hbenuid/robotic-arm/cad/docs/cycloidal_drive.md

# Cycloidal drive — 21:1 shoulder-pitch actuator, its shell turning

**Purpose:** the specification of the drive (ported from the `cycloidal_drive` repo), the turning shell it builds now
(§5.5), and how it is attached to the arm (§10).

## Provenance
- Designed in CadQuery in [`hbenuid/cycloidal_drive`](https://github.com/hbenuid/cycloidal_drive) and ported to
  build123d at `2f1f67d` (`lib/reference.py CYCLOIDAL_REV`; `git log` keeps the port's commits).
- **Reference geometry** = the CadQuery builders' own STEP exports at that revision, in `reference/cycloidal/<name>.step`
  (manifest kind `designed` for the printed parts, `cots` for the purchased ones - `lib/reference.py DESIGNED` /
  `CYCLOIDAL_COTS` -, `origin: cycloidal_drive@2f1f67d`; regenerating them: `reference/AGENTS.md`).
  `tests/cycloidal/test_port.py` proves the port reproduces them in `LEGACY_CONFIG`: identical face sets; identical
  tessellations and the exact analytic volume for every part but the two spline discs, which match the reference's
  lobe spline instead (`spline_deviation`). A part `DEFAULT_CONFIG` has moved away from its export (the bolt count,
  §5.2; the gear size and the pillar tips, §5.4; the turning shell, §5.5) declares `REFERENCE_BUILD`, its
  `LEGACY_CONFIG` build, and the test compares that.

## Overview

| Parameter | Value |
|---|---|
| Application | The arm's `shoulder_pitch` joint (~355 mm reach to the wrist centre, stretched out: `robot/frames.py` joint origins) — the `j1_coupler` fork holds its hub and motor, `j1_link` rises off its turning shell, printed with the shell's body (§10) |
| Type | Two-disc cycloidal drive, discs 180° apart; the carrier held, the housing shell the output (§5.5) |
| Gear ratio | 21:1 (21 ring pins, 20 lobes; the shell turns the same way as the motor) — `lib/params.py CYCLOIDAL_RATIO` (`DriveConfig.ratio`; the port's 20:1 held the ring) |
| Motor | NEMA 17, 48 mm body, 22 mm × Ø5 D-shaft (`parts/cycloidal/nema17_48mm.py`; the shown geometry is `vendor/nema17_48mm.step`, the real body from the user's kit export, its own boss + shaft cut off for this motor's pilot + shaft, `lib/cycloidal/motor.py`) + its MKS SERVO42D board kit on the rear face (`parts/joints/mks_servo42d.py`, `z_mks_board` = −48) |
| Eccentricity | 1.5 mm |
| Housing OD | 129.2 mm at the pillars, 108 between them (`CYCLOIDAL_HOUSING_OD`; the port's 140 / 116, §5.4) |
| Print material | PETG, 100 % infill on the discs |

The drive's own dimensions live in **`lib/cycloidal/params.py`** (`DriveConfig`, its frozen groups:
`gear, disc, shaft, bearings, housing, motor, output_hub, tolerances, profile, stack_up`, and `shell` - the turning
shell's `ShellParams`, `None` in the port's `LEGACY_CONFIG`); every number below names its field.

## 1. Drive geometry

### 1.1 Ring gear (`cfg.gear`)

| Parameter | Value | Notes |
|---|---|---|
| Ring pins | 21 (`num_ring_pins`) | N + 1, N = 20 lobes |
| Ring pin Ø | 4.00 (`ring_pin_dia`) | h6 ground steel dowel |
| Ring pin circle Ø | 100.00 (`ring_pin_circle_dia`) | centred in the housing bore; the port's 108 less 2 × `RING_INSET` (§5.4) |
| Ring pin length | 40 (`ring_pin_length`) | 5 in the shell ring's pin ring + 30 between the two plates + 5 in the body's pin ring (`ring_pin_engagement`; the port's 35: 3.5 in its motor plate + 28 + 3.5 in the bearing-zone wall) |
| Housing bore Ø | 108.00 (`housing.bore_dia`) | 2 behind the pins, 3 past the discs' swing; between the pillars it is the housing's outline (1.9 outside the pin holes) |

### 1.2 Cycloidal disc (`cfg.disc`, `parts/cycloidal/cycloidal_disc_1.py`, `_2.py`)

| Parameter | Value | Notes |
|---|---|---|
| Lobes | 20 (`gear.num_lobes`) | sets the ratio |
| Disc count | 2 | orbit centres 180° apart cancel vibration. Disc 2's epitrochoid is phase-rotated by `gear.disc2_phase_deg = -180°/N_lobes = -9°`; the output-pin holes are identical (disc-local 0/90/180/270 on the 60 mm circle). **The discs are distinct printed parts** — a 180° assembly rotation is a no-op on a 20-lobe disc. |
| OD | ~99 (98.0 / 99.0 bbox) | epitrochoid profile (§8): tips R − r + e = 49.5, valleys R − r − e = 46.5 |
| Centre bore Ø | 35.10 (`center_bore_dia`) | 35 mm 6003 OD + 0.10 clearance |
| Thickness | 10.00 (`thickness`) | = 6003 width |
| Lobe chamfer | 1.00 × 45° both faces (`lobe_chamfer`) | assembly lead-in, hides elephant foot; symmetric (no wrong side); costs ~20 % lobe contact length |
| Inter-disc spacer | 2.00 (`inter_disc_spacer`) | |
| Output pin holes | 4 × Ø7.4 on Ø60 | §1.3 |

### 1.3 Output stage (`cfg.disc`, `cfg.output_hub`)

| Parameter | Value | Notes |
|---|---|---|
| Output pins | 4 at 90° (`output_pin_count`) | 4 × 45 mm h6 dowels (`output_pin_dia`, `output_pin_length`) on Ø60 (`output_pin_circle_dia`) |
| Disc pin hole Ø | 7.40 (`output_pin_hole_dia`) | 4 + 2 × 1.5 ecc + 0.4 clearance |
| Hub pin holes | Ø4.20 × 18 blind (`output_pin_dia` − `ring_pin_press_sub`, from the flange's inner face to `z_bearing_top` − `output_hub_pin_ceiling`; the port's 19) | greased sliding fit through the discs; captured between the closed hub ceiling and the motor plate - both held: the pins stop the discs turning, so the ring - the shell - turns (§5.5) |

Clearances: pin-hole inner edge 26.30 vs bore radius 17.55 → **8.75 mm wall**; pin-hole outer edge
33.70 vs lobe valley 46.5 (~45.5 past the lobe chamfer) → **~12 mm wall**.

**Backlash:** the ring-pin mesh is a zero-clearance theoretical epitrochoid, so the output-pin holes are
the dominant designed source: slack = hole_r − pin_r − e = 3.70 − 2.00 − 1.50 = **0.20 mm radial**, i.e.
**≈ ±0.38° at the 30 mm pin circle** (was ±0.95° at Ø8.0, ±0.57° at Ø7.6). **7.4 mm is the practical
floor:** below ~7.2 the four rigid pins over-constrain against printed-hole position error across two
prints and the disc binds after shrink. Going lower means attacking the secondary sources (4.20 hub
fit, 6003 radial clearance, the 35.10 bore) or bushings/rollers on the pins — a redesign. Guarded by
`test_output_hole_backlash_budget` (`tests/cycloidal/test_disc.py`).

### 1.4 Eccentric shaft (`cfg.shaft`, `parts/cycloidal/cycloidal_eccentric_shaft.py`)

| Parameter | Value | Notes |
|---|---|---|
| Bearing-seat OD | 17.10 (`bearing_seat_od`) | light press in the 6003 bore |
| Eccentricity | 1.50 | lobe 1 at (+e, 0), lobe 2 at (−e, 0) |
| Spine OD | 5.00 (`spine_od`) | |
| Input collar OD | 10.00 (`input_collar_od`) | wall around the D-bore |
| D-bore Ø | 5.13 (`d_bore_dia` + 2 × `tolerances.d_bore_clearance_add`) | receives the motor shaft directly, flat on +Y (`d_bore_flat` 4.5, cut like the shaft's: flat-to-round 4.75, `lib/cycloidal/motor.py`) |
| D-bore depth | 14.00 (`d_bore_depth`) | 13 mm engagement (22 shaft − 9 plate) + 1 mm clearance |
| Support-pin hole | Ø5.15 × 11 blind (`support_pin_dia` + 2 × `dowel_bore_clearance_add`, `support_pin_hole_depth`) | keeps a 1 mm wall to the D-bore |
| Support pin | 5 × 20 h6 dowel | 11 in the shaft + 4 gap (to the hub's flange) + 5 in the 625 (its pocket in the flange's inner face; the port's 2 gap + 5 + 2 proud) |
| Bridge / retention flange | Ø23.10 (`bridge_flange_od` = seat OD + `bridge_flange_add` 6) | ruled loft (+e → −e) across the spacer zone; keeps the 6003s apart |
| Material | PETG, 100 % infill, `LAYER_H` (`parts/AGENTS.md` Printed vs. bought) | built at its stack position z 9..35 |

## 2. Bearings (`cfg.bearings`)

| Bearing | Qty | d × D × B | Part | Role |
|---|---|---|---|---|
| 6003-2RS | 2 | 17 × 35 × 10 | `parts/cycloidal/bearing_6003.py` | one per disc, on the shaft lobes (~6.4 kN dyn.) |
| 6814-2RS | 2 | 70 × 90 × 10 | `parts/cycloidal/bearing_6814.py` | the turning shell's bearings, 58 apart, one at each end: on the hub past its flange, in the body's seat (z 48), and on the motor plate's sleeve behind the plate, in the shell ring's seat (z −10); outer races turn (~12.4 kN dyn.) |
| 625-2RS | 1 | 5 × 16 × 5 | `parts/cycloidal/bearing_625.py` | in the hub's inner-face pocket, on the shaft support dowel (~1.0 kN dyn.) |

The port stacked both 6814s in the seat (z 37..57, centres 10 apart); the turning shell puts one either side of the
discs (z −10..0 and 48..58), mirror images about the discs' middle (z 24) - §5.5. The hub pin holes (r 27.9..32.1)
sit well inside the 70 mm inner-race bore.

## 3. Non-bearing purchased parts

| Part | Spec | Qty | Module |
|---|---|---|---|
| Motor | NEMA 17, 42.3² × 48 body, Ø5 shaft 22 long (4 round + 18 D-cut, `shaft_dcut_flat` 4.5 = flat-to-round 4.75, not the standard 4.5; assumed - the datasheet's is 24: `docs/open_issues.md`), Ø22 × 2 pilot, 4 × M3 on 31 mm square tapped 4.5, ~0.45 Nm | 1 | `nema17_48mm` |
| Ring pins | 4 × 40 h6 hardened dowel (buy 25) | 21 | `cycloidal_ring_pins` |
| Output pins | 4 × 45 h6 hardened dowel; light press in the hub's 4.20 blind holes (printed ~4.00–4.10), hub ceiling / motor plate as backup capture, free through the discs' 7.4 holes | 4 | `cycloidal_output_pins` |
| Shaft support pin | 5 × 20 h6 dowel | 1 | `cycloidal_shaft_support_pin` |
| Housing bolts | M4 × 65 SHCS (ISO 4762, `bolt_length`), Ø7 × 4 head; counterbored in the shell ring's end, through the shell end to end into nuts sunk in its body (the port's M4 × 55 ended in the ring gear body) | 6 | `cycloidal_housing_bolts` |
| Housing nuts | M4 hex, 7.0 AF × 3.2 (pocket 7.2 AF), in the body's pockets from its hub end (`lib/cycloidal/housing.py build_shell_body`) | 6 | `cycloidal_housing_nuts` |
| Motor bolts | M3 × 10 SHCS, Ø5.3 × 3 head (13 total): 6 through the plate + 4 engagement, head flush in the 3 mm inner-face pocket (`motor_bolt_counterbore_depth`) - the model places them `motor_bolt_recess` deeper (`stack_positions` `z_motor_bolts`, the drive repo's stack-up: heads 1 into the pocket's floor, tips 0.5 past the motor's 4.5 tapped holes; `docs/open_issues.md`) | 4 | `cycloidal_motor_bolts` |
| Hub bolts + nuts | 4 × M4 × 25 (`lib/yaw_coupler/params.py ForkParams.hub_screw_len`) from the `j1_coupler` fork's hub-side leg into captive M4 nuts in the hub's flange (its arm-mount pattern, `ShellParams.hub_nut_depth`: the screws' ends flush with the nuts) — install the nuts before pressing the hub through its 6814 | 4 + 4 | the arm's `fork_hub_screws` + `fork_hub_nuts`, mounted on the fork (`lib/mounts.py FORK_MOUNTS`) |
| Sleeve bolts + nuts | 3 × M4 × 20 (`ForkParams.sleeve_screw_len`) radially through the fork's motor leg (`j1_motor_leg`), heads on its ring's od, into M4 nuts pressed into lugs on the motor plate's sleeve (`ShellParams.sleeve_bolt_deg`: the motor's flats, up and both sides; `sleeve_nut_r`: the screws' ends flush with the nuts) — they hold the carrier's motor end from turning; press the nuts in before the motor goes into the sleeve | 3 + 3 | the arm's `fork_sleeve_screws` + `fork_sleeve_nuts`, mounted on the motor leg (`lib/mounts.py FORK_MOUNTS`) |

The purchased parts are modelled as the drive repo's simplified solids (annuli, cylinders, hex
prisms): each module's `_envelope()`, which is also its reference STEP; where a vendor file exists the model shows it instead, the reference staying the envelope:
`vendor/bearing_625.step`, a step.parts catalog model (`bearing_625_2rs_sealed_simple`), and
`vendor/nema17_48mm.step`, the kit export's body (Overview); see `vendor/README.md` for each, and for why the 6003
and 6814 catalog models were not adopted.

What to order: `./cadtool python tools/bom.py --module cycloidal_drive` (the bolts and nuts that hold the drive in the
`j1_coupler` fork are on the arm's list; the shell's body is printed as `j1_link`).

## 4. Axial stack-up (`cfg.stack_up`; z = 0 at the motor-plate outer face, +Z inward)

| Layer | Thickness | Running total |
|---|---|---|
| Motor plate outer wall (`motor_plate_wall`) | 5 | 5 |
| Motor plate inner wall (`motor_plate_inner_wall`) | 4 | 9 = `z_motor_plate_inner` |
| Input clearance / D-shaft collar (`input_clearance`) | 4 | 13 = `z_disc1` |
| Disc 1 + 6003 (`disc_thickness`) | 10 | 23 |
| Inter-disc spacer (`inter_disc_spacer`) | 2 | 25 = `z_disc2` |
| Disc 2 + 6003 | 10 | 35 |
| Clearance to the hub's flange + the flange (`output_clearance`: the input clearance + `hub_flange`, the motor plate's mirror; the port's 2) | 13 | 48 = `z_output_bearings` |
| The hub-end 6814 (`output_bearing_total`: one; the port's two, 20) | 10 | 58 = `z_bearing_top` |
| The lip (`output_wall` = `ShellParams.end_lip`, the port's 3) | 3 | 61 = `total_housing_depth` |

Behind z = 0, the mirror: the motor-end 6814 (−10..0) and the shell ring's lip (−13..−10) - the shell runs
**z −13..61** (`shell_ends`), symmetric about the middle of the discs (z 24); the two plates' inner faces bound the gear
at 9 and 39 (`arm_zone`, where the shell's body starts on the shell ring). Derived: `disc_zone` 26, `bore_zone` 39
(9..48, to the hub-end seat), `ring_gear_body_height` 52 (the body, 9..61).
**The ends:** the held hub is 23 tall (flange 9 + grip 10 + lip 3 + `proud_above_housing` 1 = `ShellParams.end_plate_gap`)
at z 39, its face at **z = 62** (`CYCLOIDAL_HUB_FACE_Z`) on the `j1_coupler` fork's hub-side leg; the motor plate's
sleeve ends at **z = −22** (`sleeve_end`, `CYCLOIDAL_SLEEVE_END_Z`) on the motor-side leg's outer face. **The housing
bolts run end to end:** M4 × 65 from the shell ring's 4.5 counterbores (heads' tops at −12.5) to their ends at 56.5,
flush with their nuts (stack `z_housing_nuts` 53.3, `test_full_nut_engagement`) in the body's pockets
(`test_bolt_ends_inside_the_body`).
**Total envelope with the motor:** the shell 74 (−13..61), the motor 48 behind the plate's face (the pilot recesses 2
mm into the plate), the MKS board kit behind the motor 14.1 (module z −62.1 … 62).

The module layout (`lib/cycloidal/layout.py stack_positions`, the drive repo's `assembly.py`
numbers for the gear stack) places: discs at (±1.5, 0, 13 / 25) with their 6003s, the 6814s at 48 (the hub's) and −10
(the motor plate's), hub and 625 at 39, ring pins at 4, output pins at 12, support pin at 24, motor bolts at −5,
housing bolts at −12.5, nuts at 53.3; shaft, motor, motor plate and shell ring at 0 (built in place).

## 5. Housing design notes (`cfg.housing`)

### 5.1 Envelope — OD 129.2, the shell z −13..61, bore Ø108, a 6814 seat Ø90.15 × 10 at each end, bolt circle Ø117 (`bolt_count` × M4).

### 5.2 Housing split — two printed parts, mirror images about the middle of the discs

1. **Shell ring** (`parts/cycloidal/cycloidal_shell_ring.py`, z −13..9): the shell's motor end - from its end in, the
   Ø86.15 lip (`end_lip`, `lip_radial` 2 over the 90 mm outer race), the motor-end 6814's Ø90.15 seat, and a pin ring
   (`ring_bore_dia`) round the held motor plate with the 21 ring pins' blind holes Ø4.20 from its face on the body; the
   M4 holes with Ø7.4 × 4.5 counterbores in the end face (z −13). The motor plate itself
   (`parts/cycloidal/cycloidal_motor_plate.py`) is held: §5.5.
2. **The body** (`lib/cycloidal/housing.py build_shell_body`, z 9..61), **printed as one with `j1_link`** (the upper
   arm rises off it, §10): the Ø108 bore round the discs (9..39), a pin ring round the hub's flange (39..48) with the
   ring pins' blind holes from its face on the bore, the hub-end 6814's seat (48..58), the lip (58..61); the M4
   through-holes, each backed by a full-height bolt pillar, and the housing nuts' **captive hex pockets** (7.2 AF)
   from the hub end down to the nuts' seats, turned `bolt_nut_turn_deg` (a flat outward, §5.4).

**Shared outer profile** — both parts carry the same pillar / window silhouette around the bolt
circle (pillars `pillar_inner_w` 18 at the bore, `pillar_outer_w` 10 at the OD, one per bolt -
`lib/cycloidal/layout.py pillar_corners`) from end to end; the shell ring seats on the body's pillar faces, no
continuous rim. One shared cutter (`lib/cycloidal/housing.py reveal_window_cutter`) is subtracted from every housing
base solid. The turning shell's body keeps `ShellParams.arm_windows` (2) of its windows solid - the two either side of
its first pillar, where the upper arm rises off it (`arm_root`, §10); the other four open on the discs and the ring
pins; the shell ring's six are recesses in its wall, its pin ring closed inside them.

**Bolt count** (`bolt_count`) — a departure from the port (the others: the gear size and the pillar tips, §5.4, and
the turning shell, §5.5): `DEFAULT_CONFIG` builds 6 bolts where the port (`LEGACY_CONFIG`) had 8, at 60°, the first
at `bolt_start_deg` = `ARM_DEG` (47.584167°, the port's 0°): on the centreline of the upper arm, which rises off the
turning shell between the two windows either side of it (§10; `tests/upper_arm/test_j1_link.py` checks the angle
against `j1_link`'s frame). The bolt circle sits 8.5 mm outside the
ring pins', so any start clears them. The port's motor plate and the housing bolts / nuts declare
`REFERENCE_BUILD` (their `LEGACY_CONFIG` build), which `tests/cycloidal/test_port.py` (the plate) and
`test_cots_envelope_tracks_reference_bbox` (the bolts / nuts) compare with the CadQuery exports.

**Outer-edge chamfer** (`edge_chamfer` 1.0; the port's 1.5, `chamfer_outer_silhouette`): the pillars' outer vertical
corners always, plus the *entire* outer-wire perimeter of each part's external end face (the shell's two ends: the
shell ring's z = −13, the body's z = 61); the faces where they meet (z = 9) stay sharp so the stack beds flush. Internal holes are never beveled. `edge_chamfer = 0` disables; keep it
under `LUG_WALL` - 1 to leave the external faces 1 mm or more past the nut pockets (§5.4).

### 5.3 Output hub (`parts/cycloidal/cycloidal_output_hub.py`, `cfg.output_hub`)

PETG (aluminium viable): Ø70.3 (`od` = 70 mm 6814 bore + 0.3 interference grip), 23 tall (the port's 28): a Ø90 × 9
flange (`hub_flange`, the motor plate's mirror) in the body's pin ring, its face on the hub-end 6814 cut back over
the outer race (`plate_relief_*`) - the flange stops the inner race -, then the grip, on past the lip to the
`j1_coupler` fork's hub-side leg; 4 blind Ø4.20 × 18 pin holes on Ø60 closed by a 1 mm ceiling; Ø6 shaft-clearance
bore through the flange; Ø16.2 × 5 625 pocket on the inner face; the **arm-mount pattern** 4 × Ø4.4 through-holes on
Ø50 at 45° from the pins, each into a captive M4 nut pocket (7.2 AF × 4.7, `hub_nut_depth`) in the flange's inner
face - the port bolted `j1_link` to it, the turning shell bolts the hub to the fork's leg (M4 × 25 from its
counterbores, their ends flush with the nuts); a Ø36 lightening recess in the face (`arm_mount_pocket_dia`, 0 =
sealed). The grip passes the lip bore with ~7.9 mm radial clearance. It is held: the carrier, with the output pins
(§5.5). Print output-face-down.

### 5.4 Gear size and pillar tips (`RING_INSET`, `LUG_WALL`)

`DEFAULT_CONFIG` moves the ring-pin circle and everything outside it — the bore, the bolt circle — `RING_INSET` in from
the port's (`lib/cycloidal/params.py`; the od follows the pillar tips, below), so the drive is 2 × `RING_INSET` smaller
across between its pillars and every wall outside the pins keeps the port's thickness: between the pillars the
housing's outline is its bore, 1.9 outside the pin holes, so the bore cannot come in further than the pins (a Ø106
bore left 0.9 there, and the 1.5 edge chamfer broke into the holes). The discs follow the pins (their epitrochoid is
the pin circle's, §8: K1 = e·N / R goes 0.58 → 0.63, no undercut); the 6814s, the hub, the shaft, the output pins,
the stack-up and every fastener do not change. **The limit** is the pin rings' wall: the pins stand
`ring_pin_engagement` into it, their holes 1.9 outside `ring_bore_dia` (`test_pin_holes_in_the_pin_rings`), as
between the pillars; the 6814 seats lie past their ends — test-print a pin ring (§6). The discs, the ring pins and the port's motor
plate declare `REFERENCE_BUILD` for it (Provenance).

**Pillar tips** (`LUG_WALL`): each housing nut and its pocket are turned a flat outward (`bolt_nut_turn_deg` 30), and
`LUG_WALL` of plastic stands past the pocket, so the od is the bolt circle + the pocket's AF + 2 × `LUG_WALL` (the port
kept 3.3 past a corner); the edge chamfer is 1.0, so the external faces keep 1.5 past the nut pockets and 1.4 past
the counterbores. The pillars keep the port's widths (`pillar_inner_w` / `pillar_outer_w`: they bridge the windows); beside the turned
nut 3.1 of wall is left. The bolt circle stays at the pins' distance.

### 5.5 The turning shell (`cfg.shell`, `ShellParams`)

`DEFAULT_CONFIG` turns the drive inside out: the **carrier** - the output hub and its pins, which stop the discs
turning - and the **motor** are held, the `j1_coupler` fork gripping the hub at one end and the motor plate's sleeve
at the other (`lib/yaw_coupler/params.py ForkParams`, §10); the **housing shell** - the shell ring, the body round the
discs and the ring pins - is the output, so the ratio is the ring pins' 21 (`DriveConfig.ratio`), the shell turning
the same way as the motor. **Why:** the port carried the whole arm on two 6814s stacked in one seat, centres 10 apart,
so their play and the PETG's give tipped the arm; the turning shell runs on one 6814 at each end of the gear stack,
centres **58** apart (`test_the_6814s_are_58_apart`). **The upper arm rises off the shell** (PAROL6-like):
`j1_link` is printed as one with the shell's body, its arm's underside flush with the shell's hub end (§10) - one flat
face, the one the part prints on; nothing bolts the arm to the shell's end.

- **The two ends mirror each other** about the middle of the discs (`tests/cycloidal/test_shell_body.py`): from the
  outside in, an `end_lip`, the 6814 (its outer race in the shell's seat), a `plate_dia` plate inside the shell's
  `ring_bore_dia` pin ring - the motor plate at the motor end, the hub's flange at the other, each the port's motor
  plate thick, its face cut back `plate_relief_depth` from `plate_relief_dia` over the turning outer race - and the
  stack's 4 mm clearance to its disc. The ring pins stand in both pin rings (`ring_pin_engagement` 5 into each).
- **The motor plate is the carrier's motor end** (`parts/cycloidal/cycloidal_motor_plate.py`, its `LEGACY_CONFIG`
  build the port's plate): the plate - the motor's pilot, M3s and shaft bore as before - and a sleeve back over the
  motor: `sleeve_bore_dia` round the motor's and the MKS board's corners (61 across them), `sleeve_od`, and the hub's
  70.3 grip over the last `out_width`, where the motor-end 6814 presses on after sliding over the rest; it runs
  through the fork's motor-side leg to its outer face (`sleeve_end`), bolted to it - nothing else holds the carrier's
  motor end from turning (the output pins stop short of the plate, the plate turns in its 6814): three radial M4s
  through the leg's ring in its middle (`sleeve_bolt_z`) into nuts pressed into lugs on the sleeve's bore at the
  motor's flats (`sleeve_bolt_deg`: up and both sides, none down where the leg's post stands; the lugs' inner ends 45°
  so the plate prints without support). The leg's holes are slotted along the axis (`ForkParams.sleeve_slot_len`):
  the drive settles lengthwise - the hub's leg holds it - before the screws lock it, so the fork never forces the
  6814s along the axis.
- **The shell ring** (`parts/cycloidal/cycloidal_shell_ring.py`) and **the body** (`build_shell_body`, j1_link's): §5.2.
- **Held both ways along the axis:** at each end the shell's lip stops that 6814's outer race, the held plate's face
  its inner race (`test_the_shell_is_held_both_ways_along_the_axis`).
- **The fork's clearances:** the shell's pillars sweep r 64.6, 2.68 over the yoke's ring (lowered `RING_DROP` for
  them; `tests/yaw_coupler/test_j1_coupler.py`); the shoulder's whole range keeps the upper arm - `j1_link`, the
  elbow motor, the shell - its 1 mm running gap off the fork's two legs (`tests/test_sweeps.py`).
- **Assembly, from the motor end:** the hub's nuts into its flange; the hub-end 6814 into the body's seat from inside
  (`j1_link` face down), the hub pressed into it grip first to its flange; the gear stack (output pins in the hub,
  discs, shaft, the ring pins into the body's pin ring) as before; the motor plate with its 6814 on its seat, the
  shell ring over the sleeve and onto the ring pins' ends, bolted to the body with the M4 × 65s into its nuts; the
  sleeve's three nuts pressed into its lugs, then the motor into the sleeve; the whole lowered into the fork, the hub
  bolted to its leg, the motor leg (`j1_motor_leg`) slid on over the motor and its board and bolted to the yoke's disc,
  then - the motor turned until the sleeve's holes show through the ring's - to the sleeve with the three M4 × 20s,
  snug, sides before top (they pull the sleeve across the ring's 0.2 a side).

## 6. PETG print tolerances (`cfg.tolerances`)

PETG holes print 0.10–0.20 undersized (shrink, elephant foot, arc overshoot); the positive offsets
are print compensation, so **everything ends up a press fit on a real print** — the offset sets how
tight. Never design a hole smaller than its steel part.

| Fit | Adjustment | Field | Application |
|---|---|---|---|
| Bearing outer race → housing | +0.15 / +0.20 on the bore | `output_bearing_seat_dia` 90.15, `bearing_seat_bore_add` 0.2 | 6814 seats - the body's, the shell ring's - (firm press), 625 pocket 16.2 (slip-to-light press) |
| 6814 inner race → hub / sleeve | +0.3 interference | `output_hub.od` 70.3; `ShellParams.sleeve_od` 70 | the hub's grip and the sleeve's last `out_width` (press); the sleeve behind it slides |
| Ring & output pin holes | +0.20 → Ø4.20 | `ring_pin_press_sub` −0.20 | slip-press as printed, blind (the shell ring, the body, the hub) |
| Disc centre bore | +0.10 → 35.10 | `center_bore_dia` | 6003 OD |
| Disc output-pin holes | nominal 7.4, no offset | `output_pin_hole_dia` | shrink *reduces* backlash (§1.3) |
| Motor-shaft D-bore | +0.065 on the radius → Ø5.13 | `d_bore_clearance_add` | slip-to-light press |
| Support-pin bore | +0.075 on the radius → Ø5.15 | `dowel_bore_clearance_add` | firm press |
| Mating surfaces | +0.15 | `mating_surface_add` | pilot recess 22.30 |
| Bolt / head clearance | +0.4 on the Ø | `bolt_clearance_add` | M3 3.4 / 5.7, M4 4.4 |

Print the discs flat at 100 % infill and `LAYER_H_FINE`, the drive's other printed parts at `LAYER_H` (`parts/AGENTS.md`
Printed vs. bought); test-print the fit gauges
first (`tools/export_gauges.py`: every fit in this table at steps round its value); PETG shrinks 0.3–0.5 % over 129 mm
(the housing may need ~129.5 — not compensated).

## 7. Performance estimates

Motor 0.45 Nm × 21 = 9.45 Nm theoretical; 55–65 % efficiency (printed, no pin bearings) →
**5.2–6.1 Nm practical**, ~1.3–1.5 kg at 400 mm including the arm; 200–500 rpm in → 9.5–24 rpm out, the shell
turning with the motor; not backdrivable; backlash ≈ ±0.38° (§1.3). The Ø100 ring-pin circle (§5.4) puts ~8 % more force on each ring pin
than the port's Ø108 for the same torque (54 / 50). **Torque budget warning:** short of this arm even at
its ~355 mm reach to the wrist centre (the arm stretched out horizontally weighs more on the shoulder than this) —
a lightweight demonstrator; a balance spring, NEMA 23 or a higher ratio for heavier payloads (`docs/open_issues.md`).

## 8. Disc profile (`lib/cycloidal/profiles.py`)

```
x(θ) =  R·cos θ − r·cos(θ + ψ) − e·cos(N·θ)
y(θ) = −R·sin θ + r·sin(θ + ψ) + e·sin(N·θ)
ψ    = atan2(sin((1 − N)·θ), R/(e·N) − cos((1 − N)·θ))
R = 50 (ring-pin circle radius, gear.ring_pin_circle_radius; the port's 54), r = 2 (pin radius),
N = 21 (pins), e = 1.5;  lobes = N − 1 = 20
```
2000 points per revolution (`profile.num_points`, `endpoint=False`) through a **periodic
interpolating** B-spline (`Edge.make_spline(..., periodic=True)` — `lib/AGENTS.md` "Kernel gotchas (all verified)",
which also gives the disc's build order and the OCCT volume caveat: the discs' URDF masses carry its ~0.3 % error).

## 9. Designed interference budget

`test_module_interference_budget` (mm³) holds the designed overlaps: the 6814 inner-race press fits on
the hub and on the motor plate's sleeve, 330.6 each; housing bolts through the solid nuts 241.3; motor-bolt heads
in the plate 51.9 (the modelled `motor_bolt_recess`, §3 - not a fit) and shanks in the vendor motor's tapped holes
(modelled at the M3 minor diameter) 46.4; 6003 / lobe press fits 26.8 × 2; the MKS kit's four M3x30 in the same
holes from the rear 159.4. Everything else is < 1 mm³; the whole module vs the arm - the base, `j1_link` (with the
shell's body), the `j1_coupler` fork and its motor leg (`j1_motor_leg`) - contact at most (≤ 1,
`TestPoseInTheArm`).

## 10. Attachment to the arm

- `placements.json` record **`cycloidal_drive#1`** (`kind: module, designed: true`) = the SolidWorks
  node `New_cyloidal_assembly` (sic) at path 1.3, its pose, parent = the arm root (`reference/README.md` "The
  SolidWorks assembly's nodes"). Its `solidworks` block keeps the node's leaves / solids / volume / world bbox as a
  cross-check; `assemblies/arm.py` locates `assemblies/cycloidal_drive.py` there (its `OCCURRENCES` row, `DRIVE_KEY`;
  moved by `lib/placements.py SHIFTS`, below).
- **Frame:** module Z = motor axis, z = 0 the motor-plate outer face, motor body in −Z, the shell z −13..61, the
  hub's face at 62, the sleeve's end at −22. In the arm the axis is horizontal (module +Z → world −N, N = the pitch
  axes' direction, `robot/frames.py N`; module +Y → world up). The `j1_coupler` **fork**
  (`lib/yaw_coupler/params.py ForkParams`, DEFAULT) holds the drive on its own axis - the SolidWorks pose, 0.21 off
  the SolidWorks yoke's cradle axis (`YokeParams.axis_y`) - with two legs (`ShellParams.yoke_leg`) 1 mm past the
  shell's ends, mirror images about the middle of the discs, which sits on the base_yaw axis (`ForkParams.face_x`;
  the capture had it 7.5 off, toward the motor - the drive and all it carries moved along N,
  `lib/placements.py SHIFTS`), the yoke's disc faceted like the base under it (`DiscParams.sides`), the two legs alike -
  a round top on a post as wide (`ForkParams.plate_r`), growing out of the disc in planar facets, the disc's flat facing
  each leg carried up its outer face: the hub-side
  leg takes the hub's face and its 4 bolts; the motor-side one - its own part,
  `j1_motor_leg`, a solid ring slid on over the motor and bolted to the yoke's disc - holds the motor plate's sleeve,
  bolted to it by three radial M4s (§5.5);
  the shell turns between them, over the yoke's lowered ring. The SolidWorks yoke (`LEGACY`,
  `lib/yaw_coupler/params.py`) cradled the port's housing on its pillars instead. **The upper arm rises off the
  shell:** `j1_link` (parametric, `lib/upper_arm/`, `ArmParams`: its slab, the elbow motor's seat in it and the elbow
  belt's path) is printed with the shell's body, its arm rising out of the body's two solid windows, the four others
  open on the discs; slid along N until its underside is flush with the shell's hub end (`arm_slide`: the part prints
  on that face, no support under the arm), and everything past the elbow with it (`lib/placements.py SHIFTS`): the end
  effector is off the base_yaw axis (`docs/open_issues.md`). The drive's frame in `j1_link`'s is the capture's
  (`tests/upper_arm/test_j1_link.py`); `TestPoseInTheArm` checks the shell's body in `j1_link` and the hub and the
  sleeve on the fork's legs.
- **Kinematics:** the drive **is the `shoulder_pitch` joint** of `robot/frames.py` (axis `N` = the
  drive's −Z; origin `SHOULDER_ORIGIN` = `j1_link#1`'s origin, on the drive axis; limits
  `SHOULDER_PITCH_LIMITS_DEG`). `assemblies/cycloidal_drive.py BODIES` splits the rows into two rigid
  bodies and `LINKS` places them with a `:<body>` key suffix (`_occurrences.split_key` / `world_rows`):
  the **stator** (`cycloidal_drive#1:stator` — every row but the rotor's: the motor plate, the output hub, its
  output pins and the 625, the NEMA 17 + bolts + its MKS board, and the gear train: eccentric shaft, support pin,
  discs, 6003s) rides in `shoulder_link` with the yawing `j1_coupler`; the **rotor** (`cycloidal_drive#1:rotor` —
  what turns with the shell: the shell ring, ring pins, housing bolts + nuts, both 6814s) rides in `upper_arm_link`
  with `j1_link`, which holds the shell's body.
  `EXPECTED["bodies"]` locks the per-body totals and `TestPoseInTheArm` checks the joint origin sits on the drive
  axis. The arm STEP's viewer tree keeps the module whole under `shoulder_link` (one tinted copy -
  `assemblies/AGENTS.md`); the per-link meshes split it. Which MKS motor (`software/control/src/config.py` J1..J3)
  drives which joint is unconfirmed (`docs/open_issues.md`); `config.py` still carries `gear_ratio` 1.0 where this
  joint needs `1 / CYCLOIDAL_RATIO`, the output turning with the motor (the direction: `robot/AGENTS.md`).

## Viewing the drive

```bash
cd cad
./cadtool gen assemblies/cycloidal_drive.py          # assemblies/cycloidal_drive.step (git-ignored) if missing
./cadtool viewer assemblies/cycloidal_drive.step     # its page on the machine's cad server
#   also assemblies/arm.step (the drive in the arm), parts/cycloidal/cycloidal_shell_ring.step (any part),
#   robot/arm.urdf (the robot with joint sliders - shoulder_pitch turns the drive's rotor with j1_link)
./cadtool snapshot assemblies/cycloidal_drive.step snapshots/cycloidal_drive.png --size-profile assembly
./cadtool snapshot assemblies/cycloidal_drive.step snapshots/cycloidal_drive_x.png --display xray --camera "30:20"
#   (no turntable: snapshots draw stills, and the drive declares no motion - motion review is the CAD Viewer)
```
