hbenuid/robotic-arm/cad/docs/forearm_roll.md

# The forearm roll drive — the joint added to the SolidWorks arm (`forearm_roll`, 4th in the chain)

**Purpose:** spec and attachment of the belt-driven forearm roll (`forearm_roll`, between `elbow_pitch` and
`wrist_pitch`), the way `cycloidal_drive.md` documents the shoulder. Code: `lib/forearm/` (`params.py
RollEndParams` + `RollDriveParams` + `ForearmConfig.elbow_offset`, `layout.py stack_positions`, `roll.py`),
`assemblies/forearm_roll_drive.py`, `parts/joints/forearm_roll_*.py`; tests `tests/forearm/`.
Numbers below name the constants; the values live in `lib/forearm/params.py`.

## 0. Specifications at a glance
| item | value | where |
|---|---|---|
| joint | `forearm_roll`, revolute, `elbow_link → forearm_link`; axis along the forearm across the `wrist_pitch` axis, `WEB_DROP` from the wrist centre (§1), `ELBOW_ROLL_OFFSET` (the drive's centre distance) across the elbow axis - **an elbow offset: the two axes do not cross** -, `FOREARM_ROLL_AXIS_Z` along N from `j2_link`'s origin | `robot/frames.py`, `lib/placements.py SHIFTS` |
| range | ±`FOREARM_ROLL_LIMIT_DEG`, 2° short of the printed hard stop (a lug on the shaft's flange, a post on the frame's tower, in the bay behind bearing 1 - straight-sided, `stop_deg_width` wide at their outer radius, so they meet before 180° − `stop_deg_width`, where `stop_deg_width`'s note says; `tests/test_sweeps.py` holds the stop between that and the limit); home sensor modelled (`ky003_hall_sensor`), not placed | `lib/params.py`, `RollDriveParams stop_*` |
| drive | NEMA 17 × 40 mm + MKS SERVO42D (a CAN id of its own) **on the elbow axis**, GT2 20T on the motor, the 90T ring **integral to the pulley - the output**, **4.5 : 1**, a stock 2GT × 6 mm belt (`forearm_roll_belt`, `FOREARM_ROLL_BELT_LENGTH`) at the drive's design `centre_distance` (= the offset), its **tensioner** taking up the rest | `RollDriveParams`, `lib/belts.py` |
| torque | ≈ 1.1–1.8 N·m at the roll vs ≈ 0.7 N·m worst-case static load | §2 |
| bearings | 2× 6806-2RS (30 × 42 × 7, the belt joints' bearing), back to back in the frame's tower, **a 12 mm spacer (`lip`) between their outer rings - 19 mm apart centre to centre** (the elbow pattern's 2 mm lip had them 9 apart: each bearing now takes the forearm's bending moment over twice the span), bearing 2 right under the ring (seats Ø42.15, journals Ø30.3) | `RollDriveParams bearing_*`, `lib/bearings.py` |
| pulley (rotor, PETG - the output) | the integral flanged 90T ring on a Ø44 core, its rear flange turning `run_gap` over the frame's bearing boss; its hub through bearing 2 and on as a neck (`neck_dia`, under the bearing's bore: bearing 2 slides over it onto its journal) through the spacer to bearing 1's front face, where the shaft meets it; the Ø33 shoulder on bearing 2's inner ring; the Ø39.7 spigot in the forearm wall's recess - the wall bolts onto the ring's face (4× M3 on Ø31 into nuts in the core); the rotor clamp's 4× M3 heads sunk in its front face | `forearm_roll_pulley` |
| shaft (rotor, PETG) | a collar that holds bearing 1: its Ø30.3 journal through bearing 1 to the bearing's front face (the pulley's neck meets it there), the Ø33 shoulder, the Ø40 flange with the rotor clamp's 4 nuts (pockets open to its rear face) and the stop lug; the Ø18 cable bore through both rotor pieces | `forearm_roll_shaft` |
| tensioner | a GT2 20T toothless idler (`gt2_idler_20t`) on the belt's back, on the run back from the ring `along` from the motor, pushed in till the stock belt fits; on a **riser** on the frame's front face (its land on the idler's bearing inner ring) on an M5 (`roll_idler_screw`) down through the idler and the riser's slot into an M5 nut (`roll_idler_nut`) in a channel under the face, closed at both ends - the nut in from the motor's pocket before the motor (`entry`: a recess in the plate's inner face, which the motor's face then shuts) -: ± `travel` along N tensions the belt, the nut sliding with the screw; nearer than ~73 (`centre_distance`'s note) the idler would meet the ring's flange and the belt's far run | `RollIdlerParams`, `tests/forearm/test_roll_idler.py` |
| rotor clamp | 4× M3 × `clamp_screw_len` on Ø24.5 (`clamp_*`, turned 45° off the wall's screws) from the pulley's front face through both pieces into the shaft's nuts: the pulley, both inner rings and the shaft one block, the drive whole without the forearm; modelled on the rotor (`roll_clamp_screws`, the heads `clamp_head_clear` under the pulley's face, the tips at the shaft's rear face; `roll_clamp_nuts`, a corner radial in their pockets, which hold them from turning) | `RollDriveParams clamp_*`, `tests/forearm/test_roll_clamp.py` |
| frame (stator, PETG) | ONE printed part round the motor, the elbow's output flange bolted to it (next row): seen along the elbow axis an **octagon about it** (`end_sides`, a flat on each axis `end_r` 42 off it - 5 mm outside the motor pocket's top corners -, round `j1_link`'s narrower faceted end, `ArmParams.end_r`) hulled up to the **tower** round the roll axis (`tower_y`) - straight sides, sharp corners, both faces' outline chamfered (`docs/design_language.md`), the rear line where the round end's ran (`rear_line_r`) -; seen along the roll axis the tower is the **forearm flange's octagon** (`roll.py tower_section`: its top corners cut to the diagonal flats, so the flange's facets run straight back through the frame), and the front face's two long edges are **faceted** at 45° end to end (`front_facet`, as far as the plate over the motor's pocket allows), from the underside (`block_x[0]`, under it the **spigot** that keys the elbow flange - an octagon about the elbow axis, `spigot_af` across flats, `spigot_h` tall -, the elbow 90T's 4 nuts in hex channels in it, open up into the motor's pocket) to the side (+N) face (`block_x[1]`), **closed** (`side_t`, as thick as the floor); the motor's **pocket** between them, open down through the octagon's bottom - the motor slides up into it -, a **groove** inside each wall at the board's side plugs (`plug_slots`), its front wall the **plate** (`pad_t`: round holes - no slide, the idler tensions the belt -, the motor's 4× M3 from the front face, `roll_motor_screws`, their heads flush in counterbores; the pilot hole, the shaft's slit down to the bottom), the plate's face the frame's one **front face**, the tensioner's riser on it; the **bearing boss** on the front face round the roll axis (`bearing_boss_dia`, bearing 2's seat in it), carried down through the facets so it rises out of them, centred on the frame - the underside, the side face and the tower's top all `ROLL_FRAME_R` from the roll axis, the forearm wall's radius (`wall_od` / 2): the frame flush with the round parts that turn about the roll axis, its underside lifted off `j1_link`'s flat top, the elbow flange's post reaching down across the gap over `j1_link`'s bore -; the shaft's **bay** behind bearing 1, bored on through the frame's back (the rear line) - the rear face stepped there for the back panel, the bay's opening grown down below its bore, the magnets' pockets in the step | `forearm_roll_block` |
| elbow flange (stator, PETG) | the elbow's output flange, **its own part** so its round faces print as circles (printed on the stub's end; on the frame, printed front face down for its 6806 seats, they lay on their side): under the frame's underside about the elbow axis the **post** (`post_dia`, the SolidWorks `j3_coupler`'s journal carried up, its foot chamfered), the **shoulder** on the upper elbow 6806's inner ring, the **stub** through it and the lip to the elbow 90T, which bolts flat onto its end; the pin bore, blind from the stub's end; the 90T's 4× M4 clearance through it; the octagonal **recess** in its top over the frame's spigot (`spigot_fit` a side: it centres the flange and keys it against turning). The 90T's 4× M4 × `pulley_screw_len` run through the 90T, the flange and the spigot into the frame's nuts: the 90T, the flange and the frame one clamp | `elbow_flange` |
| back panel (stator, PETG) | **removable**, so the shaft, its clamp nuts and the stop are reached from behind: a plate in a step across the frame's rear face, the face's full width (less `side_clear`, its top corners cut to the tower's octagon), `t` deep, from the tower's top down to `bottom` - its outer face ON the rear line, so the elbow motor's stack (its gearbox nearest) passes it as it would the frame's face -, over the bay's bore and the opening grown down below it (`opening_bottom`, its corners `opening_r`, `opening_depth` deep); relieved `run_gap` off the shaft's rear face and its lug's sweep, where it passes over them; located by a U rim (`rim_*`) on its inner face in the opening's lower part; held by 4 magnet pairs (`roll_back_magnets`, small discs - `magnet_dia` - so the upper pair fits beside the bay's bore under the tower's octagon; `magnet_points`: one disc in a pocket in the step's floor, one in a pocket in its inner face, attracting); a **grill** through it (`roll.py back_grill`, `docs/design_language.md`): straight slots up the face (`grill_w` at `grill_pitch`, one on the roll axis' line) over the bay and the opening, clipped to a field `grill_clear` inside the rim - its bottom corners the 45° chords of the rim's rounded ones - and, over the bay, the tower's octagon carried in to the field's half width, so the slots' ends follow the panel's own top corners; the turning shaft shows through it; nothing passes through it (the forearm's cables take another route: `docs/open_issues.md`) | `forearm_roll_back_panel`, `BackPanelParams` |
| forearm interface | `j2_link`'s wall at 48…56 mm along the roll axis (`wall_x` −56…−48): a faceted flange on the roll axis through its whole thickness (flats `wall_od` across, over the ring's Ø59.19 flanges; its corners inside the roll tensioner's screw head's path as the forearm rolls), the web's underside level with its bottom flat (`WEB_DROP`); the web, wider than the flange (`WebParams.half_w`: as wide as its belt cover's end, `docs/design_language.md`), grows out of it through the flange's two lower diagonal facets carried on along it into its edge chamfer (`facet_len`, `lib/forearm/link.py corner_facets`); two gussets beside the wrist motor (`rib_*`), standing on those facets' top edge under the flange's side flats; Ø40 × 2 recess, Ø24 bore, 4× M3 × 16 on Ø31 from its wrist face (`screw`, `screw_len`; the bottom one's head just over the web); the forearm turned `FOREARM_ROLL_TURN_DEG` about the roll axis from the capture, the wall on the ring turned with it (§1) | `RollEndParams`, `ForearmConfig.roll_turn_deg` |
| clearances held by tests | the frame's underside FACE_GAP or more above `j1_link`'s flat top, level with the upper 6806's top (`FACE_GAP`: the least gap a face the elbow turns may keep), the elbow flange's post over its bore only - its chamfered foot the frame's nearest point to `j1_link`, off the bore's rim -; the rotor 1 mm off the frame (`run_gap`: the ring's flange over the bearing boss, the shaft in the bay), the stop lug 2 mm or more inside the rear line at any roll; folded elbow (to `ELBOW_PITCH_LIMITS_DEG`) and rolled forearm (±`FOREARM_ROLL_LIMIT_DEG`) < 1 mm³ against every neighbour; at the elbow's limits the forearm, rolled anywhere, ≥ 2 mm off `j1_link`; over the elbow's range the drive ≥ 1 mm off the elbow motor and its board on the upper arm's same side (how near at the lower limit: `docs/open_issues.md`); the stator behind the forearm wall's plane but the motor shaft's tip and the tensioner's screw head, which pass it and which the rolling forearm clears round the roll axis; journals 0.9–1.0 × the 99 mm³ press; the back panel flush with the rear line (nothing of it past it), `run_gap` off the shaft and its lug's sweep, on the step's floor, the magnets on their pockets' bottoms | `tests/forearm/test_roll_drive.py`, `tests/forearm/test_roll_back_panel.py` |
| link masses (URDF) | `elbow_link` carries the stator (the frame and its back panel + magnets, both bearings, the motor + board, the 20T, the belt, the tensioner), `forearm_link` the rotor (the pulley + the shaft, the clamp's screws + nuts) + the forearm and what it carries (§5); the masses are the `<inertial>` blocks (`tools/robot/derive.py`), their sum checked by `test_link_masses_add_up` | `robot/arm.urdf` |
| purchased per drive | what to order, with quantities: `./cadtool python tools/bom.py --module forearm_roll_drive` (its BUY list, and BUY, NOT MODELLED from `tools/bom.py EXTRAS`); the elbow 90T's M4 screws and nuts are the arm's (`elbow_pulley_screws`, `elbow_pulley_nuts`) | `tools/bom.py` |
| printed per drive | frame, elbow flange, shaft, pulley, back panel (`./cadtool python tools/export_printables.py --parts forearm_roll_block elbow_flange forearm_roll_shaft forearm_roll_pulley forearm_roll_back_panel`) | `print/` |

## 1. Why a roll, and where
The SolidWorks arm had five revolute joints — `base_yaw` and three parallel pitches (`shoulder_pitch`,
`elbow_pitch`, `wrist_pitch`) plus `wrist_roll` — so the tool's approach axis could never leave the vertical
plane through the base axis. `wrist_pitch` and `wrist_roll` already met at one point, the **wrist centre**
(`robot/frames.py WRIST_CENTRE`: `WRIST_CENTRE_ALONG_N` = 17 mm back along the pitch axis from the wrist_pitch
origin, 5 µm off both axes). A roll about the forearm through that point would make the last three axes concurrent -
a spherical wrist; the wrist roll drive (`docs/wrist_roll.md`) puts the wrist roll axis `WRIST_ROLL_OFFSET` across the
pitch axis instead, so an IK must be numeric. The roll crosses the pitch axis `WEB_DROP` from the wrist centre: the
forearm's web and the wrist on it dropped that far along the pitch axis toward the belt side
(`lib/forearm/params.py`), the roll axis stayed. The axis runs
along `ELBOW_TO_WRIST_INPLANE`, `FOREARM_ROLL_AXIS_Z` = 42 − 17 = 25 mm along N from `j2_link`'s origin — in
`j2_link`'s frame: y 0, z 25, along −X.

**The elbow offset.** The roll motor sits ON the elbow axis and the roll axis above it, the drive's design centre
distance away (`ForearmConfig.elbow_offset` = `RollDriveParams.centre_distance`, `ELBOW_ROLL_OFFSET`; the stock belt runs round its tensioner, §0): so the
forearm, the wrist and the gripper sit that far across the elbow axis - along `j2_link`'s +Y, up in the arm's swing
plane -, moved rigidly from the capture (`lib/placements.py SHIFTS`: `j2_link#1` and every record beyond it; the
elbow's own records stay) - and `ELBOW_INSET` along −N, toward the upper arm (`ForearmConfig.elbow_inset`): the frame's
underside 6.0 over `j1_link`'s flat top, where the SolidWorks coupler's flange and boss left 11.0, the elbow flange's post
that much shorter; with the wrist flange's `PITCH_INSET` (`docs/wrist_roll.md`) the gripper's roll axis lies in the plane
of the base_yaw axis at home. The arm gains an elbow offset (the roll axis and the elbow axis do not cross); in
exchange the forearm lifts back to `ELBOW_PITCH_LIMITS_DEG`'s −47° (the frame, an octagon about the elbow axis, sweeps
nothing of `j1_link` as the elbow turns; it comes nearest the elbow motor's gearbox there: `docs/open_issues.md`). In
`j2_link`'s frame the elbow axis runs along Z through y = −`elbow_offset`.

**The forearm is turned.** `j2_link` and everything beyond it - the wrist-pitch motor and its board, the wrist, the
gripper - are turned half a turn about the roll axis from the capture (`ForearmConfig.roll_turn_deg`,
`lib/placements.py TURNS`): the wrist-pitch motor sits on the upper arm's side of the roll axis, its belt on the
other, and at zero the gripper is rolled with it (the URDF's capture pose; `robot/AGENTS.md`). The drive keeps its
pose - the rotor too, so the hard stop and ±`FOREARM_ROLL_LIMIT_DEG` stay where they were - and the wall's 4 bolts,
at 0 / 90 / 180 / 270° about the roll axis, take the pulley as before. The drive's frame and its tests stay in
`j2_link`'s frame BEFORE the turn (the elbow side's view of the forearm: `lib/mounts.py ModuleMount`,
`tests/forearm/helpers.py in_drive_frame()`); "`j2_link`'s frame" below is that one.

**The pulley is the output.** The 90T ring is the front end of the rotor, outside the bearings, and the forearm
bolts straight onto it: the belt drives the ring, the ring the forearm. With both bearings pressed onto printed
journals, each needs its own journal entered from its own end - so the rotor splits at bearing 1: the pulley's hub
runs through bearing 2 and on as a neck - under the bearing's bore, so bearing 2 slides over it - to bearing 1's front
face, where the shaft's journal through bearing 1 meets it; the shoulders space the inner rings as the spacer (`lip`)
spaces the outer ones, and the rotor clamp holds the two pieces and both inner rings together. The spacer sets the
pair 19 mm apart, so each bearing takes the forearm's bending moment over twice the elbow pattern's span; the shaft
behind bearing 1 is only the collar that holds it. No end cap: the frame's tower is one piece, the spacer between the
bearings.

## 2. Layout (module frame)
Module frame (`lib/forearm/layout.py module_frame_in_host`, `lib/mounts.py MODULE_MOUNTS` on `j2_link#1`, in its
frame before the forearm's turn):
origin on the roll axis at the elbow axis' station, **+Z along the roll axis toward the wrist** (host −X),
**+X = host +Z** (N, away from the upper arm), **+Y = host +Y = up in the arm's swing plane** (the tower above the
motor); the **elbow axis runs along X at y = `y_elbow`** (−`elbow_offset`). Every station: `stack_positions()`.

**The frame is one printed part round the motor; the elbow's output flange is its own part under it.** Its outline seen along the
elbow axis (`roll.py profile`): an octagon about the elbow axis (`end_sides`), a flat on each axis on the upper arm's
round end (`end_r`), hulled up to the tower round the roll axis (`tower_y`, from `z_tower_rear` to the front face), cut
off at the front face and behind the rear line (`roll.py rear_line`: tangent to the `end_r` circle and to a
`rear_line_r` circle in the tower's rear-top corner - the line the round end's hull ran, which the elbow motor's stack
passes nearest at the elbow's lower limit; the octagon's corner behind it cut off) - extruded
along N from the underside (`block_x[0]`, 6.0 over `j1_link`'s flat top) to the side face (`block_x[1]`); seen along the
roll axis the tower is the forearm flange's octagon (`roll.py tower_section`, flats `tower_y`), and the front face's two
long edges are faceted (`roll.py front_facets`, `front_facet`), the bearing boss rising out of them; closed: the
motor's pocket opens down through the octagon's bottom instead, the shaft's bay through the frame's back (under the
removable back panel, flush with the rear line: §0). The
measured SolidWorks coupler (`reference/solidworks/j3_coupler.step`: Ø78 flange host z −10…0, Ø62 boss
−14…−10, Ø40 journal −15.3…−14, Ø30 stub −22…−15.3, Ø12.5 bore, 4× M4 at r 11 from the pulley) gives the elbow flange
(`elbow_flange`) under the underside about the elbow axis its journal - carried up to the underside as one post (`post_dia`) -, stub, bore
and bolt circle; its flange and boss, which turned in the Ø80 recess `j1_link`'s top no longer has, are not repeated.
The elbow 90T bolts up through it (through the elbow's 6806 pair, §4) into nuts in the frame's spigot, and
`j3_coupler#1` is **retired** (`lib/placements.py RETIRED`: the record stays, no table claims it; the wrist's
`j3_coupler#2` likewise: the wrist's flange is its own part too, `wrist_flange` on `wrist_link`, `docs/wrist_roll.md`).

| station | what | fixed by |
|---|---|---|
| the octagonal end, its flats `end_r` about (y `y_elbow`, z 0), x `block_x` −30…30 | the frame's outline round the elbow axis; the motor and its board inside it (the pocket's top corners 36.75 from the axis, 5 mm or more inside the flats) | `j1_link`'s round end (the flats round it, the arm's `ArmParams.end_r` inside); `ROLL_FRAME_R` (the underside 6.0 over `j1_link`'s flat top, FACE_GAP or more: `ELBOW_INSET`) |
| the elbow flange (`elbow_flange`), x −45…−30 about (y `y_elbow`, z 0), and the frame's spigot, −32…−30 | `post_dia` Ø40 **post** −35.3…−30 (`post_x`: the coupler's journal carried up from 0.7 above the upper 6806 to the underside, over `j1_link`'s Ø42 bore and never over its flat top; its foot chamfered `post_chamfer` at 45°), `step_dia` Ø33 −36…−35.3 (the shoulder on the upper 6806's inner ring), `stub_dia` Ø30 −45…−36 (9 long, as the wrist flange's; in the upper of the elbow's 6806-2RS pair and on through the lip, `j1_link`'s bore: `lib/mounts.py bearing_6806#3` / `#4`), the Ø12.5 `pin_bore_dia` (from the stub's end, blind at −37); the octagonal recess −32…−30 in its top over the frame's **spigot** (`spigot_af` 32 across flats, `spigot_h` 2 under the underside, `spigot_fit` 0.15 a side); the elbow 90T's **4× M4 × 35 at `pulley_bolt_r` 11, turned `pulley_bolt_deg` 45°** off the axes: Ø4.4 clearance through the flange and the spigot, then each nut's **hex channel** (`nut_af` 6.85, a flat toward the elbow axis) from its seat `nut_seat_x` −31 (1 of spigot between the nut and the flange) up through the floor into the motor's pocket | the measured coupler, its stub `PULLEY_SEAT_SHIFT` (3) longer: its end (host −20, the lip's lower face) sits on the re-seated pulley's face; `ELBOW_INSET` (the frame that much nearer `j1_link` than the capture put it); the recess's corners 2.5 inside the post, the nuts' outer flats 1.6 inside the spigot's; the nuts (−31…−27.8) and the screw tips (−26.4, 2 pitches past) 3.4 or more under the pocket's floor |
| `motor_pocket` y `y_motor` ± 22.25 (cut on down out through the octagon's bottom), z −29.25 … `z_motor_face` 26.85, from `x_cradle` −23 to `x_side` 23 | the roll motor ON the elbow axis, centred on the roll axis in X: its mounting face `z_motor_face`, the body −12.65…26.85, the MKS board −26.75…−12.65, turned `motor_spin_deg` 0° so its connector and the board's motor header point down into the opening (their short wire there); the pocket round the board's 43 square + `pocket_clear` (no slide: the idler tensions the belt), `pocket_rear` behind the board - room for the motor and its board to slide up from the bottom `motor_drop` back (the pilot boss under the plate) and go forward into place; the floor (`web_t`) 2 mm under the motor, the side wall (`side_t`) as far over it | the 20T's teeth level with the ring (`t20`), its hub `pulley_seat` over the motor's pilot boss: the motor `pad_t` behind the front face, the plate thick enough for the screws' counterbores; the shaft's tip past the forearm wall's plane, which the rolling forearm clears round the roll axis |
| `plug_slots`, at the board's side headers, inside the walls | a **groove** inside each wall: turned with the motor, the MKS board's two side headers face ±X - the side wall and the floor -, nearer than their plugs' `MKS_PLUG_ROOM`; each groove `plug_clear` round its header's outline, from the pocket out to `plug_skin` inside the frame's face, from the header down out through the bottom and `motor_drop` behind it; each cable bent straight down at its plug, the straight room left (`side_plug_room`) short of `MKS_PLUG_ROOM` | the board's plugs stay in as the arm moves (`tests/test_sweeps.py test_the_mks_boards_keep_their_plug_room`, these two at `side_plug_room`: `docs/open_issues.md`); the motor slides up with its cables plugged |
| `z_motor_face` 26.85 … `z_front` 33.85 | the **plate** (`pad_t`), the pocket's front wall: round holes on the motor's 31 mm square (`motor_holes`), each screw's head (`roll_motor_screws`, 4× M3 × `ROLL_MOTOR_SCREW_LEN`) flush in a Ø5.7 counterbore from the front face down to `z_motor_screws` 30.85, the Ø22.3 pilot hole, the shaft's **slit** (`shaft_slit`) from the pilot hole down out through the bottom; its face is the frame's front face, its two long edges faceted `front_facet` at 45°; the 20T's hub 1.5 down in its pilot hole | the motor's face; 4 of plate under the heads, the counterbores `head_h` deep, the screws' thread in the motor `motor_holes.thread`; the facets as deep as the pocket's corners and the counterbores leave wall (`front_facet`'s note) |
| `z_front` … `z_idler` 38.8 | the tensioner's **riser** on the front face (`riser_w`, its land `land_w` on top under the idler's inner ring), a stadium along N over the idler's `travel`; the M5's slot through it and the plate, on past the screw's tip; `roof` under the face, the nut's **channel**, closed at both ends, the nut in from the pocket (`entry`) | the idler level with the belt (`z_ring_mid`); the channel `nut_fit` round the nut, off the motor's pocket |
| `z_tower_rear` 0.75 … `z_front` | the **tower** round the roll axis, up to `tower_y`; seen along the roll axis the forearm flange's octagon (`tower_section`: its top corners cut to the diagonal flats) | `ROLL_FRAME_R`, as far as the underside and the side face (the bay + 4.4, to the diagonal flats too), its corners sharp, the rear line (`rear_line_r`) from the end up to its top; `tower_rear` the outline's (it anchors the rear line), the bay bored through it |
| … `z_bearing_1` 11.6 | the shaft's **bay** (`bay_r` 25.6 round the roll axis), bored on through the frame's back, under the back panel: the shaft, its nuts, the stop; the **stop post** on the tower's face behind bearing 1 at −X (`stop_post_r`, `stop_post_t` back from it) | round the lug's corners + 1; the shaft, bearing 1 on it, goes in along the axis from behind; its lug sweeps the top, 2 mm or more inside the rear line |
| `z_bearing_1` 11.6 … `z_lip` 18.6 | **bearing 1**'s seat Ø42.15, open into the bay (the bearing goes in from it) | |
| `z_lip` 18.6 … 30.6 | the lip - a 12 mm spacer (ID `lip_id` 37.6) - between the outer rings | the pair 19 apart |
| `z_bearing_2` 30.6 … `z_boss` 37.6 | **bearing 2**'s seat Ø42.15 in the **bearing boss** (Ø`bearing_boss_dia` 52 on the front face round the roll axis: 4.9 of wall, 4 inside the frame's three sides and the tower's octagon, carried down through the front facets so it rises out of them), right under the ring, the front face (33.85) running through its seat; the ring's rear flange turns over the boss's top, 3.6 past its edge - no cup round it | the ring, `run_gap` above it; the belt's edge clear above it |

The rotor, the forearm wall back (`stack_positions`):

| station | what | fixed by |
|---|---|---|
| `z_wall` 48 … `z_wall_back` 56 | the forearm wall (`wall_x` −56…−48), round (Ø60, over the ring); 4× M3 × 16 on Ø31 from its wrist face through the wall and the spigot into the nuts in the pulley's core (tips `z_end_tip` 40, nuts 41…43.4, pockets from the bore, `end_nut_pocket`) | the rolling forearm clears `j1_link`'s r 45 end |
| 48 … `z_spigot_end` 50 | the pulley's **Ø39.7 spigot** (`RollEndParams.flange_dia`) in the wall's Ø40 recess; the rotor clamp's counterbores from its face, their floor `z_clamp_head` 46.75 | the wall's recess |
| `z_ring_flange_1` 38.6 … 48 | the **90T ring** (teeth `z_ring` 39.8…46.8, `z_ring_mid` 43.3) on the pulley's Ø44 core, its front flange on the wall | the forearm wall's station |
| `z_boss` 37.6 … 38.6 | the pulley's Ø33 shoulder on bearing 2's inner ring | `run_gap` |
| `z_bearing_2` 30.6 … 37.6 | the pulley's hub (Ø30.3 journal) through bearing 2 | |
| `z_meet` 18.6 … 30.6 | the pulley's **neck** (`neck_dia` 29.9: bearing 2 slides over it) through the spacer | bearing 1's front face |
| `z_bearing_1` 11.6 … `z_meet` 18.6 | the shaft's journal (Ø30.3) through bearing 1, its end on the pulley's neck | bearing 1 |
| `z_shoulder_1` 10.6 … 11.6 | the shaft's Ø33 shoulder on bearing 1's inner ring | `run_gap` |
| `z_shaft_end` 1.75 … 10.6 | the shaft's Ø40 flange: the rotor clamp's 4 nuts 2.75…5.15 (pockets open to its rear face and the bore, `clamp_nut_pocket`), the **stop lug** at +X (`stop_lug_r`, `stop_lug_t` from the rear face; where it meets the post: §0 range) | the clamp's tips (`clamp_screw_len` from `z_clamp_head`) |

Ratio 90 / 20 = 4.5 (`FOREARM_ROLL_RATIO`) → ≈ 1.1–1.8 N·m at the roll from the 40 mm kit motor, against a worst-case
static load of ≈ 0.5 N·m (forearm horizontal and rolled to hold the wrist's longest lever level: ≈ 0.67 kg wrist +
gripper - `wrist_pitch_link`, `wrist_roll_link` and the jaws in `robot/arm.urdf` - + 0.2 kg payload at `tool0`). The
shoulder (`cycloidal_drive.md` §7) carries the drive too (its masses: `elbow_link`'s and `forearm_link`'s `<inertial>`
blocks in `robot/arm.urdf`). The elbow's torque path is the elbow 90T → 4× M4 through the elbow flange into captive nuts in the frame's spigot (the flange keyed on the spigot's octagon) → the frame → the
tower → the 6806 pair → the rotor → the forearm wall: the frame carries the forearm's load `ELBOW_ROLL_OFFSET` across
from the elbow flange, and the pair, 19 mm apart centre to centre, the forearm's bending moment (`docs/open_issues.md`:
check both on the print).

## 3. Fits and printing
PETG, the drive's rules (`cycloidal_drive.md` §6): the seats are the bearing OD + `seat_add` 0.15 (a printed hole
comes out undersize — print the fit gauges first, `tools/export_gauges.py`), the journals `journal_add` 0.3
interference. Tests
(`tests/forearm/test_roll_drive.py`) hold the journal press fit at 0.9–1.0 × 99 mm³ per bearing, 0 in the seats,
every other pair in the module below 1 mm³, the rotor `run_gap` off the frame, the two hubs face to face in the lip,
the elbow flange's stub end ON the elbow pulley's face (`tests/test_mounts.py test_bearing_stacks` holds the elbow's 6806
stack) and the flange on the frame's underside, its recess round the spigot (`tests/forearm/test_elbow_flange.py`). Print the frame front face down (the tower's seats print as vertical bores, the pocket's rim as walls; the
tensioner's riser land stands on the bed, `z_idler` − `z_boss` proud of the bearing boss: supports under the boss and
the rest of the front face, under the spigot standing `spigot_h` off the underside, inside the pocket under its back wall and under the plug grooves' tops (the bay prints as an open bore, the
rear face's step, the opening and the magnets' pockets open upward); the octagonal end and the front face's facets rise
off the bed at 45°, FDM's self-supporting angle - a printability check (`parts/AGENTS.md`) before the first print,
`docs/open_issues.md`),
the elbow flange on the stub's end (the stub, the shoulder and the post print as vertical circles, the holes vertical; the shoulder and the post's foot step out 1.5 and 2 over the stub as short overhangs, the recess open upward), the pulley spigot down (the ring's grooves print vertically; a support ring under its front flange, 2 mm over the bed),
the shaft rear face down (its nut pockets open to the bed), the back panel outer face down (its rim and magnet pockets
up; `pocket_depth` leaves `t` − `pocket_depth` of it over each magnet; the grill's slots plain walls up from the bed).

## 4. Assembly sequence
1. Four M4 nuts (`elbow_pulley_nuts`) into the frame's hex channels from the motor's pocket, reached through its open
   bottom (before the motor), down onto their seats - the channel's 6.85 across flats holds each; the tensioner's M5 nut
   (`roll_idler_nut`) up into the recess in the plate's inner face and on along it into its channel.
2. The elbow's 6806-2RS pair into `j1_link`'s bore, one each side of the lip; the elbow flange's stub into the upper
   one (its Ø33 shoulder on the inner ring, its end through the lip), the frame onto the flange (its spigot in the
   flange's recess, the holes lined up), the elbow 90T's hub into the lower one from below (its Ø34.76 ring on that
   inner ring, its end on the stub's end): 4× M4 × 35 (`elbow_pulley_screws`, the heads in the pulley's counterbores,
   `GT2_PULLEY_90T_HEAD_SEAT` under its face) up through the pulley's hub (its holes opened to `M4_CLEAR`), the flange
   and the spigot into the nuts (the tips 1.4 mm past them) bolt the pulley flat onto the stub, the flange onto the
   frame, and clamp both inner rings - the stub's 2 mm in the lip spaces them as the lip spaces the outer rings.
   The hex holds each nut, so the screws re-tighten from the pulley side at any time (with the motor out, a screw
   taken right out can drop its nut into the pocket).
3. Slide bearing 2 over the pulley's neck and press it onto its journal against the shoulder; press bearing 1 onto
   the shaft's journal against its shoulder.
4. The pulley + bearing 2 into the tower from the front (the outer ring in its seat, on the spacer; the ring's flange
   over the bearing boss); four M3 nuts (`roll_clamp_nuts`) into the shaft's flange pockets from its rear face, then the shaft + bearing 1
   into the tower from behind (the back panel off), through the bay's bore in the frame's back and along the axis, its journal's end onto
   the pulley's neck.
5. 4× M3 × `clamp_screw_len` (the rotor clamp, `roll_clamp_screws`) from the pulley's front face, the heads into its counterbores, through
   both pieces into the nuts: the rotor turns, whole.
6. The motor, its board on, the short wire from the motor's socket to the board's motor header plugged and the board's
   two side cables plugged - each bent straight down at its plug -, up into the pocket from the bottom `motor_drop`
   back - the pilot boss passes under the plate, the shaft up the slit, the side plugs and their cables up their
   grooves - then forward onto the plate, the boss into the pilot hole (4× M3 - `roll_motor_screws` - from the front
   face, the heads into its counterbores; the connector down, toward the opening); the 20T on its shaft, its hub on a
   `pulley_seat` shim on the pilot boss (its teeth then level with the ring), its set screws tightened above the face.
   The roll belt (`forearm_roll_belt`) round the ring and the 20T; the idler on the riser against the belt's back,
   the M5 down through it into the nut; push the idler along its slot until the belt is tight, then tighten the screw.
7. The forearm's cables do not pass through the bay (their route: `docs/open_issues.md`); the roll motor board's cables
   out through the open bottom, tied flat along the frame (the elbow motor's gearbox and motor pass under it at the elbow's upper
   range: `docs/open_issues.md`). The back panel: its 4 magnets glued into the pockets in its inner face and the 4 into
   the step's floor (`roll_back_magnets`; mark the poles first, so each pair attracts: the frame's all one pole out),
   each pressed to its pocket's bottom; then the panel into the step, its rim into the opening - the magnets pull it
   flush. To reach the shaft again, lift it off by a side edge (the step is open on both side faces).
8. Four M3 nuts into the pulley's core pockets from its cable bore (7–9 mm in from its front face, tweezers), each
   pushed out against the pocket's end. Then the forearm wall onto the spigot (2 mm into the recess) BEFORE the
   wrist-pitch motor goes on: 4× M3 × 16 from the wall's wrist face through the spigot into the nuts, the bottom one's
   head just over the web's top face. A screw taken right out can drop its nut into the bore. The wrist-pitch motor's
   body stands in front of all four heads (it sits `motor_wall_clear` or more off them): take it off to reach them
   later. The stop lug on the
   shaft's flange meets the frame's post just past ±`FOREARM_ROLL_LIMIT_DEG`.

## 5. Attachment to the arm (`robot/`)
`elbow_link` = `gt2_pulley_90t#3` (the re-seated elbow 90T) + its screws and nuts + `forearm_roll_drive#1:stator` (the
elbow's driven side: the frame and the elbow flange under it, its back panel and magnets, both bearings, the motor + board on the elbow axis and
its 4× M3, the 20T, the belt and its tensioner); `forearm_link` = `forearm_roll_drive#1:rotor` (the pulley and the shaft) + `j2_link`
and what it carries (the wrist-pitch motor + board, its 20T, the wrist belt and its tensioner, the wrist's 6806 pair:
`robot/frames.py LINKS`). `Joint("forearm_roll")` has Z along the forearm and X = N (its child's long direction IS
the axis); its origin sits `ELBOW_ROLL_OFFSET` across `elbow_link`'s frame (`robot/frames.py FOREARM_ROLL_ORIGIN` from
`j2_link#1`'s shifted origin, on the turn's axis; `ELBOW_ORIGIN` from the retired `j3_coupler#1`'s). Beyond it the axes
are turned with the forearm (`WRIST_PITCH_AXIS` the capture's −N): the forearm's turn changes `forearm_link`'s mesh and
inertial and the `wrist_pitch` origin, nothing further out. The forearm side of the interface is
`lib/forearm/params.py RollEndParams`: the wall at `wall_x` (−56…−48), round about the roll axis (`wall_od`), its Ø40
recess, the Ø31 bolt circle (the screws' nuts in the pulley) and the Ø24 cable bore, on the end of the straight web
(`WebParams.half_w`, as wide as the wall) with two gussets — `j2_link`'s DEFAULT build
(`lib/forearm/link.py roll_wall`, `wall_outline`, `straight_web`, `wall_gussets`). In `arm.py` the module is kept whole under the `elbow_link` group. The wrist-pitch motor
sits on round holes `WRIST_MOTOR_CENTRES` from the wrist (`J2_MOTOR_X`, `MotorHoleParams`), held by 4x M3 up through
the web (`wrist_motor_screws`, `J2_MOTOR_SCREW_LEN` - the elbow motor's screws and seat), their heads flush in
counterbores in its underside - fit them before the belt's idler, whose flange passes under one head -, nearer than the stock wrist
belt's (`WRIST_BELT_LENGTH`, a multipack length) own centre distance, its body `motor_wall_clear` or more off the wall
screws' heads; its connector faces sideways - away from the elbow axis, the forearm turned - with `plug_clearance` of
room beside it (`tests/forearm/test_roll_end.py`). The belt's tensioner (`IdlerParams`): an idler under the web on the
run leaving the motor's 20T, on its M5 axle up through a rib and the web's slot into a nut in a channel from the web's
top face, slid across the forearm between `slot_y`'s ends (`tests/forearm/test_wrist_idler.py`).

## 6. Not modelled / to confirm
`docs/open_issues.md`: the home sensor's mount (the modelled `ky003_hall_sensor`'s chip beside the stop
post on the tower, a magnet in the stop lug, to the MKS board's limit input), the forearm's cable route (not through the
bay); the back panel's magnets (their hold, their stray field at the MKS encoders and the home sensor); the
6806 seats' PETG fit; the frame's print orientation and its flex under the forearm's load, the
6806 pair's tilt play at the roll, the rotor clamp's thin walls and its nut pockets' fit; `t20_hub`,
the limit and the printed stop's strength; the elbow offset in a future IK; the room to lift the forearm further back
than `ELBOW_PITCH_LIMITS_DEG`'s lower limit; the roll motor's **CAN id** (`software/control/src/config.py` has no row
for it: it names fewer boards than the arm carries).
