hbenuid/robotic-arm/cad/reference/native/forearm_roll_shaft.step

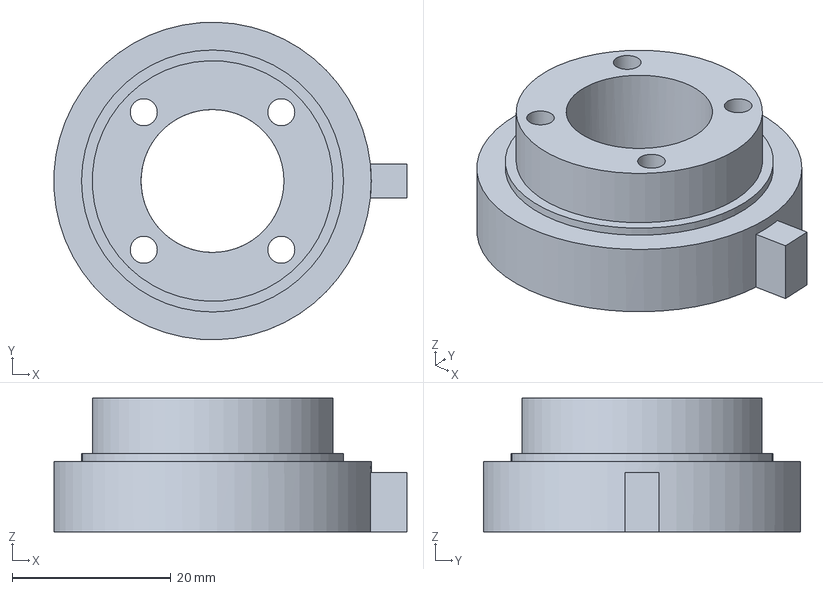
[picture p1: CAD file, 2026-11-13]
cad/reference/native/forearm_roll_shaft.step
44.5 x 40.0 x 16.9 mm
