hbenuid/robotic-arm/cad/robot/meshes/wrist_roll_link.stl

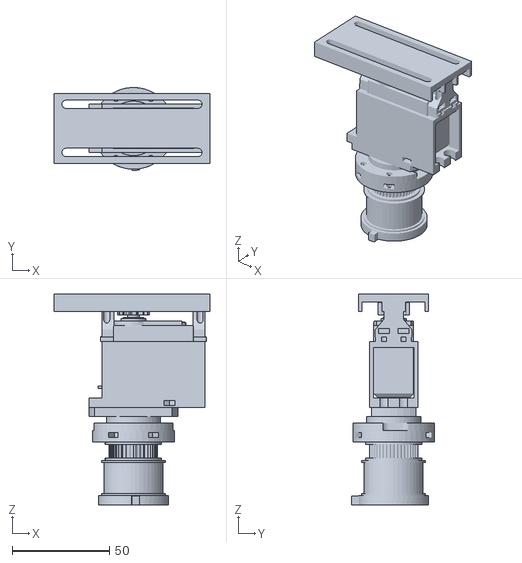
[picture p2: CAD file, 2026-11-13]
cad/robot/meshes/wrist_roll_link.stl
80.0 x 42.7 x 108.4
