hbenuid/robotic-arm/cad/reference/native/base_motor_mount.step

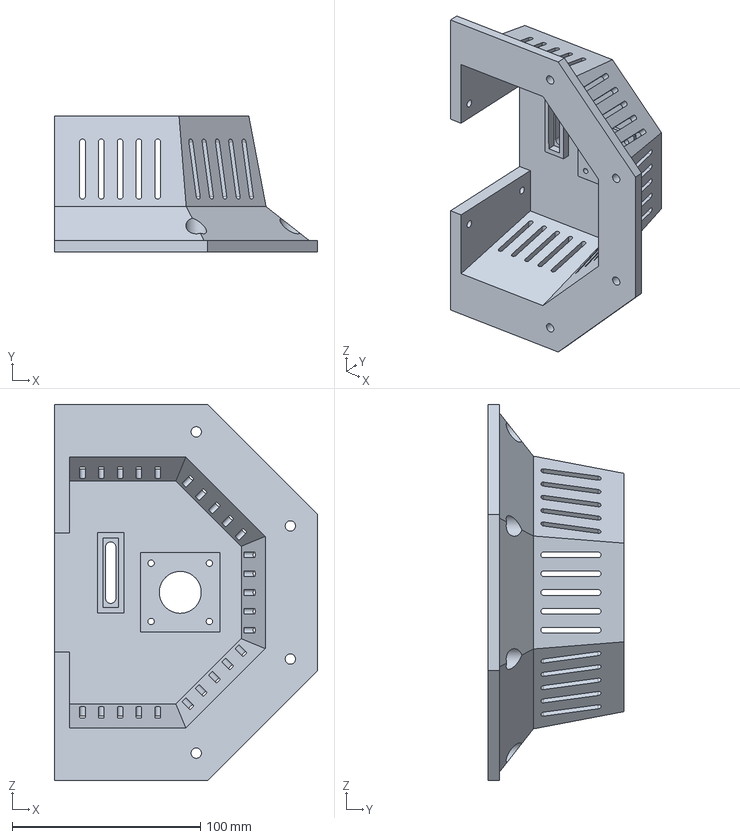
[picture p3: CAD file, 2026-11-08]
cad/reference/native/base_motor_mount.step
140.1 x 72.1 x 200.0 mm
