hbenuid/robotic-arm/cad/robot/meshes/wrist_pitch_link.stl

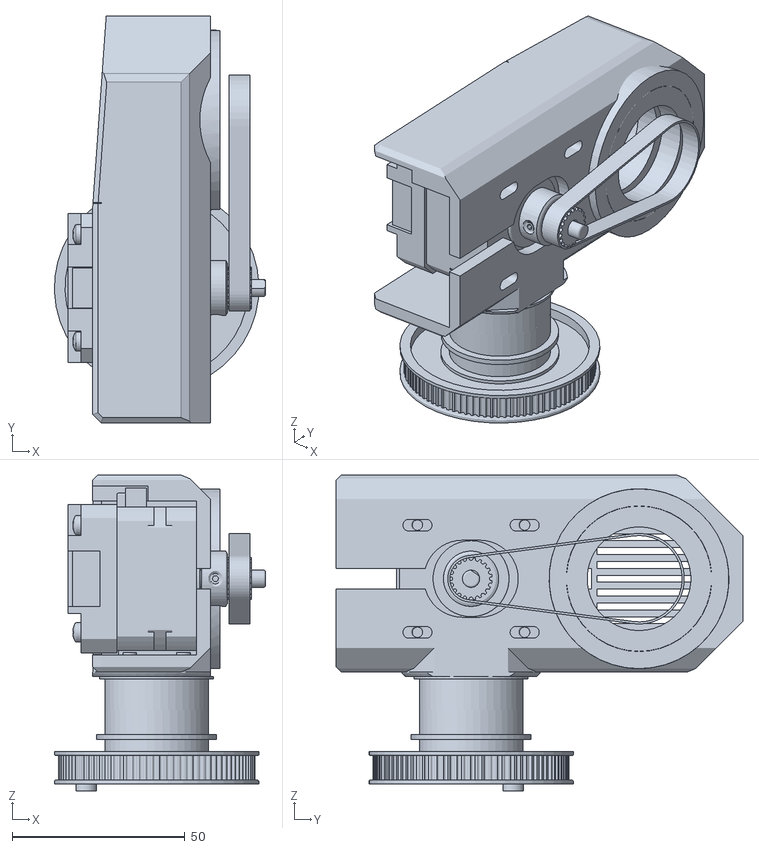
[picture p4: CAD file, 2026-11-11]
cad/robot/meshes/wrist_pitch_link.stl
61.1 x 117.6 x 91.4
