hbenuid/robotic-arm/cad/robot/meshes/upper_arm_link.stl

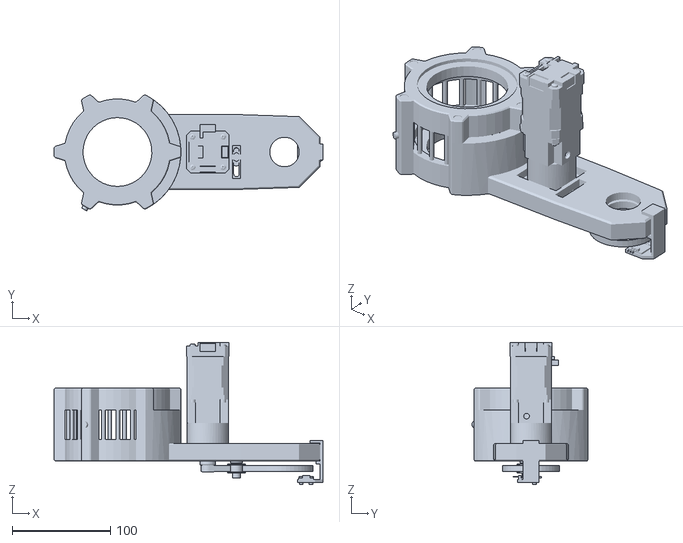
[picture p5: CAD file, 2026-11-11]
cad/robot/meshes/upper_arm_link.stl
273.8 x 118.1 x 144.6
