hbenuid/robotic-arm/cad/reference/native/forearm_roll_block.step

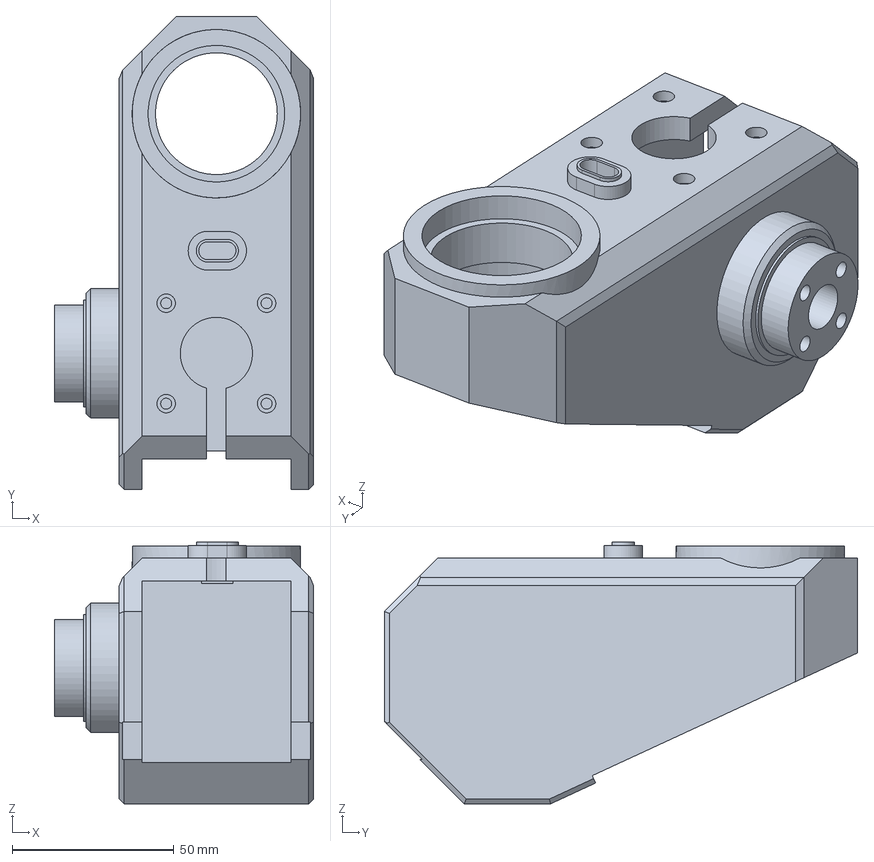
[picture p6: CAD file, 2026-11-07]
cad/reference/native/forearm_roll_block.step
80.0 x 146.0 x 80.8 mm
