hbenuid/robotic-arm/cad/robot/meshes/base_link.stl

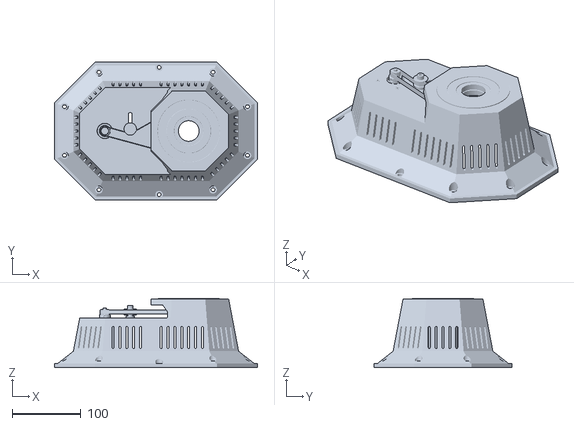
[picture p7: CAD file, 2026-11-08]
cad/robot/meshes/base_link.stl
295.1 x 200.0 x 101.0
