hbenuid/robotic-arm/cad/reference/native/bearing_6806.step

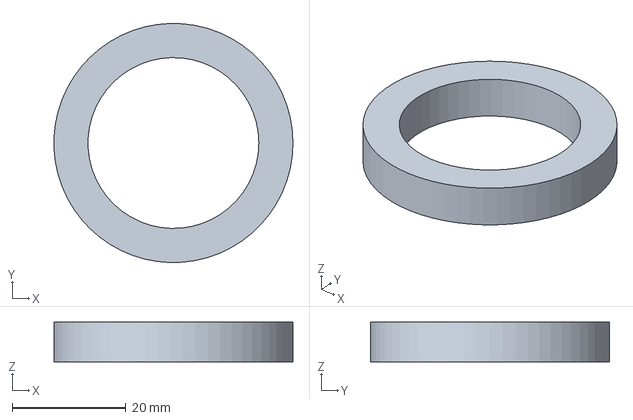
[picture p8: CAD file, 2026-10-14]
cad/reference/native/bearing_6806.step
42.0 x 42.0 x 7.00 mm
