hbenuid/robotic-arm/cad/robot/meshes/forearm_link.stl

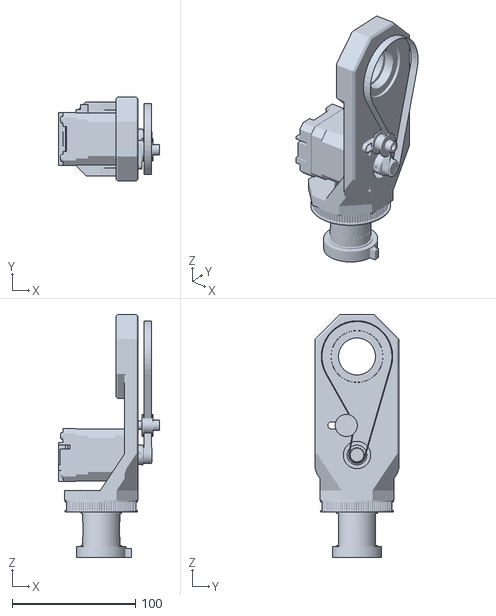
[picture p9: CAD file, 2026-11-08]
cad/robot/meshes/forearm_link.stl
81.8 x 68.2 x 197.3
