hbenuid/robotic-arm/cad/reference/native/ky003_hall_sensor.step

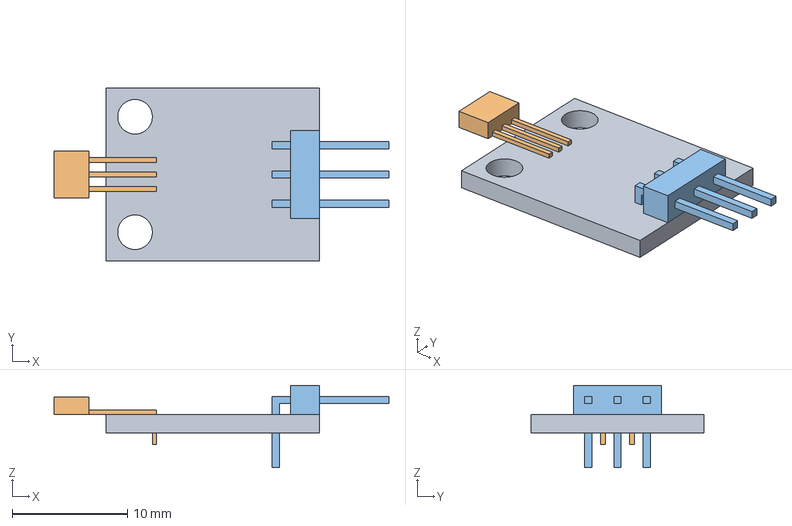
[picture p10: CAD file, 2026-10-14]
cad/reference/native/ky003_hall_sensor.step
29.0 x 15.0 x 7.14 mm
