hbenuid/robotic-arm/cad/robot/meshes/jaw_b_link.stl

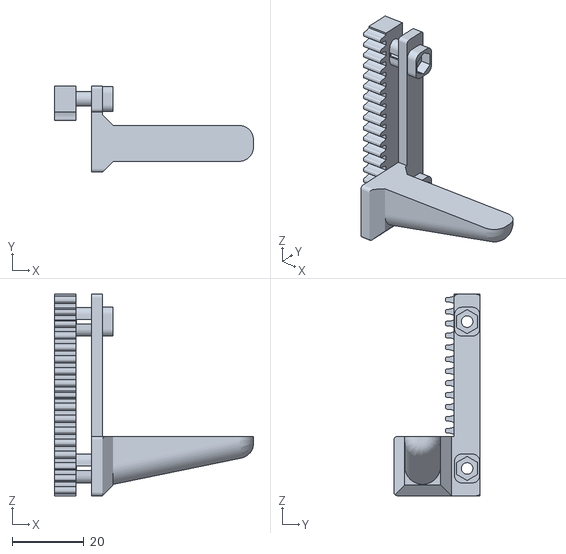
[picture p11: CAD file, 2026-11-08]
cad/robot/meshes/jaw_b_link.stl
55.3 x 24.0 x 56.0
