hbenuid/robotic-arm/cad/robot/meshes/elbow_link.stl

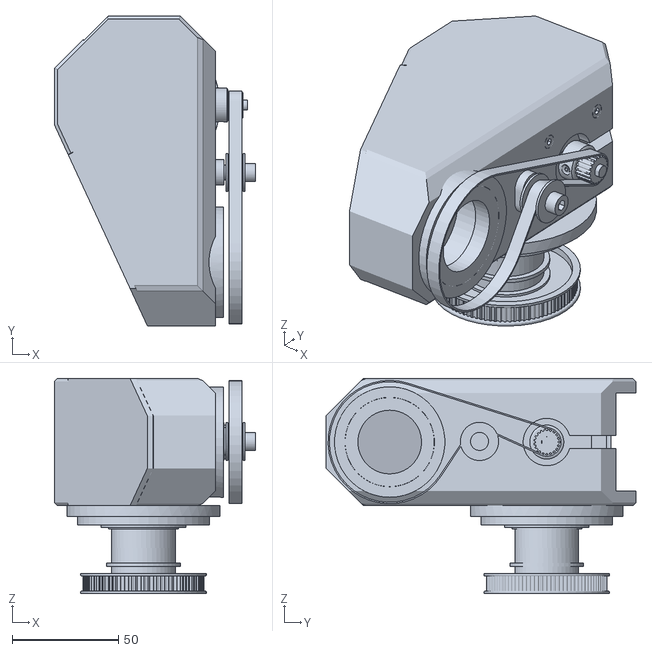
[picture p12: CAD file, 2026-11-05]
cad/robot/meshes/elbow_link.stl
94.8 x 146.0 x 101.4
