hbenuid/robotic-arm/cad/reference/native/base_motor_mount_nuts.step

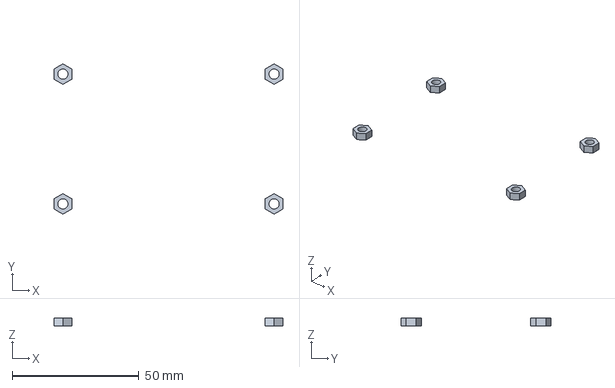
[picture p13: CAD file, 2026-10-14]
cad/reference/native/base_motor_mount_nuts.step
90.2 x 59.2 x 3.20 mm
