hbenuid/robotic-arm/cad/robot/meshes/shoulder_link.stl

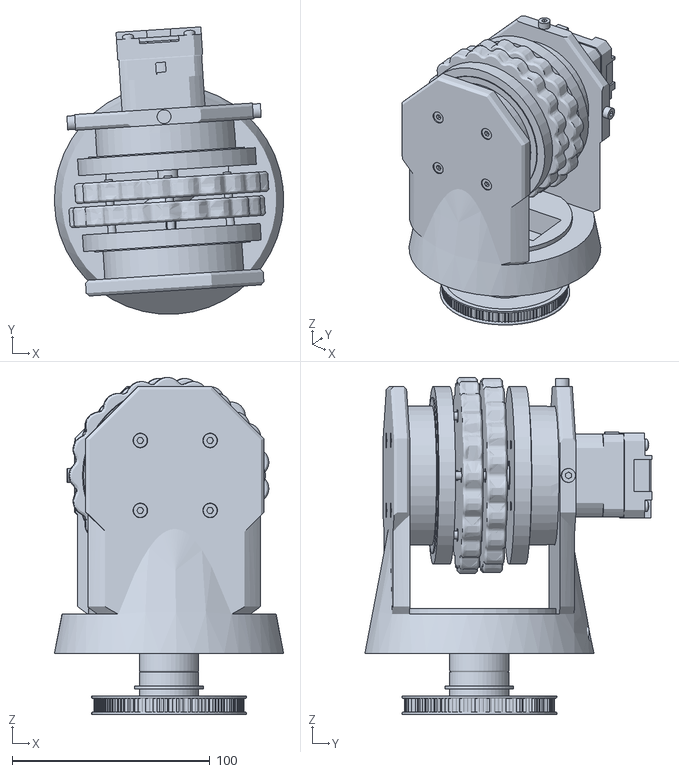
[picture p14: CAD file, 2026-11-03]
cad/robot/meshes/shoulder_link.stl
115.9 x 145.2 x 170.3
