hbenuid/robotic-arm/cad/reference/cycloidal/bearing_6003.step

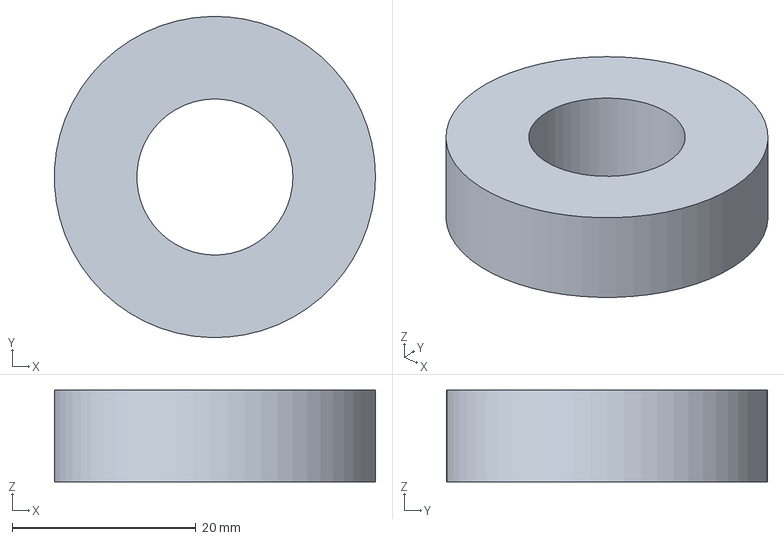
[picture p15: CAD file, 2026-08-28]
cad/reference/cycloidal/bearing_6003.step
35.0 x 35.0 x 10.0 mm
