hbenuid/robotic-arm/cad/reference/cycloidal/cycloidal_ring_gear_body.step

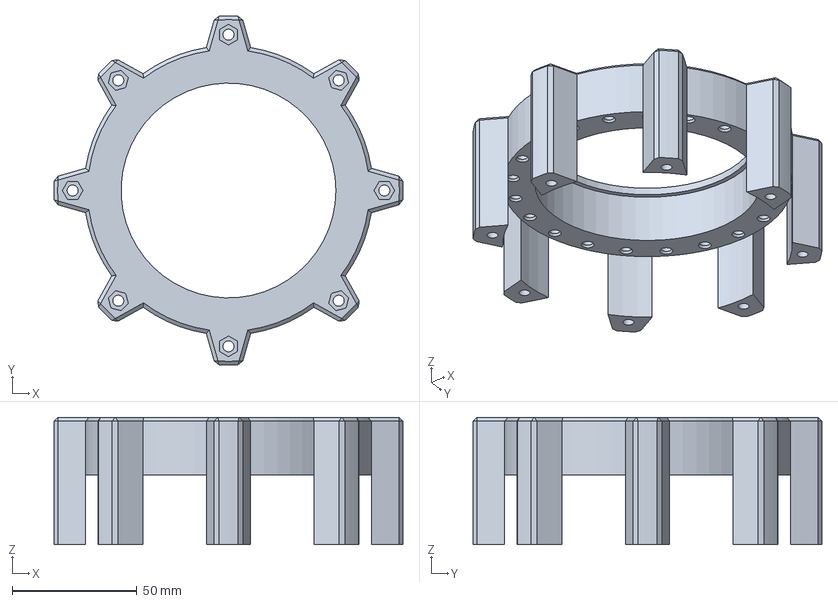
[picture p16: CAD file, 2026-08-28]
cad/reference/cycloidal/cycloidal_ring_gear_body.step
140.0 x 140.0 x 51.0 mm
