hbenuid/robotic-arm/cad/reference/solidworks/base.step

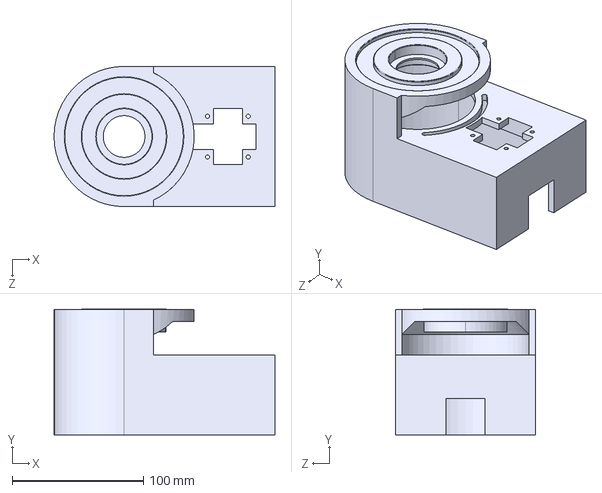
[picture p17: CAD file, 2026-08-28]
cad/reference/solidworks/base.step
168.2 x 95.8 x 106.7 mm
