hbenuid/robotic-arm/(list of files, cad)

Other CAD files:
cad/reference/cycloidal/cycloidal_ring_pins.step
cad/reference/solidworks/mks_servo42d.step
cad/reference/cycloidal/cycloidal_disc_1.step
cad/reference/solidworks/nema17_40mm.step
cad/reference/cycloidal/cycloidal_eccentric_shaft.step
cad/reference/solidworks/mg996r_servo.step
cad/reference/cycloidal/cycloidal_motor_plate.step
cad/reference/solidworks/gt2_pulley_20t.step
cad/reference/solidworks/gripper_cover.step
cad/reference/cycloidal/bearing_625.step
cad/reference/solidworks/gripper_slider.step
cad/reference/cycloidal/cycloidal_disc_2.step
cad/reference/solidworks/gripper_end.step
cad/reference/cycloidal/cycloidal_output_pins.step
cad/reference/solidworks/gripper_j3_connector.step
cad/reference/cycloidal/nema17_48mm.step
cad/reference/solidworks/j3_coupler.step
cad/robot/meshes/jaw_a_link.stl
cad/reference/cycloidal/cycloidal_output_hub.step
cad/reference/native/gt2_idler_20t.step
cad/reference/solidworks/gripper_rail_6mm.step
cad/reference/cycloidal/cycloidal_housing_nuts.step
cad/reference/native/bearing_axk6590.step
cad/reference/solidworks/wrist_link.step
cad/reference/cycloidal/cycloidal_shaft_support_pin.step
cad/reference/solidworks/j1_link.step
cad/reference/cycloidal/bearing_6814.step
cad/reference/native/elbow_pulley_nuts.step
cad/reference/solidworks/gripper_clamp_bracket.step
cad/reference/native/wrist_pulley_nuts.step
cad/reference/solidworks/j2_link.step
cad/reference/solidworks/servo_holder.step
cad/reference/solidworks/mg996r_horn.step
cad/reference/solidworks/nema17_pancake.step
cad/reference/solidworks/gripper_link_1.step
cad/reference/solidworks/gripper_finger_right.step
cad/reference/solidworks/gripper_link_2.step
cad/reference/solidworks/gt2_pulley_90t.step
cad/reference/solidworks/j1_coupler.step
cad/reference/solidworks/gripper_finger_left.step
cad/reference/cycloidal/cycloidal_housing_bolts.step
cad/reference/cycloidal/cycloidal_motor_bolts.step
cad/reference/native/base_motor_mount_screws.step
cad/reference/native/elbow_pulley_screws.step
cad/reference/native/washer_as6590.step
cad/reference/native/wrist_pulley_screws.step
