hbenuid/robotic-arm/cad/docs/open_issues.md

# Open issues — what the CAD knows is not settled

**Purpose:** the ONE list of unsettled things a session should know before trusting a number or a fit: fit problems
the model carries knowingly, `[ESTIMATE]` values waiting for a measurement, hardware not modelled yet, mappings
not confirmed, known-broken / pending items. **Rule:** when you flag something in a commit,
add a row to its section (the issue and where it lives, and what closes it and the commit that raised it where its
table has those columns); when you close it, delete the row and say so in the commit message. A number here is
a fit value or an estimate, quoted beside the constant or test that holds it — the code wins if they drift; counts
and totals are never quoted (`cad/AGENTS.md` Docs).

## Fit problems the model carries knowingly
| issue | where it lives | what closes it | raised |
|---|---|---|---|
| The base_yaw joint is set axially twice: `j1_coupler` stands on the thrust bearing (its seat `THRUST_STACK` above the groove's floor, the upper 6806 free under it - no shoulder by design, the stack sets the height) AND its 120T, bolted to the stub's end in the plane of the lip's lower face, has its ring under the lower 6806's inner ring (the lip on the outer) - what holds the coupler down. The model closes both line-to-line; on the prints the stack's height against that loop leaves play (the stub long) or loads the lower 6806 up against the lip (the stub short) | `lib/mounts.py` `gt2_pulley_120t#1`, `bearing_6806#1` / `#2`, `THRUST_MOUNTS`; `lib/yaw_coupler/params.py` DEFAULT (`stub_y0`, `recess_y1`); `tests/test_mounts.py test_bearing_stacks`, `test_thrust_bearing_carries_j1_coupler` | shim between the 120T's hub end and the stub's end on assembly - or print the stub short and take the rest up there | 2026-09-30 (`git log --grep yaw_pulley`) |
| The drive motor's tie rods are not modelled (the MKS kit's M3x30 replace them); bolt shanks overlap the export's tapped holes in the model (46 / 159 mm³, thread engagement) | `tests/cycloidal/test_assembly.py` interference budget | nothing — a modelling representation; re-measure if the vendor file changes | 2026-09-21 (`3e667e0`) |
| The wrist roll's MKS board on the pancake: the kit's 4× M3 × 30 replace the motor's own rear screws and reach `MKS_SERVO42D_SCREW_REACH` into it - past the pancake's own screws (`PancakeParams.body_length` long), to within the depth from its face that the motor plate's M3 × 8 take; in the model they run through the pancake's own (`KIT_OVERLAP`) | `tests/wrist/test_roll_drive.py KIT_OVERLAP`, `parts/wrist/nema17_pancake.py` | measure the pancake's screw holes once it is in hand (its exact model is a row below) and buy the board's screws to that length (~M3 × 25), an EXTRAS row in `tools/bom.py`; the model's overlap stays (the vendor board carries its M3 × 30) | 2026-10-20 (`git log --grep "wrist roll's MKS"`) |
| The drive's motor bolts are modelled `motor_bolt_recess` deeper than their pocket (`stack_positions` `z_motor_bolts`, the drive repo's stack-up): the heads 1 mm into the motor plate below the pocket's floor, the tips 0.5 past the motor's tapped holes; on the hardware the heads sit on the pocket's floor | `lib/cycloidal/layout.py stack_positions`, `lib/cycloidal/params.py MotorParams.motor_bolt_recess`, `tests/cycloidal/test_assembly.py` interference budget | drop `motor_bolt_recess` from `z_motor_bolts` and the motor-bolt / plate pair from the budget (Recipe C) | 2026-08-28 (`f670d20`, the port) |
| The wrist roll drive's frame is `wrist_link` itself: the gripper's load and the belt's pull reach the plate through the tower beside the pancake, `WRIST_ROLL_OFFSET` across the pitch axis; the far face's wall closes the pocket's side, but no wall closes it behind the pancake (its MKS board's window, `board_window`) nor below it (the pancake slides in from the bottom); the plate's and the tower's flex, and the 6806 pair's tilt play at the gripper, are unmeasured | `lib/wrist/params.py WristRollParams`, `lib/wrist/roll.py build_frame` | check for flex on the print (a dial gauge at the gripper, loaded); thicken the plate under the tower or rib the frame if it gives | 2026-10-14 (`git log --grep "wrist roll drive"`) |
| The roll frame carries the forearm's whole load - its bending moment and the elbow's torque - `ELBOW_ROLL_OFFSET` across from the elbow flange to the tower round the roll axis: one PETG body round the motor, its side face closed, its pocket open down through the octagon's bottom (the solid under the motor gone), the tower (the 6806 pair a 12 mm spacer apart, 26 mm) on the pocket's floor, side wall, top and plate; the forearm's sag at the gripper and the plate's flex under the belt's pull are unmeasured (the shaft's slit, `shaft_slit`, splits the plate's lower half; the plug grooves leave `plug_skin` of the floor and the side wall in a strip from each plug down to the bottom) | `lib/forearm/params.py RollDriveParams web_t` / `side_t` / `pad_t` / `tower_y`, `lib/forearm/roll.py build_block` | check the frame for flex on the print (a dial gauge at the gripper, the forearm loaded); thicken the floor or the side wall if it gives | 2026-10-07 (`git log --grep "roll motor on the elbow axis"`, `git log --grep "roll pulley"`) |
| The shoulder's upper limit (`SHOULDER_PITCH_LIMITS_DEG`) stops the arm pitching down in front where the upper arm, rising off the drive's middle, reaches `j1_coupler`'s disc (and, with the elbow folded back, the forearm roll drive comes near it and the base) | `lib/params.py SHOULDER_PITCH_LIMITS_DEG`, `tests/test_sweeps.py` | cut the yoke's disc back under the arm's swing (as it is on -X for the elbow motor), then open the limit up (the sweep test says how far) | 2026-09-29 (`git log --grep SHOULDER_PITCH_LIMITS`) |
| The wrist pitch range (`WRIST_PITCH_LIMITS_DEG`), the gripper on the wrist's outer side (`WristRollParams.side`): bending up, the wrist roll drive's frame (its slanted rear and back panel, `rear_low`) meets the wrist-pitch motor's board on the forearm - 2.41 mm off it at the upper limit (the motor `WRIST_MOTOR_CENTRES` from the wrist, nearer than the stock belt's centre distance, for its tensioner); bending down, the lower limit is not the gripper's (24.2 mm off the forearm at -150, 15.0 at -170, the forearm roll at 0) but nothing is swept past it | `lib/params.py WRIST_PITCH_LIMITS_DEG`, `lib/wrist/params.py WristRollParams` (`side`, `frame_r`), `tests/test_sweeps.py` | to bend up further, cut the tower back where the wrist-pitch motor passes it, or move that motor away; to bend down further, sweep past the lower limit (the wrist body and the gripper against the forearm at every forearm roll, the elbow tests) and open it to what they allow; the elbow folded is the planner's (the `ELBOW_GRIPPER_FREE_DEG` row) | 2026-09-29 (`git log --grep WRIST_PITCH_LIMITS`), 2026-11-07 (`git log --grep "rack & pinion"`) |
| The MG996R between the gripper base's posts: PapaBravo's posts stand 40.5 apart (`BaseParams.posts_x`), the MG996R's case is 40.7 long (`MG996R_BODY_L`, datasheet; the repo's vendor model 41.0) - a press of 0.1 a side, 0.25 in the model (`tests/gripper/test_module.py BUDGET`) | `lib/gripper/params.py BaseParams` / `ServoParams`, `tests/gripper/test_module.py` | try the servo in a printed base; if it does not go, take the posts' inner faces back (a `BaseParams` change: the measured part leaving its export) | 2026-11-07 (`git log --grep "rack & pinion"`) |
| The gripper's cage (`gripper_cage`) is designed here and not printed yet: the connector's screws' nuts in slots in its back plate, the tab screws through its ears put in through access holes - the two over the -x post's screws cut a corner of the connector screws' nut slots there -, the servo's cable in a 4.5 wide slot to the plug's hole on the axis; its print orientation is open; the -x pair's holes are joined to the access holes beside them (`join_wall`), so no sliver is left to print | `lib/gripper/params.py CageParams`, `lib/gripper/body.py build_cage` | print it (`cad stl dfm` first: `parts/AGENTS.md` Printability), fit the servo, the base and the connector's plate, the nuts and the cable | 2026-11-07 (`git log --grep "rack & pinion"`) |
| The elbow's limits (`ELBOW_PITCH_LIMITS_DEG`): at the lower (the forearm lifted back) the roll frame's back panel is 4.75 mm off the elbow motor's gearbox (1 mm at -52.5; the motor 5.1 off, its board 8.9 - the stack `ELBOW_MOTOR_CENTRES` from the elbow, for its tensioner) and the forearm, wrist and gripper 1 mm off the upper arm at any roll and wrist pitch - nothing is swept past it; the upper (folded) stops 2° short of the wrist-pitch motor's side plug's room reaching the base (the shoulder at its upper limit), the wrist body 1 mm or more off the base and `j1_coupler`; the gripper is the `ELBOW_GRIPPER_FREE_DEG` row's | `lib/params.py ELBOW_PITCH_LIMITS_DEG`, `tests/forearm/test_roll_drive.py` (`test_module_clears_its_neighbours_in_the_arm`, `test_forearm_clears_the_upper_arm_at_the_elbow_limits`), `tests/test_sweeps.py` (`test_the_elbow_limits_keep_the_forearm_and_the_wrist_off_the_upper_arm`) | to lift further, sweep the elbow tests and the shoulder limit's past the lower limit (the frame alone allows about -57) and open it; nearer the frame's 1 mm line, move its rear line in (`RollDriveParams.rear_line_r`) or the elbow motor back (past the motor, the frame meets the shoulder drive's shell ring near -90); to fold further, turn the wrist-pitch motor's board so that plug faces off the base (`lib/mounts.py BOARD_TURNS`), then slim the wrist body's far side where it passes the base | 2026-10-07 (`git log --grep ELBOW_PITCH_LIMITS`), 2026-10-22 (`git log --grep "outer side"`) |
| The base stands free over part of the arm's range only: stretched out, the arm's centre of mass is 131 mm off the base_yaw axis (165 with 0.5 kg in the gripper), the foot reaches `FootParams.r` - standing free the base tips in the stretched poses (and on fast moves); it is meant to be screwed down through the foot's 6 holes | `lib/base/params.py FootParams` | screw it to the desk or a baseboard; a bigger foot or a baseboard if it must stand free | 2026-10-07 (`git log --grep FootParams`) |
| The eccentric shaft's D-bore takes the motor shaft's flat at `MotorParams.shaft_dcut_flat` / 2 off its axis (flat to round 4.75, the drive repo's convention: `lib/cycloidal/motor.py`) plus `d_bore_clearance_add`; a standard Ø5 D-shaft is 4.5 flat to round - on the motor in hand the bore would be about 0.3 loose on its flat | `lib/cycloidal/params.py ShaftParams.d_bore_flat` / `MotorParams.shaft_dcut_flat`, `lib/cycloidal/motor.py` | calipers on the shaft's flat; the D-bore gauge (`tools/export_gauges.py --only dbore`) on the motor; if loose, both constants together, then Recipe C | 2026-11-08 (`git log --grep "fit gauges"`) |
| The motor screws' counterbores (`MotorHoleParams.pocket_dia`: forearm_roll_block, j2_link; the drive's motor plate, `motor_bolt_head_dia` + `bolt_clearance_add`) are sized from the drive's modelled head (`MOTOR_40.motor_bolt_head_dia`), not the ISO 4762 M3's (`M3_SHCS.head_dia`): 0.1 a side round a full-size head, before PETG's undersize - base_motor_mount's, the same `pocket_dia`, take the screws in hand on its print (the 48 mm motor, its pilot in the round hole, its MKS board, the M3 × 8 heads flush: the user's fit) | `lib/forearm/params.py MotorHoleParams`, `lib/cycloidal/params.py MotorParams` | the heads in each part's print, as on base_motor_mount's; if one will not drop in, widen `pocket_dia` (and the drive's), then Recipe C | 2026-11-08 (`git log --grep "fit gauges"`) |
| The MG996R's tab screws: the gripper base's holes stand `BaseParams.holes_x` apart (PapaBravo's export, 48.0), the datasheet's tab holes `MG996R_MOUNT_HOLE_SP` (49.5) | `lib/gripper/params.py BaseParams`, `lib/params.py MG996R_MOUNT_HOLE_SP` | calipers on the servo's tab holes (they are slots on most units); if the screws will not go in square, a `BaseParams` change (the measured part leaving its export) | 2026-11-08 (`git log --grep "fit gauges"`) |

## Estimates to confirm on the hardware (`[ESTIMATE]` in `lib/params.py` unless noted)
| value | where | how to confirm |
|---|---|---|
| The roll frame's back panel (`forearm_roll_back_panel`): its hold - 4 pairs of small N52 discs (`magnet_dia`: a pair pulls about a quarter of what a 6 mm pair would) glued in pockets (`magnet_*`, `pocket_dia` / `pocket_depth`), the upper pair's pockets ≈ 1.5 mm off the bay's bore, the side faces and the tower's facets -, its rim's `rim_clear` in the opening, its thinnest over the shaft's top edge (≈ 1.2 mm, the relief's `run_gap`); the magnets' stray field by an on-axis estimate: ≈ 0.1 mT at the roll motor's MKS encoder (constant - calibrate it with the panel on), ≈ 0.1 mT or less at the elbow motor's while the elbow is near its lower limit (≈ 0.03° at the elbow), ≈ 2 mT at 12 mm from a pair, ≈ 0.4 mT at the home sensor's chip (20.4 from the nearest pair) | `lib/forearm/params.py BackPanelParams`, `tests/forearm/test_roll_back_panel.py` | print the panel and the magnet pockets' gauge (`tools/export_gauges.py --only magnet`); the hold with the arm moving; the elbow's MKS position near its lower limit with the panel on and off |
| The wrist frame's back panel (`wrist_back_panel`): its hold - 4 pairs of small N52 discs (`magnet_dia`) glued in pockets (`magnet_*`, `pocket_dia` / `pocket_depth`) - with the gripper's moves, its rim's `rim_clear` in the bay's bore, the step's floor 1.43 mm wide between the bay and the board's window under its edge; the magnets' stray field by an on-axis estimate: ≈ 0.1 mT at the wrist roll's MKS encoder (the nearest pair ≈ 36 mm off it; constant - calibrate it with the panel on) | `lib/wrist/params.py WristBackPanelParams`, `tests/wrist/test_back_panel.py` | print the panel and the magnet pockets' gauge (`tools/export_gauges.py --only magnet`); the hold with the arm moving |
| The thrust bearing's fits in PETG: the seat ring `RING_CLEAR` a side inside the cage's and washers' bore, the coupler's recess `THRUST_CLEAR` round them; its masses (`THRUST_CAGE_MASS_G`, `THRUST_WASHER_MASS_G`: distributor listings) | `lib/base/params.py`, `lib/yaw_coupler/params.py`, `lib/bearings.py` | print the fit gauges first (`tools/export_gauges.py`); weigh them, then Recipe C step 7 |
| The turning shell's PETG fits: the motor plate's sleeve - about 4 mm over the motor's corners - with the motor-end 6814 pressed onto its last `out_width` (the hub's 70.3 grip), both 6814s in the shell's 90.15 seats, the held plates (the motor plate, the hub's flange) 1 a side inside the turning pin rings (`ShellParams.ring_bore_dia`), the ring pins' blind holes in both pin rings, the `j1_coupler` fork's motor leg round the sleeve (`ForkParams.ring_bore_dia`, 0.2 a side: its 3 radial M4s pull the sleeve across it) and its 2 M4 nuts in the disc's slots (`NUT_SLOT` over the nut), the sleeve's 3 M4 nuts pressed into its lugs (`ShellParams.sleeve_nut_af`, the hex-pocket press of the 6806 seats row; each pocket closed toward the sleeve's end by a 0.575 skin - the top layers over a 4 mm bridge with the plate printed on its inner face) | `lib/cycloidal/params.py ShellParams`, `lib/yaw_coupler/params.py ForkParams`, `lib/yaw_coupler/body.py` | print the fit gauges first (`tools/export_gauges.py`) |
| The `j1_coupler` fork's shapes: two legs 12 mm at the mounting area (`ShellParams.yoke_leg`), 20 at the root (the disc's flat facing each leg, on the draft `BASE_R` / `BASE_DRAFT`), each a round top on a post as wide (`ForkParams.plate_r`) growing out of the faceted disc in planar facets, carry the arm and the shoulder's reaction torque in PETG - the hub-side one through the hub's 4 M4s, the motor-side one, a separate ring round the sleeve, through its foot's 2 M4s into the disc and its 3 radial M4s into the sleeve (their heads flush in counterbores, 2 mm of the ring either side of them, `ForkParams.sleeve_counterbore_dia`) -, sized to fit and clear, not for stiffness or mass | `lib/yaw_coupler/params.py ForkParams`, `lib/yaw_coupler/body.py _fork` / `_root` | check them for flex on the print; thicken or rib them (both alike: `yoke_leg`; the sweep in `tests/test_sweeps.py` keeps the arm's range) |
| The upper arm rising off the turning shell is a placeholder: one flat solid slab (`ArmParams`: `width`, `end_r`, `layout.py slab_taper_x`) from its elbow half's underside up to the upper 6806's top (`ElbowParams.y0` / `relief_y`), out of the shell body's solid windows (`ShellParams.arm_windows`), the elbow motor's hole and the web across it, its gearbox's seat (`web_t`, `seat_*`, `motor_hole_half`), slid along N until its underside is flush with the shell's hub end (`arm_slide`) | `lib/upper_arm/params.py ArmParams`, `lib/upper_arm/link.py _slab` | shape it: hollow / rib it for mass, its root into the shell; its top under the roll frame's underside, its underside over the elbow belt and the 90T, flat and flush with the shell's hub end - the face it prints on (`tests/forearm/test_roll_drive.py`, `tests/test_mounts.py`, `tests/upper_arm/test_j1_link.py`) |
| `NEMA17_40_MASS_G` 280, `MKS_SERVO42D_MASS_G` 35, `CYCLOIDAL_MOTOR_MASS_G` 400 (`[DATASHEET]` class value), `PANCAKE_MASS_G` 180 | `lib/params.py` | weigh; then Recipe C step 7 (inertials) |
| The elbow gearbox (`eg17_g5_gearbox`, StepperOnline EG17-G5) as modelled from its datasheet drawing: the lengths it does not dimension, read off it at scale (`[ESTIMATE]`: the output flange / band split, the corner channels - square notches where the drawing ends them in a ramp -, the clamp's collar and access holes); the length of the 4 M3 it ships with for the motor (modelled M3 x 8, `J1_MOTOR_SCREW_LEN`: 3.3 into the motor); its mass, the listing's 14.9 oz (`EG17_G5_MASS_G`) | `lib/motors.py GearboxParams`, `lib/params.py J1_MOTOR_SCREW_LEN` | measure the unit (its key stays out: the 20T's set screw in the keyway); then Recipe C |
| The 40 mm kit motors' real shaft length (the export said 23; the model carries the drive's 22) and the 48 mm one's (datasheet 17HS19-2004S1: 24 ± 1 with a 15 mm D-cut; the drive assumes 22 / 18 by ruling — `reference/cycloidal/nema17_48mm.step`) | `lib/cycloidal/params.py MotorParams`, `tools/reference/split_mks_motor.py` | measure from the mounting face; a 24 mm shaft bottoms the eccentric shaft's D-bore (`d_bore_depth` 14 → 16) |
| Connector / cable direction of each mounted motor (the spin about its axis) - the wrist-pitch motor's is held sideways by its slide: toward the wall it would stop the motor short of the belt's centre distance, toward the wrist its plug's room comes within 5.3 mm of `wrist_link` before the wrist pitches (`tests/forearm/test_roll_end.py test_wrist_motor_plug_room_is_clear`) | `lib/mounts.py` frames, `note` fields | decide on the bench; change the `rz`, run `mount_placements.py`, Recipe C |
| The belts' `GT2_BELT_THICKNESS` / `GT2_BELT_MASS_G_PER_M`; an idler on a belt (the roll's riser land, `RollIdlerParams.land_w`; the elbow's and the base_yaw's printed spacers' lands, `ElbowIdlerParams.land_dia`, `YawIdlerParams.land_dia`; the wrist belt's rib under `j2_link`'s web, `IdlerParams.rib_w`): the land and the screw's head must bear on its bearing's inner ring only, or the idler is clamped still - the seller's drawing shows no bearing (a small washer under the head if it reaches the outer ring); each land, 7 wide round its M5's clearance, leaves 0.75 of wall - under the printability check's 0.8 (two beads of a 0.4 nozzle) on `yaw_idler_spacer`, `elbow_idler_spacer`, the roll frame's riser and `j2_link`'s rib | `lib/belts.py`, `lib/forearm/params.py RollIdlerParams` / `IdlerParams`, `lib/upper_arm/params.py ElbowIdlerParams`, `lib/base/params.py YawIdlerParams` | calipers and a scale on a belt; look at the idler in hand before the first print of its land / spacer |
| `BASE_YAW_LIMIT_DEG` and the shoulder's lower limit (the other limits are `[DESIGN]`, set by the sweeps or the printed hard stops: their own rows), the efforts and velocities (`ARM_JOINT_*`, `WRIST_EFFORT_NM`, `WRIST_VELOCITY_RAD_S`, `JAW_EFFORT_N`, `JAW_VELOCITY_M_S`), the axis signs | `lib/params.py`; the axis signs `robot/frames.py` | viewer sweeps + hardware; `robot/arm.urdf` follows via `derive.py --check` |
| `FOREARM_ROLL_LIMIT_DEG`, 2° short of the hard stop: the lug on the roll shaft's flange against the post on the frame's tower, in the bay behind bearing 1 - printed, straight-sided, `stop_deg_width` wide at their outer radius, 2.5 mm side by side -, which meet at ±168.3; `WRIST_ROLL_LIMIT_DEG` likewise, 2° short of the wrist roll's smaller lug and post in `wrist_link`'s bay (±168.66); `tests/test_sweeps.py` checks that each stop lies between its limit and 180° − `stop_deg_width` | `lib/params.py`, `lib/forearm/params.py stop_*`, `lib/wrist/params.py WristRollParams stop_*` | the overlap, the widths and the angle they meet at on the print; the lugs are small - a steel pin if PETG shears |
| 6806-2RS: mass 26 g (the 6808's 33 g, scaled by the ring area); the inner ring's outer edge against the Ø33 shoulders on the stubs and on the roll rotors' pieces, and the driven pulleys' Ø34.76 ring (all must bear on the inner ring only) | `lib/bearings.py` | datasheet / calipers on the bearing in hand |
| The 6806 seats in PETG: Ø42.2 (the base, `j1_link`'s lower seat, `j2_link`'s two), Ø42.15 (the forearm roll's and the wrist roll's towers), `j1_link`'s upper seat Ø42.0 (line-to-line); the Ø30 stubs and hubs in the inner rings (line-to-line); the M4 nuts' hex channels / pockets, 6.85 across flats for a 7.0 nut (the roll frame's, `j1_coupler`'s - the modelled nuts carry the press, `tests/test_mounts.py _press`) | `lib/base/params.py BoreParams`, `lib/upper_arm/params.py ElbowParams`, `lib/forearm/params.py WristBossParams` / `RollDriveParams nut_af`, `lib/coupler/params.py nut_af`, `lib/yaw_coupler/params.py HubParams nut_af` | print the fit gauges first (`tools/export_gauges.py`) |
| The vendor 20T's tooth-band centre 10.95 from its hub face (`t20_hub`) and the hub's seat over the motor's pilot boss (`pulley_seat`; the wrist roll's alike) | `lib/forearm/params.py RollDriveParams`, `lib/wrist/params.py WristRollParams` | the pulley slides on the motor shaft (set screw): align it with the ring on assembly |
| The roll rotor carries the forearm's bending moment across its 6806 pair, 19 mm apart centre to centre (`lip`, a 12 mm spacer; the 6808s it replaced were 57 mm apart): the bearings' play tilts the forearm more (≈ 0.05-0.25 mm at the gripper, estimated - half the 9 mm pair's); the rotor clamp's 4x M3 sit in 1.2 / 1.55 mm walls between the Ø18 bore and the Ø30.3 journals, 1.0 mm along the pulley's neck (`neck_dia`) - their shanks; the heads' counterbores `clamp_bore_wall` off the bore, which narrows over their depth -, the forearm wall's 4x M3 go into the pulley's core | `lib/forearm/params.py RollDriveParams clamp_*` / `RollEndParams screw_*` | check the play and the preload for creep on the print (re-tighten after a first run-in); a bigger bearing pair or a longer span if the forearm rocks |
| The roll rotors' nut pockets (the wrist roll's like the forearm's: its clamp's four in the shaft's flange, the gripper connector's four in the pulley's face, from its rim - `lib/wrist/layout.py clamp_nut_pocket` / `face_nut_pocket`): slots from the cable bore as wide as the nut's 5.5 across flats (line-to-line, no press), `end_nut_fit` / `nut_fit` 0.2 over and past the nut - the forearm wall's four in the pulley's core (a nut can drop into the bore when its screw is taken right out), the rotor clamp's four in the shaft's flange, open to its rear face; those four are modelled (`roll_clamp_nuts`, line-to-line in their slots), the others not (`tools/bom.py EXTRAS`) | `lib/forearm/params.py RollDriveParams end_nut*` / `clamp_nut`, `parts/joints/roll_clamp_nuts`, `lib/forearm/layout.py end_nut_pocket` / `clamp_nut_pocket`, `lib/wrist/params.py WristRollParams nut_fit` | print the fit gauges first (`tools/export_gauges.py`); narrow the slot to a press (like `JointParams.nut_pocket_af` / `RollDriveParams nut_af`: 0.15 under the nut's across flats) if the nuts will not stay put |
| The 90T flanges' M4 nuts, each in its frame past its own flange with 1 mm of PETG between the nut and the flange: the elbow's (`elbow_pulley_nuts`) in the roll frame's spigot, the hex 1.6 inside the spigot's flats; the wrist's (`wrist_pulley_nuts`) in `wrist_link`'s plate, 3 mm and more of it round each hex | `lib/forearm/params.py RollDriveParams.nut_seat_x` / `spigot_*`, `lib/wrist/params.py FlangeParams.nut_seat_z`; `tests/forearm/test_roll_drive.py test_stack`, `tests/wrist/test_wrist_link.py` | the first print: the nuts stay put as the screws tighten |
| The two 90T flanges are their own parts, each clamped to its frame by its 90T's 4 M4 and keyed by an octagon in a recess (printed to printed, 0.15 a side): the elbow's (`elbow_flange`) on the roll frame's 2 mm spigot, 32 across flats; the wrist's (`wrist_flange`) on `wrist_link`'s 1 mm key, 15 across flats inside the bolt circle - the joint's torque on the clamp's friction and the octagon's flats, the wrist's key small | `lib/forearm/params.py RollDriveParams spigot_*`, `lib/wrist/params.py FlangeParams key_*`; `tests/forearm/test_elbow_flange.py`, `tests/wrist/test_wrist_flange.py` | the first print: each flange slips onto its key without play or forcing (open or close `spigot_fit` / `key_fit`), and each joint holds its torque without creeping |
| The wrist 90T's screws are M4 × 33 - not an ISO 4762 length: bought as M4 × 35 and cut 2 mm (`pulley_screw_bought`) - and their tips end 0.65 mm over the pancake (the elbow's M4 × 35 end 3.4 under its pocket's floor) | `lib/wrist/params.py FlangeParams.pulley_screw_len` / `pulley_screw_bought`, `parts/joints/wrist_pulley_screws` | cut all four to 33 under the head, deburred, before assembly - a screw left long reaches the pancake |
| The roll frame's print orientation: only its spigot (`spigot_h`) stands off the underside - the elbow flange is its own part, printed on its stub's end -, its pocket and bay open on the opposite face, the bearing boss on the front face; front face down keeps the tower's bores vertical, on support under the front face and the spigot (the octagonal end rises off the bed at 45°: docs/forearm_roll.md §3) | `docs/forearm_roll.md` §3 | a printability check (`parts/AGENTS.md`) of `print/forearm_roll_block.stl` and `print/elbow_flange.stl`, then the first print |
| `wrist_link`'s print orientation: front face down, as the forearm roll's frame - the seats vertical bores, the facets at 45°, nothing round about the pitch axis left on it (the wrist flange its own part, printed on its stub's end; only the key, 1 mm, and the four M4 holes on the flange's side) | `docs/wrist_roll.md` §3 | a printability check (`parts/AGENTS.md`) of `print/wrist_link.stl` and `print/wrist_flange.stl`, then the 6806 seats' gauge (`tools/export_gauges.py --only seat42`) printed the same way |
| The base_yaw home switch's zone: where the KY-003 at the base turns on and off about `BASE_YAW_HOME_DEG` (-169.5) depends on its A3144's operate point (`A3144_OPERATE_MT`, 7 .. 35 mT across parts) and the magnet's field at the chip (the N52's real remanence; the gap, 3.48 to the hall element, with `A3144_HALL_DEPTH` an estimate and the 120T's axial play - the base_yaw stack row under Fit problems), and where the magnet is glued: nothing locates it on the 120T's face, and 1 mm off along its circle moves home 2.1° (`YAW_MAGNET_R` 27). By the model the zone's half width is 8.5 .. 12.8°: it runs 2.7° or more past the -175° end and stops 2.7° or more short of the +175° end, 10° on round the circle - `BASE_YAW_LIMIT_DEG` itself an estimate | `lib/sensors.py switch_half_width`, `lib/pulley/params.py YAW_MAGNET_DEG`, `tests/base/test_yaw_home.py` | glue the magnet with a mark or a jig on its spot; turn base_yaw slowly through the switch both ways and note where it turns on and off; if the zone stops short of -175 or reaches +175, move the magnet (`YAW_MAGNET_DEG`) or trim the limit |
| The shoulder_pitch home switch's zone: where the KY-003 in j1_coupler's pocket turns on and off about `SHOULDER_PITCH_HOME_DEG` (-118) depends on its A3144's operate point (`A3144_OPERATE_MT`) and the magnet's field at the chip (the N52's real remanence; the gap, 2.0 to the hall element, with `A3144_HALL_DEPTH` an estimate and the drive's play), and where the magnet is glued: only the pillar's face (about 8.8 wide) locates it, and 1 mm off along it moves home 0.87°. By the model the zone's half width is 3.5 .. 4.4°: it runs 1.5° or more past the -120° end - more than the ±1.2° the magnet can sit off its mark -, the lower limit itself an estimate (`SHOULDER_PITCH_LIMITS_DEG`). The tray's fit in the pocket (`HomeTrayParams.wall_clear` 0.4 a side, PETG) sets the chip's place: it drops in over the 120T's M4 tips and sits on the pocket's floor | `lib/sensors.py switch_half_width`, `lib/yaw_coupler/params.py HomeTrayParams`, `tests/base/test_shoulder_home.py` | glue the magnet centred on the pillar's face (a mark or a jig); drop the tray in and check it sits flat and firm (a dab of glue against rattling); turn shoulder_pitch slowly through the switch both ways and note where it turns on and off; if the zone stops short of -120, move the magnet or `home_deg` |
| The elbow_pitch home switch's zone: where the KY-003 on its clip turns on and off about `ELBOW_PITCH_HOME_DEG` (-41) depends on its A3144's operate point (`A3144_OPERATE_MT`) and the magnet's field at the chip (the N52's real remanence; the gap, 2.0 to the hall element, with `A3144_HALL_DEPTH` an estimate, the clip's fit on the slab's end and the elbow's bearing play), and where the magnet is glued: nothing on the 90T's outer face locates it, and 1 mm off its mark round the axis moves home 2.4°. By the model the zone's half width is 9.1 .. 11.3°: it runs 3.1° or more past the -47° end - more than the ±2.4° of a magnet 1 mm off -; homing stops at -31.9 .. -29.7°. The clip's place along the end flat sets the chip's: it slides along the flat until glued (`ElbowHomeParams.chip_x` / `chip_z`, `width`) | `lib/sensors.py switch_half_width`, `lib/upper_arm/params.py ElbowHomeParams`, `tests/upper_arm/test_elbow_home.py` | mark the magnet's place on the 90T's face (a paper template off its bolt holes) and glue it there; push the clip on centred on the end flat and glue it; turn elbow_pitch slowly through the switch both ways and note where it turns on and off; if the zone stops short of -47, move the magnet or `home_deg` |
| The wrist_pitch home switch's zone: where the KY-003 on its clip turns on and off about `WRIST_PITCH_HOME_DEG` (-144) depends on its A3144's operate point (`A3144_OPERATE_MT`) and the magnet's field at the chip (the N52's real remanence; the gap, 2.0 to the hall element, with `A3144_HALL_DEPTH` an estimate, the clip's fit round the wrist boss's end and the wrist's bearing play), and where the magnet is glued: nothing on the 90T's outer face locates it, and 1 mm off its mark round the axis moves home 2.4°. By the model the zone's half width is 9.1 .. 11.3°: it runs 3.1° or more past the -150° end - more than the ±2.4° of a magnet 1 mm off -; homing stops at -134.9 .. -132.7°. The clip sits on the boss's end flats and its jaw under the boss, `gap` (0.2) round them until glued | `lib/sensors.py switch_half_width`, `lib/forearm/params.py WristHomeParams`, `tests/forearm/test_wrist_home.py` | mark the magnet's place on the 90T's face (a paper template off its bolt holes) and glue it there; push the clip on round the boss's end, its jaw up under the boss, and glue it; turn wrist_pitch slowly through the switch both ways and note where it turns on and off; if the zone stops short of -150, move the magnet or `home_deg` |
| The forearm_roll home switch's zone: where the KY-003 behind the roll shaft turns on and off about `FOREARM_ROLL_HOME_DEG` (-160) depends on its A3144's operate point (`A3144_OPERATE_MT`) and the magnet's field at the chip (the N52's real remanence; the gap, 2.5 to the hall element - `air` 2.0, held by the board's header -, with `A3144_HALL_DEPTH` an estimate and the shaft's axial play), and where the chip sits: the carrier on its tube in the wire hole (`wire_fit` round it) and under the panel's rim (`key_gap`), 0.3 off its place moving home 1.1°; the magnet's pocket locates it. By the model the zone's half width is 15.2 .. 20.1°: it runs 9.2° or more past the -166° end; homing stops at -144.8 .. -139.9°; the field at the chip, 170 mT, is 4.9x the highest operate point (the clipped sensors' 5x at 2.0) | `lib/sensors.py switch_half_width`, `lib/forearm/params.py RollHomeParams`, `tests/forearm/test_roll_home.py` | press the magnet in south pole out (the module's LED lights); drop the carrier in, its tube in the hole, and close the panel; turn forearm_roll slowly through the switch both ways and note where it turns on and off; if the zone stops short of -166, move `home_deg` |
| The KY-003 hall module's size (board, mounting holes, where the chip sits on its leads, the header's pins and tails) and mass - the listings' board size and overall envelope, the photo, `[ESTIMATE]`; the A3144's leads and hall-element depth | `lib/sensors.py` | calipers and a scale on a module in hand; then `./cadtool python tools/reference/import_native.py --only ky003_hall_sensor --force` and `./cadtool gen parts/joints/ky003_hall_sensor.py` |
| The roll rotors' journals (the pulleys' and the shafts' hubs, both drives): +0.3 mm interference in the 6806 inner rings (PETG, like the drive's; the towers' seats: the 6806 seats row) | `lib/forearm/params.py RollDriveParams` / `lib/wrist/params.py WristRollParams` `journal_add` | print the fit gauges first (`tools/export_gauges.py`) |
| The base motor mount's joint in PETG: the M4 nuts' hex pockets in the base's posts (`nut_pocket_af`, a press so the nuts stay when the mount is off - the modelled nuts carry it, `tests/test_mounts.py`), the M4 clearance holes along X through both parts' posts (printed on their side), the posts' faces flat enough to close under 4 bolts; the heads inside the mount, turned along -X from underneath with the base off the table - a ball-end key's room past the posts to confirm on the print | `lib/base/params.py JointParams`, `MountParams` | print the fit gauges first (`tools/export_gauges.py`); the joint on the first print |
| The base prints bottom down (on its foot: ~155 x 200 on the bed, the chamfer and the leaning walls widen downward - no overhang) with supports under its cap and the plate's neck (its motor mount is printed: the motor, its board and screws fit) | `lib/base/body.py`, `lib/base/params.py FootParams` | a printability check (`parts/AGENTS.md`) of `print/base.stl`, then the first print |
| `j1_link` prints on its hub-end face - the shell's end, the slab's underside and the web under the elbow motor's gearbox flush, one plane - turned 45° on a 256 bed (it is longer than the bed's side; ~220 square at 45°), without support: over open air only short bridges - the housing nuts' and the gearbox screws' pocket roofs, the elbow seat's lip ring (the elbow idler's nut slot opens upward, its spacer is a part of its own) (~1230 mm² facing down below 45° in a printability check of the build, the orientation `rot_plus_90_x`) | `lib/upper_arm/params.py ArmParams`, `lib/upper_arm/layout.py arm_slide`, `parts/base/j1_link.py` | the first print |
| The gripper's pinion holds on the MG996R's spline by a press fit (its Ø5.7 bore, no teeth: the spline cuts its own) and the servo's horn screw, as PapaBravo builds it - some builders report it slipping (his answer: the tight side of the bore onto the spline) | `lib/gripper/params.py PinionParams` (`spline_r`) | grip a load at the servo's full torque; if it slips, a pinion with the spline modelled in its bore (a test print first) - a horn under it needs the base's posts 4.3 taller |
| The jaws' drive: the racks' pitch (3.31) is coarser than the pinion's (π × 1.02 = 3.20) - they mesh with backlash at every travel `tests/gripper/test_module.py` checks -, so the rack sets the ratio: 0.257 mm of the jaws' gap per servo degree, their 2 .. 44 mm over 163° of the MG996R's travel (its range: the unit's) | `lib/gripper/params.py RackParams` / `PinionParams`, `JAW_TRAVEL_MM` | drive the servo end to end on the printed gripper: its range, and where the jaws close |
| The walls the printability check (`parts/AGENTS.md`) finds under its 0.8 (two beads of a 0.4 mm nozzle) that a 0.4 nozzle usually still prints: the GT2 teeth of the printed pulleys (`gt2_pulley_120t`, `gt2_pulley_90t`, both roll pulleys' rings: 0.74 .. 0.79, the tooth profile's own); the gripper's measured parts as PapaBravo exported them - `gripper_rack` 0.35 (each post's M3 hole, `RackParams.hole_r`, by the rack's side face) and 0.53 (its counterbore), `gripper_base` 0.65, `gripper_jaw` 0.6, `gripper_pinion`'s teeth 0.74; `wrist_flange`'s 0.3 skin lying in the layer plane as modelled (1.5 layers at 0.2); the knife edges (tips that print rounded) on `base`, `cycloidal_eccentric_shaft`, `gripper_base`, `gripper_cage`, `gripper_j3_connector` and `wrist_back_panel`; and the cycloidal discs, whose self-intersections the check tested only in part (their spline faces) | the check's own figures: `./cadtool cad step dfm parts/<group>/<name>.step --process printing --json`; the gripper's numbers `lib/gripper/params.py` | a test print of each - the slicer's preview shows a wall it drops (and the discs' self-intersections); thicken where it does |

## Not modelled yet
| item | note |
|---|---|
| The arm's own fasteners that are neither parts (the modelled ones: `parts.names()`) nor `tools/bom.py EXTRAS` rows yet, e.g. the electronics (CAN adapter, wiring) | not in `tools/bom.py EXTRAS` yet |
| The base's foot screws: 6 x M5 (or 5 mm wood screws) with washers down through `FootParams`' holes into the desk or a baseboard (the spot-faces take a Ø10 washer) | not in `tools/bom.py EXTRAS`: their kind and length depend on the surface |
| The design language's covers (`docs/design_language.md` "Belts are covered"): the four belt covers / lids on their magnets - the upper arm's, the forearm's, the base's and the roll frame's open face | `docs/design_language.md` "Where it stands" |
| Simplified collision primitives in the URDF (visual meshes are reused for collision) | `robot/arm.urdf` TODO |
| The joints' **home sensors**: base_yaw's is placed (`lib/base/params.py YawHomeParams`; its switch's zone under Estimates, its wiring the next row), shoulder_pitch's too (`lib/yaw_coupler/params.py HomeTrayParams`: the KY-003 on a printed tray dropped into j1_coupler's pocket under the drive's turning shell, the magnet glued on a pillar of the shell - the gap beside it 4.5 or more, so no pocket; the tray held by its fit in the pocket, not screwed, the user's choice; its zone under Estimates, its wiring two rows down), elbow_pitch's too (`lib/upper_arm/params.py ElbowHomeParams`: the KY-003 on a printed clip over the upper arm's slab end, outside the elbow belt, under the elbow 90T's outer face, a Ø6 x 2 magnet glued on that face, not in a pocket though the gap beside it (1.5 to the chip) is under its thickness - the user's choice, as base_yaw's; the clip held by its fit and glue, not screwed, the user's choice - nothing on the arm changes -, printed on its side with teardrop M2 holes, the user's choice; its zone under Estimates, its wiring three rows down), wrist_pitch's too (`lib/forearm/params.py WristHomeParams`: the elbow's clip on the forearm's wrist end - the KY-003 on a printed clip round the wrist boss's faceted end, its jaw under the boss and no top arm (the wrist frame turns 2 over the boss), under the wrist 90T's outer face, a Ø6 x 2 magnet glued on that face (1.5 to the chip), the clip held by its fit and glue - glue only, the user's choice -, nothing on the forearm changes; homing at the lower end, the user's choice; its zone under Estimates, its wiring four rows down), forearm_roll's too (`lib/forearm/params.py RollHomeParams`: the KY-003 behind the roll shaft in the frame's bay, under the back panel - nothing shows -, on a printed carrier down the panel's opening's floor: its tube in the frame's wire hole locates it and takes its lead, the panel's rim in its notch keeps it there, no screw into the frame - the user's choice (B3 of six previews) -; a Ø6 x 3 magnet pressed flush into the shaft's rear face in line with the stop lug (the lug, `stop_deg_width` wide, takes no Ø6), the chip `air` behind the shaft - the board's header stands 1.02 over the chip -; its zone under Estimates, its wiring five rows down), the wrist roll's not - each joint's endstop is designed on its own, one joint at a time, from the user's direction for it - no layout for all of them at once. What holds at every joint: the whole KY-003 module fits (its board and chip, never a bare A3144 on its leads), on a separate bolt-on bracket - a plain plate holding the board by its own two holes (`lib/sensors.py KY003_HOLE_DIA`) with M2 -, the bracket fixed with M3 into a captive nut where a nut can be reached, a heat-set insert elsewhere; the magnet in a pocket where the running gap beside it is under its thickness (south pole toward the chip's branded face: the A3144 is unipolar) - base_yaw's is glued onto the 120T's face instead, the user's choice, the sensor lowered so the gaps stay the pocket's; the user sees a posable model of it first (`cad/AGENTS.md` Design choices) | `parts/joints/ky003_hall_sensor` (base_yaw's: `ky003_hall_sensor#1`, `tests/base/test_yaw_home.py`; the forearm roll's: `tests/forearm/test_roll_home.py`); the wrist roll's row below |
| The base_yaw home sensor's **wiring**: the KY-003's 3-pin Dupont plug on its header, toward -X under the belt (`tests/base/test_yaw_home.py PLUG_LEN`, 14 `[ESTIMATE]`: its room is checked), and its cable to the base_yaw MKS board's limit input under the motor mount (through the window between the joint's posts) | nothing of the cable is modelled; the board's limit input: IN1, pin 3 of its 5-pin CAN plug (the KY-003 bench-tested on it at 5 V) |
| The shoulder_pitch home sensor's **wiring**: the KY-003's plug on its header at the tray's back end, the cable up over the pocket's back wall and across j1_coupler's raised face behind the pocket (the drive's pillars pass 10 mm or more over it there - nearer the middle only 2.68: it must lie flat and stay at the back), then round to the shoulder MKS board's limit input at the motor end, about 20 cm; tied down, clear of the turning shell; the plug's room on the header in the pocket | nothing of the cable or the plug is modelled; the board's limit input: IN1, pin 3 of its 5-pin CAN plug (the KY-003 bench-tested on it at 5 V) |
| The elbow_pitch home sensor's **wiring**: the KY-003's plug on its header at the board's far end (toward the link's +z, under the belt's run, about 4 mm off it), the cable along the slab's underside or up its side, past the elbow gearbox to the elbow MKS board's limit input on top of the elbow motor, about 15 cm; tied down clear of the belt, the 90T and the roll frame (which turns over the slab's top) | nothing of the cable or the plug is modelled; the board's limit input: IN1, pin 3 of its 5-pin CAN plug (the KY-003 bench-tested on it at 5 V) |
| The wrist_pitch home sensor's **wiring**: the KY-003's plug on its header at the board's far end (toward j2_link's +y, under the 90T's rim: a 3-pin Dupont housing there sits 2.5 under the 90T's outer face and 4.2 under the belt's run; the magnet never comes round to that side over the travel), the cable along the forearm under the belt's run and up beside the web to the wrist MKS board's limit input on top of the wrist motor, about 20 cm; tied down clear of the belt, its idler and the 90T | nothing of the cable or the plug is modelled; the board's limit input: IN1, pin 3 of its 5-pin CAN plug (the KY-003 bench-tested on it at 5 V) |
| The forearm_roll home sensor's **wiring**: the KY-003's plug on its header at the board's +X end, in the bay behind the shaft; its lead down to the carrier and through its tube and the frame's wire hole (`RollHomeParams.wire_end`) into the motor's pocket behind the MKS board's cover - the pocket's slide room, 2.5 deep: a flat lead, threaded down after the motor is in -, on down to the board's plugs at the pocket's open bottom, about 15 cm; the plug's room in the bay (the panel is 3.6 or more off the board) | nothing of the cable or the plug is modelled; the board's limit input: IN1, pin 3 of its 5-pin CAN plug (the KY-003 bench-tested on it at 5 V) |
| The base_yaw motor's cables out of the base: they leave the motor mount into the base through the window between its posts (`lib/base/body.py _posts`), but the base has no way out for them (LEGACY's cable notch is in the +X lobe that DEFAULT cuts off at `JointParams.split_x`) | decide where (a notch through the foot's flange and chamfer - between its screw holes - or a side wall), then add it to `build_base` |
| The wrist roll's cable route and home sensor: the gripper servo's cable through the connector's and the rotor's Ø10 bore, out of `wrist_link`'s bay through the back panel's notch and into the MKS board's window (`WristBackPanelParams.notch_*`), with the pancake's cables - so it crosses the wrist pitch joint near its axis -, on along the forearm; its bend round the panel's edge and its strain relief; whether its plug passes the bore; no home sensor (the home sensors' row) - the forearm roll's way (a KY-003 behind the shaft, `RollHomeParams`) does not fit: the bay is Ø45.4, its middle carries the gripper servo's cable and either side is too small for the board | the bore is `WristRollParams.bore`; nothing of the route or a sensor is modelled |
| The roll drive's cable route: the forearm's cables do not pass through the shaft's bay - the back panel (`forearm_roll_back_panel`) closes it and nothing passes through the panel -, so their way from the forearm past the roll joint and the elbow to the upper arm is open (the rotor's Ø18 bore and the forearm wall's Ø24 round it stay as they are); the roll motor board's cables leave through the frame's open bottom, which the elbow motor's gearbox and motor pass 11.8 mm off between elbow +60 and +90 deg (its board, further out along N, 17.5 or more: tie them flat along the frame, toward its side face); a way for every cable beyond the roll (the wrist motors' CAN and power, the gripper servo, the home sensor) that lets the forearm turn ±`FOREARM_ROLL_LIMIT_DEG` | nothing of the route is modelled; the bore is `RollDriveParams.bore`, the opening `motor_pocket`, the panel `BackPanelParams` |
| The roll motor board's two side plugs face the roll frame's walls: each cable bends straight down at its plug into a groove, leaving `side_plug_room` (8.5 mm) of straight room - short of the measured `MKS_PLUG_ROOM` (10 mm straight out); not checked with the real plugs bent that way | `lib/forearm/layout.py side_plug_room`, `RollDriveParams plug_skin`, `tests/test_sweeps.py _plug_rooms`; closes: fit the plugs with their cables bent down, deepen the grooves (thinner `plug_skin`) if they need more |
| The wrist roll belt has no tensioner (`cad/AGENTS.md` "Belts"; the other belts' are designed): the pancake's slots tension it (`WristRollParams.pad_slot_len`, `WRIST_ROLL_BELT_LENGTH`); the forearm roll's idler kit (its M5 nut in a channel under the frame's face) finds no room on `wrist_link` - every place on the belt's back puts the channel into the tower's seats, the pancake's screws or its pilot slot; the GT2 idler's `MASS_G` (`gt2_idler_20t`) is an estimate (weigh one) | another mount for the idler (an arm off the frame's open face, or the nut in the plate's rear face behind the pancake), then the loop round it (`lib/belts.py idler_on_run`), its centre distance a design value |

## Not confirmed
| item | where |
|---|---|
| Whether the elbow belt and its 20T carry what the gearbox puts on them: the 20T is on the gearbox's output now, so the motor's holding torque reaches it 5:1 up - about 1.9 N·m (0.4 × `EG17_G5.ratio` × 96 %), some 300 N in the belt's tight strand on the 20T's pitch circle, where the motor alone put 0.4 N·m on it - unchecked against the 6 mm GT2 belt's and a 20T's rated load; if short, a wider belt and pulleys, or the MKS board's current limited | `lib/params.py ELBOW_RATIO`, `parts/joints/elbow_belt.py`, `parts/joints/gt2_pulley_20t_8mm.py` |
| Whether the shoulder's torque suffices: `CYCLOIDAL_RATIO` × the 48 mm NEMA 17 gives 5.2–6.1 N·m practical (`docs/cycloidal_drive.md` §7), short of what the arm stretched out horizontally weighs on the shoulder; a balance spring, a NEMA 23 or a higher ratio if it is short | `lib/params.py CYCLOIDAL_RATIO`, `ARM_JOINT_EFFORT_NM`, `docs/cycloidal_drive.md` §7 |
| Which CAN id drives which joint: `software/control/src/config.py` J1..J3 name fewer MKS boards than the arm carries (base_yaw, shoulder_pitch, elbow_pitch, forearm_roll, wrist_pitch, wrist_roll), and its gear ratios are still 1.0, not the reciprocals of the CAD's reductions (`robot/AGENTS.md`) - the control side is out of the CAD's scope | `software/control/README.md` Hardware / Configure your motors, `robot/arm.urdf` ledger, `robot/frames.py` joint notes |
| The wrist-roll pancake motor's exact model | `parts/wrist/nema17_pancake.py PURCHASE_NOTE` |
| Link-membership assumptions (the 90T pulleys with the driven links - the elbow's with the roll drive's stator in `elbow_link`, the wrist's with `wrist_link` in `wrist_pitch_link` -, the gripper's pinion merged into `wrist_roll_link`: it turns, driving the jaws) | `robot/frames.py LINKS` [ASSUMPTION] comments, the URDF ledger |
| The arm's kinematics carry an elbow and a wrist offset: the forearm_roll axis runs `ELBOW_ROLL_OFFSET` across the elbow axis, not through it, and the wrist_roll axis `WRIST_ROLL_OFFSET` across the wrist_pitch axis (`WRIST_ROLL_AXIS_H` over the wrist plate) - the last three axes are not concurrent, the wrist is not spherical: an IK in `software/control` must be numeric, from `robot/arm.urdf`'s joint origins (`docs/wrist_roll.md`) | `robot/frames.py FOREARM_ROLL_ORIGIN` / `WRIST_ROLL_ORIGIN`, `robot/arm.urdf` |
| The joint limits keep the gripper off the arm only with the elbow folded up to `ELBOW_GRIPPER_FREE_DEG` (shoulder level): past it, within the elbow's range, the wrist bent down (to `WRIST_PITCH_LIMITS_DEG`'s lower) or the forearm rolled can put the gripper into the upper arm (`j1_link`, first with the wrist at its lower limit and the forearm at 0) or the shoulder - the elbow's range is set by the arm's own parts instead (the user's choice: the elbow's range over the other joints'); a planner in `software/control` keeps those poses out (the arm's own collision model), the shoulder pitched down in front included | `lib/params.py ELBOW_GRIPPER_FREE_DEG`, `tests/test_sweeps.py` (`test_the_elbow_limits_keep_the_forearm_and_the_wrist_off_the_upper_arm`) |
| The joint limits keep the arm off itself, not off the table the base stands on: inside them the arm reaches below the base's bottom face - pitched down in front with the elbow out, and pitched back to the shoulder's lower limit with the forearm lifted back (behind the base) - and the sweep tests skip those poses; a planner in `software/control` needs the table as a floor | `tests/test_sweeps.py` (`_in_table`), `lib/datum.py BASE_BOTTOM_Y` |

## Known-broken / pending
| item | where |
|---|---|
| The motor-control `software/control/tests/` imports `arctos.*` and does not run | `software/control/AGENTS.md` "Known issues" |
| The printability check judges a part standing as modelled - its STEP and its `print/<name>.stl` are in the part's frame -, not as it prints: for every printed part its walls, holes, soundness and fit on the bed are checked (the rows above), but the overhangs, bridges and support of the parts that print another way up (the print-orientation rows under Estimates) are not; `--candidates` ranks only the axis-aligned and face-down orientations | `parts/AGENTS.md` Printability; closes: each such part checked turned to its print orientation (a scratch STEP), or its orientation declared with the part |
