hbenuid/robotic-arm/cad/robot/arm.sdf

<?xml version="1.0"?>
<!-- DRAFT generated by tools/robot/derive.py; derived mechanically from robot/arm.urdf's
     numbers (same links, joints, limits, inertials, meshes). robot/arm.sdf is canonical. -->
<sdf version="1.12">
  <model name="arm">
    <link name="base_link">
      <pose>0 0 0 0 0 0</pose>
      <inertial>
        <pose>-0.062879 0.000225 0.04426 0 0 0</pose>
        <mass>1.498325</mass>
        <inertia>
          <ixx>4.384187e-03</ixx><ixy>-1.087423e-05</ixy><ixz>-7.495208e-04</ixz>
          <iyy>9.153830e-03</iyy><iyz>-6.114772e-06</iyz><izz>1.055468e-02</izz>
        </inertia>
      </inertial>
      <visual name="base_link_visual">
        <geometry>
          <mesh>
            <uri>meshes/base_link.stl</uri>
            <scale>0.001 0.001 0.001</scale>
          </mesh>
        </geometry>
      </visual>
      <collision name="base_link_collision">
        <geometry>
          <mesh>
            <uri>meshes/base_link.stl</uri>
            <scale>0.001 0.001 0.001</scale>
          </mesh>
        </geometry>
      </collision>
    </link>
    <link name="shoulder_link">
      <pose relative_to="base_yaw">0 0 0 0 0 0</pose>
      <inertial>
        <pose>0.00021 0.012608 -0.022772 0 0 0</pose>
        <mass>1.508342</mass>
        <inertia>
          <ixx>4.212828e-03</ixx><ixy>-2.442926e-06</ixy><ixz>-2.531679e-06</ixz>
          <iyy>3.105327e-03</iyy><iyz>-4.226438e-04</iyz><izz>2.474634e-03</izz>
        </inertia>
      </inertial>
      <visual name="shoulder_link_visual">
        <geometry>
          <mesh>
            <uri>meshes/shoulder_link.stl</uri>
            <scale>0.001 0.001 0.001</scale>
          </mesh>
        </geometry>
      </visual>
      <collision name="shoulder_link_collision">
        <geometry>
          <mesh>
            <uri>meshes/shoulder_link.stl</uri>
            <scale>0.001 0.001 0.001</scale>
          </mesh>
        </geometry>
      </collision>
    </link>
    <link name="upper_arm_link">
      <pose relative_to="shoulder_pitch">0 0 0 0 0 0</pose>
      <inertial>
        <pose>0.065245 -0.000016 0.047494 0 0 0</pose>
        <mass>1.654286</mass>
        <inertia>
          <ixx>2.611034e-03</ixx><ixy>-3.055985e-06</ixy><ixz>9.666923e-05</ixz>
          <iyy>7.221790e-03</iyy><iyz>-3.161286e-06</iyz><izz>6.530447e-03</izz>
        </inertia>
      </inertial>
      <visual name="upper_arm_link_visual">
        <geometry>
          <mesh>
            <uri>meshes/upper_arm_link.stl</uri>
            <scale>0.001 0.001 0.001</scale>
          </mesh>
        </geometry>
      </visual>
      <collision name="upper_arm_link_collision">
        <geometry>
          <mesh>
            <uri>meshes/upper_arm_link.stl</uri>
            <scale>0.001 0.001 0.001</scale>
          </mesh>
        </geometry>
      </collision>
    </link>
    <link name="elbow_link">
      <pose relative_to="elbow_pitch">0 0 0 0 0 0</pose>
      <inertial>
        <pose>0.005712 -0.017821 0.015719 0 0 0</pose>
        <mass>0.772915</mass>
        <inertia>
          <ixx>1.109545e-03</ixx><ixy>1.382076e-04</ixy><ixz>-1.910292e-05</ixz>
          <iyy>6.197567e-04</iyy><iyz>5.798751e-05</iyz><izz>1.048475e-03</izz>
        </inertia>
      </inertial>
      <visual name="elbow_link_visual">
        <geometry>
          <mesh>
            <uri>meshes/elbow_link.stl</uri>
            <scale>0.001 0.001 0.001</scale>
          </mesh>
        </geometry>
      </visual>
      <collision name="elbow_link_collision">
        <geometry>
          <mesh>
            <uri>meshes/elbow_link.stl</uri>
            <scale>0.001 0.001 0.001</scale>
          </mesh>
        </geometry>
      </collision>
    </link>
  <link name="forearm_link">
      <pose relative_to="forearm_roll">0 0 0 0 0 0</pose>
      <inertial>
        <pose>0.006516 -0.00006 0.095647 0 0 0</pose>
        <mass>0.619471</mass>
        <inertia>
          <ixx>1.280157e-03</ixx><ixy>3.619355e-06</ixy><ixz>-2.164067e-04</ixz>
          <iyy>1.343771e-03</iyy><iyz>2.096843e-06</iyz><izz>3.165451e-04</izz>
        </inertia>
      </inertial>
      <visual name="forearm_link_visual">
        <geometry>
          <mesh>
            <uri>meshes/forearm_link.stl</uri>
            <scale>0.001 0.001 0.001</scale>
          </mesh>
        </geometry>
      </visual>
      <collision name="forearm_link_collision">
        <geometry>
          <mesh>
            <uri>meshes/forearm_link.stl</uri>
            <scale>0.001 0.001 0.001</scale>
          </mesh>
        </geometry>
      </collision>
    </link>
    <link name="wrist_pitch_link">
      <pose relative_to="wrist_pitch">0 0 0 0 0 0</pose>
      <inertial>
        <pose>0.000345 0.012229 0.007438 0 0 0</pose>
        <mass>0.431247</mass>
        <inertia>
          <ixx>4.863874e-04</ixx><ixy>-2.265337e-05</ixy><ixz>-9.578146e-08</ixz>
          <iyy>2.478138e-04</iyy><iyz>-3.443378e-05</iyz><izz>3.380813e-04</izz>
        </inertia>
      </inertial>
      <visual name="wrist_pitch_link_visual">
        <geometry>
          <mesh>
            <uri>meshes/wrist_pitch_link.stl</uri>
            <scale>0.001 0.001 0.001</scale>
          </mesh>
        </geometry>
      </visual>
      <collision name="wrist_pitch_link_collision">
        <geometry>
          <mesh>
            <uri>meshes/wrist_pitch_link.stl</uri>
            <scale>0.001 0.001 0.001</scale>
          </mesh>
        </geometry>
      </collision>
    </link>
    <link name="wrist_roll_link">
      <pose relative_to="wrist_roll">0 0 0 0 0 0</pose>
      <inertial>
        <pose>0.005287 -0.00002 0.03095 0 0 0</pose>
        <mass>0.134864</mass>
        <inertia>
          <ixx>1.268950e-04</ixx><ixy>-1.721731e-08</ixy><ixz>-8.412591e-06</ixz>
          <iyy>1.476959e-04</iyy><iyz>-1.091387e-07</iyz><izz>3.843252e-05</izz>
        </inertia>
      </inertial>
      <visual name="wrist_roll_link_visual">
        <geometry>
          <mesh>
            <uri>meshes/wrist_roll_link.stl</uri>
            <scale>0.001 0.001 0.001</scale>
          </mesh>
        </geometry>
      </visual>
      <collision name="wrist_roll_link_collision">
        <geometry>
          <mesh>
            <uri>meshes/wrist_roll_link.stl</uri>
            <scale>0.001 0.001 0.001</scale>
          </mesh>
        </geometry>
      </collision>
    </link>
    <link name="jaw_a_link">
      <pose relative_to="jaw_a">0 0 0 0 0 0</pose>
      <inertial>
        <pose>0.016949 -0.005644 0.009049 0 0 0</pose>
        <mass>0.010942</mass>
        <inertia>
          <ixx>2.710300e-06</ixx><ixy>-6.545706e-07</ixy><ixz>-8.155029e-07</ixz>
          <iyy>4.370291e-06</iyy><iyz>-5.523855e-07</iyz><izz>2.622026e-06</izz>
        </inertia>
      </inertial>
      <visual name="jaw_a_link_visual">
        <geometry>
          <mesh>
            <uri>meshes/jaw_a_link.stl</uri>
            <scale>0.001 0.001 0.001</scale>
          </mesh>
        </geometry>
      </visual>
      <collision name="jaw_a_link_collision">
        <geometry>
          <mesh>
            <uri>meshes/jaw_a_link.stl</uri>
            <scale>0.001 0.001 0.001</scale>
          </mesh>
        </geometry>
      </collision>
    </link>
    <link name="jaw_b_link">
      <pose relative_to="jaw_b">0 0 0 0 0 0</pose>
      <inertial>
        <pose>0.016949 0.005644 -0.009049 0 0 0</pose>
        <mass>0.010942</mass>
        <inertia>
          <ixx>2.710300e-06</ixx><ixy>6.545706e-07</ixy><ixz>8.155028e-07</ixz>
          <iyy>4.370291e-06</iyy><iyz>-5.523856e-07</iyz><izz>2.622026e-06</izz>
        </inertia>
      </inertial>
      <visual name="jaw_b_link_visual">
        <geometry>
          <mesh>
            <uri>meshes/jaw_b_link.stl</uri>
            <scale>0.001 0.001 0.001</scale>
          </mesh>
        </geometry>
      </visual>
      <collision name="jaw_b_link_collision">
        <geometry>
          <mesh>
            <uri>meshes/jaw_b_link.stl</uri>
            <scale>0.001 0.001 0.001</scale>
          </mesh>
        </geometry>
      </collision>
    </link>
    <link name="tool0">
      <pose relative_to="tool0_joint">0 0 0 0 0 0</pose>
    </link>
    <joint name="base_yaw" type="revolute">
      <pose relative_to="base_link">0 0 0.19051 0 0 0</pose>
      <parent>base_link</parent>
      <child>shoulder_link</child>
      <axis>
        <xyz expressed_in="base_yaw">0 0 1</xyz>
        <limit>
          <lower>-3.054326</lower><upper>3.054326</upper>
          <effort>5</effort><velocity>1</velocity>
        </limit>
      </axis>
    </joint>
    <joint name="shoulder_pitch" type="revolute">
      <pose relative_to="shoulder_link">0.000186 -0.0425 0 -1.570796 -0.830504 0.000003</pose>
      <parent>shoulder_link</parent>
      <child>upper_arm_link</child>
      <axis>
        <xyz expressed_in="shoulder_pitch">0 0 1</xyz>
        <limit>
          <lower>-2.094395</lower><upper>1.169371</upper>
          <effort>5</effort><velocity>1</velocity>
        </limit>
      </axis>
    </joint>
    <joint name="elbow_pitch" type="revolute">
      <pose relative_to="upper_arm_link">0.170004 0 0.039499 0 0 0.010227</pose>
      <parent>upper_arm_link</parent>
      <child>elbow_link</child>
      <axis>
        <xyz expressed_in="elbow_pitch">0 0 1</xyz>
        <limit>
          <lower>-0.820305</lower><upper>2.513274</upper>
          <effort>5</effort><velocity>1</velocity>
        </limit>
      </axis>
    </joint>
    <joint name="forearm_roll" type="revolute">
      <pose relative_to="elbow_link">0.000001 -0.074 0.02 3.141593 -1.570795 0</pose>
      <parent>elbow_link</parent>
      <child>forearm_link</child>
      <axis>
        <xyz expressed_in="forearm_roll">0 0 1</xyz>
        <limit>
          <lower>-2.897247</lower><upper>2.897247</upper>
          <effort>5</effort><velocity>1</velocity>
        </limit>
      </axis>
    </joint>
  <joint name="wrist_pitch" type="revolute">
      <pose relative_to="forearm_link">-0.003997 -0.000007 0.165 -1.570808 -1.271748 1.570808</pose>
      <parent>forearm_link</parent>
      <child>wrist_pitch_link</child>
      <axis>
        <xyz expressed_in="wrist_pitch">0 0 1</xyz>
        <limit>
          <lower>-2.617994</lower><upper>0.663225</upper>
          <effort>5</effort><velocity>1</velocity>
        </limit>
      </axis>
    </joint>
    <joint name="wrist_roll" type="revolute">
      <pose relative_to="wrist_pitch_link">0.026448 0.048588 0.013002 -1.570799 -0.055538 -1.570796</pose>
      <parent>wrist_pitch_link</parent>
      <child>wrist_roll_link</child>
      <axis>
        <xyz expressed_in="wrist_roll">0 0 1</xyz>
        <limit>
          <lower>-2.897247</lower><upper>2.897247</upper>
          <effort>1</effort><velocity>2</velocity>
        </limit>
      </axis>
    </joint>
    <joint name="jaw_a" type="prismatic">
      <pose relative_to="wrist_roll_link">0 0 0.06835 0 -1.570796 0</pose>
      <parent>wrist_roll_link</parent>
      <child>jaw_a_link</child>
      <axis>
        <xyz expressed_in="jaw_a">0 0 1</xyz>
        <limit>
          <lower>-0.0105</lower><upper>0.0105</upper>
          <effort>20</effort><velocity>0.05</velocity>
        </limit>
      </axis>
    </joint>
    <joint name="jaw_b" type="prismatic">
      <pose relative_to="wrist_roll_link">0 0 0.06835 0 -1.570796 0</pose>
      <parent>wrist_roll_link</parent>
      <child>jaw_b_link</child>
      <axis>
        <xyz expressed_in="jaw_b">0 0 1</xyz>
        <limit>
          <lower>-0.0105</lower><upper>0.0105</upper>
          <effort>20</effort><velocity>0.05</velocity>
        </limit>
        <mimic joint="jaw_a">
          <multiplier>-1</multiplier>
          <offset>0</offset>
        </mimic>
      </axis>
    </joint>
    <joint name="tool0_joint" type="fixed">
      <pose relative_to="wrist_roll_link">0 0 0.12365 0 0 0</pose>
      <parent>wrist_roll_link</parent>
      <child>tool0</child>
    </joint>
  </model>
</sdf>
