hbenuid/robotic-arm/cad/robot/arm.urdf

<?xml version="1.0"?>
<!--
  arm: 6-axis desktop arm - base yaw, shoulder pitch (21:1 cycloidal drive), elbow pitch (GT2 belt),
  FOREARM ROLL (GT2 belt in the roll frame at the elbow, cad/assemblies/forearm_roll_drive.py), wrist pitch (GT2
  belt) and WRIST ROLL (GT2 belt from the NEMA17 pancake on the wrist_pitch axis, cad/assemblies/wrist_roll_drive.py)
  - + a rack & pinion parallel gripper on an MG996R (cad/assemblies/gripper.py). Six joints are driven by
  NEMA 17 + MKS SERVO42D kits: the base_yaw / elbow_pitch / wrist_pitch motors are NEMA 17s on the
  mounts the links carry (cad/lib/mounts.py: the 48 mm nema17_48mm#1 under the base, nema17_40mm#2..3 on
  the links, + mks_servo42d#1..3, in base_link / upper_arm_link / forearm_link), the shoulder_pitch one
  the cycloidal drive's own 48 mm motor + board, the forearm_roll one the roll drive's own 40 mm motor
  + board (in elbow_link), the wrist_roll one the wrist roll drive's pancake + board (in wrist_pitch_link);
  which CAN id (software/control/src/config.py J1..J3 - three of the six) drives which joint is unconfirmed.

  SOURCE OF TRUTH: this file. Every number is derived from the CAD by cad/tools/robot/derive.py
  (cad/robot/frames.py = link partition + joint frames; cad/reference/placements.json = the
  SolidWorks capture) and verified with `./cadtool python tools/robot/derive.py`, check mode
  (tests/test_robot.py runs it). Regenerate meshes with cad/tools/robot/export_link_meshes.py.

  FRAMES (REP-103): base_link on the base's bottom face at the base_yaw axis, Z up, X forward
  (the direction the arm extends). Every joint frame has Z on the joint axis and X along the
  child link's long direction at the capture pose. A child link's frame IS its joint frame at
  the SolidWorks capture pose: ALL JOINTS ARE 0 AT THE CAPTURE POSE and every mesh origin is
  identity. In that pose the arm stands square to the base: the base is turned to meet j1_coupler
  flat to flat (cad/lib/datum.py BASE_TURN_DEG, base_link's frame with it), so the pitch axes lie
  along base Y at zero; the shoulder_pitch, elbow_pitch and wrist_pitch axes are
  parallel (SlabParams.elbow_x and -WebParams.wrist_x apart in the pitch plane, offset along the axis as the
  joint origins below put them: cad/robot/frames.py). The capture pose is the design's: the forearm and
  everything beyond it are turned half a turn about the forearm_roll axis from the SolidWorks capture
  (cad/lib/placements.py TURNS: the wrist_pitch motor on the upper arm's side), so at zero the wrist and the
  gripper are rolled 180 deg from the capture and wrist_pitch's axis is the capture's -N.
  forearm_roll's Z runs along the forearm (the pitch plane's in-plane direction) through the WRIST
  CENTRE - on the wrist_pitch axis 17 mm back from the wrist_pitch origin, where the SolidWorks
  wrist_roll axis met it; its X is the pitch-axis direction (its child's long direction IS the axis).
  wrist_roll no longer meets it: the wrist roll drive's pancake sits on the wrist_pitch axis and belts
  to the roll axis WRIST_ROLL_OFFSET across it, WRIST_ROLL_AXIS_H over the wrist plate - a wrist
  offset, the last three axes are NOT concurrent (an inverse kinematics must be numeric). It does NOT cross the elbow axis: the
  roll motor sits on the elbow axis and the roll housing ELBOW_ROLL_OFFSET (the drive's centre
  distance: the stock belt round its tensioner) above it, so forearm_roll's origin sits that far across elbow_link's frame (its -Y) - an elbow
  offset. elbow_link is the elbow's driven side (the 90T pulley carrying the roll drive's stator, the
  frame and the elbow flange under it, the elbow coupler's place), forearm_link the roll drive's rotor (the pulley + the shaft, the clamp's screws + nuts) + the forearm.

  UNITS: metres, kilograms, radians. MESHES: meshes/<link>.stl in millimetres (scale 0.001),
  one per link in the link frame (visual and collision reuse them; simplified collision
  primitives are a TODO). INERTIALS: OCP BRepGProp on the CAD solids, printed parts at PETG
  1.27 g/cm3, purchased parts at their datasheet/estimated mass (cad/lib/params.py).

  PLACEHOLDERS [ESTIMATE] (cad/lib/params.py): the base_yaw limit and the shoulder's lower limit, every
  effort and velocity value; the positive-motion sign of every axis
  (cad/robot/frames.py; confirm with viewer sweeps). The other limits are [DESIGN]
  (cad/tests/test_sweeps.py, the printed hard stops).
  ASSUMPTIONS: j1_coupler (the holder) turns on the base and carries the cycloidal drive's
  stator (the held carrier - motor plate, output hub + pins -, the motor, the gear train) in its
  yoke - together shoulder_link; the drive's rotor (the turning shell: shell ring, ring pins,
  housing bolts + nuts, both 6814s) is bolted to j1_link - together upper_arm_link - so the drive IS the
  shoulder_pitch joint (cad/docs/cycloidal_drive.md, cad/assemblies/cycloidal_drive.py BODIES);
  the GT2 90T pulleys + their flanges (elbow_flange, wrist_flange) are bolted to the driven links (elbow_link at elbow_pitch,
  wrist_pitch_link at wrist_pitch; the base_yaw 120T to j1_coupler's stub end inside the base - shoulder_link); the wrist
  roll drive's stator (the pancake + its board, its 20T, the belt, its 6806 pair) rides with wrist_link (its frame) in
  wrist_pitch_link, its rotor (pulley + shaft) with the gripper in wrist_roll_link; each belt joint's 6806-2RS bearing pair rides with its housing
  (base_link, upper_arm_link, forearm_link; cad/lib/mounts.py), the base_yaw thrust bearing's lower washer and needle
  cage with base_link, its upper washer with j1_coupler (shoulder_link); the gripper's pinion (it turns, driving the racks)
  is merged into wrist_roll_link; each jaw link is a rack and its jaw; jaw_b mirrors jaw_a (mimic, multiplier -1);
  positive jaw_a = opening; zero = the racks centred, the jaws 23 mm apart, JAW_TRAVEL_MM [DESIGN] each way.
  UNCONFIRMED: which CAN id (software/control/src/config.py J1..J3) drives which joint - the motors are placed
  (cad/lib/mounts.py) but not mapped; the shoulder_pitch motor is the drive's own NEMA 17 at 21:1
  (cad/lib/params.py CYCLOIDAL_RATIO; software/control/src/config.py still carries gear_ratio 1.0 everywhere). The
  belt motors' masses (280 g) and boards (35 g) are estimates; the wrist_pitch motor sits where the stock
  wrist belt puts it (J2_MOTOR_SLIDE_X, WRIST_BELT_LENGTH); FOREARM_ROLL_LIMIT_DEG stops 2 deg short of the
  printed hard stop, WRIST_ROLL_LIMIT_DEG 2 deg short of the wrist roll's. elbow_pitch's upper limit is the arm's
  own (the forearm's board and the wrist body against the base), not the gripper's: folded past ELBOW_GRIPPER_FREE_DEG, the wrist bent down or
  the forearm rolled can put the gripper into the upper arm - a planner must check those poses.
  The jaws are not driven by software/control/src/config.py, and forearm_roll and wrist_roll need CAN ids of
  their own (config.py names fewer than the arm's boards).
-->
<robot name="arm">
  <link name="base_link">
    <inertial>
      <origin xyz="-0.062906 0.000225 0.044225" rpy="0 0 0" />
      <mass value="1.496235" />
      <inertia ixx="4.381811e-03" ixy="-1.088318e-05" ixz="-7.485110e-04" iyy="9.151671e-03" iyz="-6.126688e-06" izz="1.055284e-02" />
    </inertial>
    <visual>
      <origin xyz="0 0 0" rpy="0 0 0" />
      <geometry>
        <mesh filename="meshes/base_link.stl" scale="0.001 0.001 0.001" />
      </geometry>
    </visual>
    <collision>
      <origin xyz="0 0 0" rpy="0 0 0" />
      <geometry>
        <mesh filename="meshes/base_link.stl" scale="0.001 0.001 0.001" />
      </geometry>
    </collision>
  </link>
  <link name="shoulder_link">
    <inertial>
      <origin xyz="0.00021 0.012608 -0.022772" rpy="0 0 0" />
      <mass value="1.508342" />
      <inertia ixx="4.212828e-03" ixy="-2.442926e-06" ixz="-2.531679e-06" iyy="3.105327e-03" iyz="-4.226438e-04" izz="2.474634e-03" />
    </inertial>
    <visual>
      <origin xyz="0 0 0" rpy="0 0 0" />
      <geometry>
        <mesh filename="meshes/shoulder_link.stl" scale="0.001 0.001 0.001" />
      </geometry>
    </visual>
    <collision>
      <origin xyz="0 0 0" rpy="0 0 0" />
      <geometry>
        <mesh filename="meshes/shoulder_link.stl" scale="0.001 0.001 0.001" />
      </geometry>
    </collision>
  </link>
  <link name="upper_arm_link">
    <inertial>
      <origin xyz="0.065245 -0.000016 0.047494" rpy="0 0 0" />
      <mass value="1.654286" />
      <inertia ixx="2.611034e-03" ixy="-3.055985e-06" ixz="9.666923e-05" iyy="7.221790e-03" iyz="-3.161286e-06" izz="6.530447e-03" />
    </inertial>
    <visual>
      <origin xyz="0 0 0" rpy="0 0 0" />
      <geometry>
        <mesh filename="meshes/upper_arm_link.stl" scale="0.001 0.001 0.001" />
      </geometry>
    </visual>
    <collision>
      <origin xyz="0 0 0" rpy="0 0 0" />
      <geometry>
        <mesh filename="meshes/upper_arm_link.stl" scale="0.001 0.001 0.001" />
      </geometry>
    </collision>
  </link>
  <link name="elbow_link">
    <inertial>
      <origin xyz="0.005712 -0.017821 0.015719" rpy="0 0 0" />
      <mass value="0.772915" />
      <inertia ixx="1.109545e-03" ixy="1.382076e-04" ixz="-1.910292e-05" iyy="6.197567e-04" iyz="5.798751e-05" izz="1.048475e-03" />
    </inertial>
    <visual>
      <origin xyz="0 0 0" rpy="0 0 0" />
      <geometry>
        <mesh filename="meshes/elbow_link.stl" scale="0.001 0.001 0.001" />
      </geometry>
    </visual>
    <collision>
      <origin xyz="0 0 0" rpy="0 0 0" />
      <geometry>
        <mesh filename="meshes/elbow_link.stl" scale="0.001 0.001 0.001" />
      </geometry>
    </collision>
  </link>
  <link name="forearm_link">
    <inertial>
      <origin xyz="0.006516 -0.00006 0.095647" rpy="0 0 0" />
      <mass value="0.619471" />
      <inertia ixx="1.280157e-03" ixy="3.619355e-06" ixz="-2.164067e-04" iyy="1.343771e-03" iyz="2.096843e-06" izz="3.165451e-04" />
    </inertial>
    <visual>
      <origin xyz="0 0 0" rpy="0 0 0" />
      <geometry>
        <mesh filename="meshes/forearm_link.stl" scale="0.001 0.001 0.001" />
      </geometry>
    </visual>
    <collision>
      <origin xyz="0 0 0" rpy="0 0 0" />
      <geometry>
        <mesh filename="meshes/forearm_link.stl" scale="0.001 0.001 0.001" />
      </geometry>
    </collision>
  </link>
  <link name="wrist_pitch_link">
    <inertial>
      <origin xyz="0.000345 0.012229 0.007438" rpy="0 0 0" />
      <mass value="0.431247" />
      <inertia ixx="4.863874e-04" ixy="-2.265337e-05" ixz="-9.578146e-08" iyy="2.478138e-04" iyz="-3.443378e-05" izz="3.380813e-04" />
    </inertial>
    <visual>
      <origin xyz="0 0 0" rpy="0 0 0" />
      <geometry>
        <mesh filename="meshes/wrist_pitch_link.stl" scale="0.001 0.001 0.001" />
      </geometry>
    </visual>
    <collision>
      <origin xyz="0 0 0" rpy="0 0 0" />
      <geometry>
        <mesh filename="meshes/wrist_pitch_link.stl" scale="0.001 0.001 0.001" />
      </geometry>
    </collision>
  </link>
  <link name="wrist_roll_link">
    <inertial>
      <origin xyz="0.005287 -0.00002 0.03095" rpy="0 0 0" />
      <mass value="0.134864" />
      <inertia ixx="1.268950e-04" ixy="-1.721731e-08" ixz="-8.412591e-06" iyy="1.476959e-04" iyz="-1.091387e-07" izz="3.843252e-05" />
    </inertial>
    <visual>
      <origin xyz="0 0 0" rpy="0 0 0" />
      <geometry>
        <mesh filename="meshes/wrist_roll_link.stl" scale="0.001 0.001 0.001" />
      </geometry>
    </visual>
    <collision>
      <origin xyz="0 0 0" rpy="0 0 0" />
      <geometry>
        <mesh filename="meshes/wrist_roll_link.stl" scale="0.001 0.001 0.001" />
      </geometry>
    </collision>
  </link>
  <link name="jaw_a_link">
    <inertial>
      <origin xyz="0.016949 -0.005644 0.009049" rpy="0 0 0" />
      <mass value="0.010942" />
      <inertia ixx="2.710300e-06" ixy="-6.545706e-07" ixz="-8.155029e-07" iyy="4.370291e-06" iyz="-5.523855e-07" izz="2.622026e-06" />
    </inertial>
    <visual>
      <origin xyz="0 0 0" rpy="0 0 0" />
      <geometry>
        <mesh filename="meshes/jaw_a_link.stl" scale="0.001 0.001 0.001" />
      </geometry>
    </visual>
    <collision>
      <origin xyz="0 0 0" rpy="0 0 0" />
      <geometry>
        <mesh filename="meshes/jaw_a_link.stl" scale="0.001 0.001 0.001" />
      </geometry>
    </collision>
  </link>
  <link name="jaw_b_link">
    <inertial>
      <origin xyz="0.016949 0.005644 -0.009049" rpy="0 0 0" />
      <mass value="0.010942" />
      <inertia ixx="2.710300e-06" ixy="6.545706e-07" ixz="8.155028e-07" iyy="4.370291e-06" iyz="-5.523856e-07" izz="2.622026e-06" />
    </inertial>
    <visual>
      <origin xyz="0 0 0" rpy="0 0 0" />
      <geometry>
        <mesh filename="meshes/jaw_b_link.stl" scale="0.001 0.001 0.001" />
      </geometry>
    </visual>
    <collision>
      <origin xyz="0 0 0" rpy="0 0 0" />
      <geometry>
        <mesh filename="meshes/jaw_b_link.stl" scale="0.001 0.001 0.001" />
      </geometry>
    </collision>
  </link>
  <link name="tool0" />
  <joint name="base_yaw" type="revolute">
    <parent link="base_link" />
    <child link="shoulder_link" />
    <origin xyz="0 0 0.19051" rpy="0 0 0" />
    <axis xyz="0 0 1" />
    <limit lower="-3.054326" upper="3.054326" effort="5" velocity="1" />
  </joint>
  <joint name="shoulder_pitch" type="revolute">
    <parent link="shoulder_link" />
    <child link="upper_arm_link" />
    <origin xyz="0.000186 -0.0425 0" rpy="-1.570796 -0.830504 0.000003" />
    <axis xyz="0 0 1" />
    <limit lower="-2.094395" upper="1.169371" effort="5" velocity="1" />
  </joint>
  <joint name="elbow_pitch" type="revolute">
    <parent link="upper_arm_link" />
    <child link="elbow_link" />
    <origin xyz="0.170004 0 0.039499" rpy="0 0 0.010227" />
    <axis xyz="0 0 1" />
    <limit lower="-0.820305" upper="2.513274" effort="5" velocity="1" />
  </joint>
  <joint name="forearm_roll" type="revolute">
    <parent link="elbow_link" />
    <child link="forearm_link" />
    <origin xyz="0.000001 -0.074 0.02" rpy="3.141593 -1.570795 0" />
    <axis xyz="0 0 1" />
    <limit lower="-2.897247" upper="2.897247" effort="5" velocity="1" />
  </joint>
  <joint name="wrist_pitch" type="revolute">
    <parent link="forearm_link" />
    <child link="wrist_pitch_link" />
    <origin xyz="-0.003997 -0.000007 0.165" rpy="-1.570808 -1.271748 1.570808" />
    <axis xyz="0 0 1" />
    <limit lower="-2.617994" upper="0.663225" effort="5" velocity="1" />
  </joint>
  <joint name="wrist_roll" type="revolute">
    <parent link="wrist_pitch_link" />
    <child link="wrist_roll_link" />
    <origin xyz="0.026448 0.048588 0.013002" rpy="-1.570799 -0.055538 -1.570796" />
    <axis xyz="0 0 1" />
    <limit lower="-2.897247" upper="2.897247" effort="1" velocity="2" />
  </joint>
  <joint name="jaw_a" type="prismatic">
    <parent link="wrist_roll_link" />
    <child link="jaw_a_link" />
    <origin xyz="0 0 0.06835" rpy="0 -1.570796 0" />
    <axis xyz="0 0 1" />
    <limit lower="-0.0105" upper="0.0105" effort="20" velocity="0.05" />
  </joint>
  <joint name="jaw_b" type="prismatic">
    <parent link="wrist_roll_link" />
    <child link="jaw_b_link" />
    <origin xyz="0 0 0.06835" rpy="0 -1.570796 0" />
    <axis xyz="0 0 1" />
    <limit lower="-0.0105" upper="0.0105" effort="20" velocity="0.05" />
    <mimic joint="jaw_a" multiplier="-1" offset="0" />
  </joint>
  <joint name="tool0_joint" type="fixed">
    <parent link="wrist_roll_link" />
    <child link="tool0" />
    <origin xyz="0 0 0.12365" rpy="0 0 0" />
  </joint>
</robot>
