hbenuid/robotic-arm/cad/assemblies/forearm_roll_drive.py

"""forearm_roll_drive - the belt-driven forearm roll (the joint added to the SolidWorks arm's five), a code-driven
module like the cycloidal drive.

Stator: the frame - ONE printed part (forearm_roll_block) round the roll motor: an octagon about the elbow axis (its flats on the
upper arm's round end) hulled up to the tower round the roll axis; under its underside the elbow's output flange, its own
part (elbow_flange: a post - the SolidWorks j3_coupler's journal carried up -, the shoulder and the stub down into
j1_link's bore) on the frame's spigot; the elbow 90T pulley bolts up through it into the frame, so j3_coupler#1 is
retired (lib/placements.py RETIRED); the 40 mm kit motor + MKS board ON the elbow axis in its pocket
(open down through the octagon's bottom - the motor slides up into it, turned so its connector and the board's motor plug
point down into the opening -, the side face closed, the pocket's front wall the plate, its 4x M3 from the front face,
heads flush in counterbores: roll_motor_screws) and the 20T on the motor shaft, its hub down in the plate's pilot hole;
the roll belt's tensioner on the frame's front face (the idler on a riser, its M5 and nut: RollIdlerParams); the 6806
pair back to back in the tower, a 12 mm spacer between them. Rotor: the pulley (forearm_roll_pulley, the output: the
integral 90T ring over the bearing boss on the frame's front face, its hub down through bearing 2 and its neck on to
bearing 1, the spigot the forearm's wall bolts onto - 4x M3 into nuts in its core; forearm_link) and the shaft
(forearm_roll_shaft, a collar that holds bearing 1: its journal through it, the rotor clamp's nuts and the stop lug in
its flange - in through the frame's back), clamped by 4x M3 from the pulley's front face into nuts in the shaft's flange
(roll_clamp_screws, roll_clamp_nuts: on the rotor). The shaft's bay is closed by a removable back panel flush with the
frame's rear face (forearm_roll_back_panel, in a step across the face, over the bay and the opening grown down below
it), held by 4 magnet pairs (roll_back_magnets) - both on the stator. MODULE FRAME (lib/forearm/params.py RollDriveParams): origin on the roll axis at the elbow
axis' station, +Z along the roll axis toward the wrist, +X = host +Z (N), +Y = up in the arm's swing plane, the elbow
axis along X at y_elbow (the arm's elbow offset below the roll axis); the arm places it through lib/mounts.py
MODULE_MOUNTS ("forearm_roll_drive#1" on j2_link#1). Every station comes from lib/forearm stack_positions() - never type
one here. Gear ratio 90 / 20 = 4.5 (FOREARM_ROLL_RATIO) on the belt (forearm_roll_belt, FOREARM_ROLL_BELT_LENGTH, round the idler); the forearm
wall's M3 screws + nuts are tools/bom.py EXTRAS; the elbow 90T's M4 screws + nuts into the frame are the arm's
(lib/mounts.py FASTENER_MOUNTS).
"""
from cad import step

from assemblies._occurrences import located_children
from lib import reference as R
from lib.assembly import assembly
from lib.forearm import DEFAULT, roll_idler_xy, stack_positions
from lib.forearm.roll import home_magnet_frame, home_sensor_frame
from lib.models import raw

S = stack_positions(DEFAULT)
_IDLER = roll_idler_xy(DEFAULT)   # the roll belt's tensioner's axis (module x, y)
_HOME_SENSOR = home_sensor_frame(DEFAULT)   # the KY-003's frame behind the shaft (lib/forearm/roll.py)


def _at(x: float = 0.0, y: float = 0.0, z: float = 0.0):
    return (x, y, z)


# (part, role | None, placement in the module frame) - a position, or ((x, y, z), (rx, ry, rz)) when the part's own
# frame is not the module's (the 20T's vendor axis is +X). The frame, the elbow flange, the shaft and the pulley are built at their
# stations (their rows are at 0); the bearings stand on their seats; the motor's mounting face is the plate's rear face,
# the motor on the elbow axis (centred on the roll axis in X), turned so its connector points down (-Y) into the opening.
OCCURRENCES = [
    ("forearm_roll_block",    None, _at()),
    ("elbow_flange",          None, _at()),
    ("bearing_6806",          "1",  _at(z=S["z_bearing_1"])),
    ("forearm_roll_shaft",    None, _at()),
    ("bearing_6806",          "2",  _at(z=S["z_bearing_2"])),
    ("forearm_roll_pulley",   None, _at()),
    # the rotor clamp: its 4x M3 from the pulley's front face (turned over: the heads up), on the counterbores' floor, into
    # the nuts in the shaft's flange (their far faces 2 pitches short of the tips)
    ("roll_clamp_screws",     None, ((0.0, 0.0, S["z_clamp_head"]), (180.0, 0.0, 0.0))),
    ("roll_clamp_nuts",       None, _at(z=S["z_clamp_nut"])),
    # the roll motor, its board and its 20T - on the elbow axis (-Y) - carry the joint as their role (labels unique in the arm)
    ("nema17_40mm",           "forearm_roll", ((S["x_motor"], S["y_motor"], S["z_motor_face"]), (0.0, 0.0, DEFAULT.drive.motor_spin_deg))),    # its connector down (-Y)
    ("mks_servo42d",          "forearm_roll", ((S["x_motor"], S["y_motor"], S["z_motor_board"]), (0.0, 0.0, DEFAULT.drive.motor_spin_deg))),
    ("gt2_pulley_20t",        "forearm_roll", ((S["x_motor"], S["y_motor"], S["z_20t"]), (0.0, -90.0, 0.0))),   # hub face pulley_seat over the pilot boss, bore axis along +Z
    # the motor's 4x M3 from the plate's front face (turned over: the heads up), flush in its counterbores
    ("roll_motor_screws",     None, ((S["x_motor"], S["y_motor"], S["z_motor_screws"]), (180.0, 0.0, 0.0))),
    ("forearm_roll_belt",     "forearm_roll", ((S["x_motor"], S["y_motor"], S["z_ring_mid"]), (0.0, 0.0, 90.0))),   # the 20T to the ring: its frame's +X up module +Y
    # the belt's tensioner (RollIdlerParams): the idler on the riser's land, level with the belt; its M5 down from the
    # idler's top (turned over: the head up) into the nut under the frame's face, bearing up on the channel's roof
    ("gt2_idler_20t",         "forearm_roll", _at(*_IDLER, S["z_idler"])),
    ("roll_idler_screw",      None, ((*_IDLER, S["z_idler_top"]), (180.0, 0.0, 0.0))),
    ("roll_idler_nut",        None, _at(*_IDLER, S["z_idler_roof"] - DEFAULT.drive.idler.nut.h)),
    # the back panel in the frame's step on the rear face, over the shaft's bay, and its magnet pairs (built at their stations)
    ("forearm_roll_back_panel", None, _at()),
    ("roll_back_magnets",     None, _at()),
    # the home sensor (RollHomeParams): its carrier on the opening's floor under the panel (built at its station), the
    # KY-003 on it behind the shaft and the board's M2s + nuts (in the KY-003's frame); the magnet in the shaft's rear face
    ("roll_home_carrier",     None, _at()),
    ("ky003_hall_sensor",     "forearm_roll", _HOME_SENSOR),
    ("roll_home_board_screws", None, _HOME_SENSOR),
    ("roll_home_board_nuts",  None, _HOME_SENSOR),
    ("roll_home_magnet",      None, home_magnet_frame(DEFAULT)),
]

# The module's rigid bodies (robot/frames.py LINKS: "forearm_roll_drive#1:stator" in elbow_link, ":rotor" in forearm_link).
ROTOR = frozenset({"forearm_roll_shaft", "forearm_roll_pulley", "roll_clamp_screws", "roll_clamp_nuts", "roll_home_magnet"})
BODIES = {"rotor": ROTOR, "stator": frozenset(part for part, _, _ in OCCURRENCES) - ROTOR}

# Totals lock (tests/test_assembly.py, test_robot.py; robot/ inertials sum the same rows): whole module + per body.
# Re-derive with totals() / totals("stator") after any geometry change.
EXPECTED = {
    "leaves": 23, "solids": 58, "solid_volume": 395290.489,
    "bodies": {"stator": {"leaves": 18, "solids": 47, "solid_volume": 351145.911},
               "rotor": {"leaves": 5, "solids": 11, "solid_volume": 44144.579}},
}


@step(out="forearm_roll_drive.step")
def forearm_roll_drive():
    """The drive in its module frame, every part in its colour as in the arm (_occurrences.colour())."""
    return assembly("forearm_roll_drive", located_children(OCCURRENCES, tint=True))


def totals(body: str | None = None, *, shape=None) -> dict:
    """(leaves, solids, solid_volume) of a fresh in-process build - or of `shape`, a build of it already made - the
    whole module or one of BODIES."""
    module = raw(forearm_roll_drive) if shape is None else shape
    leaves = [c for c in module.children if body is None or c.label.split(":")[0] in BODIES[body]]
    return {"leaves": len(leaves), "solids": sum(len(c.solids()) for c in leaves),
            "solid_volume": round(sum(R.solid_volume(c) for c in leaves), 3)}


if __name__ == "__main__":
    forearm_roll_drive()   # build: writes the sibling forearm_roll_drive.step
