hbenuid/robotic-arm/cad/robot/frames.py

"""Kinematic decomposition of the arm: rigid links and joint frames, derived from the
SolidWorks capture (reference/placements.json) with the design's shifts (lib/placements.py SHIFTS)
applied. Single source for robot/links/*.py, tools/robot/derive.py, tools/robot/export_link_meshes.py and
tests/test_robot.py.

LINKS holds placement keys: part occurrences and designed-module keys - "cycloidal_drive#1", or
one rigid body of it, "cycloidal_drive#1:stator" / ":rotor" (assemblies/cycloidal_drive.py
BODIES) - which assemblies/_occurrences.world_rows expands into world-placed parts.

Chain: base_link -base_yaw-> shoulder_link -shoulder_pitch-> upper_arm_link -elbow_pitch-> elbow_link
-forearm_roll-> forearm_link -wrist_pitch-> wrist_pitch_link -wrist_roll-> wrist_roll_link -jaw_a/jaw_b->
jaw_*_link, + tool0 (frame-only). The cycloidal drive IS the shoulder_pitch joint: its stator
(the held carrier + motor, in the j1_coupler fork) rides in shoulder_link, its rotor (the turning
shell, whose body is printed with j1_link) in upper_arm_link (docs/cycloidal_drive.md "Attachment").

Frames (all in the SolidWorks WORLD frame W, millimetres; W is +Y up, the arm extends toward
-X, see reference/README.md):
  * base_link frame B: REP-103 (Z up, X forward) at the base_yaw axis foot on the base's bottom
    face: origin (0, BASE_BOTTOM_Y, 0), Z_B = +Y_W, X_B = BASE_FORWARD (-X_W turned BASE_TURN_DEG
    about it with the base). base_frame(), frame() and the U / BASE_FORWARD vectors are defined in
    lib/datum.py (assemblies/arm.py needs them too and assemblies/ never imports robot/) and
    re-exported here.
  * Every joint frame has Z along the joint axis and X along the child link's long direction
    at the capture pose (projected perpendicular to Z); Y = Z x X.
  * A child link's frame IS its joint frame at the capture pose, so ALL JOINT VALUES ARE 0 AT
    THE CAPTURE POSE and every link mesh (exported in the link frame) has an identity origin.
    The capture pose is the design's: the SHIFTS applied, the base turned about base_yaw to meet
    j1_coupler flat to flat (the capture had the coupler, and the arm on it, yawed BASE_TURN_DEG off
    the base: now the pitch axes are parallel to Y_B at zero) and the forearm turned half a turn
    about its roll axis (lib/placements.py TURNS), so at zero the wrist and the gripper are rolled
    180 deg from the SolidWorks capture (the wrist-pitch motor on the upper arm's side).
Axis signs (positive-motion direction) and the [ESTIMATE] limits (lib/params.py) are placeholders until
confirmed by viewer sweeps / on hardware.
"""
from __future__ import annotations

import math
from dataclasses import dataclass

import build123d as bd

from lib import params as PARAMS
from lib import placements as P
from lib.datum import (  # noqa: F401  (the datum frames live below assemblies/)
    BASE_BOTTOM_Y,
    BASE_FORWARD,
    U,
    base_frame,
    frame,
    rotation,
)
from lib.gripper.layout import jaw_origin, tool0
from lib.wrist.layout import gripper_frame_in_host

ROBOT_NAME = "arm"

# --- unit vectors of the capture pose (W frame); U (world up) and BASE_FORWARD are lib/datum.py's ---
N = (0.064439, 0.0, 0.997922)                # the three pitch axes (parallel): 90T pulley / J3-coupler bore direction; the cycloidal drive's +Z is -N
F = (-0.865419, 0.497923, 0.055880)          # wrist-roll axis: NEMA17 pancake shaft / 20T pulley bore (toward the tool)

BASE_YAW_ORIGIN = (0.0, 85.010435, 0.0)      # [REFERENCE] on the base_yaw axis at the cycloidal drive's axis height (its node's Y)
# The origins beyond a link move with it: the capture point [REFERENCE] + the SHIFTS of the record it sits on, then its
# TURNS (lib/placements.py: the forearm turned half a turn about its roll axis - the wrist and the gripper with it).
SHOULDER_ORIGIN = P.shifted("j1_link#1", (-2.440595, 85.010435, -34.915297))   # j1_link#1 origin: on the cycloidal drive's axis, 66.5
#                                                        mm along it from the motor-plate face (lib/upper_arm/params.py ArmParams.drive_z_at_y0)
_J2_CAPTURE_ORIGIN = (-143.15, 240.05, -15.81)   # [REFERENCE] j2_link#1's (and the retired j3_coupler#1's) capture origin, on the elbow_pitch axis
ELBOW_ORIGIN = P.shifted("j3_coupler#1", _J2_CAPTURE_ORIGIN)   # the retired j3_coupler#1's origin, on the elbow_pitch axis (the forearm sits
#                                                        ELBOW_ROLL_OFFSET across from it)
_WRIST_PITCH_CAPTURE_ORIGIN = (-283.37, 393.63, 35.33)   # [REFERENCE] the retired j3_coupler#2's capture origin (on the wrist_pitch axis)
WRIST_PITCH_ORIGIN = P.shifted("j3_coupler#2", _WRIST_PITCH_CAPTURE_ORIGIN)
# the wrist roll: the SolidWorks 20T's origin on the pancake's shaft axis (the capture's roll axis), moved with the
# retired record onto the wrist roll drive's axis R' - the drive's shift (lib/placements.py SHIFTS) carries the capture's
# roll axis onto R', WRIST_ROLL_OFFSET across the pitch axis and WRIST_ROLL_AXIS_H over the plate (a wrist offset)
WRIST_ROLL_ORIGIN = P.shifted("gt2_pulley_20t#1", (-379.355, 448.22, 24.495))   # [REFERENCE] gt2_pulley_20t#1's capture origin
# ... and so do the directions beyond the forearm roll: the wrist_pitch axis (the capture's N turned: -N), the wrist roll axis
WRIST_PITCH_AXIS = P.turned("j3_coupler#2", N)
WRIST_ROLL_AXIS = P.turned("gt2_pulley_20t#1", F)


# The gripper (assemblies/gripper.py, mounted on wrist_link#1 - lib/mounts.py "gripper#1"): its module frame in
# wrist_link's part frame, carried into W by wrist_link#1's capture pose and its SHIFTS / TURNS - the pose
# tools/reference/mount_placements.py gives the module's record, here without reading it (that tool checks the module's
# axis against these joints before the record exists).
_WRIST_LINK = P.OCCURRENCES["wrist_link#1"]["world"]["matrix_3x4"]
_GRIPPER_POS, _GRIPPER_ROT = gripper_frame_in_host()


def _gripper_point(p_m):
    """A point of the gripper's module frame in W (the capture pose, the design's shifts and turns)."""
    r = rotation(_GRIPPER_ROT)
    q = [_GRIPPER_POS[i] + sum(r[i][k] * p_m[k] for k in range(3)) for i in range(3)]
    return P.shifted("wrist_link#1", tuple(sum(_WRIST_LINK[i][k] * q[k] for k in range(3)) + _WRIST_LINK[i][3] for i in range(3)))


def _gripper_dir(v_m):
    """A direction of the gripper's module frame in W."""
    r = rotation(_GRIPPER_ROT)
    q = [sum(r[i][k] * v_m[k] for k in range(3)) for i in range(3)]
    return P.turned("wrist_link#1", tuple(sum(_WRIST_LINK[i][k] * q[k] for k in range(3)) for i in range(3)))


JAW_TRAVEL = _gripper_dir((0.0, 1.0, 0.0))                 # jaw a -> jaw b: the module's +Y (jaw a opens along -JAW_TRAVEL)
JAW_A_ORIGIN = JAW_B_ORIGIN = _gripper_point(jaw_origin())   # both on R', level with the racks' bars (lib/gripper/layout.py)
TOOL0_ORIGIN = _gripper_point(tool0())                      # the fingertips' midpoint, on R'
# The link directions (only their direction is used - lib/datum.py frame() projects them; the SHIFTS are parallel):
SHOULDER_TO_ELBOW_INPLANE = (-141.353693, 155.039565, 9.127651)   # [REFERENCE] upper_arm_link long direction: the capture's
#                                                                   ELBOW_ORIGIN - SHOULDER_ORIGIN minus its 10.0 mm component along N
ELBOW_TO_WRIST_INPLANE = (-142.926, 153.58, 9.229)   # [REFERENCE] forearm_link long direction (the capture's elbow -> wrist_pitch,
#                                                       perpendicular to N): the roll axis' direction (the forearm moved across it, parallel)

# --- the forearm roll (the joint added to the SolidWorks arm's five, assemblies/forearm_roll_drive.py): its axis runs
# along the forearm, across the wrist_pitch axis by the WRIST CENTRE - the point on that axis WRIST_CENTRE_ALONG_N back
# along N from WRIST_PITCH_ORIGIN, where the SolidWorks wrist_roll axis met it. Since the wrist roll drive
# (assemblies/wrist_roll_drive.py) the wrist_roll axis runs WRIST_ROLL_OFFSET across the pitch axis and
# WRIST_ROLL_AXIS_H over the wrist plate - a wrist offset: the last three axes are no longer concurrent (an IK must be
# numeric). The forearm roll's axis passes FOREARM_ROLL_AXIS_Z along N from j2_link's capture origin (42 - 17 = 25,
# lib/params.py) - ELBOW_ROLL_OFFSET across the elbow axis (the roll motor sits on the elbow axis): an elbow offset, the
# axes no longer cross. The wrist dropped along its pitch axis with the forearm's web (lib/forearm/params.py WEB_DROP),
# WRIST_CENTRE with it: the roll axis crosses the pitch axis that far from it (tests/forearm/test_roll_drive.py). The
# forearm's turn is about this axis: its points stay put.
WRIST_CENTRE_ALONG_N = -17.0                 # [REFERENCE] see above: along the capture's N (the wrist_pitch axis before the turn)
_len = math.sqrt(sum(v * v for v in ELBOW_TO_WRIST_INPLANE))
FOREARM_ROLL_AXIS = tuple(v / _len for v in ELBOW_TO_WRIST_INPLANE)                    # unit, elbow -> wrist
FOREARM_ROLL_ORIGIN = P.shifted("j2_link#1", tuple(o + PARAMS.FOREARM_ROLL_AXIS_Z * n for o, n in zip(_J2_CAPTURE_ORIGIN, N, strict=True)),
                                turned=False)   # at the elbow axis' station; on the turn's axis (turned=False: N is the record's +Z to 6 decimals)
WRIST_CENTRE = P.shifted("j3_coupler#2", tuple(o + WRIST_CENTRE_ALONG_N * n for o, n in zip(_WRIST_PITCH_CAPTURE_ORIGIN, N, strict=True)))

# --- rigid links: placement keys that move together -----------------------------------------
LINK_ORDER = ["base_link", "shoulder_link", "upper_arm_link", "elbow_link", "forearm_link", "wrist_pitch_link",
              "wrist_roll_link", "jaw_a_link", "jaw_b_link", "tool0"]
LINKS: dict[str, list[str]] = {
    # the base's motor mount (its +X lobe) is bolted to it with its M4 screws + nuts; the base_yaw motor + its MKS
    # board hang under the mount's plate, its 20T and the belt to the 120T with them - the belt's tensioner (the idler,
    # its spacer, axle and nut) on the mount's plate (lib/mounts.py) - they turn nothing themselves (the belt's path is
    # fixed here, both its pulleys' axes are); the base_yaw bearing pair sits
    # in the base's bore (a bearing rides with its housing), the thrust bearing's lower washer and its cage in the
    # base's groove; the base_yaw home sensor (the KY-003 on its bracket under the motor plate)
    "base_link": ["base#1", "bearing_6806#1", "bearing_6806#2", "washer_as6590#1", "bearing_axk6590#1",
                  "base_motor_mount#1", "base_motor_mount_screws#1", "base_motor_mount_nuts#1", "nema17_48mm#1",
                  "mks_servo42d#1", "yaw_motor_screws#1", "gt2_pulley_20t#3", "yaw_belt#1", "gt2_idler_20t#2",
                  "yaw_idler_spacer#1", "yaw_idler_screw#1", "yaw_idler_nut#1", "ky003_hall_sensor#1", "yaw_home_bracket#1",
                  "yaw_home_screws#1", "yaw_home_nuts#1", "yaw_home_board_screws#1", "yaw_home_board_nuts#1"],
    # j1_coupler (the holder) turns on the base, its motor leg bolted on; the cycloidal drive's stator - the held carrier
    # (motor plate, output hub, output pins), the motor (+ its MKS board) and the gear train - sits in its fork
    # (assemblies/cycloidal_drive.py BODIES); the thrust bearing's upper washer turns with it, under its seat, and so does
    # the base_yaw 120T bolted to its stub's end inside the base (the base_yaw output, the driven side of its belt), with
    # the M4 screws + nuts that clamp it, and the home magnet in its outer face; the fork's screws + nuts hold the drive's
    # hub and sleeve in it; the shoulder_pitch home sensor (the KY-003 on its tray in the coupler's pocket).
    "shoulder_link": ["j1_coupler#1", "j1_motor_leg#1", "washer_as6590#2", "gt2_pulley_120t#1", "yaw_pulley_screws#1",
                      "yaw_pulley_nuts#1", "yaw_home_magnet#1", "fork_hub_screws#1", "fork_hub_nuts#1", "fork_foot_screws#1", "fork_foot_nuts#1",
                      "fork_sleeve_screws#1", "fork_sleeve_nuts#1", "ky003_hall_sensor#2", "shoulder_home_tray#1",
                      "shoulder_home_board_screws#1", "shoulder_home_board_nuts#1", "cycloidal_drive#1:stator"],
    # the drive's rotor (its turning shell, the ring pins and both 6814s) is bolted to j1_link: the shoulder_pitch output;
    # the elbow_pitch motor's gearbox bolts to the web across j1_link's motor hole (its 4x M4), the motor + board on it (its
    # 4x M3), its 20T and the elbow belt with them - the belt's tensioner (the idler, its spacer, axle and nut) on
    # j1_link's slab -, the elbow bearing pair sits in its elbow bore (lib/mounts.py); the shoulder_pitch home magnet is
    # glued on a pillar of the drive's shell (j1_link's); the elbow_pitch home sensor (the KY-003 on its clip over the
    # slab's end)
    "upper_arm_link": ["cycloidal_drive#1:rotor", "j1_link#1", "bearing_6806#3", "bearing_6806#4", "eg17_g5_gearbox#1",
                       "elbow_gearbox_screws#1", "nema17_40mm#2", "mks_servo42d#2", "elbow_motor_screws#1", "gt2_pulley_20t_8mm#1",
                       "elbow_belt#1", "gt2_idler_20t#1", "elbow_idler_spacer#1", "elbow_idler_screw#1", "elbow_idler_nut#1",
                       "shoulder_home_magnet#1", "ky003_hall_sensor#3", "elbow_home_clip#1", "elbow_home_board_screws#1",
                       "elbow_home_board_nuts#1"],
    # the elbow 90T pulley (the elbow_pitch output, assumed the driven side  [ASSUMPTION]) and the M4 screws + nuts
    # that clamp it carry the forearm roll drive's STATOR - the roll frame, whose web IS the elbow coupler now (j3_coupler#1
    # is retired, lib/placements.py), both bearings, the roll motor + board (on the elbow axis, its 4x M3) and its 20T
    # (assemblies/forearm_roll_drive.py BODIES); the elbow_pitch home magnet is glued on the 90T's outer face
    "elbow_link": ["gt2_pulley_90t#3", "elbow_pulley_screws#1", "elbow_pulley_nuts#1", "elbow_home_magnet#1",
                   "forearm_roll_drive#1:stator"],
    # the drive's ROTOR - the pulley (its 90T ring, the roll's output, bolts to j2_link's wall) and the shaft clamped to
    # it - IS the forearm's elbow end;
    # the wrist_pitch motor + board bolt to j2_link's web (its 4x M3), its 20T and the wrist belt with them - the belt's
    # tensioner (the idler, its axle and nut) under the web -, the wrist bearing pair sits in its wrist boss (lib/mounts.py);
    # the wrist_pitch home sensor (the KY-003 on its clip round the wrist boss's end)
    "forearm_link": ["forearm_roll_drive#1:rotor", "j2_link#1", "bearing_6806#5", "bearing_6806#6", "nema17_40mm#3", "mks_servo42d#3",
                     "gt2_pulley_20t#4", "wrist_motor_screws#1", "wrist_belt#1", "gt2_idler_20t#3", "wrist_idler_screw#1",
                     "wrist_idler_nut#1", "ky003_hall_sensor#4", "wrist_home_clip#1", "wrist_home_board_screws#1",
                     "wrist_home_board_nuts#1"],
    # likewise the wrist 90T pulley, its M4 screws + nuts and the J3-coupler ride with the wrist-pitch body  [ASSUMPTION];
    # wrist_link IS the wrist roll drive's frame, which carries the drive's STATOR - the pancake (on the pitch axis) and
    # its 20T, both bearings, the belt (assemblies/wrist_roll_drive.py BODIES); the wrist_pitch home magnet is glued on the
    # 90T's outer face
    "wrist_pitch_link": ["wrist_link#1", "wrist_flange#1", "gt2_pulley_90t#4", "wrist_pulley_screws#1",
                         "wrist_pulley_nuts#1", "wrist_home_magnet#1", "wrist_roll_drive#1:stator"],
    # the drive's ROTOR - the pulley (its 40T band, the roll's output, the gripper's connector bolted to its face) and the
    # shaft clamped to it - carries the gripper's base body: the connector, the cage, the MG996R, the base, the pinion
    # (it turns, driving the jaws: merged in  [ASSUMPTION]) - assemblies/gripper.py BODIES
    "wrist_roll_link": ["wrist_roll_drive#1:rotor", "gripper#1:base"],
    "jaw_a_link": ["gripper#1:jaw_a"],   # rack a and jaw a
    "jaw_b_link": ["gripper#1:jaw_b"],   # rack b and jaw b
    "tool0": [],   # frame-only link at the fingertip midpoint
}


@dataclass(frozen=True)
class Joint:
    name: str
    type: str                     # revolute | prismatic | fixed
    parent: str
    child: str
    origin_w: tuple               # point on the axis, W frame, mm
    axis_w: tuple                 # joint axis direction, W frame (unit)
    x_hint_w: tuple               # child link's long direction at capture (defines the frame's X)
    lower: float = 0.0            # rad or m  [ESTIMATE]
    upper: float = 0.0
    effort: float = 0.0           # N.m or N  [ESTIMATE]
    velocity: float = 0.0         # rad/s or m/s  [ESTIMATE]
    mimic: tuple | None = None    # (joint, multiplier, offset)
    notes: str = ""


DEG = math.pi / 180.0
JOINTS: list[Joint] = [
    Joint("base_yaw", "revolute", "base_link", "shoulder_link", BASE_YAW_ORIGIN, U, BASE_FORWARD,
          -PARAMS.BASE_YAW_LIMIT_DEG * DEG, PARAMS.BASE_YAW_LIMIT_DEG * DEG, PARAMS.ARM_JOINT_EFFORT_NM, PARAMS.ARM_JOINT_VELOCITY_RAD_S,
          notes="j1_coupler (carrying the cycloidal drive's stator) turns on the base in the bearing_6806#1 / #2 pair and stands "
                "on the thrust bearing in its groove (washer_as6590#1, bearing_axk6590#1, washer_as6590#2), held down by "
                "the GT2 120T bolted to its stub's end under the lower bearing (gt2_pulley_120t#1); belt-driven (BASE_YAW_RATIO) by "
                "nema17_48mm#1 (the 48 mm motor) + mks_servo42d#1 under the base plate (lib/mounts.py) "
                "[which CAN id (software/control/src/config.py J1..J3) it is: unconfirmed]"),
    Joint("shoulder_pitch", "revolute", "shoulder_link", "upper_arm_link", SHOULDER_ORIGIN, N, SHOULDER_TO_ELBOW_INPLANE,
          PARAMS.SHOULDER_PITCH_LIMITS_DEG[0] * DEG, PARAMS.SHOULDER_PITCH_LIMITS_DEG[1] * DEG, PARAMS.ARM_JOINT_EFFORT_NM, PARAMS.ARM_JOINT_VELOCITY_RAD_S,
          notes="the 21:1 cycloidal drive (CYCLOIDAL_RATIO, its own NEMA 17 x 48 + MKS board): the j1_coupler fork holds its "
                "hub and motor, its shell - the output, turning with the motor - is bolted to j1_link [which CAN id: unconfirmed]"),
    Joint("elbow_pitch", "revolute", "upper_arm_link", "elbow_link", ELBOW_ORIGIN, N, ELBOW_TO_WRIST_INPLANE,
          PARAMS.ELBOW_PITCH_LIMITS_DEG[0] * DEG, PARAMS.ELBOW_PITCH_LIMITS_DEG[1] * DEG, PARAMS.ARM_JOINT_EFFORT_NM, PARAMS.ARM_JOINT_VELOCITY_RAD_S,
          notes="GT2 90T pulley + the roll drive's frame (its stator) at the elbow, turning in the bearing_6806#3 / #4 pair; "
                "belt-driven (ELBOW_RATIO, two stages: the 5:1 gearbox, then the belt) by nema17_40mm#2 + mks_servo42d#2 on "
                "eg17_g5_gearbox#1, the gearbox on the web across j1_link's motor hole, on the arm's +N side (lib/mounts.py) "
                "[which CAN id: unconfirmed]"),
    # the roll: Z along the forearm (its child link's long direction IS the axis), so X = N, the pitch-axis direction
    Joint("forearm_roll", "revolute", "elbow_link", "forearm_link", FOREARM_ROLL_ORIGIN, FOREARM_ROLL_AXIS, N,
          -PARAMS.FOREARM_ROLL_LIMIT_DEG * DEG, PARAMS.FOREARM_ROLL_LIMIT_DEG * DEG, PARAMS.ARM_JOINT_EFFORT_NM, PARAMS.ARM_JOINT_VELOCITY_RAD_S,
          notes="the forearm roll drive (assemblies/forearm_roll_drive.py, FOREARM_ROLL_RATIO 4.5): j2_link's wall bolts onto "
                "the roll pulley's 90T ring; its axis ELBOW_ROLL_OFFSET across the elbow axis (an elbow offset); belt-driven "
                "by the drive's own nema17_40mm + mks_servo42d on the elbow axis, in the roll frame's pocket "
                "[a CAN id of its own - software/control/src/config.py names fewer than the arm's boards: unconfirmed]; "
                "the printed hard stop 2 deg past "
                "+/- FOREARM_ROLL_LIMIT_DEG"),
    Joint("wrist_pitch", "revolute", "forearm_link", "wrist_pitch_link", WRIST_PITCH_ORIGIN, WRIST_PITCH_AXIS, WRIST_ROLL_AXIS,
          PARAMS.WRIST_PITCH_LIMITS_DEG[0] * DEG, PARAMS.WRIST_PITCH_LIMITS_DEG[1] * DEG, PARAMS.ARM_JOINT_EFFORT_NM, PARAMS.ARM_JOINT_VELOCITY_RAD_S,
          notes="GT2 90T pulley + J3-coupler at the wrist, turning in the bearing_6806#5 / #6 pair; belt-driven by nema17_40mm#3 + mks_servo42d#3 on "
                "j2_link's web (lib/mounts.py) [which CAN id: unconfirmed]"),
    Joint("wrist_roll", "revolute", "wrist_pitch_link", "wrist_roll_link", WRIST_ROLL_ORIGIN, WRIST_ROLL_AXIS, JAW_TRAVEL,
          -PARAMS.WRIST_ROLL_LIMIT_DEG * DEG, PARAMS.WRIST_ROLL_LIMIT_DEG * DEG, PARAMS.WRIST_EFFORT_NM, PARAMS.WRIST_VELOCITY_RAD_S,
          notes="the wrist roll drive (assemblies/wrist_roll_drive.py, WRIST_ROLL_RATIO 2): the gripper's connector bolts to its "
                "pulley's face; belt-driven by the NEMA17 pancake + its mks_servo42d on the wrist_pitch axis, WRIST_ROLL_OFFSET "
                "across (a wrist offset) [a CAN id of its own - software/control/src/config.py names fewer than the arm's "
                "boards: unconfirmed]; the printed hard stop 2 deg past +/- WRIST_ROLL_LIMIT_DEG"),
    Joint("jaw_a", "prismatic", "wrist_roll_link", "jaw_a_link", JAW_A_ORIGIN, tuple(-v for v in JAW_TRAVEL), WRIST_ROLL_AXIS,
          -PARAMS.JAW_TRAVEL_MM * 1e-3, PARAMS.JAW_TRAVEL_MM * 1e-3, PARAMS.JAW_EFFORT_N, PARAMS.JAW_VELOCITY_M_S,
          notes="positive = opening (jaw A moves away from jaw B); the MG996R's pinion drives both racks"),
    Joint("jaw_b", "prismatic", "wrist_roll_link", "jaw_b_link", JAW_B_ORIGIN, tuple(-v for v in JAW_TRAVEL), WRIST_ROLL_AXIS,
          -PARAMS.JAW_TRAVEL_MM * 1e-3, PARAMS.JAW_TRAVEL_MM * 1e-3, PARAMS.JAW_EFFORT_N, PARAMS.JAW_VELOCITY_M_S,
          mimic=("jaw_a", -1.0, 0.0), notes="mirrors jaw_a"),
    Joint("tool0_joint", "fixed", "wrist_roll_link", "tool0", TOOL0_ORIGIN, WRIST_ROLL_AXIS, JAW_TRAVEL,
          notes="tool frame: Z = approach (along the forearm), X = jaw travel"),
]
JOINT_BY_NAME = {j.name: j for j in JOINTS}
JOINT_OF_CHILD = {j.child: j for j in JOINTS}


def joint_frame_world(name: str) -> bd.Location:
    j = JOINT_BY_NAME[name]
    return frame(j.origin_w, j.axis_w, j.x_hint_w)


def link_frame_world(link: str) -> bd.Location:
    """The link's frame in W: base_link -> base_frame(); any other link -> its parent joint's frame."""
    if link == "base_link":
        return base_frame()
    return joint_frame_world(JOINT_OF_CHILD[link].name)


def all_keys() -> list[str]:
    return [k for link in LINK_ORDER for k in LINKS[link]]
