hbenuid/robotic-arm/cad/parts/cycloidal/cycloidal_ring_gear_body.py

"""cycloidal_ring_gear_body - the port's housing cylinder: ring-pin holes, 6814 seat, retention lip, captive nut
pockets (local z 0..51; sits at stack z 9). Modelled, not placed: the turning shell's body is printed with j1_link.

Ported from cycloidal_drive@2f1f67d src/ring_gear_body.py (build_ring_gear_body()); reference/
cycloidal_ring_gear_body.step is that builder's export (kind "designed"). PETG.

Stepped bore: bore_dia (z 0..28, disc orbit + clearance), 90.15 mm 6814 press-fit seat (28..48),
86.15 mm hub clearance behind the integral 2 mm retention lip (48..51). 21 blind ring-pin holes
(31.5 deep) with 1 mm entry funnels at the bore/bearing transition; the M4 through-holes (bolt_count)
with hex nut pockets on the output face; the shared pillar / reveal-window silhouette; the output face
(z=51, external) and barrel edges chamfered, the motor-plate face (z=0) sharp.
The turning shell (DEFAULT_CONFIG, ShellParams) has no ring gear body: its body round the discs is the shell ring's
mirror (lib/cycloidal/housing.py build_shell_body), printed as one with j1_link (the upper arm rises off it). So the
model builds the port (LEGACY_CONFIG, what reference/cycloidal/cycloidal_ring_gear_body.step holds - tests/cycloidal/
test_port.py) and no assembly places it (UNPLACED); build(cfg) takes any port-layout config.
"""
import math
import pathlib

import build123d as bd
from cadgen import step

from lib.cycloidal import (
    LEGACY_CONFIG,
    DriveConfig,
    compute_housing_bolt_angles,
    housing_bolt_points,
    ring_pin_hole_depth,
    ring_pin_hole_dia,
    ring_pin_points,
)
from lib.cycloidal.housing import chamfer_outer_silhouette, hex_pocket, reveal_window_cutter
from lib.datum import IDENTITY
from lib.geom import align_min, cylinder, through
from lib.params import NUDGE

NAME = pathlib.Path(__file__).stem
ACCENT = True                 # the accent colour, lib/style.py: a drive part
REFERENCE = NAME
CONVERTED = True
LOCAL_FROM_REF = IDENTITY
REF_VOL_TOL = 1e-4
REF_BBOX_TOL = 0.02
UNPLACED = ("the port's ring gear body, kept for tests/cycloidal/test_port.py: the turning shell (DEFAULT_CONFIG) prints "
            "its body with j1_link (lib/cycloidal/housing.py build_shell_body) - nothing will place this one")


def build(cfg: DriveConfig = LEGACY_CONFIG):
    h, tol, stack = cfg.housing, cfg.tolerances, cfg.stack_up
    height = stack.ring_gear_body_height                # 51
    bore_zone = stack.bore_zone                         # 28
    seat_top = bore_zone + stack.output_bearing_total   # 48

    result = cylinder(h.od / 2.0, height)
    result = result - cylinder(h.bore_dia / 2.0, bore_zone + NUDGE, z0=-NUDGE)                      # main bore
    result = result - cylinder(h.output_bearing_seat_dia / 2.0, stack.output_bearing_total, z0=bore_zone)   # 6814 seat
    result = result - cylinder(h.lip_bore_dia / 2.0, height - seat_top + NUDGE, z0=seat_top)         # hub clearance / lip
    # 21 blind ring-pin holes from the input face + entry funnels where the pins leave the bore
    pin_dia = ring_pin_hole_dia(cfg)
    depth = ring_pin_hole_depth(cfg)
    funnel_d, funnel_r = h.ring_pin_entry_chamfer_depth, (pin_dia + h.ring_pin_entry_chamfer_add) / 2.0
    slope = (funnel_r - pin_dia / 2.0) / funnel_d
    for xy in ring_pin_points(cfg):
        result = result - cylinder(pin_dia / 2.0, depth + NUDGE, xy, z0=-NUDGE)
        result = result - bd.Pos(xy[0], xy[1], bore_zone - NUDGE) * bd.Cone(funnel_r + slope * NUDGE, pin_dia / 2.0, funnel_d + NUDGE, align=align_min())
    # the M4 housing bolts' through-holes
    m4_r = (h.bolt_dia + tol.bolt_clearance_add) / 2.0
    for xy in housing_bolt_points(cfg):
        result = result - through(m4_r, height, xy)
    # shared outer profile, captive nut pockets on the output face, bevel
    result = result - reveal_window_cutter(cfg, height)
    turn = math.radians(h.bolt_nut_turn_deg)
    for angle, xy in zip(compute_housing_bolt_angles(cfg), housing_bolt_points(cfg), strict=True):
        result = result - hex_pocket(cfg, xy, angle + turn, h.bolt_nut_depth + NUDGE, z0=height - h.bolt_nut_depth)
    return chamfer_outer_silhouette(result, cfg, external_z=height)


def REFERENCE_BUILD():
    """The CadQuery port (LEGACY_CONFIG) - what reference/cycloidal/cycloidal_ring_gear_body.step holds (tests/cycloidal/test_port.py)."""
    return build(LEGACY_CONFIG)


@step(out="cycloidal_ring_gear_body.step")
def cycloidal_ring_gear_body():
    """Return the port's body at its LOCAL origin (input face at z=0; the port's assembly lifted it to z=9)."""
    part = build()
    part.label = NAME
    return part


if __name__ == "__main__":
    cycloidal_ring_gear_body()   # build: writes the sibling cycloidal_ring_gear_body.step
