hbenuid/robotic-arm/cad/parts/cycloidal/cycloidal_ring_pins.py

"""cycloidal_ring_pins - the 21 ring pins (h6 dowels, GearParams.ring_pin_length) on the ring-pin circle, standing on
z=0.

In the drive: at stack z_ring_pins - the port's 4 x 35 (5.5): 3.5 mm in the motor plate, 28 mm across the bore, 3.5 mm
into the ring gear body's bearing-zone wall; the turning shell's 4 x 40 (4): 5 mm in the shell ring's pin ring, 30
across the plates' gap, 5 in the body's pin ring. The disc lobes roll on them.
Ported from cycloidal_drive@2f1f67d src/purchased_parts.py; reference/cycloidal_ring_pins.step is that builder's
export (kind "cots"). No catalog model (the envelope is the geometry); a vendor/cycloidal_ring_pins.step would be
re-oriented by VENDOR_TO_REF into the same frame. The export is the port's 108 mm circle (REFERENCE_BUILD); the model
builds DEFAULT_CONFIG's (lib/cycloidal/params.py RING_INSET).
"""
import pathlib

from cadgen import step

from lib.cots import hybrid, pattern
from lib.cycloidal import DEFAULT_CONFIG, LEGACY_CONFIG, DriveConfig, ring_pin_points
from lib.datum import IDENTITY
from lib.geom import cylinder
from lib.params import CYCLOIDAL_RING_PINS_MASS_G

NAME = pathlib.Path(__file__).stem
COTS = True
MASS_G = CYCLOIDAL_RING_PINS_MASS_G
PURCHASE_SPEC = "{0.ring_pin_dia:g} x {0.ring_pin_length:g} mm h6 hardened ground dowel pin".format(DEFAULT_CONFIG.gear)
PURCHASE_QTY = DEFAULT_CONFIG.gear.num_ring_pins    # pieces per occurrence (the whole pattern)
PURCHASE_NOTE = "sold in packs - buy spares (25)"
VENDOR_STEP = pathlib.Path(__file__).resolve().parents[2] / "vendor" / f"{NAME}.step"
VENDOR_TO_REF = IDENTITY


def _envelope(cfg: DriveConfig = DEFAULT_CONFIG):
    g = cfg.gear
    return pattern(cylinder(g.ring_pin_radius, g.ring_pin_length, xy) for xy in ring_pin_points(cfg))


def REFERENCE_BUILD():
    """The CadQuery port's pattern (LEGACY_CONFIG) - what reference/cycloidal/cycloidal_ring_pins.step holds."""
    return _envelope(LEGACY_CONFIG)


@step
def cycloidal_ring_pins():
    return hybrid(NAME, VENDOR_STEP, VENDOR_TO_REF, _envelope)


if __name__ == "__main__":
    cycloidal_ring_pins()   # build: writes the sibling cycloidal_ring_pins.step
