hbenuid/robotic-arm/cad/parts/cycloidal/_cots.py

"""Shared body of the cycloidal drive's purchased-part modules (parts/cycloidal/bearing_*.py,
nema17_48mm.py, cycloidal_*_pins/bolts/nuts.py) - NOT a part (underscore: not discovered).

Each module keeps the house COTS contract (COTS, MASS_G, VENDOR_STEP, VENDOR_TO_REF, _envelope,
the `@step` model); the geometry of the envelopes is the drive repo's simplified purchased-part model
(src/purchased_parts.py at cycloidal_drive@2f1f67d), which is also the reference STEP.
"""
from __future__ import annotations

from cadgen import build123d as bd
from cadgen import read_step

from lib.datum import to_location


def hybrid(name: str, vendor_step, vendor_to_ref, envelope):
    """Vendor geometry if vendor/<name>.step exists (moved by the VENDOR_TO_REF frame data), else the
    envelope - labelled."""
    part = read_step(vendor_step).moved(to_location(vendor_to_ref)) if vendor_step.exists() else envelope()
    part.label = name
    return part


def pattern(solids) -> bd.Compound:
    """A multi-body pattern part (pins, bolts, nuts) as one compound of separate solids."""
    return bd.Compound([s for shape in solids for s in shape.solids()])
