hbenuid/robotic-arm/(commit log)

2025-10-29 Add initial STM32Cube blink project for Nucleo-F446RE
    Set up PlatformIO project structure for STM32Cube on Nucleo-F446RE, including configuration files, directory READMEs, and a main.c that blinks the onboard LED. This provides a template for further development and testing.
2025-10-29 Add UART output to blink test and improve LED sequence
    Introduces UART initialization and serial output to the blink test, sending status messages during startup and each blink sequence. The main loop now blinks the LED rapidly three times per cycle, with detailed UART messages for each blink and pause, improving debugging and user feedback.
2025-10-29 Add single motor test project for Nucleo-F446RE
    Initial commit of single_motor_test project including PlatformIO configuration, source code for stepper motor control, and documentation for include, lib, and test directories. Provides example stepper motor tests and UART output for debugging.
2025-12-20 3D printed components of the base
    [Base of robot.SLDASM, Editing for Helical gear piece 2.SLDPRT, Editing for Helical gear.SLDPRT, Lazy Susan Bearing part 2.SLDPRT, Lazy susan bearing base 1.SLDPRT, connector for motor.SLDPRT, connector.SLDPRT, stepppper.SLDPRT]
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2026-01-16 Joint 1 of Arm
    [Assem1.SLDASM, Ball Bearing 30x42x7mm.SLDPRT, GT2 Pulley - 20 - 60 teeth.SLDPRT, GT2 Pulley - 90 teeth - J3.SLDPRT, Hermonic drive connection bracket.SLDPRT, Joint 1.SLDASM, Joint 2 coupler.SLDPRT, bar piece 1.SLDPRT]
2026-05-13 removed 3d print files and imported motor test files
    [Assem1.SLDASM, Ball Bearing 30x42x7mm.SLDPRT, Base of robot.SLDASM, Editing for Helical gear piece 2.SLDPRT, Editing for Helical gear.SLDPRT, GT2 Pulley - 20 - 60 teeth.SLDPRT, GT2 Pulley - 90 teeth - J3.SLDPRT, Hermonic drive connection bracket.SLDPRT]
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2026-08-28 Add cad/: build123d CAD workspace scaffolded from the SolidWorks exports
    cad/ is a separate uv project (Python 3.12, build123d 0.10) that the
    motor-control code never depends on. First pass = scaffold + an import
    wrapper for every part + the full arm assembly, so the arm renders and is
    tested before any part is converted to parametric build123d.
    - cadtool: one entry point for the cad@text-to-cad plugin CLIs
    (step/inspect/snapshot/viewer) and uv (pytest/python); exposes the
    plugin's cadpy via PYTHONPATH so `uv sync` can never prune it.
    - lib/: params.py (dimension SSOT), reference.py (SolidWorks naming map,
    loaders, matches_reference), placements.py, assembly.py (AssemblyHelper
    with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
    [base.step, gripper_clamp_bracket.step, gripper_cover.step, gripper_end.step, gripper_finger_left.step, gripper_finger_right.step, gripper_j3_connector.step, gripper_link_1.step]
2026-08-28 cad: adopt text-to-cad plugin v0.4.28 (cadgen, gen/export CLIs, Python viewer)
    The cad@text-to-cad plugin was updated 0.3.2 -> 0.4.28 (user scope; git-lfs
    installed to ~/.local/bin because the marketplace now uses LFS). Breaking
    changes re-integrated:
    - cadgen==0.4.28 (PyPI, same version as the plugin) is a locked dependency;
    requires-python >=3.11. lib/assembly.py imports cadgen.assembly first.
    - cadtool: `step` is gone upstream -> `gen … --write` (alias `step` kept),
    `export` (STL/3MF/GLB), `artifact`, `validate` (urdf/srdf/sdf skills),
    `parts` (step.parts downloader into vendor/), generic `skill <s> <tool>`,
    and `viewer` runs the new Python backend in our venv (VIEWER_CAD_PYTHO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
    [base.step, gripper_clamp_bracket.step, gripper_cover.step, gripper_end.step, gripper_finger_left.step, gripper_finger_right.step, gripper_j3_connector.step, gripper_link_1.step]
2026-08-28 cad: step.parts vendor workflow for purchased parts
    - Every COTS part keeps its SolidWorks re-export in reference/<name>.step as
    the immutable frame/size reference; vendor/<name>.step is the current best
    model and may be replaced. manifest.json gains a `vendor` sub-entry.
    - COTS parts declare VENDOR_TO_REF (vendor-file frame -> SolidWorks frame)
    applied in gen_step(); new test_cots_vendor_matches_reference_frame guards
    swapped models (bbox within 1.5 mm of the reference).
    - Procedure documented in vendor/README.md (`./cadtool parts …`).
    gt2_pulley_20t_bore5_w6 was tried and rejected (analytic simplified,
    Ø18.2 flanges / 10 mm vs the detailed Ø16 / 14.45 mm model); MG996R is n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
    [gripper_rail_6mm.step, gt2_pulley_20t.step, mg996r_horn.step, mg996r_servo.step, nema17_pancake.step]
2026-08-28 cad: robot description (URDF/SRDF/SDF) derived from the CAD
    - robot/frames.py: kinematic SSOT - 7 rigid links partitioning all 34 part
    occurrences, and joint frames (j1..j3 revolute, wrist_roll revolute,
    jaw_a/jaw_b prismatic with mimic, tool0 fixed) computed from the
    SolidWorks capture in reference/placements.json. REP-103 base frame;
    every joint frame has Z on the axis; all joints are 0 at the capture pose.
    - robot/links/<link>.py + robot/_links.py build each link in its own frame;
    tools/export_link_meshes.py writes robot/meshes/<link>.stl (mm, 6.7 MB,
    committed via a .gitignore re-admit).
    - tools/robot_frames.py: joint origins (m/rad, URDF rpy), link inertials
    (OCP BRepGProp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
    [arm.sdf, arm.urdf, base_link.stl, jaw_a_link.stl, jaw_b_link.stl, link1.stl, link2.stl, link3.stl]
2026-08-28 docs: dated CHANGELOG and Last-updated stamps (2026-08-28)
    Add CHANGELOG.md recording the 2026-08-27 scaffold and the 2026-08-28
    plugin update / step.parts workflow / robot description changes with
    their commits; stamp the CAD docs with a Last-updated date and add the
    rule to keep both current.
2026-08-28 cad: cycloidal drive printed parts ported to build123d (lib/cycloidal, CadQuery references, 137 tests)
    - lib/cycloidal/: DriveConfig (frozen, dead fields dropped, magic numbers promoted to tagged
    fields), layout maths (hole patterns, stack_positions from the drive repo's assembly.py),
    numpy epitrochoid, housing helpers (reveal-window cutter, outer-silhouette chamfer, hex
    pockets) and the shared disc builder (periodic spline, chamfer-before-holes).
    - parts/: cycloidal_disc_1/_2, cycloidal_eccentric_shaft, cycloidal_motor_plate,
    cycloidal_ring_gear_body, cycloidal_output_hub - the first CONVERTED parts of the repo.
    - reference/: their CadQuery exports at cycloidal_drive@2f1f67d (kind '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
    [cycloidal_disc_1.step, cycloidal_disc_2.step, cycloidal_eccentric_shaft.step, cycloidal_motor_plate.step, cycloidal_output_hub.step, cycloidal_ring_gear_body.step]
2026-08-28 cad: cycloidal drive purchased parts (envelopes, CadQuery references, step.parts 625 model)
    - parts/: bearing_6003, bearing_6814, bearing_625, nema17_48mm, cycloidal_ring_pins (21),
    cycloidal_output_pins (4), cycloidal_shaft_support_pin, cycloidal_motor_bolts (4),
    cycloidal_housing_bolts (8), cycloidal_housing_nuts (8) - COTS modules whose _envelope() is
    the drive repo's simplified model (shared body in parts/_cycloidal_cots.py).
    - reference/: their CadQuery exports (kind 'cots'); vendor/bearing_625.step from step.parts
    (bearing_625_2rs_sealed_simple, identity frame). The catalog's 'bearing_6003_2rs_sealed_simple'
    is a 24x8 mm bearing and 'stepper_motor_nema17_l0048_single_shaft' h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
    [bearing_6003.step, bearing_625.step, bearing_6814.step, cycloidal_housing_bolts.step, cycloidal_housing_nuts.step, cycloidal_motor_bolts.step, cycloidal_output_pins.step, cycloidal_ring_pins.step]
2026-08-28 cad: cycloidal_drive assembly module attached at the SolidWorks pose (52 leaves / 108 solids)
    - assemblies/cycloidal_drive.py: 18 parts placed from lib/cycloidal stack_positions (the drive
    repo's assembly.py layout, fasteners included), EXPECTED totals lock, --totals helper.
    - assemblies/_occurrences.py: place_at / add_located for code-driven rows, world_rows /
    place_world_at to expand a designed module into world-placed parts.
    - reference/placements.json regenerated: the 'New cyloidal assembly' node is a designed module
    record cycloidal_drive#1 (pose verbatim, SolidWorks totals kept as a cross-check block, no
    descent) instead of a skipped node; lib/reference.py DESIGNED_MODULES, lib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
    [_occurrences.py, arm.py, cycloidal_drive.py, extract_placements.py, test_assembly.py, test_cycloidal_assembly.py]
2026-08-28 cad: robot description - the cycloidal drive rides in link1 (inertials re-derived)
    - robot/frames.py: LINKS['link1'] gains the designed-module key cycloidal_drive#1 (housing in the
    j1_coupler yoke, hub on j1_link: physically a shoulder-pitch joint, NOT modelled as a joint
    yet - [ASSUMPTION]); the j1 note no longer calls the drive its actuator.
    - robot/_links.py, tools/robot_frames.py: links and inertials iterate world_rows(), so a designed
    module expands into its 18 parts (COTS masses / PETG volumes).
    - robot/meshes/link1.stl re-exported (61 solids, 2.79 MB); arm.urdf + arm.sdf link1 inertial
    re-derived (0.895 -> 2.416 kg); URDF ledger rewritten (drive assumption, motor mapping
    unc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
    [arm.sdf, arm.urdf, link1.stl]
2026-08-28 docs: cycloidal drive spec + port notes, README/CLAUDE updates; cad/cycloidal_import removed
    - cad/docs/cycloidal_drive.md: the drive's spec carried over from the cycloidal_drive repo and
    corrected, where things live in cad/, CadQuery -> build123d port notes (idioms, promoted
    numbers, dropped fields, interference budget, OCCT volume caveat), the attachment to the arm,
    the change policy.
    - cad/README.md, cad/CLAUDE.md, cad/reference/README.md, cad/vendor/README.md, root README.md
    and CLAUDE.md: designed part state, the code-driven module, the 16 reference rows, the step.parts
    decisions, the link1 / shoulder-pitch note; CHANGELOG entries for the whole import.
    - cad/cycloidal_import/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
    [test_eccentric_shaft.py, test_motor_plate.py, test_output_hub.py]
2026-08-28 docs: how to view the cycloidal drive and the URDF (viewer, snapshots, OCP)
2026-08-28 cad: tests/cycloidal + tools/{reference,cycloidal,robot} packages, robot/links stubs, cadtool clean
    - tests/cycloidal/: the drive's 10 test modules + helpers.py as a package (tests/__init__.py);
    helper imported as tests.cycloidal.helpers, the exporter as tools.cycloidal.export_cadquery.
    - tools/ grouped by family and made a package: reference/{import_reference,extract_placements},
    cycloidal/{export_cadquery,import_reference}, robot/{frames,export_link_meshes}; shims parents[2];
    test_robot imports tools.robot.frames instead of hacking sys.path.
    - robot/links/*.py: 4-line stubs (a literal def gen_step(), as the plugin's AST lookup needs).
    - cadtool clean [--all]: drops __cadgen__/, __pyc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
    [arm.sdf, arm.urdf]
2026-08-28 cad: parts/ grouped by subsystem (recursive discovery via parts.load), gitignore re-admits parts/**/*.step
    - parts/{base,joints,wrist,gripper,cycloidal}/: every part module moved WITH its committed STEP
    (the plugin pairs siblings; the viewer catalog scans recursively); part names unchanged
    (manifest / reference / placements / URDF keys); templates in parts/_templates/, the drive's
    shared COTS body in parts/cycloidal/_cots.py; path shims parents[2].
    - parts/__init__.py: stdlib-only directory scan -> MODULES / GROUPS, names(), load(name),
    source_of(); duplicate stems raise. Every part import goes through parts.load()
    (assemblies/_occurrences, tools/robot/frames, tests); test_referenc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
    [base.step, bearing_6003.step, bearing_625.step, bearing_6814.step, cycloidal_disc_1.step, cycloidal_disc_2.step, cycloidal_eccentric_shaft.step, cycloidal_housing_bolts.step]
2026-08-28 cad: reference/ split into solidworks/ and cycloidal/ (path_of resolves by origin; manifest file field)
    - reference/solidworks/ (25 SolidWorks exports: CUSTOM + the SolidWorks COTS) and
    reference/cycloidal/ (16 CadQuery exports of the drive: DESIGNED | CYCLOIDAL_COTS);
    manifest.json, placements.json and README stay in reference/.
    - lib/reference.py: REF_SOLIDWORKS_DIR / REF_CYCLOIDAL_DIR, reference_dir(name), path_of()
    resolves the origin from the registries; both import tools write there and record a human
    'file' field; test_reference_match checks it. The manifest gained only the 41 'file' lines
    (every checksum unchanged - the importers were not re-run).
    [base.step, bearing_6003.step, bearing_625.step, bearing_6814.step, cycloidal_disc_1.step, cycloidal_disc_2.step, cycloidal_eccentric_shaft.step, cycloidal_housing_bolts.step]
2026-08-28 cad: track STEP/STL binaries with Git LFS (95 files, 40 MB, no history rewrite)
    - .gitattributes: cad/**/*.step and cad/**/*.stl use the lfs filter (parts, reference, vendor,
    robot/meshes); git add --renormalize converted the 95 tracked binaries to pointers in this one
    commit - history untouched, no git lfs migrate.
    - Clones need git-lfs (already required for the plugin marketplace): without it the work tree
    holds ~130-byte pointer files and the reference-match checksums, import_step and the plugin
    fail until git lfs pull. Every regenerated STEP is a new LFS object.
    [base.step, base_link.stl, bearing_6003.step, bearing_625.step, bearing_6814.step, cycloidal_disc_1.step, cycloidal_disc_2.step, cycloidal_eccentric_shaft.step]
2026-08-28 docs: cad/ layout reorganisation (README/CLAUDE/reference/vendor/cycloidal docs, CHANGELOG)
    - cad/README.md: setup (git-lfs for the repo's own STEP/STL), cadtool table incl. clean, the
    layout tree (parts groups, reference origins, tests/cycloidal, tools packages), part
    conventions (parts/<group>/<name>.py, parents[2] shim, parts.load / parts.names), converting,
    purchased parts, references, robot, tests.
    - cad/CLAUDE.md (commands, authoring, the parts.base group-vs-part gotcha, LFS pointer symptom,
    pytest only via ./cadtool), cad/docs/cycloidal_drive.md, cad/reference/README.md,
    cad/vendor/README.md, root README.md / CLAUDE.md; stale path comments in code; CHANGELOG
    section for th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
2026-08-31 cad: arm assembly grouped into link components (GROUPS, per-group viewer tints)
    assemblies/arm.py gen_step() builds arm -> base_link/link1/link2/link3/wrist —
    the robot/frames.py LINKS partition with the gripper and cycloidal_drive modules
    kept whole — via the new _occurrences.add_grouped_occurrences(), tinting each
    subtree per group (MODULE_TINTS for the two modules) so components toggle and
    read at a glance in the OCP CAD Viewer tree. test_assembly.py locks the group
    labels and the LINKS mirror. Totals unchanged (52 leaves / 108 solids / volume /
    bbox); full suite 413 passed + 9 skipped.
    [_occurrences.py, arm.py, test_assembly.py]
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2026-09-11 cad: adopt text-to-cad v0.5.1 (cadgen 0.5.1: @step models, cadtool over the cadgen CLI, build123d 0.11.1)
    The cad@text-to-cad plugin moved 0.4.28 -> 0.5.1 (user + project scope); 0.5 has no
    compatibility layer with 0.4 (no gen_step(), no generation CLI, no skill scripts, no
    in-tree __cadgen__/). cadgen 0.5.1 is developed against build123d 0.11 / OCP 7.9, so the
    kernel moved with it: on build123d 0.10.0 / OCP 7.8.1 cadgen could not materialize 11 of
    the 41 parts (OCCT 7.8.1 mis-frames BinTools VERSION_4 vertex records), could not export a
    linked child (LazyCompound needs 0.11's `wrapped` property) and its STEP writer needs OCP
    7.9's HArray1.Value.
    - pyproject: cadgen[snapshot]==0.5.1, build1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
2026-09-11 cad: regenerate every part STEP with cadgen 0.5.1
    The 41 committed parts/<group>/<name>.step files rewritten by running the arm model
    (each part a child job): no embedded provenance, pinned timestamp, byte-deterministic
    from here on. Geometry facts identical to the 0.4 files.
    [base.step, bearing_6003.step, bearing_625.step, bearing_6814.step, cycloidal_disc_1.step, cycloidal_disc_2.step, cycloidal_eccentric_shaft.step, cycloidal_housing_bolts.step]
2026-09-12 cad: regenerate every part STEP on OCP 7.9.3 (writer formatting only, geometry unchanged)
    d0cffaa's 41 part STEPs were written by warm daemon workers still on OCP 7.8.1; force-rebuilt per model on the locked kernel after stopping the daemon. 35 files differ only in the STEP header line and COLOUR_RGB float formatting; six carry float noise in DIRECTION/CARTESIAN_POINT values (two housing parts also a different stored tolerance). cadgen inspect diff: same topology/counts, bbox deltas <= 6e-14 mm; targeted geometry tests 61 passed, quick suite 222 passed, arm builds and reads current. CLAUDE.md: deterministic bytes are per kernel.
    [base.step, bearing_6003.step, bearing_625.step, bearing_6814.step, cycloidal_disc_1.step, cycloidal_disc_2.step, cycloidal_eccentric_shaft.step, cycloidal_housing_bolts.step]
2026-09-12 cad: model the cycloidal drive as the shoulder_pitch joint; descriptive link/joint names
    The holder (j1_coupler) yaws on the base and carries the drive's housing + motor; the
    drive's output hub is bolted to j1_link - so the drive is a joint, not a rigid part of
    link1. robot/frames.py splits the old link1 into shoulder_link (holder + drive stator)
    and upper_arm_link (drive rotor + j1_link + j1_cap) with the new shoulder_pitch joint
    about the drive axis, and renames the chain base_yaw / shoulder_pitch / elbow_pitch /
    wrist_pitch (links shoulder_link / upper_arm_link / forearm_link / wrist_pitch_link).
    - assemblies/cycloidal_drive.py BODIES (stator / rotor) + per-body totals lock;
    _occurrenc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
    [arm.sdf, arm.urdf, forearm_link.stl, link1.stl, shoulder_link.stl, upper_arm_link.stl, wrist_pitch_link.stl]
2026-09-13 cad: patch cadgen 0.5.x's URDF renderer so robots render in the viewer and in snapshots
    cadgen 0.5.0/0.5.1 draw every URDF/SRDF/SDF as a pile of huge shards and ignore joint
    values: the robot loader composes each link's linkWorld * visualOrigin * meshScale
    correctly, but common/stepModuleEffects.js displayTransformForPart only applies a part's
    transform when the mesh data declares partTransformsBaked: false, which the URDF builder
    (lib/urdf/kinematics.js buildUrdfMeshGeometry) never sets - 0.4.28 still had the fallback.
    Nothing in robot/arm.urdf or the meshes was wrong.
    - tools/cadgen_patches.py: apply|check|revert the minified flag in the two installed
    bundles (viewer index-*.js, browser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
    [test_tooling.py]
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2026-09-18 cad: emit assemblies/arm.step Z up (it rendered lying on its side in the viewer)
    The arm was composed and written in the SolidWorks capture frame of
    reference/placements.json (+Y up). cadgen 0.5.1's viewer and snapshot renderer hardcode
    +Z as world up, load STEP coordinates verbatim (only GLB gets a Y->Z correction) and have
    no up-axis option - no @step argument, sidecar section, viewer URL parameter, CLI flag or
    env var - so arm.step lay on its side while robot/arm.urdf (REP-103) stood upright.
    - assemblies/arm.py: ARM_FROM_W = robot.frames.BASE_FRAME.inverse() (capture frame ->
    base_link frame: Z up, X forward, the base's mounting face on z = 0), passed as
    add_grouped_occurrences(...,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
    [_occurrences.py, arm.py, test_assembly.py]
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2026-09-18 cad: make every link model buildable, drop dead code, fix stale docs
    - robot/links/{forearm,shoulder,upper_arm,wrist_pitch}_link.py lacked the
    `if __name__ == "__main__"` build call, so `./cadtool gen` on them was a
    silent no-op; tests/source_checks.py now AST-checks the guard for every part
    and every robot/links model.
    - delete lib/export.py (no importers) and the exports/ dir that only it used,
    with their .gitignore / cadtool clean / README mentions.
    - drop five unused hex_prism imports in parts/cycloidal (STEPs byte-identical).
    - stale comments: pyproject path-shim note, .gitignore mesh-tool path, README
    gripper count + tools/robot trees, root CLAUDE.md verb list + Last updated.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
    [cycloidal_housing_bolts.py, cycloidal_housing_nuts.py, cycloidal_motor_bolts.py, cycloidal_output_pins.py, cycloidal_ring_pins.py, cycloidal_shaft_support_pin.py]
2026-09-18 cad: break the assemblies<->robot and lib.params<->lib.cycloidal import cycles
    - lib/datum.py now owns frame(), U, BASE_FORWARD, BASE_BOTTOM_Y and BASE_FRAME;
    robot/frames.py re-exports them and assemblies/arm.py imports the base frame
    from lib/ - assemblies/ no longer imports robot/ (robot/ building on
    assemblies/_occurrences.py is inherent: world_rows reads a designed module's
    OCCURRENCES / BODIES).
    - lib/units.py (IN, NUDGE) is a leaf: lib/cycloidal/geom.py takes NUDGE from it
    instead of importing back up into lib/params.py, which re-exports both.
    - tests/test_layering.py locks lib <- parts <- assemblies <- robot <- tools <-
    tests with an AST scan (plus: no sys.path outside ex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
    [arm.py, frames.py, test_layering.py]
2026-09-18 cad: cycloidal tests reach parts through parts.load(), share CFG and the stack fixture
    - the nine tests/cycloidal modules imported part modules directly
    (`from parts.cycloidal import ...`), which the conventions forbid; they now
    bind `<name> = parts.load("<name>")` and tests/test_layering.py enforces the
    rule for tests/ too.
    - CFG lives once in tests/cycloidal/helpers.py (was pasted into nine files) and
    the identical `stack` fixture moved to tests/cycloidal/conftest.py (was in three).
    [helpers.py, test_assembly.py, test_disc.py, test_eccentric_shaft.py, test_fitment.py, test_housing.py, test_layering.py, test_motor_plate.py]
2026-09-18 cad: give the tools distinct names, share the manifest code
    - tools/robot/frames.py -> tools/robot/derive.py (robot/frames.py is the data,
    this is the tool that derives / checks the URDF + SDF numbers from it).
    - tools/reference/import_reference.py -> import_solidworks.py and
    tools/cycloidal/import_reference.py -> import_cadquery.py: two scripts with one
    name wrote the same manifest; every doc, docstring, test message and the
    URDF / SDF header comments follow.
    - lib/manifest.py (read / write / entry) replaces the ~35 lines both import tools
    duplicated; the two manifest-reading tests use it too. Re-running both tools
    leaves reference/manifest.json byte-identical.
    - CHANGELOG histo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
    [arm.sdf, arm.urdf]
2026-09-18 cad: regenerate j1_link + gripper_clamp_bracket STEPs (numerical-zero terms only)
    Editing lib/reference.py (docstrings naming the renamed tools) made every
    wrapper / COTS part stale; all rebuilt byte-identical except these two, whose
    writer output differs from the 4284a3a build in 12 values <= 1e-17 (direction /
    point components that are geometrically zero). Same solids, faces, volume and
    bbox (|dV| = 0, |d bbox| = 0); --force reproduces the new bytes. Restoring the
    old files would leave them `stale` in ./cadtool why.
    [gripper_clamp_bracket.step, j1_link.step]
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2026-09-18 cad: upgrade to text-to-cad v0.6.5 / cadgen 0.6.5, retire the URDF runtime patch, local ./cadtool inspect
    - pyproject: cadgen[snapshot]==0.6.5; cadquery-ocp (VTK) replaced by an explicit
    cadquery-ocp-novtk==7.9.3.1.1 pin (cadgen 0.6 depends on novtk; vtk, matplotlib and
    their orphans leave the lock). Kernel unchanged: build123d 0.11.1 / OCP 7.9.3.
    - tools/cadgen_patches.py, `./cadtool patch`, the viewer/snapshot warnings and the
    setup/doctor hooks are gone: upstream fixed buildUrdfMeshGeometry in 0.6.0.
    - cadgen 0.6.5 removed `cadgen step inspect`: `./cadtool inspect <file.step> [--planes]`
    and `./cadtool inspect diff <a> <b>` now run the local tools/step_facts.py
    (cadgen.read_scen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
    [arm.py, test_parts_convention.py, test_tooling.py]
2026-09-18 cad: regenerate the 41 part STEPs with cadgen 0.6.5 (canonical sign-of-zero only)
    cadgen 0.6 writes a canonical zero: every `-0.` in the STEP text is now `0.`. Normalising
    that, the old and new files of gripper_link_1 (72 lines) and j1_link (464 lines) are
    line-identical; all 41 keep solids / faces / volume / bbox (kernel facts vs the 0.5.1
    files) and `./cadtool inspect diff` reports the same geometry. A second 0.6.5 build
    reproduces these bytes. Kernel unchanged (OCP 7.9.3).
    [base.step, bearing_6003.step, bearing_625.step, bearing_6814.step, cycloidal_disc_1.step, cycloidal_disc_2.step, cycloidal_eccentric_shaft.step, cycloidal_housing_bolts.step]
2026-09-18 cad: assemblies are native build123d Compounds (AssemblyHelper is deprecated in cadgen 0.6.5)
    - lib/assembly.py: assembly(name, children, *details, color=None) =
    Compound(label=label_text(...), children=[...]); still re-exports cadgen's
    label_shape / label_text (not deprecated).
    - assemblies/_occurrences.py: add_occurrences / add_grouped_occurrences / add_located
    become occurrence_children / grouped_children / located_children and RETURN the
    placed, labelled children; arm, gripper, cycloidal_drive and robot/_links.build_link
    return assembly(name, children).
    - All 11 assembly / link STEPs rebuild byte-identically, 0 FutureWarnings; the suite
    passes with -W error::FutureWarning (58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
    [_links.py, _occurrences.py, arm.py, cycloidal_drive.py, gripper.py]
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2026-09-18 cad: model files no longer load the CAD kernel at import (unchanged models re-run in ~0.1 s)
    cadgen gates a model before paying for OCP only while build123d / OCP are not in
    sys.modules when the model is called; every model file imported build123d at module top.
    - 55 files: `from build123d import ...` -> `from cadgen import build123d as bd` (lazy PEP 562
    proxy), `bd.<name>` inside function bodies only; postponed annotations where needed.
    - Kernel objects built at import become data or functions: the 44 identity frame constants
    (LOCAL_FROM_REF / VENDOR_TO_REF) are lib.datum.IDENTITY frame data turned into a Location
    by to_location() in the body; BASE_FRAME -> base_frame(), ARM_FROM_W -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
    [_cots.py, _occurrences.py, arm.py, base.py, bearing_6003.py, bearing_625.py, bearing_6814.py]
2026-09-21 cad: runs on the arm64 Mac too; the generated part STEPs leave git
    The repo is now worked on from the Fedora PC and an arm64 Mac. Fedora never exercised
    three platform assumptions in cadtool, one test asserted an exact tessellation, and the
    committed part STEPs turned out to be per-machine files.
    - .gitignore: the `!/cad/parts/**/*.step` re-admit is gone and the 41 part STEPs are
    untracked (git rm --cached, kept on disk). cadgen's STEP bytes are deterministic per
    kernel AND per machine: a Mac build rewrote 17 of the 41 with float noise (<= 2e-10 mm,
    same geometry), so each machine's build dirtied the other's files. They are build
    outputs - nothing reads them, every test builds in-pr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
    [base.step, bearing_6003.step, bearing_625.step, bearing_6814.step, cycloidal_disc_1.step, cycloidal_disc_2.step, cycloidal_eccentric_shaft.step, cycloidal_housing_bolts.step]
2026-09-21 cad: arm_no_caps - a working view of the arm without the three link caps
    j1_cap, j2_cap_1 and j2_cap_2 cover j1_link / j2_link, the parts being worked on.
    - assemblies/arm_no_caps.py: arm.py's OCCURRENCES / GROUPS minus HIDDEN (derived, never
    retyped), same base_link frame, component tree and tints, its own git-ignored
    arm_no_caps.step (49 leaves / 105 solids, 51 pinned children). A second model rather
    than a switch in arm(): a model takes no parameters, the freshness gate does not hash
    environment variables and the daemon strips unlisted ones from its workers.
    - arm.py, robot/, the URDF, the meshes and every existing total are untouched - the caps
    stay part of the robot.
    - tests: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
2026-09-21 docs: CHANGELOG entry for the caps-off working view of the arm (arm_no_caps)
2026-09-21 cad: printed vs. bought - lists, colours and STLs from the one COTS label
    An audit of the cycloidal drive's purchased parts: all 10 modelled ones are consistent
    (module, occurrence, mass, reference, manifest; quantities match the spec). The gap: the
    4 arm-mount M4 bolts + 4 captive nuts (and grease) are bought but lived only in a
    hand-written shopping list. Every part already carries the make/buy label once
    (COTS = True = bought, anything else = printed); nothing used it.
    - parts: parts.bought(name) reads the label. The 15 COTS modules (+ _templates/cots.py)
    say what to order next to MASS_G: PURCHASE_SPEC, PURCHASE_QTY (pieces per occurrence -
    the whole pattern for the drive's pin / fas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
2026-09-21 docs: CHANGELOG entry for printed vs. bought (lists, colours, STLs from the COTS label)
2026-09-21 cad: drop arm_make_buy - the arm itself already shows what was bought
    f8b1c8d added two make/buy working views and, in the same commit, made arm.step tint
    every purchased part BOUGHT_TINT grey. With that, the arm view only duplicated the arm
    (a second 17 MB STEP, another arm build in the slow tests) for a one-click hide.
    - assemblies/arm_make_buy.py removed, with its test and its test_lazy_kernel.py entry.
    - assemblies/cycloidal_drive_make_buy.py stays: the standalone cycloidal_drive.step
    links its parts and so stays uncoloured. make_buy_children() loses its now-unused
    `into=` parameter.
    - Docs (CLAUDE.md, cad/CLAUDE.md, cad/README.md) describe the one remaining view and say
    why the a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
2026-09-21 docs: CHANGELOG - the arm make/buy view is gone, the drive's stays
2026-09-21 cad: one STEP per assembly - the gripper and the drive show what was bought themselves
    cycloidal_drive_make_buy.step was a second copy of the drive kept only because the
    standalone cycloidal_drive.step was uncoloured. It no longer needs to be.
    - assemblies/_occurrences.py: occurrence_children(tint=) / located_children(tint=) colour
    a module like the arm - printed parts `tint`, purchased parts (parts.bought()) the one
    BOUGHT_TINT grey, through _tint_parts(). Verified by snapshot: a tint set on a module's
    direct linked children does reach its STEP, so both modules stay linked.
    - assemblies/gripper.py, cycloidal_drive.py: a TINT constant each (the colours they had in
    the arm), passed t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
    [_occurrences.py, arm.py, cycloidal_drive.py, gripper.py, test_assembly.py]
2026-09-21 docs: CHANGELOG - one STEP per assembly, purchased parts grey in each
2026-09-21 cad: ./cadtool daemon stop finds the daemon on macOS too
    `daemon stop` greps the process list for `<cad>/.venv/bin/python3 -m cadgen.daemon`. On
    the arm64 Mac the venv's python3 is a symlink to python and the daemon runs as
    `.venv/bin/python -m cadgen.daemon`: the command printed "no cadgen daemon running for
    this venv" and left the daemon and its workers alive, with whatever code they had loaded.
    - cadtool: the pattern is `python[0-9.]*` (python, python3, python3.12), defined once and
    reused by the pgrep and both pkills.
    - tests/test_tooling.py: locks the pattern against both interpreter names, the workers,
    and against matching another checkout's daemon.
    - cad/CLAUDE.md: the cadgen-bum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
2026-09-22 cad: the belt joints' NEMA 17 x 40 + MKS SERVO42D kits on their pads, the drive's board on its motor
    The SolidWorks arm cut NEMA 17 pads into base / j1_link / j2_link but never placed the
    base_yaw / elbow_pitch / wrist_pitch motors. From the user's nema17x40_with_mks export
    (kept outside the repo next to the monolith, lib.reference.MKS_EXPORT_NAME):
    - tools/reference/split_mks_motor.py splits the kit by geometry into vendor/nema17_40mm.step
    (body + D-shaft, re-framed like the drive motor, shaft trimmed 23 -> 22) and
    vendor/mks_servo42d.step (board + cover + standoffs + M3x30, z=0 at the motor's rear face);
    import_solidworks.py mirrors them into reference/solidworks/ (rel=None, the pan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
    [arm.sdf, arm.urdf, base_link.stl, forearm_link.stl, mks_servo42d.step, nema17_40mm.step, shoulder_link.stl, upper_arm_link.stl]
2026-09-22 docs: CHANGELOG - the belt joints' motors and the drive's MKS board
2026-09-22 cad: the drive motor's vendor file - the real 48 mm body with the 22 mm drive-spec shaft
    The step.parts catalog has one 48 mm NEMA 17 (a 14.8 mm pin, no D-flat) and the datasheet 48 mm
    motor (17HS19-2004S1 - what the user's x48 export models exactly: 24 mm shaft, 15 mm D-cut) is not the
    drive's 22 mm one, so the drive motor's geometry is composed from the user's own two kit exports:
    tools/reference/split_mks_motor.py --write drive takes the x48 export's real 48 mm body (front plate,
    housing, back plate, its two bearings, connector, rotor - 7 solids; tie rods left out, the MKS kit's
    M3x30 replace them), cuts the rotor's shaft off at the mounting face and fuses the x40 export's
    drive-spec shaf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
    [arm.sdf, arm.urdf, shoulder_link.stl]
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2026-09-22 cad: every motor carries the drive motor's pilot and shaft
    The drive's original motor (lib/cycloidal MotorParams: Ø22 x 2 pilot, Ø5 x 22 shaft with the
    18 mm D-cut, flat on +Y) is the correct interface and the other motors must have the same:
    lib/cycloidal/motor.py now exposes pilot() and shaft() (nema17_motor() is built from them,
    byte-identical envelope), and tools/reference/split_mks_motor.py cuts every kit export's own boss
    and shaft off at the mounting face and fuses those on - the x40 body (vendor/nema17_40mm.step,
    2 solids) and the x48 body (vendor/nema17_48mm.step, 7 solids) - checking the tip, the D-cut
    extent, the flat's direction and the pilot face before writing. Measured on al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
    [arm.sdf, arm.urdf, base_link.stl, forearm_link.stl, mks_servo42d.step, nema17_40mm.step, shoulder_link.stl, upper_arm_link.stl]
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2026-09-22 docs: CHANGELOG - the reference shaft is the ruling, the eccentric shaft fits it
2026-09-22 cad: the base_yaw motor is the 48 mm one
    lib/mounts.py places nema17_48mm#1 (the drive's motor, parts/cycloidal) on the base's pad instead of a
    40 mm motor; the elbow and wrist keep nema17_40mm#2..3. MOTORS / board_frame(body_length) replace the
    single MOTOR / BOARD_FRAME. Consequence, locked rather than hidden: the 48 mm motor + board (62.1) reach
    BASE_MOTOR_STACK_PROUD = 6.1 mm below the base's bottom face (56 mm of depth under the plate) -
    lib/params.py, test_params_invariants, tests/test_mounts.py. Mounted records regenerated (100 solids),
    arm 177 / no-caps 174 solids, base_link inertials + mesh re-derived (total 5.288 kg), purchase notes
    2 x 40 mm + 2 x 48 mm kits. ./cadtool pytest: 632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
    [arm.sdf, arm.urdf, base_link.stl]
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2026-09-22 docs: navigation pass - start-here index, recipes + regeneration checklist, open-issues list, git rule, uppercase STEP rules
    What today's session had to reconstruct or discover, written down for the next one: root CLAUDE.md
    states the git workflow (branch, push the branch, main fast-forwarded on request), where the SolidWorks
    sources live and the case-sensitivity note; cad/CLAUDE.md opens with a task index and gains recipes A-E
    (the regeneration checklist is C) plus four verified gotchas; totals are no longer quoted in the prose
    (they live in the test locks); cad/docs/open_issues.md is the one list of unsettled fits, estimates,
    unmodelled hardware and unconfirmed mappings; the README tree na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
    [arm.py]
2026-09-22 cad: text-to-cad v0.6.6 / cadgen 0.6.6
    cadgen[snapshot]==0.6.6 in cad/pyproject.toml + uv.lock (matplotlib, contourpy, cycler,
    kiwisolver return as cadgen's own deps); plugin cad@text-to-cad 0.6.6 in the user and the
    project scope. 0.6.6 is additive (cadgen.eng_drawing); nothing this repo calls changed, no
    model read stale, all 47 STEPs rebuilt byte-identical, suite 632 passed + 8 skipped.
    Docs: cad/README.md, cad/CLAUDE.md (Gotchas: doctor never reads installed_plugins.json).
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2026-09-23 cad: native parts, module mounts, motor/belt leaves - the tooling the forearm roll needs (no geometry change)
    Registry: lib/reference.py NATIVE / NATIVE_COTS + reference/native/ (a part designed here keeps its ACCEPTED
    build as its reference; tools/reference/import_native.py writes it once + the manifest entry;
    import_solidworks.py keeps those entries). tests/test_reference_match.py honours REFERENCE_BUILD (a diverged
    conversion matches its LEGACY build); tests/totals.py makes the arm / link totals locks take a converted
    CUSTOM part's own build instead of its SolidWorks record. lib/mounts.py ModuleMount + MODULE_MOUNTS and
    tools/reference/mount_placements.py write a designed module's placeme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
2026-09-23 docs: CHANGELOG - forearm roll M0 (native parts, module mounts, motor/belt leaves)
2026-09-23 cad: the forearm is parametric - j2_link, j2_cap_1, j2_cap_2 rebuilt in build123d from one ForearmConfig
    lib/forearm/ (params.py ForearmConfig - web, elbow disc, wrist boss, motor slide, sockets, the two caps -,
    layout.py, link.py build_link(cfg), caps.py build_cap_1/2(cfg)), all in j2_link's part frame; the caps carry
    LOCAL_FROM_REF from placements.json (cap 1: +33.5 along N; cap 2: modelled ~1 m from its origin, upside down).
    LEGACY reproduces the three SolidWorks references (REFERENCE_BUILD; volume within 0.5 %, bbox within 0.02 mm)
    and DEFAULT == LEGACY for now - the roll flange wall comes next. Every number measured on the references
    (planar / cylindrical face census: no fillets anywher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
    [forearm_link.stl]
2026-09-23 cad: the forearm's roll end - the flange wall replaces the elbow disc, the wrist motor moves to where a 264-2GT belt puts it
    lib/forearm/params.py RollEndParams (roll axis at y 0, z 25 = the wrist centre's N-station; the wall at x -96..-88,
    z -10..60; the rotor flange's Ø60.3 x 2 locating recess, 4x M3 on Ø46, the Ø28 cable bore; plug clearance 10;
    wrist belt 264-2GT) and DEFAULT = replace(LEGACY, roll=True, motor_x = wrist_x + centre_distance(264) = -136.37,
    slide (-141.5, -130), central slot 22.3 wide (the Ø22 pilot passes - the open-issues row closes), both slots
    shortened to end >= 4 mm before the wall; the lid's window follows the motor and its pocket arc widens r55 -> r50
    so the bo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
    [arm.sdf, arm.urdf, forearm_link.stl]
2026-09-23 cad: the forearm roll drive - the 6th joint: elbow block, hollow roll shaft with its 90T ring, 6808 bearings, the roll motor; elbow_link + forearm_roll in the robot description
    assemblies/forearm_roll_drive.py: a code-driven module (rows from lib/forearm stack_positions, BODIES stator /
    rotor, EXPECTED) placed by lib/mounts.py MODULE_MOUNTS on j2_link's roll axis (module +Z toward the wrist, +X the
    motor side). Stator: the elbow block (the SolidWorks disc's j3_coupler interface + a Ø60 tube: closed end with the
    cable window, the lip, one Ø52.15 seat for both bearings, retainer lugs, the motor pad tower with radial tension
    slots), 2x 6808-2RS (envelope-only NATIVE_COTS bearing_6808), the bo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
    [arm.sdf, arm.urdf, bearing_6808.step, elbow_link.stl, forearm_link.stl, forearm_roll_block.step, forearm_roll_retainer.step, forearm_roll_shaft.step]
2026-09-23 cad: the roll drive's motor, board and 20T rows carry the forearm_roll role - unique leaf labels in the arm (test_arm_assembly_matches_reference_totals)
2026-09-23 docs: CHANGELOG - forearm roll M3 (the roll drive and the 6th joint)
2026-09-23 docs: the forearm roll - docs/forearm_roll.md, the 6-axis chain in every guide, native parts in the reference / vendor READMEs
    cad/docs/forearm_roll.md (new): why the roll and where (the wrist centre), the module frame and every stack station with
    what fixes it, fits and printing, the assembly sequence, the attachment (elbow_link / forearm_link, RollEndParams on
    the forearm side), what is not modelled. cad/README.md (lib/motors + belts + forearm in the tree, the roll drive parts,
    the module, the tests dir, the assembly paragraph with three modules, the chain, the joints and links tables gain
    elbow_link / forearm_roll, the viewer sliders); root README.md (the chain, five kits for three CAN id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
    [mks_servo42d.py, nema17_40mm.py]
2026-09-23 cad: the roll drive laid out like the diagram - motor up in the swing plane, the 90T inside the housing between the bearings, an end cap
    lib/forearm/params.py RollDriveParams re-cut: a Ø70 housing (housing_od) round a Ø62 cavity the shaft's flanged ring
    runs in (bearing 1's Ø52.15 seat + lip at the elbow end, the belt window in the +Y wall, the cable window in the +X
    wall, a FLAT underneath at flat_x -33 - host z -8, 0.5 mm above the upper arm's slab -, two lugs at +X and -Y), the
    bolt-on END CAP (forearm_roll_retainer, name kept: bearing 2's seat + lip, the same flat, two ears, the hard-stop post
    at -X on its outer face), the motor UP in the swing plane (+Y) at (motor_x 18, motor_y 58.2)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
    [arm.sdf, arm.urdf, elbow_link.stl, forearm_link.stl, forearm_roll_block.step, forearm_roll_retainer.step, forearm_roll_shaft.step]
2026-09-23 cad: the elbow block is the elbow coupler - the roll shaft crosses the elbow axis, the forearm starts at 48, j3_coupler#1 retired
    [arm.sdf, arm.urdf, elbow_link.stl, forearm_link.stl, forearm_roll_block.step, forearm_roll_retainer.step, forearm_roll_shaft.step]
2026-09-23 docs: CHANGELOG - forearm roll M6 (the elbow block is the elbow coupler)
2026-09-23 docs: pre-merge summary of cad/forearm-roll (CHANGELOG) + the roll drive's specs at a glance (docs/forearm_roll.md), READMEs on the M6 layout
2026-09-25 cad: drop the OCP CAD Viewer - ocp-vscode, tools/preview.py and ./cadtool show removed; cadgen's viewer + snapshots are the only viewers
2026-09-25 docs: CHANGELOG - cad/ drops the OCP CAD Viewer (ocp-vscode, ./cadtool show)
2026-09-25 tooling: ruff runs by itself - Claude Code PostToolUse hook (.claude/hooks/ruff-check.sh, registered in .claude/ and cad/.claude/settings.json), git pre-commit hook (.githooks/pre-commit, installed b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
2026-09-25 tooling: CI on GitHub Actions - every pushed branch except main gets a clean clone on ubuntu-24.04: LFS pull (cached on the object list), both projects synced frozen + linted, the CLI imports, cad/ f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
2026-09-25 layout: firmware in firmware/stm32/ (was old_stm32_tests/) - a top-level firmware/ with one folder per board; the four Nucleo-F446RE PlatformIO projects move unchanged
2026-09-25 layout: CAD vs everything else - software/control/ (the motor-control uv project, was the repo root) and software/firmware/ (was firmware/); hooks, CI and the VS Code workspace point at software/cont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
    [arm.urdf]
2026-09-25 docs: the software will be worked on later - cad/ and software/ stay one repo, since the software has to match the CAD's robot description (URDF, joint table, drive ratios)
2026-09-25 cad: remove the link caps; j1_link parametric (lib/upper_arm/)
    The covers over j1_link / j2_link are gone: j1_cap, j2_cap_1, j2_cap_2 (part modules, lib/forearm/caps.py + the
    cap params, reference STEPs, CUSTOM rows, manifest entries) and assemblies/arm_no_caps.py (it would equal arm.py).
    Their SolidWorks products are lib/reference.py SKIPPED_PRODUCTS; mount_placements.py's merge mode moves their
    records to placements.json `skipped` (poses kept; 37 part records, 97 solids). j2_link DEFAULT drops the cap
    sockets (LEGACY keeps them).
    j1_link is parametric build123d (lib/upper_arm/: UpperArmConfig, build_link): LEGACY reproduces the SolidWorks
    part (354048.80 vs 354048.81 mm3, same bbox; REFER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
    [arm.sdf, arm.urdf, forearm_link.stl, j1_cap.step, j2_cap_1.step, j2_cap_2.step, upper_arm_link.stl]
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2026-09-25 docs: split cad/CLAUDE.md into a map + per-folder CLAUDE.md files; drop Last-updated lines
    cad/CLAUDE.md (548 lines, 52 KB, loaded whole the moment an agent touches cad/) becomes the map plus the rules
    that hold in every folder: Start here, Recipe C, running things, layering, the lazy kernel, never calling a model
    outside a build, two machines, the cross-folder gotchas, the docs rules (199 lines, 18 KB). Each folder's rules
    move - wording kept - into a CLAUDE.md that Claude Code loads when it reads a file there: parts/ (contract, part
    states, converting, COTS, printed vs. bought, Recipe A), assemblies/ (placements, mounts, modules, tints, Recipe
    B), robot/ (the description + the joint / link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
2026-09-25 docs: remove CHANGELOG.md - the commit message is the record; the old entries are git notes
    CHANGELOG.md duplicated the commit messages: every change took two commits (the change, then an entry naming its
    hash), and the file had grown to 1410 lines nobody read front to back. History is now git log only.
    Nothing is lost: all 71 entries (39 dated sections, 66 sub-entries) were attached as git notes
    (refs/notes/commits) to the 61 commits they describe - 55 by the hash in their heading, 8 by their section's hash,
    2 by a sibling's, 6 (the navigation pass, printed vs. bought) by the change commit their text arrived with.
    Every one of the 1410 lines is in a note; `git log` prints it under the comm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
2026-09-25 docs: say each fact once - READMEs summarise and link, the CLAUDE.md files hold the rules
    Why: the same fact was written in two or three docs, so one change meant several edits (a joint or drive change
    also touched the root README; the lint, CI and history rules lived in both CLAUDE.md files).
    - Root README: the CAD section (joint chain, drives, motor placements, cadtool commands) is a summary + links to
    cad/README.md and cad/robot/CLAUDE.md; Development points at CLAUDE.md, whose rules it repeated; the five-boards
    asides point at cad/docs/open_issues.md (its two rows now name the README sections that still carry them).
    - cad/README.md: Setup keeps the first-time install; pins, plugin u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
2026-09-25 docs: spec docs name the constant or lock instead of quoting counts and totals
    cad/CLAUDE.md "Docs" says docs never quote totals or inventories, but the spec docs did - and those were
    exactly the numbers that had drifted from the code:
    - docs/forearm_roll.md: link masses "forearm_link 0.920 kg; arm total 5.93 kg" (the URDF has 0.759089 kg,
    the links sum to 5.574 kg) -> the URDF inertials + test_link_masses_add_up; the purchased list keeps
    the items and sends quantities to `tools/bom.py --module forearm_roll_drive`; "config.py names three
    boards, the arm carries five" -> no counts.
    - docs/cycloidal_drive.md: "19 rows ... 19 leaves / 77 solids / 679 467.5 mm3 (stator 16 / 71)" and the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
2026-09-25 docs: correct the facts that drifted (CAD docs, root CLAUDE.md, code comments)
    An audit of the docs against the code found statements that are wrong today; future sessions trust them.
    - The reductions contract: software/control/src/config.py's gear_ratio is output turns per motor turn,
    while CYCLOIDAL_RATIO / GT2_RATIO / FOREARM_ROLL_RATIO are motor turns per output turn, and
    lib/belts.py called GT2_RATIO (4.5) a "candidate gear_ratio" - a 20x / 4.5x-squared error waiting for
    the software. robot/CLAUDE.md now states the direction and names all three ratios (it named only
    CYCLOIDAL_RATIO although root CLAUDE.md sends readers there for them); root CLAUDE.md, README.md,
    docs/cycloidal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
    [_cots.py, _occurrences.py, arm.py, nema17_48mm.py]
2026-09-25 cad: robot meshes are checked against a fresh export of their link (slow lane)
    robot/meshes/*.stl are the only generated files that are committed, and the suite only checked that each
    exists and is referenced by the URDF: a geometry change that skipped Recipe C step 8 left a stale mesh
    behind silently (CI runs by hand only, so nothing else would catch it).
    test_committed_mesh_matches_a_fresh_export[<link>] (tests/test_robot.py, slow, one per physical link)
    exports the link with the exporter's own code path - export_link(), factored out of
    tools/robot/export_link_meshes.py together with its TOLERANCE / ANGULAR defaults - into tmp_path and
    compares what the two meshes enclose: volume within 5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
    [test_robot.py]
2026-09-25 tooling: the two .claude/settings.json files are identical, checked by a fast test
    A Claude Code session reads the shared settings file of the directory it starts in only. The root file
    carried the ruff hook AND the cad@text-to-cad plugin (enabledPlugins + extraKnownMarketplaces), but
    cad/.claude/settings.json only the hook - a session started in cad/ ran without the project-scoped
    plugin. The cad/ file is now a copy of the root one, and the rule "keep the two hook blocks identical",
    which nothing checked, is test_claude_settings_are_the_same_in_the_root_and_in_cad
    (cad/tests/test_tooling.py, fast lane): it compares the two files as JSON and says to edit the root
    one and copy it. Checked it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
2026-09-25 tooling: tracked names are lowercase (fast test); line endings pinned for the scripts
    - "Keep every file in the tree lowercase" was written down (root CLAUDE.md) but nothing checked it, and
    the Mac runs git with core.ignorecase=true: a case-only rename there goes unnoticed and reaches the
    Linux PC as a second file. test_every_tracked_name_is_lowercase (cad/tests/test_tooling.py, fast lane)
    runs `git ls-files -z` over the whole repo and allows uppercase only in README / README.md / CLAUDE.md
    basenames (the docs and the 12 PlatformIO stubs). Today it passes; an uppercase scratch path fails it.
    The rule in root CLAUDE.md now names the exception, the test and `git mv -f`.
    - .gitattribu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
    [test_tooling.py]
2026-09-25 cad: print/ has its own ignore rule and cadtool clean --all empties it
    cad/print/ (tools/export_printables.py's STLs) was git-ignored only because every file in it happens to
    be *.stl, and `./cadtool clean --all` emptied snapshots/ but not print/. The root .gitignore now names
    /cad/print/ beside /cad/snapshots/, `clean --all` empties it the same way (bash 3.2; tried on a scratch
    copy, with and without the folder), and the help text and the exporter's docstring say so.
2026-09-25 cad: arm-wide geometry helpers move to lib/geom.py
    lib/cycloidal/geom.py (align_min, cylinder, through, single_solid) called itself "shared by the cycloidal
    drive builders", but 8 modules outside the drive imported it (lib/forearm, lib/upper_arm, three
    parts/joints COTS parts, tools/reference/split_mks_motor.py), and lib/forearm/link.py took hex_prism from
    the drive's housing.py. They now live in lib/geom.py (git mv), with hex_prism and the hex_circumdiameter
    it needs; lib/cycloidal/layout.py imports hex_circumdiameter back and keeps exporting it (lib.cycloidal
    and two tests use it from there), housing.py imports hex_prism for its nut pockets. Every importer is
    re-pointed (7 lib modules, 13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
2026-09-25 cad: every purchased part builds through lib/cots.py
    The vendor-STEP-else-envelope body of a COTS part existed twice: as parts/cycloidal/_cots.py hybrid(),
    used by the drive's 9 purchased parts, and verbatim inline in the 8 others (parts/gripper/
    {gripper_rail_6mm,mg996r_horn,mg996r_servo}, parts/joints/{bearing_6808,mks_servo42d,nema17_40mm},
    parts/wrist/{gt2_pulley_20t,nema17_pancake}) and the COTS template. hybrid() and pattern() depend only on
    cadgen and lib.datum, so the module moves to lib/cots.py (git mv) and every COTS model returns
    hybrid(NAME, VENDOR_STEP, VENDOR_TO_REF, _envelope) - the same condition, transform, label and return
    as the inline copies; their now-unused read_step /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
2026-09-25 tests: the general geometry helpers move to tests/helpers.py
    tests/cycloidal/helpers.py was the drive tests' module, but the geometry helpers in it were every
    geometry test's: tests/test_mounts.py, tests/upper_arm/test_j1_link.py and tests/forearm/ imported
    interference / is_inside from it (tests/forearm/helpers.py re-exported them with a noqa). The general
    ones - is_inside, interference, end_face, radial_extent, section_area, probe_volume, mesh_volume,
    spline_deviation, fingerprint, annulus - now live in tests/helpers.py with the CadQuery-idiom table;
    tests/cycloidal/helpers.py keeps the drive's CFG, no_chamfer and ring_pins; tests/forearm/helpers.py
    keeps in_host and drops its re-export. E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
    [helpers.py, test_assembly.py, test_disc.py, test_fitment.py, test_housing.py, test_j1_link.py, test_mounts.py, test_output_hub.py]
2026-09-25 docs: tools/, reference/ and vendor/ get their own CLAUDE.md (their rules now auto-load)
    A folder's CLAUDE.md loads when Claude works there; a README does not. reference/ and vendor/ had only
    READMEs, yet held rules (Recipe D, Recipe E, never edit, the regeneration order, written once on one
    machine), and tools/ had no doc at all - its rules were implied or scattered.
    - cad/tools/CLAUDE.md: the tools' rules (run via ./cadtool python; not models: may import build123d at
    module level, build in-process; export_cadquery.py's venv and its sys.path line; the tools that write
    committed files run only by their recipe, STEP/STL writers on one machine) + a table of every tool.
    - cad/reference/CLAU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
2026-09-25 docs: cad/CLAUDE.md says each rule once
    cad/CLAUDE.md loads in every CAD session and restated what other files already hold:
    - "Running things" described commands `./cadtool help` and the README table already list (gen, why,
    store, snapshot, viewer, daemon stop, inspect with its cadgen 0.6.5 history, the totals() one-liner);
    it now keeps only the rules (bare python, cadquery-ocp, models are scripts + the freshness gate,
    assemblies call their children + pull semantics, look at what you built, read_scene for anything
    inspect doesn't answer, pytest only via cadtool, lint fixes make models stale). The command details that
    existed nowhere else moved into `./cadtool help` (--planes' outp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
2026-09-25 docs: the motor-control docs move to software/control/; the root README becomes a repo overview
    The root README was ~70% motor-control material (hardware, setup, configure, run, the file tree, known
    issues) and the root CLAUDE.md carried the software's Code layout and Known issues - loaded into every
    CAD session - while cad/ has its own README + CLAUDE.md and software/ had neither. The software file
    tree was written twice (README "Project structure", CLAUDE.md "Code layout"), and both intros still
    called the repo a "3-motor MKS SERVO42D/57D arm": the CAD arm carries five SERVO42D (tools/bom.py).
    - software/control/README.md (new): hardware (config.py names three boards, the arm carries more,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
2026-09-26 cad: base becomes parametric (lib/base/)
    The base was still the imported SolidWorks shape; its bearing bore has to be code before its seats can be
    fixed for the 6806 pair the user fitted at base_yaw (a later commit). This commit changes no geometry.
    - lib/base/ (a leaf like lib/upper_arm/, in tests/test_layering.py LEAF_PACKAGES): params.py BaseConfig
    (shell, cap, bore, plate, motor seat; LEGACY = the SolidWorks part, DEFAULT = LEGACY for now), layout.py
    (motor_holes, side_stub_x, chamfer_inset), body.py build_base(cfg) - the D wall, the cap with its 45 degree
    chamfer, bearing boss, bore, groove and seat ring (r 0.5 rounds), the motor plate with its openings, the U rim
    round the moto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
    [arm.sdf, arm.urdf, base_link.stl]
2026-09-26 cad: j3_coupler becomes parametric (lib/coupler/)
    The wrist's coupler was still the imported SolidWorks shape; its stub needs an inner-ring shoulder so the
    wrist's 6806 pair clamps (a later commit), so it becomes code first. This commit changes no geometry.
    - lib/coupler/ (a leaf, in tests/test_layering.py LEAF_PACKAGES): params.py CouplerParams (the Ø78 flange with
    4x M4 counterbored at r 35, the Ø58/62 dust-lip ring, the Ø40 journal, the Ø30 stub, the Ø12.5 bore, the
    90T's 4x M4 at r 11 from 6.85 AF x 2.8 hex nut pockets; LEGACY = the SolidWorks part, DEFAULT = LEGACY for
    now), layout.py (pulley_bolt_points, flange_bolt_points), body.py build_coupler(cfg).
    - parts/joints/j3_coup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
2026-09-26 cad: the belt joints' 6806-2RS bearing stacks (base_yaw, elbow_pitch, wrist_pitch)
    The user fitted two 30 x 42 x 7 bearings (6806-2RS / 61806) at each belt joint; the housings are cut for them
    (a bore split by a lip, one bearing each side) but neither the SolidWorks capture nor the model had them, and the
    docs called the elbow's "6702-class" (a 6702 is 15 x 21 x 4). Measuring the stacks found three fits that did not
    close; all three are fixed here, three others are recorded.
    - lib/bearings.py (a leaf, re-exported by lib/params.py): BEARING_6806_BORE / OD / WIDTH 30 / 42 / 7, the
    inner-ring shoulder Ø33, BEARING_6806_MASS_G 26 [ESTIMATE: the 6808's by ring area].
    - parts/joints/bearing_680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
    [arm.sdf, arm.urdf, base_link.stl, bearing_6806.step, elbow_link.stl, forearm_link.stl, forearm_roll_block.step, upper_arm_link.stl]
2026-09-26 tests: the bearing-stack overlap check takes the suite's 1 mm^3 budget
    CI (x86_64 Linux, run 36211915866) measured 0.0548 mm^3 between an elbow bearing and a neighbour where arm64
    macOS measures 0: the elbow's upper seat (Ø42.0) and the Ø30 stubs / hubs are line-to-line, and the boolean of
    coincident faces leaves per-machine float noise (cad/CLAUDE.md "Two machines": no exact float thresholds).
    test_bearing_stacks now asserts < 1.0 like test_motors_and_boards_clear_their_neighbours; a real misfit is far
    above it (0.1 mm across a bearing's face ~68 mm^3, the old pulley-ring clash 363 mm^3). Its contact-face checks
    (1e-3 mm on the stations) passed on CI unchanged.
    [test_mounts.py]
2026-09-26 cad: the elbow's and the wrist's stubs reach the re-seated pulleys (bolted flat again)
    The 90T pulley and the part above it are one bolted joint (4x M4: into the elbow block's heat-set inserts, through
    j3_coupler into nuts in its flange pockets) - which is why SolidWorks had them touching. Re-seating the pulleys
    PULLEY_SEAT_SHIFT (3.0) out on their lower bearings left a 3 mm gap: the screws spanned air and the pulley's torque
    would have run through the bearings. Each stub now reaches that much further, on through the lip, and ends on the
    pulley's hub: a solid face-to-face joint again, the pulley where it is. The stub's 2 mm inside the lip spaces the
    two inner rings exactly as the lip spaces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
    [arm.sdf, arm.urdf, elbow_link.stl, forearm_roll_block.step, wrist_pitch_link.stl]
2026-09-26 cad: the elbow 90T bolts into captive nuts in the elbow block (heat-set inserts retired)
    Every other 90T in the arm is held by a bolt and a nut: at the wrist 4x M4 run from the pulley's outer face through
    j3_coupler into hex nut pockets in its flange's underside, the face wrist_link then covers. The elbow was the
    exception: the roll drive's block took j3_coupler#1's place, and its M4s ended in 8 mm heat-set inserts. The block has
    no free face for a pocket: the bolts run up the elbow axis straight at the roll shaft's core bore, only 6.7 mm of
    floor above the underside. So the pocket opens onto the face the next part covers, as at the wrist - here the core
    bore, which the roll shaft fills: eac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
    [arm.sdf, arm.urdf, elbow_link.stl, forearm_roll_block.step]
2026-09-26 cad: the elbow and wrist 90T bolts and nuts are modelled (the 90T's holes opened to M4 clearance)
    Each belt joint's 90T is clamped flat onto the part above it by 4x M4 screws and nuts, but none of that hardware was
    in the model: the elbow's were two tools/bom.py EXTRAS rows, the wrist's only an open_issues.md "Not modelled" row
    (46.8 mm of screw needed, so M4 x 50). They are now four purchased pattern parts, mounted like the bearings (Recipe B),
    riding with elbow_link / wrist_pitch_link. The SolidWorks 90T's Ø3.9 holes took no M4 shank (53.1 mm^3 of overlap per
    joint), so the pulley's model opens them to M4 clearance and the printed pulley takes the screws as is.
    - lib/fasteners.py (new lea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
    [arm.sdf, arm.urdf, elbow_link.stl, elbow_pulley_nuts.step, elbow_pulley_screws.step, wrist_pitch_link.stl, wrist_pulley_nuts.step, wrist_pulley_screws.step]
2026-09-26 cad: j1_link's elbow relief - the elbow block clears the upper arm by 2.0 mm (was 0.5)
    The roll drive's block turns with the elbow over j1_link. Its flat underside and its end cap's, swept out to r 57.6
    about the elbow axis, rode 0.5 mm above j1_link's top face (the slab's 1.5 mm lip), and its Ø62 boss 0.5 mm above
    the Ø80 recess floor, at every elbow angle. Those are printed PETG faces, and the forearm's moment tilts the block on
    a 16 mm bearing base: 0.5 mm is only 0.5 deg of tilt at r 58, so they would rub. The tests missed it because every
    check was overlap volume < 1 mm^3, which a 0.5 mm gap, or contact, passes.
    - lib/upper_arm/params.py ElbowParams: new relief_r (0 = none: LEGACY, th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
    [arm.sdf, arm.urdf, upper_arm_link.stl]
2026-09-26 cad: elbow_pitch limited to +/-90 deg (the forearm wall hit the upper arm past +/-93)
    The forearm roll put j2_link's wall 48 mm from the elbow axis, 3 mm outside j1_link's r 45 end, and its lower edge
    (host z -10) sits 1.5 mm below j1_link's top face (-8.5). Folded past 90 deg, the wall swings over the upper arm's
    side. closest_points goes 3.04 mm (90 deg) -> 1.14 / 0.27 mm (+93 / -93) -> contact at +/-94. The 120 deg estimate
    drove the wall into j1_link: 520 / 534 mm^3 of overlap at +/-120 with the roll at 0, and 1.0-4.0 cm^3 rolled. No test
    folded j2_link against j1_link, and the roll sweep ran only with the elbow straight. At +/-90 the wall keeps
    >= 2.59 mm at every roll (0, +/-45, +/-90,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
    [arm.sdf, arm.urdf]
2026-09-26 cad: j1_link's elbow relief 1 mm deeper, the recess down to the bearing (gaps 3.0 / 2.0)
    More room between the elbow block and the upper arm it turns over. The underside gaps were 2.0 mm and the boss's
    1.5 mm; that is still little for printed PETG faces with the forearm's moment tilting the block on its 6806 pair.
    The boss can't get more than this without changing the block: the recess floor now sits level with the upper 6806's
    top face (j1 y -6.0), leaving the seat exactly BEARING_6806_WIDTH (7.0) deep.
    - lib/upper_arm/params.py ElbowParams: new relief_y, the relief's floor (0 = the lip's root). DEFAULT relief_y -1.0
    (host -11), recess_y -5.5 -> -6.0. lib/upper_arm/link.py cuts the relief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
    [arm.sdf, arm.urdf, upper_arm_link.stl]
2026-09-26 docs: open_issues - the base_yaw thrust bearing in the base's groove (not modelled)
    The base's cap has an annular groove round the seat ring, meant for a thrust
    bearing, but no bearing was chosen or modelled and no row said so. New row under
    "Not modelled yet".
    Measured on the arm (assemblies/arm.step): the groove is Ø65.1 / Ø90.2
    (CapParams.groove_r), 3.0 deep from the top face (groove_y0); j1_coupler's
    underside stands 3.9 above the groove floor over it (0.9 above the top face),
    but sits flush on the base's top face outside it (closest distance 0.0, no
    overlap) - as modelled the coupler turns on the base's face, not on a bearing.
    The groove fits a 65 x 90 axial bearing.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
2026-09-27 cad: the roll motor's plate is a separate bolt-on mount, its cheeks removed (forearm_roll_motor_mount, 4x M3x12 countersunk into captive nuts)
    The forearm roll motor's vertical plate and its two cheeks were fused onto the top of the elbow block
    (forearm_roll_block). That meant supports under a 48 mm overhang when the block prints front face down, and a reprint of
    the whole block for any change to the mount. The mount is now its own printed part fastened with bolts and nuts, and
    the cheeks are gone (they were judged unnecessary).
    The motor's height is fixed by the 240-2GT roll belt, and its board sits only 3.4 mm above the block's top at the
    nominal slot position (0.9 at the slot's low end).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
    [arm.sdf, arm.urdf, elbow_link.stl, forearm_roll_block.step, forearm_roll_motor_mount.step, forearm_roll_mount_nuts.step, forearm_roll_mount_screws.step]
2026-09-27 cad: the roll motor mount - plain base in a pocket, one 4 mm thickness, nuts pressed in from the bore
    This revises forearm_roll_motor_mount (the previous commit) after a review in the viewer:
    - The base should not carry the block's rounded edges.
    - The plate was too thin, and should match the base.
    - The nuts should sit on the other side of the block's top wall, not in slide-in channels from the rear face.
    A bolt cannot go straight through the block under the mount: its middle is the core bore the roll shaft turns in. The
    nuts therefore press into hex pockets on the inside of the top wall, the way the elbow pulley's nuts sit, and go in
    from the bore before the shaft.
    - The base is a plain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
    [arm.sdf, arm.urdf, elbow_link.stl, forearm_roll_block.step, forearm_roll_motor_mount.step, forearm_roll_mount_nuts.step, forearm_roll_mount_screws.step]
2026-09-27 cad: the roll motor mount's screws M3x12 -> M3x16, the nuts seated as near their pockets' mouths as bearing 1 allows
    With M3 x 12 each nut sat 3.6 mm (on the pocket's high side) to 8.8 mm (its low side) up its hex pocket from the core
    bore, a deep press from inside the bore. A longer screw lets it sit lower.
    - The nut's seat is now set by its clearance to the core bore, not by the screw's tip. mount_nut_clear 1.0 is the
    nut's inner flat outside the bore, since bearing 1 slides past the pockets' mouths before the mount goes on.
    - y_mount_nut 27.4 -> 25.043 (each nut 2.36 lower); the nut's lower face 22.643, 1.2 mm above the pocket mouth's
    high side.
    - The top wall over the nut goes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
    [arm.sdf, arm.urdf, elbow_link.stl, forearm_roll_block.step, forearm_roll_mount_screws.step]
2026-09-27 cad: j1_coupler is parametric (lib/yaw_coupler/, LEGACY reproduces the SolidWorks part)
    j1_coupler was the last SolidWorks wrapper on the arm's joint chain, and two
    docs/open_issues.md rows (the unclamped base_yaw 6806 stack, the empty thrust
    groove) wait on its conversion. This commit is the port only: DEFAULT = LEGACY,
    no design change. The thrust bearing and the pulley-ready stub follow as their
    own commits.
    New package lib/yaw_coupler/, built like lib/coupler/ and lib/base/:
    - params.py YawCouplerConfig of HubParams (the recess, stub, bore, 4 holes),
    DiscParams (the drafted disc, flats, ears, ring) and YokeParams (the flare,
    the -X cheek, the middle body with its V-grooves, the crad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
    [arm.sdf, arm.urdf, shoulder_link.stl]
2026-09-27 cad: the base_yaw thrust bearing (AXK 6590 + 2x AS 6590) seats j1_coupler
    j1_coupler turned on the base's top face: its SolidWorks rim sat flush on it,
    and the base's annular groove round the seat ring (Ø65.1 / Ø90.2, 3.0 deep)
    was empty (docs/open_issues.md). The user chose a thrust bearing in the
    groove to set the coupler's height. The alternative, the clamped 6806 pair
    (j3_coupler's shoulder), would over-constrain the joint with a thrust
    bearing under it. So the coupler gets no inner-ring shoulder: the upper 6806
    locates it radially only.
    The bearing (lib/bearings.py THRUST_*, re-exported by lib/params.py):
    - INA AXK 6590 needle cage 65 x 90 x 3 between two AS 6590 washers
    65 x 90 x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
    [arm.sdf, arm.urdf, base_link.stl, bearing_axk6590.step, shoulder_link.stl, washer_as6590.step]
2026-09-27 cad: j1_coupler's stub runs to the lip, drilled for a base_yaw 90T
    The last step of the j1_coupler conversion. Its hub now takes the base_yaw
    90T the way j3_coupler's takes the wrist's, so the pulley, when it is
    modelled, bolts on with no change to the coupler. The SolidWorks hub could
    not take it:
    - the stub (Ø29.8) stopped 0.2 into the lip, 1.1 short of the lip's lower
    face, where the pulley's hub end meets it;
    - its 4x Ø3.3 holes (r 10.6) are not the 90T's pattern;
    - its Ø15 bore left 1.45 of wall to them.
    lib/yaw_coupler DEFAULT [DESIGN] (HubParams gains nut_af / nut_depth;
    LEGACY has none):
    - stub Ø29.8 -> BEARING_6806_BORE Ø30 (line-to-line in the bearings, like
    every stub -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
    [arm.sdf, arm.urdf, shoulder_link.stl]
2026-09-27 tooling: cadgen and the cad@text-to-cad plugin 0.6.6 -> 0.7.2
    0.7.0 rebuilds the CAD Viewer: picking and hovering on large assemblies go
    from seconds to well under one (upstream's 1,450-part benchmark: entering
    Faces mode 30-35 s -> 0.3 s, hover sweep 33-43 s -> under 0.6 s), with
    per-format renderers, display presets (Solid, Render, X-ray, Hidden line,
    Wireframe, Grid) and viewer state kept per browser tab. It also rewrites the
    snapshot CLI on the viewer's scene code: `--render` is gone, `--display`
    takes a preset or grouped JSON, and the old mode names are refused.
    0.7.1 is a Windows-only publish-race fix, and 0.7.2 bumps only the
    JavaScript dependencies (the Python package is unchanged).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
2026-09-27 cad: forearm_roll_drive.py ends with its build call, and a test checks every assembly does
    assemblies/forearm_roll_drive.py never had the `if __name__ == "__main__":
    forearm_roll_drive()` line that cad/CLAUDE.md asks of every model file, so
    `./cadtool gen assemblies/forearm_roll_drive.py` silently built nothing. The
    drive was only ever built as the arm's child, and a forced rebuild of the
    arm did not rewrite its STEP (the child read current). Nothing checked for it:
    tests/source_checks.py runs_its_model() covered parts and robot links but
    not assemblies.
    - assemblies/forearm_roll_drive.py: the `__main__` build call, as in
    cycloidal_drive.py.
    - tests/test_assembly.py: test_every_assembly_r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
2026-09-28 docs: open_issues names every part not converted yet, one row each
    The unconverted parts were one vague "Most custom parts are still SolidWorks
    wrappers" row under Known-broken / pending. It listed the parts already
    parametric (parts/CLAUDE.md "Part states" holds that list) and not the ones
    left, and it ended with a stale clause, "the fit problems above are fixed at
    conversion": every fit problem above now belongs to a converted part.
    A new section, "Not converted yet", replaces that row and gives each part
    still built from its SolidWorks export its own row, with its robot link and a
    note. The rows are the 11 wrappers (CONVERTED = False), from wrist_link and
    gripper_clamp_bracket through th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
2026-09-28 cad: the base's motor lobe is a bolt-on part (base_motor_mount, 4x M4 into captive nuts), the motor slotted at the 280-2GT's centre distance
    The base printed as one piece: the round bearing tower and the box-shaped +X lobe whose 5 mm plate carries the
    base_yaw 48 mm motor. A change to the motor seat or the belt meant reprinting the whole base, and the lobe's plate and
    U rim printed as a large overhang. The lobe is now its own part, bolted back on across a vertical joint face at
    x = split_x (55, 1.66 past the tower's round), so it can be reprinted or swapped alone and prints plate down without
    supports.
    The joint: a rib inside each side wall on both parts (rib_w 12 deep, rib_t 8 thick, from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
    [arm.sdf, arm.urdf, base_link.stl, base_motor_mount.step, base_motor_mount_nuts.step, base_motor_mount_screws.step]
2026-09-28 cad: base_motor_mount narrows to the motor + 10 mm of wiring room, bolted by outward ears; the base's end opens into it
    The motor mount was the whole SolidWorks lobe, the base's full width (106.7). The motor only needs room round it for
    its wiring, so the mount is now a box of its own round the motor and its MKS board.
    The mount:
    - Inside, MountParams.room 10 clear of the board's 43 mm square: the walls ±31.58 inside (±36.58 outside, 73.2 wide).
    The end wall's inside is 10 past the board at the slots' middle, 7.5 at full tension; its outside moves
    114.84 -> 118.47.
    - Walls wall 5, from the bottom face (it still stands on the table) up to the plate's top. The plate keeps the
    motor's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
    [arm.sdf, arm.urdf, base_link.stl, base_motor_mount.step, base_motor_mount_nuts.step, base_motor_mount_screws.step]
2026-09-28 cad: base_motor_mount loses the U rim under its plate
    The mount still carried the SolidWorks base's U rim: a 2 mm wall, 7 deep, hanging under the plate round three sides
    of the motor's face, 0.3 mm clear of it. It is not wanted. The motor is located by its 4 M3s in the slots (Ø3.4 for
    an M3: ±0.2 across them), so nothing hangs under the plate now.
    - lib/base/body.py: build_motor_mount no longer adds _rim. _rim is the SolidWorks base's only again: its ends on the
    shell's round, the joint branch gone. build_base(LEGACY) is unchanged (286169.1 mm^3, the reference match), and so
    is build_base(DEFAULT) (the base's STEP is byte-identical).
    - lib/base/params.py: DEFAULT drops its slot_x1 ove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
    [arm.sdf, arm.urdf, base_link.stl, base_motor_mount.step]
2026-09-28 cad: gt2_pulley_90t is parametric build123d (lib/pulley/)
    The 90T pulley was the last part outside the wrist and the gripper whose model still loaded
    its SolidWorks export (it only cut the bolt holes out to M4_CLEAR), so it could be moved but
    not re-sized. It is now built from PulleyParams on the lib/coupler/ pattern: LEGACY reproduces
    the export (REFERENCE_BUILD), DEFAULT - what the part builds - opens the bolt holes to
    M4_CLEAR, as the model did before.
    The GT2 groove is the export's own, measured on it: an R0.555 bottom, R1.0 flanks centred on
    the land circle 0.8 deg across the centreline, R0.6385333225 blends, R0.15 fillets onto the
    land. The blend and fillet centres are solved from tan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
    [gt2_pulley_90t.py, test_layering.py, test_params_invariants.py]
2026-09-28 cad: wrist_link is parametric (lib/wrist/, LEGACY reproduces the SolidWorks part)
    The wrist body was still the imported SolidWorks shape, so none of its features could be re-sized; it becomes code
    first. This commit is the port only: DEFAULT = LEGACY, no design change. Every number was measured on the reference
    (face / vertex census) [REFERENCE].
    - lib/wrist/ (a leaf, in tests/test_layering.py LEAF_PACKAGES): params.py WristConfig (PlateParams, SeatParams,
    TowerParams, EndFaceParams; LEGACY = the SolidWorks part, DEFAULT = LEGACY), layout.py (seat_bolt_points,
    end_face_holes, slope_x), link.py build_wrist_link(cfg).
    - parts/wrist/wrist_link.py: CONVERTED = True, REFERENCE_BUILD = build_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
    [arm.sdf, arm.urdf, wrist_pitch_link.stl]
2026-09-28 cad: the roll shaft's 90T ring takes the GT2 groove of lib/pulley/
    The roll shaft's integral 90T (forearm_roll_shaft) cut its own groove: an R0.555 bottom with
    straight sides to the land, a stand-in whose radius lib/belts.py tagged [ESTIMATE] until it
    was measured on the SolidWorks 90T. The previous commit measured and ported that groove;
    build_shaft now takes gt2_ring() from lib/pulley/teeth.py, so both printed 90Ts cut one tooth
    form and a groove clearance tuned after the first print is one change. lib/forearm/pulley.py
    (the old ring and groove_centre_radius) is removed. The ring keeps its width, flanges and
    place; its flanges stay unchamfered.
    Measured:
    - forearm_roll_shaft: 95242.441 ->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
    [forearm_roll_shaft.step]
2026-09-28 cad: base_motor_mount's walls become V trusses, 4 mm thick
    The mount's solid 5 mm side walls and end wall were ~63 % of its plastic, but they carry little. The belt's pull
    runs along the plate straight into the ears, and the top M4 sits 8 mm under the plate. The motor and its board weigh
    ~0.44 kg. The walls only stand the plate on the table and keep the ears square. They are now open V trusses: less
    plastic and weight, and the wiring can be reached from the sides and the end.
    Each wall below the plate keeps a frame, MountParams.strut 6 wide:
    - a rail under the plate and a rail on the table;
    - a post at each end, from the outer corner, so the corner posts take in the other wall. The side wal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
    [arm.sdf, arm.urdf, base_link.stl, base_motor_mount.step, base_motor_mount_nuts.step, base_motor_mount_screws.step]
2026-09-28 cad: the drive housing has 6 pillars, j1_coupler's yoke holds the two at +/-30 degrees
    The cycloidal drive's housing (motor plate + ring gear body) goes from 8 outer
    pillars to 6: HousingParams.bolt_count 8 -> 6, the same 0-degree start, so the
    pillars and their M4 housing bolts sit at 0, 60 .. 300 degrees from the drive's
    +X. Three bolts now line up with ring pins 0 / 7 / 14, 8.5 mm out, as the
    port's bolt 0 already did; the pillar trapezoid (18 / 10) is unchanged, so the
    windows at the bore widen from ~28 to ~43 mm.
    The port stays checkable. lib/cycloidal/params.py keeps the CadQuery port as
    LEGACY_CONFIG and builds DEFAULT_CONFIG (bolt_count 6). The motor plate, the
    ring gear body and th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
    [arm.sdf, arm.urdf, shoulder_link.stl]
2026-09-28 cad: the base and its motor mount reach 11.1 mm lower, the base_yaw motor's board 5 mm clear of the table
    The base_yaw 48 mm motor and its MKS board (48 + 14.1 under the motor mount's plate) hung 6.1 mm below the base's
    bottom face, the SolidWorks y -100.9, so the arm could not stand on a table. The bottom face now sits BOARD_CLEAR
    (5.0) under the board: y -100.9 -> -112.0 (DEFAULT.shell.y0, from the plate, the motor's body length, the board stack
    and the clearance). The base's D walls and posts and the whole motor mount reach down to it. The truss walls are
    taller, so their struts are steeper: 61.2 -> 66.3 deg in the side walls, 56.1 -> 61.8 in the end wall. Their bridges
    are about the same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
    [arm.sdf, arm.urdf, base_link.stl, base_motor_mount.step, base_motor_mount_nuts.step, base_motor_mount_screws.step]
2026-09-28 docs: tests/CLAUDE.md lists tests/pulley/
    The gt2_pulley_90t port added tests/pulley/ without naming it in the suite's map of test folders.
2026-09-28 docs: the repo's GitHub settings allow only merge commits
    Squash and rebase merges are now off in the robotic-arm repository's GitHub settings (allow_squash_merge
    and allow_rebase_merge false, allow_merge_commit true), so a pull request's merge button can only make the merge
    commit the Git workflow asks for. The workflow bullet said GitHub offered all three; it now says the settings allow
    only merge commits.
2026-09-28 tests: interference() runs each boolean once and skips pairs whose boxes are apart
    tests/helpers.py interference() built BRepAlgoAPI_Common(a, b) and then called Build(): the two-shape
    constructor already runs the boolean, so every overlap check ran it twice. It also ran the boolean on
    pairs hundreds of mm apart (test_mounts' clearance loop checks every mount against every neighbour
    across the whole arm).
    Now it compares the two shapes' Bnd_Boxes first (BRepBndLib, from the geometry, so meshes stay as they
    are) and returns 0 when they are apart; otherwise it sets the operands on an empty operator,
    non-destructive (the default mode may modify the operands), and builds once.
    Same results: ol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
    [helpers.py]
2026-09-28 tests: drop the slow tests that repeat another test or cannot fail
    An audit of the slow lane for checks another test already makes (same or stronger) or that cannot fail. Each
    one removed, and what still covers it:
    - test_assembly.py test_cycloidal_drive_module_builds / test_forearm_roll_drive_module_builds: the drives'
    leaves / solids / volume are their own EXPECTED locks, held by tests/cycloidal/test_assembly.py
    test_module_totals_match_lock and tests/forearm/test_roll_drive.py test_totals_and_bodies. Their one unique
    check, the standalone colours, moves into those files (test_module_colors); _check_module_tints and its
    helpers move to tests/helpers.py (module_tints, leaves, same_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
    [helpers.py, test_assembly.py, test_disc.py, test_fitment.py, test_housing.py, test_mounts.py, test_parts_convention.py, test_reference_match.py]
2026-09-28 tests: the roll drive's clearance sweeps keep only the cases that can differ
    tests/forearm/test_roll_drive.py swept angles whose results cannot change, each case rebuilding the roll-drive
    module and the links. Every value was measured at every sampled angle first:
    - test_forearm_clears_the_elbow_while_rolling (4 roll angles, ~12 s each): rolling about the roll axis (host
    -X) keeps every point's x. j2_link spans x -255 .. -48.000 (its wall's elbow face); j1_link's round end,
    the elbow 90T and the stator's parts start at x >= -47.500 (the end cap), so every roll angle gave 0.0000
    mm^3 against all seven. It is now that plane check: j2_link ends at wall_x[1], the others lie beyond it.
    M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
    [test_roll_drive.py]
2026-09-28 tests: each shape is built once per test process
    Every slow test built its geometry fresh (parts.build / lib.models.raw run the model body, no memo), so the
    same shapes were rebuilt over and over: the roll-drive module ~40x in tests/forearm/test_roll_drive.py,
    j1_link / j2_link in nearly every file, every mount twice in test_mounts.py, the arm's parts ~4x in
    test_robot.py, every part twice in test_parts_convention.py.
    tests/built.py builds each part (part), LEGACY build (legacy = REFERENCE_BUILD()), module (model, leaf) and
    placed occurrence (placed, optionally in another occurrence's frame) once per process (functools.cache - a
    pytest-xdist worker has its own). The call sites move to it: t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
2026-09-28 tooling: the slow lane runs on both CI cores (pytest-xdist)
    The slow lane ran in one process on CI's 2-vCPU runner. pytest-xdist 3.8.0 (a dev dependency of cad/, with
    execnet 2.1.2) spreads it over worker processes: `-n <workers>`. pyproject.toml sets --dist=loadfile, so a
    whole test file goes to one worker and its module fixtures and tests/built.py shapes are built once; with no
    -n the suite runs in one process as before (a targeted `./cadtool pytest tests/x.py -k y` included).
    CI's slow lane runs -n 2 and prints its 15 slowest tests (--durations=15). The fast lane stays one process.
    ci.yml's header no longer quotes a duration (root CLAUDE.md "CI" does).
    Measured on the Mac (warm store):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
2026-09-28 tests: interference() treats faces within 1e-5 mm as coincident
    CI on this branch (run 36374933139, x86_64 Linux) failed one check: test_motors_and_boards_clear_their_neighbours
    reported bearing_6806#3 x j1_link#1 at 4750.1 mm^3 - the whole bearing (pi/4 (42^2 - 30^2) 7), not a clash. The
    bearing's Ø42 OD sits line-to-line in j1_link's Ø42.0 seat: coincident cylinders, the kernel's fragile case.
    The old interference() built the Common twice in the default (destructive) mode, whose first pass may widen
    the operands' tolerances in place, so the second pass saw the faces as one; 169905c's single non-destructive
    pass does not, and on x86_64 it misclassified the ring (arm64 macOS: 0 either way)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
    [helpers.py]
2026-09-29 tooling: a part may be modelled before an assembly places it (UNPLACED)
    tests/test_bom.py held every part under parts/ to an occurrence in some
    assembly, so a purchased part whose mount is not designed yet (the KY-003
    hall sensor, next commit) could not land without being placed.
    A part now declares UNPLACED = "<why>" for that; parts.unplaced() lists
    them. test_bom.py leaves them out of "every part is placed" and of the
    print / buy list partition, and fails when a placed part still declares
    UNPLACED - placing it is one commit that also drops its tools/bom.py EXTRAS
    row, which carries its order line until then. test_parts_convention.py
    checks UNPLACED is a non-empty string. The rule: parts/C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
    [test_bom.py, test_parts_convention.py]
2026-09-29 cad: the cycloidal drive shrinks to a Ø100 pin ring (housing Ø140 -> Ø132)
    The shoulder drive took more room than its parts need: the discs carried ~15 mm of
    material outside their output-pin holes, and the housing is stacked outside the ring
    pins. DEFAULT_CONFIG now moves the ring-pin circle and everything outside it RING_INSET
    (4 mm, radial) in from the port, so every wall outside the pins keeps the port's
    thickness and the drive is 8 mm smaller across:
    ring-pin circle Ø108 -> Ø100
    bore (the outline between the pillars) Ø116 -> Ø108
    bolt circle Ø125 -> Ø117
    od (pillar tips) Ø140 -> Ø132
    The bore moves with the pins, not further: between the pillars the housin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
    [arm.sdf, arm.urdf, shoulder_link.stl]
2026-09-29 cad: ky003_hall_sensor - the KY-003 hall module as a native purchased part
    The joints' endstop / home sensors will be KY-003 modules: an A3144 /
    3144E unipolar hall switch on a small PCB with its pull-up, a status LED
    and a right-angle 3-pin header. The sensor is modelled now; placing it
    (the forearm roll's end cap, a magnet in the shaft's stop lug) is a later
    change, so the part declares UNPLACED and tools/bom.py EXTRAS keeps its
    order line.
    step.parts has no KY-003 and no A3144 (only bare TO-92S packages), so it
    is a NATIVE COTS part (lib/reference.py NATIVE_COTS): its envelope is the
    geometry. Three solids - the board (two mounting holes, the holes the
    leads and pins pass through), the c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
    [ky003_hall_sensor.step]
2026-09-29 cad: the drive's pillar tips trimmed, housing od Ø132 -> Ø129.2
    The six bolt pillars stood 3.3 mm of plastic past a corner of each M4 nut pocket. Each
    housing nut and its pocket now turn a flat outward (HousingParams.bolt_nut_turn_deg 30,
    new; 0 in the port) and LUG_WALL = 2.5 stands past the pocket, so DEFAULT_CONFIG's od is
    the bolt circle + the pocket's AF + 2 * LUG_WALL: 132 -> 129.2. The edge chamfer goes
    1.5 -> 1.0 so the external faces keep 1.5 past the nut pockets (1.4 past the plate's
    counterbores); a 1.5 chamfer would have left 1.0.
    Kept: the M4 x 55 bolts and nuts, six pillars, their widths (18 at the bore, 10 at the
    tip: they bridge the windows and key the housing in the yoke;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
    [arm.sdf, arm.urdf, shoulder_link.stl]
2026-09-29 cad: gt2_idler_20t, the GT2 20T toothless idler (5 mm bore) - a native COTS part, not placed yet
    The idler bought for the belt joints (a smooth 20T-size idler for the 6 mm belt, aluminium, sold in 5-packs)
    is modelled ahead of its mount: where it goes - which belt it guides or tensions, its axle, what holds it - is
    not decided, so no assembly places it.
    The geometry is the seller's drawing, in lib/belts.py GT2_IDLER_* ([DATASHEET]): flanges 18, belt seat 12.1,
    bore 5, width 9, channel 7 between the flanges (1 mm flanges). The envelope is one solid, axis on Z standing on
    z=0 (the bearing inside is not modelled): volume 1137.2 mm^3, bbox 18 x 18 x 9. MASS_G 5 g [ESTIMATE].
    step.parts was tri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
    [gt2_idler_20t.step]
2026-09-29 cad: the GT2 groove's flank offset follows the tooth count (72 deg / teeth)
    The groove's flank centre sat a fixed GT2_FLANK_OFFSET (0.396) across the centreline, the 90T's value: 0.8 deg on
    its land. The SolidWorks 20-60T compound pulley export shows the rule behind it - the flank centre sits on the land
    circle GT2_FLANK_ANGLE / teeth degrees off the centreline (72 = a fifth of the pitch angle): 0.8 deg on the 90T,
    1.2 on the 60T band (offset 0.394651), 3.6 on the 20T band (0.383788), all three exports agree to 1e-6.
    GT2_FLANK_OFFSET is replaced by GT2_FLANK_ANGLE and lib/belts.py flank_offset(teeth). lib/pulley/teeth.py
    groove_centres() / groove_arcs() / gt2_profile() / gt2_ring() use it,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
    [test_params_invariants.py]
2026-09-29 cad: gt2_pulley_20_60t, the 20-60T compound pulley - a measured conversion, not placed yet
    A new SolidWorks export ("GT2 Pulley - 20 - 60 teeth", 2026-09-26, mm, 1 solid, 1 974 574 bytes, sha256
    55733855bdc5...) is the printed pulley the elbow drive's second stage needs: a 60T band and a 20T band on one
    Ø8 bore - the 8 mm shaft docs/open_issues.md expects in j1_link's x 128 seats. It is now parametric build123d:
    lib/pulley/params.py CompoundPulleyParams / COMPOUND, lib/pulley/body.py build_compound(), parts/joints/
    gt2_pulley_20_60t.py, in the export's part frame (origin on the axis at the 60T band's bottom, +Y toward the 20T).
    Measured on the export: each band 7 wide (the belt + 1) betwee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
2026-09-30 tooling: link-length shifts of the capture records (lib/placements.py SHIFTS), all zero
    Shortening a link has to move every capture record beyond it, while
    reference/placements.json stays as extracted. SHIFTS names, for each link
    whose length the design may change (j1_link slab.elbow_x, j2_link
    web.wrist_x, wrist_link tower.block_x1), the top-level records beyond it,
    the retired hosts included; the offset is the parameter's DEFAULT - LEGACY
    along the anchor record's +X, so a part's geometry and the poses beyond it
    have one source.
    - location() applies the shift through record_location(): a top-level
    record's rel and world, a module child's world only (its rel is to the
    module). to_locat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
    [frames.py, mount_placements.py, test_robot.py, totals.py]
2026-09-30 cad: upper arm and forearm 40 mm shorter, the wrist belt 258-2GT, the shoulder's upper limit 75 deg
    The arm's reach is long for its NEMA 17 drives: stretched out horizontally
    the shoulder carries ~9.8 N.m (200 g payload) against ~5-6 available, the
    elbow ~4.1 against ~1.1-1.8. The upper arm and the forearm each lose 40 mm
    (upper arm SHORTENING -40, forearm SHORTENING +40 in their params); the
    wrist follows in the next commit.
    - j1_link: elbow_x 210 -> 170; every elbow-end feature moves with the
    axis (chamfer 145.5 -> 105.5, step 153.5 -> 113.5, stepped slot
    163 -> 123, the second stage's seat 128 -> 88: its 82 mm to the elbow
    kept, so a stock 258-2GT fits stage 1 at CD 88.08). The two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
    [arm.sdf, arm.urdf, forearm_link.stl, upper_arm_link.stl]
2026-09-30 cad: the raw SolidWorks exports have no default folder - the tools take their path
    The raw exports had a hard-coded home: lib/reference.py DEFAULT_SOURCE_DIR (~/Documents/<a fixed folder name>), the
    fallback of import_solidworks.py --src, split_mks_motor.py --src / --src48 and extract_placements.py --monolith, with
    ARM_REFERENCE_SRC as an override. Recipe E then said to keep a new export "outside the tree with a lowercase .step
    name", so the 20-60T pulley's export was copied and renamed into a new folder of that name on the Mac - a folder
    the user did not make or want. The raw exports now have no fixed place:
    - DEFAULT_SOURCE_DIR and ARM_REFERENCE_SRC are gone. import_solidworks.py --src an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
    [extract_placements.py, gt2_pulley_20_60t.py, import_solidworks.py, mks_servo42d.py, nema17_40mm.py, split_mks_motor.py]
2026-09-30 cad: wrist body 20 mm shorter, the wrist pitch limits set to the measured clear range
    The last 20 mm of the shortening (arm reach, previous commit): wrist_link's
    block ends SHORTENING = -20 nearer the pitch axis (block_x1 40 -> 20), and
    lib/placements.py SHIFTS moves what bolts to its end face - the gripper
    bracket, the pancake, the 20T, the gripper - 20 mm along F.
    - The weight-saving pocket behind the slope would break through the new
    end face: the slope's top moves slope_x1 30 -> 14 (the steepest whose cut
    stays inside the fillet's core), leaving 6 mm of block over the pocket.
    - The wall and the plate's R39 round end reached x 39; both are now
    clipped at the end face (LEGACY unchan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
    [arm.sdf, arm.urdf, wrist_pitch_link.stl]
2026-09-30 docs: the agent instructions are AGENTS.md files, not CLAUDE.md
    AGENTS.md is the name the user prefers for the agent instruction files. The coding agent the repo is worked with reads
    AGENTS.md natively from version 2.1.277 on (root file, and a folder's file lazily when work reaches that folder), but
    only where it finds no CLAUDE.md - a CLAUDE.local.md counts as one. So the files are renamed outright, with no
    CLAUDE.md stub or symlink left behind, and the content is unchanged.
    - git mv of all 11 files: the root, cad/ and its 8 folders (assemblies, lib, parts, reference, robot, tests, tools,
    vendor), software/control/.
    - Every reference follows (a same-length swap, so no line re-wraps): the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
    [gt2_idler_20t.py, gt2_pulley_20_60t.py, import_solidworks.py, ky003_hall_sensor.py, test_parts_convention.py, test_tooling.py]
2026-09-30 tooling: cadgen and the cad@text-to-cad plugin 0.7.2 -> 0.7.4
    Two fix-only releases. 0.7.3 fixes cadgen's own mesher (the JS tessellator
    behind the viewer, snapshots and `./cadtool export`): a hole through a
    curved wall wrote a duplicated triangle and ~20 zero-area slivers around
    its rim, so the mesh was not manifold (upstream #433). Its tessellation
    version moves 4 -> 5, so the store's display meshes re-tessellate once.
    0.7.4 fixes the viewer (playback no longer snaps back to its start pose on
    a renderer update; orbiting no longer re-renders the STEP surface every
    frame), rebrands it ("CAD | <file>" titles), and folds the plugin's
    `cad-viewer` skill into `cad`, `dxf`, `urdf`, `srdf` and `sd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
2026-09-30 cad: the base_yaw 90T placed under j1_coupler, clamped by 4x M4 x 45 + nuts
    Why: the base_yaw joint was not held down. j1_coupler stood on the thrust
    bearing with nothing pulling it onto it, the lower base 6806 held nothing, and
    the joint's driven pulley was not in the model. The coupler's stub was already
    drilled for it (lib/yaw_coupler/params.py DEFAULT).
    The pulley: gt2_pulley_90t#5, a mount hosted on j1_coupler#1 (lib/mounts.py
    PULLEY_MOUNTS), hub up: frame ((0, -22.507252, 0), (180, 45, 0)) in the
    coupler's frame = stub_y0 + the hub's end, turned HubParams.hole_deg onto the
    stub's diagonal holes; world y -27.6. Its hub end lies on the stub's end in the
    plane of the lip's lower face, it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
    [arm.sdf, arm.urdf, shoulder_link.stl]
2026-09-30 cad: j2_link's roll wall a round flange on a necked web, braced by two gussets
    The wall j2_link bolts onto the roll shaft with was a bare 90 x 70 x 8 mm rectangle: full width and z -10..60,
    sized under / over the link caps' tray and lid, which were removed on 2026-09-25. Its skirt hung 1.5 mm below
    j1_link's top face, and that lower edge is what met the upper arm's side at +/-92 degrees of elbow.
    Now (lib/forearm/link.py roll_wall, necked_web, wall_gussets; RollEndParams):
    - the wall is a Ø60 round flange about the roll axis (wall_od, over the stop lug and post that turn in front of it,
    r 28 / 30) on a foot as wide as itself: the hull of the circle and the web's end section, z -5..55;
    -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
    [arm.sdf, arm.urdf, forearm_link.stl]
2026-09-30 cad: base_yaw at 6:1 - a 120T driven pulley in place of the 90T
    Why: a higher base_yaw ratio than the 4.5:1 of the shared 90T (2.0 -> 2.7 Nm at
    the joint from the 0.45 Nm motor, a stiffer hold, finer steps), chosen from a
    to-scale preview. The 90T sat Ø59 in the base's Ø97 cavity; 120 teeth is the
    largest that still passes through the opening in the base's plate with room
    to spare.
    The pulley: gt2_pulley_120t (parts/base/), lib/pulley/params.py YAW =
    DEFAULT with GT2_PULLEY_120T_TEETH and its rim's inside grown with the teeth
    (rim_dia 53 -> 72.098593, the 90T's 3.788 wall under them kept); the hub, the
    web's height, the bore and the M4 holes are the 90T's, so it takes the same
    mount frame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
    [arm.sdf, arm.urdf, base_link.stl, base_motor_mount.step, shoulder_link.stl]
2026-09-30 cad: the forearm wall screws into nuts in the roll shaft; a channel under the web for the bottom one
    The wall's 4x M3 self-tapped into the shaft's end, and the joint could not be assembled as drawn:
    - the bottom screw's hole (y 0, z 9) opened on the wall's wrist face right where the web butts onto it (web z 8..19,
    the hole z 7.3..10.7): no way in for the screw and no seat for its head - only 0.7 mm of the hole was open;
    - the M3 x 20 on the buy list was 6 mm too long: 6 mm of wall at the holes (8 less the recess) + 8 mm tap holes = 14;
    - a self-tapped thread in PETG creeps and strips on re-assembly, and this joint comes apart to take the forearm off.
    Now:
    - 4x M3 x 25 (ISO 4762, lib/faste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
    [arm.sdf, arm.urdf, forearm_link.stl, forearm_roll_shaft.step]
2026-10-01 cad: the shoulder drive's shell turns - a 6814 at each end, 57 apart, the yoke a fork round it
    The shoulder_pitch cycloidal drive carried the whole upper arm on two 6814s pressed side by side in one
    seat, centres 10 mm apart: their play and the PETG's give tipped the arm. The drive now holds its carrier
    (the output hub and its pins) and its motor, and turns its housing shell as the output, on one 6814 at each
    end of the gear stack - the hub's in the seat's outer slot, the other on a sleeve behind the motor plate,
    over the front of the motor (its 70 mm bore clears the motor and the MKS board, 61 across the corners).
    Drive (lib/cycloidal/params.py ShellParams, DEFAULT_CONFIG only; LEGACY_CONF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
    [arm.sdf, arm.urdf, shoulder_link.stl, upper_arm_link.stl]
2026-10-01 cad: the upper arm rises off the turning shell's middle; the shell the same at both ends, the yoke two thin legs
    Round 1 kept j1_link as a plate bolted to the turning shell's hub end, the hub reaching through it to a yoke end plate
    and the motor sleeve held in a 30 mm clamp block, the ring gear body carrying an empty second-bearing slot. Asked for:
    the shell part of the upper arm link, the empty slot gone, the pillars end to end, the drive symmetrical, the yoke's
    grip equally thin on both sides, and the arm going straight up from where the discs are (PAROL6-like), not from the
    side of the gearbox - the end effector need not stay centred.
    The drive (lib/cycloidal/params.py ShellParams, layou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
    [arm.sdf, arm.urdf, shoulder_link.stl, upper_arm_link.stl]
2026-10-02 cad: the upper arm a plain bar off two filled windows of the turning shell; the elbow motor on the arm's other side
    Round 3 wrapped the turning shell in an r 66 collar where the upper arm joined it, closing all six windows over the
    discs. Asked for: fill in two of the windows and run the arm out of them, the others open so the discs show; keep the
    arm a simple rectangle as a placeholder (the arm only - the elbow end, its bearing seat and the motor stay - 90 wide);
    and flip the elbow motor to the arm's other side, the drive motor's and the forearm's (+N). On that side the forearm
    roll drive's motor and board swing onto it when the elbow lifts the forearm back: the elbow's lower limit -90 -> -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
    [arm.sdf, arm.urdf, upper_arm_link.stl]
2026-10-02 cad: the elbow motor's 20T placed level with the elbow 90T; its plate's holes M3 clearance; its screws on the buy list
    Three small follow-ups to the elbow motor's flip (e616513), asked for after it:
    - j1_link's motor plate: the 4 NEMA 17 holes Ø3.2 (copied from the SolidWorks pad) -> M3_CLEAR 3.4, as every other M3
    clearance hole in the arm (lib/upper_arm/params.py, DEFAULT's pad holes). j1_link 376985.495 -> 376960.613 mm^3.
    - tools/bom.py EXTRAS: 4 x M3 x 10 socket head cap screws - the elbow motor to its plate, up through the 6 mm plate
    (ArmParams.motor_plate_t) into the motor's tapped holes, 4 of thread in their 4.5 (ELBOW_MOTOR_SCREW_THREAD).
    - the elbow motor's 20T placed: gt2_pu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
    [arm.sdf, arm.urdf, upper_arm_link.stl]
2026-10-02 cad: the yoke centred on the base_yaw axis - the drive and all it carries moved 7.5 along N; the disc's -X cut gone
    j1_coupler looked off centre and lopsided: its two legs mirror each other about the middle of the cycloidal discs, but
    the drive sat where the SolidWorks capture put it, the middle of the discs 7.5 off the base_yaw axis toward the motor -
    so the hub leg stood on the yoke's disc, inside its -X flat, and the motor leg 5.5 past the +X flat on a foot of its
    own; the disc was cut back on -X only (for the elbow motor, which has since moved to the arm's other side), and the ring
    under the drive ran from the old cheek's face (-32.8) to the +X flat.
    - lib/yaw_coupler/params.py ForkPara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
    [arm.sdf, arm.urdf, shoulder_link.stl]
2026-10-02 tooling: cadgen 0.7.4 -> 0.7.7; the plugin is now text-to-cad@earthtojake
    cadgen and the plugin move together (docs/toolchain.md Pins). Three upstream releases:
    0.7.5 rewrote the rebuild gate (a native file tracer: every file a build opens is an
    input, and every folder the model's code lists, by its entry names; declare_input,
    @memo and the kernel-op cache gone; model records to schema 8, so every model read
    stale once); 0.7.6 has the store drop 0.7.4's op cache and stay under CADGEN_STORE_MAX
    (20G default); 0.7.7 renamed the plugin (cad@text-to-cad -> text-to-cad@earthtojake,
    marketplace text-to-cad -> earthtojake) and added opt-in anonymous analytics to
    `cadgen viewer` / `cadgen mcp` (off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
2026-10-04 tooling: cadgen 0.7.7 -> 0.7.11; the plugin's MCP server and its new skills in the docs
    Switching the plugin to text-to-cad@earthtojake after the 0.7.7 merge installed 0.7.11:
    `claude plugin install` takes the marketplace's newest release, and upstream had
    released 0.7.8-0.7.11 since. So the venv follows the plugin (docs/toolchain.md Pins:
    bump both together).
    What 0.7.8-0.7.11 changed:
    - The plugin starts CAD's MCP server `cad` with every agent session
    (`uvx --no-config --from cadgen==<ver> cadgen mcp`, in uv's cache, not this venv). In
    a terminal its cad_show answers with a CAD Viewer link (a detached `cadgen viewer`
    on the model's project); a desktop host that renders MCP Apps show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
2026-10-04 tooling: cadtool skill fetches the skill's own requirements
    `./cadtool skill dfam-check dfam_tool.py measure <stl>` - the README's own example - died at its
    first import (`ModuleNotFoundError: No module named 'trimesh'`): the dfam-check and dfm scripts need
    trimesh, rtree, scipy, networkx and lxml (each skill's requirements.txt says "install first - every
    run needs it"), and this venv has none of them.
    run_skill now passes the skill's requirements.txt to `uv run --with-requirements`: uv resolves those
    libraries into a cached overlay for the run, so pyproject.toml / uv.lock stay as they are and the
    overlay follows the plugin's list as it changes. A requirements file that pins cadgen (cad, dx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
2026-10-04 docs: show models with cad_show, section snapshots, a dfam-check step for printed parts
    Three parts of text-to-cad that fit this repo were missing from the docs:
    - cad/AGENTS.md "Look at what you built": it said to hand every STEP to `./cadtool viewer` (a
    long-running process), while the plugin's MCP server tells a session to use `cad_show`. Now: from a
    Claude session, `cad_show` (absolute path; one link, the page reloads on every rebuild); from a
    terminal, `./cadtool viewer`. The same bullet adds section snapshots (`--mode section --section
    XZ:<mm>`) for changes inside a housing - bearing seats, fits - and `--focus '#<label>'`; neither was
    named anywhere.
    - cad/parts/AGENTS.md "P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
2026-10-06 tooling: cadgen 0.7.11 -> 0.7.15; daemon stop finds the -P daemon, setup installs the headless shell
    Upstream released 0.7.12-0.7.15 (2026-10-05/06) and the plugin's viewer now tells of them,
    so the venv and the text-to-cad@earthtojake plugin move together (docs/toolchain.md Pins).
    What 0.7.12-0.7.15 changed for this repo:
    - Faster gates and rebuilds: an unchanged rebuild verifies each stored object once, and a
    rebuild whose STEP bytes would not change keeps the file (`kept STEP: ...`). No-op gen
    after the bump: arm 0.84 s, a part 0.13 s.
    - Every process cadgen starts runs as `python -P` (no cwd on its import path), the warm
    daemon and its workers included: `.venv/bin/python -P -m cad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
2026-10-07 docs: gotcha - parts built in parallel can read stale right after a gen
    After the cadgen 0.7.15 bump, a rebuild of the arm left it stale ("child stale:
    cycloidal_drive"), and a full rebuild needed three passes. Traced to cadgen, not this repo:
    a folder the model's code lists (parts._scan() lists every parts/ group folder) is hashed
    by all its entry names when the build records its result (store/closure.py
    _listing_digest), and every part stages its STEP in a hidden `.<name>-xxxxxxxx/` folder
    beside it (_internal/generation.py). A part recorded while a sibling's stage folder exists
    keeps that name, and reads STALE (`closure changed: ./` or `.../parts/<group>/`) once the
    sibling publishes. A s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
2026-10-07 docs: open issues - which joints get a KY-003, and its level on the SERVO42D limit input
    The KY-003 hall module was chosen as the joints' endstop / home sensor and is modelled (lib/sensors.py,
    parts/joints/ky003_hall_sensor), but two points were never listed as open: only the forearm roll's home sensor is
    planned, the other joints are not chosen; and the A3144 needs at least 4.5 V (3.3 V is out of its range), so the
    module runs from 5 V and the MKS SERVO42D's limit input has to take its output at that level. Two rows under Not
    confirmed.
2026-10-07 cad: the upper arm one flat slab, shoulder to elbow - no steps on either face
    j1_link's DEFAULT was three solids fused together: a plain bar (y 27.5..57.5), the SolidWorks plate slid under it, and
    a 6 mm motor plate. In side view that gave two drops on the forearm side and three bumps on the belt side:
    - forearm side: the bar's top at 57.5, the step to 50.27 for the roll drive's stator, the r 60 relief wall down to 38.27;
    - belt side: the motor plate at 21.5, the 45 deg chamfer, the step to 15.27.
    The user asked for a smoother, straighter link. After seeing a before/after preview, they chose a flat slab.
    The arm is now one slab with the plate's outline (lib/upper_arm/link.py _slab, ArmParam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
    [arm.sdf, arm.urdf, upper_arm_link.stl]
2026-10-07 cad: model the elbow motor's 4x M3 that hold it down on j1_link's web
    Until now the screws holding the elbow motor (nema17_40mm#2) down were a tools/bom.py EXTRAS row only. They are now a
    modelled purchased part, elbow_motor_screws (parts/joints/), placed in the arm:
    - 4x M3 x 10 SHCS (ISO 4762), lib/fasteners.py shcs(): no thread, the head's hex socket;
    - the heads sit on the underside of the web across j1_link's motor hole, in the hole's open lower half round the 20T;
    - the shanks run up through the web's M3 clearance holes into the motor's tapped holes.
    Part and placement:
    - A pattern part with no reference (lib/reference.py NO_REFERENCE, like yaw_pulley_screws). Its pattern is
    j1_link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
    [arm.sdf, arm.urdf, upper_arm_link.stl]
2026-10-07 cad: the elbow motor's screws in the drive motor's seat - heads flush in pockets in a 9 mm web
    The user asked for the elbow motor's screws to be sunk in, and to be the same screw as the cycloidal drive's motor's.
    The drive's motor plate holds its NEMA 17 with M3 x 10 SHCS (ISO 4762, cycloidal_motor_bolts):
    - 6 mm of plate under the heads;
    - the heads flush in Ø5.7 pockets (motor_bolt_head_dia 5.3 + bolt_clearance_add 0.4), head_h (3) deep, in a 9 mm plate;
    - 4 mm of thread in the motor (bolt_hole_depth 4.5 - motor_bolt_thread_margin 0.5).
    The web across j1_link's motor hole now does the same:
    - the screws were already that screw (M3 x 10 SHCS, 4 mm into the motor) - their part and placemen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
    [arm.sdf, arm.urdf, upper_arm_link.stl]
2026-10-07 cad: the pulley bolts' heads sunk in counterbores; every pulley screw 5 mm shorter
    The 12 M4 socket cap screws that clamp the driven pulleys (the base_yaw 120T, the elbow and the wrist 90T) had their
    heads standing 4 mm proud of each pulley's outer face. Each bolt hole now has a counterbore from the outer face, so
    the heads sit 1 mm under it. They stay ISO 4762 socket cap screws.
    - lib/belts.py GT2_PULLEY_90T_HEAD_SEAT = 5.0 [DESIGN]: the counterbores' floors under the outer face. The heads
    (4.0 tall) sit 1.0 under the face; each screw is exactly 5 shorter, so every tip ends where it did.
    - lib/pulley/params.py PulleyParams.counterbore (dia, depth): none on LEGACY (the SolidWorks match is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
    [arm.sdf, arm.urdf, elbow_link.stl, elbow_pulley_screws.step, shoulder_link.stl, wrist_pitch_link.stl, wrist_pulley_screws.step]
2026-10-07 cad: j1_coupler turned from one drafted base; hub leg disc the hub's Ø; a one-piece motor leg replaces the clamp
    The fork's two legs were flat 8 mm plates standing at the edge of the coupler's disc, so any thickening looked tacked
    on, and the motor end was held by a split clamp with a cap. The user wanted the legs to grow out of the base, thick at
    the root and thin at the mounting area; the part that bolts to the cycloidal's output hub to be the hub's own
    diameter; and no clamp on the motor side (chosen: a one-piece motor leg bolted to the base). Previewed as a scratch
    build first (claude.ai artifact, three rounds) and approved.
    What changes (lib/yaw_coupler/, DEFAULT only - LEGACY and the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
    [arm.sdf, arm.urdf, shoulder_link.stl]
2026-10-07 cad: the roll motor on the elbow axis, the roll housing above it - the forearm moves across (an elbow offset)
    The forearm roll motor sat on the roll block's top with its body and board hanging behind the elbow. When the forearm
    lifted back, the board met the elbow motor, so the elbow stopped at -21 deg. The user chose layout E from four
    compared (the motor about the elbow axis):
    - the motor sits ON the elbow axis;
    - the roll housing sits above it, the 240-2GT roll belt's centre distance away (60.9 mm);
    - the forearm, wrist and gripper move across with the roll axis as one piece, unchanged.
    The arm gains an elbow offset: the roll axis no longer crosses the elbow axis, and the wrist stays sphe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
    [arm.sdf, arm.urdf, elbow_link.stl, forearm_link.stl, forearm_roll_block.step, forearm_roll_motor_mount.step, forearm_roll_mount_nuts.step, forearm_roll_mount_screws.step]
2026-10-08 cad: the roll pulley is the output - the 90T ring out front on a 6806 pair, one round block round the motor, no end cap
    The forearm roll's 90T ring sat between its two 6808s inside the housing, in a Ø62 cavity open to the front, so
    bearing 2 needed a bolt-on end cap (forearm_roll_retainer) and the belt a window in the housing's bottom wall; the
    motor hung off the housing on a plate. Asked for: the pulley as the output with the forearm bolted straight onto
    it, a smaller bearing, one block that holds the motor, and a round elbow end (previewed and approved).
    The rotor now splits between its bearings (the elbow's 6806 pattern - two hubs meeting inside the lip): both
    bearings are pressed onto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
    [arm.sdf, arm.urdf, bearing_6808.step, elbow_link.stl, forearm_link.stl, forearm_roll_block.step, forearm_roll_retainer.step, forearm_roll_shaft.step]
2026-10-08 cad: the base widens along the coupler's cone into a Ø200 foot - a straight chamfer flare, 6 screw holes
    Why: the base was too narrow to keep the arm up. Stretched out, the arm's centre of mass is 131 mm off the
    base_yaw axis (165 mm with 0.5 kg in the gripper; forward kinematics over the shoulder / elbow / wrist limits on
    robot/arm.urdf's masses), but the base reached 53.3 mm on its round side and its flanks, and it had no holes to fix
    it down: standing free, 69% of the poses tipped it with the arm pointed the worst way. Its Ø106.7 tower also stood
    4.7 mm inside j1_coupler's Ø116 rim. The shape was chosen on a rendered preview, in two rounds: the Ø200 foot with
    screw holes, the tower fl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
    [arm.sdf, arm.urdf, base_link.stl]
2026-10-08 cad: the joint limits re-measured - the forearm roll 2 deg inside its hard stop, three sweeps more
    Every joint end measured against today's geometry (after the elbow offset and the roll pulley merges): the first
    angle each pair comes within 1 mm, and where it touches (every contact confirmed by an overlap volume):
    - base_yaw +/-175: nothing within 1 mm at any yaw (every 25 deg) at both shoulder limits over the elbow range.
    - shoulder_pitch +67: j1_link reaches j1_coupler's disc at 69.5, inside its 1 mm running gap from 68.6 (the note said
    70.5 / 69.5 - measured before the flat slab and the turned j1_coupler); -120: the upper arm reaches the fork at
    -154.2 (1 mm at -153.5), the forearm st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
    [arm.sdf, arm.urdf]
2026-10-09 tooling: cadgen 0.7.15 -> 0.7.19; telemetry kept off, the parallel-build stale race is gone
    Upstream released 0.7.16-0.7.19 (2026-10-08/09); the venv and the text-to-cad@earthtojake
    plugin move together (docs/toolchain.md Pins). uv.lock changes cadgen only.
    What 0.7.16-0.7.19 changed for this repo:
    - Telemetry is on by default (0.7.16): once a cadgen command has shown a one-line notice, every
    process (builds, the daemon, the viewer, the plugin's MCP server) sends usage counts and crash
    reports to PostHog under a random install id. The repo keeps it off on both machines:
    cadtool and cad/.env export CADGEN_TELEMETRY=0 (no cadtool command shows the notice or sends;
    cadtool runs `cadgen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
    [test_tooling.py]
2026-10-13 tests: pair the elbow motor screws with the bolt pattern by rounded keys - float noise flipped the sort on the Mac
    test_elbow_motor_screws_hold_it_down_through_the_web sorted the four screw axes as raw (X, Y) floats and zipped them
    with the sorted bolt pattern. Two axes share X = -15.5 up to float noise, and on the arm64 Mac that noise orders them
    the other way round: X = -15.500000253816422 (Y +15.5) sorts before -15.500000253816411 (Y -15.5), so each pair
    compared a screw with its neighbour's bolt and the test failed, though every axis is within 3e-7 mm of its bolt (the
    assert's tolerance is 1e-6). It passed on the Fedora PC, whose noise sorts them as the pattern does. The failure
    does not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
2026-10-13 tooling: cadgen 0.7.19 -> 0.7.21; a STEP write no longer crashes on a last-digit entity range
    Upstream released 0.7.20 (2026-10-10) and 0.7.21 (2026-10-11); the venv and the text-to-cad@earthtojake plugin move
    together (docs/toolchain.md Pins). Same requirements as 0.7.19 (build123d 0.11.1, cadquery-ocp-novtk 7.9.3.1.1,
    playwright 1.63.0): uv.lock changes cadgen only. uv 0.12.24 on the Mac relocks the file as `revision = 5` and drops
    two numpy markers, so cadgen's entries were moved into the committed revision-3 lock by hand (the format the Fedora
    PC's uv has always written; `uv lock --check` passes and `uv sync` takes it unchanged).
    What 0.7.20-0.7.21 change for this repo:
    - A STEP write c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
2026-10-13 cad: j1_link prints flat - the arm slid 9.77 mm onto the shell's hub end, the motor web and M3x12 heads flush
    j1_link printed badly on a 256 bed (Bambu P2S). Its only usable orientation is the shell's hub end on the plate (it
    is longer than the bed's side, so it lies flat, turned 45 degrees), and in that orientation the arm rose off the
    middle of the shell: its whole underside, 169 x 90 mm, hung 9.77 mm above the plate on supports, and the web under
    the elbow motor sat a further 3.23 mm up in a recess. Now the slab's underside is flush with the shell's hub end and
    the web is flush with both: one flat face goes on the bed.
    What changed:
    - arm_slide puts the slab's underside (ElbowParams.y0)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
2026-10-13 cad: the roll frame grows out to its cup - the Ø66 cup flush on the underside, the +N face and the tower's top
    The cup on the roll frame's front face (bearing 2's seat, the pulley's rear flange sunk in it) is centred on the roll
    axis, as it must be, but the frame round it was not: flush with the cup on the underside (-33), it stopped 7 mm short on
    the open +N face (26) and 4 mm short at the tower's top (29), so the cup hung over two edges and read as stuck on off
    centre. The +N face was cut back to 26 when the frame became one body round the motor; the cup kept the old housing's
    Ø66. Asked for: the frame grown out to the cup (previewed and approved, against trimming the cup flush or leavin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
2026-10-13 cad: belts at the GT2 multipack lengths - base_yaw 320 -> 300, roll 240 -> 280
    Why: the belts are bought as the Amazon GT2 6 mm multipacks (110, 112, 122,
    158, 200, 280, 300, 400, 610 - one of each per pack); 320 and 240 are not in
    them. The elbow's 280 already is; the wrist's 258 follows in the next commit
    (with an idler). Each length still sets its motor's centre distance, so the
    motors move to where the stock belt puts them. Chosen from a to-scale preview
    (today vs new, plan cuts at each belt's plane).
    base_yaw: YAW_BELT 320 -> 300 [DESIGN] (was [ESTIMATE]). The 48 mm motor moves
    10.900 nearer the yaw axis: BASE_MOTOR_PATTERN_CENTRE x 83.967 -> 73.067. The
    motor mount follows _MOTOR_X: i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
2026-10-13 cad: wrist belt 258 -> 280 - the motor at its slide's wall end, a GT2 idler under the web takes up the rest
    Why: 258 is not a multipack length; 280 is. The wrist motor cannot move the
    11.5 mm toward the elbow a 280 needs (its plug would hit the roll wall), so it
    sits at its slide's wall end and the modelled GT2 idler (gt2_idler_20t, placed
    for the first time) takes up the rest on the belt's back. Chosen from a
    to-scale preview.
    The belt's path, exactly (lib/belts.py, a leaf): a loop of circles with signed
    pitch radii (a back-side idler negative) - belt_runs(), belt_wraps(),
    belt_length() - and idler_on_run(), which pushes an idler into a run until the
    loop is a given length. GT2_BELT_THICKN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
2026-10-14 cad: the roll frame's Ø66 cup becomes a Ø52 bearing boss - no cup round the pulley's flange
    The cylinder on the roll frame's front face holds only bearing 2 (bearing 1 sits in the tower behind the front face);
    bearing 2's Ø42.15 seat needs about Ø50 with the frame's 4 mm wall. Its Ø66 came from a 1.9 mm cup round the pulley's
    Ø59.19 rear flange - a shroud no load goes through. Asked for: the smaller boss (previewed and approved).
    - lib/forearm/params.py: cup_od / cup_id_add / rim_under_teeth -> bearing_boss_dia 52 (4.9 of wall round the seat);
    ROLL_FRAME_R keeps the frame symmetric, so the boss sits centred with 7 mm of front face to the underside, the +N
    face and the tower's top.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
2026-10-14 cad: model the four GT2 belts as purchased parts, and the base_yaw and wrist motors' 20T pulleys
    Why: the belts were only buy-list rows (and the base_yaw belt not even that),
    so nothing in the model showed where they run or what they clear; the base_yaw
    and wrist motors had no 20T on their shafts. Now every belt is a part on its
    pulleys, at its stock length.
    The belts: purchased parts with no reference (lib/reference.py NO_REFERENCE),
    their envelope a smooth band round the exact loop (lib/pulley/belt.py
    closed_belt(), from lib/belts.py belt_runs() / belt_wraps()): the land on the
    pulleys' tooth tips (GT2_PLD inside the pitch line), the back GT2_BELT_BACK
    outside it, GT2_BELT_W wide; no teet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
2026-10-14 docs: the elbow limit's room re-measured with the 280 roll belt
    Why: the 280 roll belt put the roll frame's tower 21 mm further from the elbow
    axis (the first commit of this branch), so the room past the elbow's lower limit
    that lib/params.py and docs/open_issues.md quoted was stale.
    Measured with tests/forearm/test_roll_drive.py's own helpers on the branch as
    it now stands (the belts included): the roll frame is 5.2 mm off the elbow
    motor's board at -47 (was 9.3) and comes within 1 mm of it at -52.0 deg (was
    -59.8; the motor itself at -55.0). ELBOW_PITCH_LIMITS_DEG (-47, 90) stays: 5 deg
    short of that line, more than the 3 the row asks. The guidance to lift further
    now reads about -49 (2 d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
2026-10-14 tooling: the committed STEP / STL inputs become plain git files - no git-lfs needed to clone or build
    No committed file needs Git LFS: the largest, cad/robot/meshes/shoulder_link.stl, is 4.6 MB against
    GitHub's 50 MB warning and 100 MB limit, and all 72 together are 37.1 MB. LFS still made git-lfs a
    requirement on every machine and on CI (a pull step, a cache, the LFS bandwidth quota), and a clone
    without it got ~130-byte pointer files that fail the checksum tests, read_step and cadgen.
    - .gitattributes: the four filter=lfs rules (cad/**/*.step, *.stl and their uppercase spellings)
    removed; the line-ending rules stay.
    - The 72 files in cad/reference/, cad/vendor/ and cad/robot/meshes/ re-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
2026-10-14 cad: the forearm turned half a turn about its roll axis - the wrist-pitch motor on the upper arm's side
    The wrist-pitch motor (nema17_40mm#3 + mks_servo42d#3) moves to the other side of the forearm: j2_link and everything
    beyond it - the wrist bearings, the motor and its board, the wrist 90T and its M4s, j3_coupler#2, wrist_link, the
    bracket, the pancake and the gripper - turn 180 deg about the forearm_roll axis from the capture. The roll drive keeps
    its pose, its rotor too, so the printed hard stop and +/- FOREARM_ROLL_LIMIT_DEG stay; the forearm wall's 4 bolts (0 /
    90 / 180 / 270 deg about the roll axis) take the pulley turned. Previewed and approved first (scratch build, renders,
    sweeps).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
2026-10-14 cad: the wrist-pitch motor 11.5 mm down the forearm - a 280-2GT wrist belt, no idler, its connector sideways
    The wrist-pitch motor moves nearer the roll pulley, on a belt the user can buy: 280 is a multipack length (the 258 was
    not), and at its centre distance it needs no idler - the motor's slots tension it. Previewed and approved first.
    - lib/forearm/params.py: RollEndParams.wrist_belt 258 [ESTIMATE] -> 280 [DESIGN]: J2_MOTOR_SLIDE_X -99.522 -> -88.028
    (centre distance 70.478 -> 81.972). slide_range (-103.5, -94.0) -> (-94.0, -84.5): the same 9.5 mm of travel, 3.47
    past the belt's centre distance toward the wall to tension it, 6.03 back to slip it on; the slots follow (centre_x
    (-11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
2026-10-14 cad: every belt a stock length - 160 and 1000 join the list - and every belt gets a tensioner
    Why: the belts are bought only as the stock lengths on hand - the GT2
    multipack's nine (110, 112, 122, 158, 200, 280, 300, 400, 610) and the
    single-length packs (160, 200, 1000); an odd length ordered on its own is
    out. And every belt on the arm will run with a tensioner: an idler on its
    back taking up what the stock length has over its open loop, so a belt
    joint's centre distance becomes a design value instead of the belt's.
    lib/belts.py STANDARD_2GT_LENGTHS: (110, 112, 122, 158, 200, 280, 300, 400,
    610) -> (110, 112, 122, 158, 160, 200, 280, 300, 400, 610, 1000), its comment
    the rule. cad/AGENTS.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
2026-10-14 cad: the roll motor can go into its frame - a 6 mm shaft slit through the plate to the +N face, the pocket 1.5 mm deeper
    Why: the roll motor could not be fitted. Its Ø22 pilot boss sits in the
    plate's 22.3 mm pilot slot and its 22 mm shaft runs through the plate, while
    the pocket left the motor and its board 1 mm of axial play: the boss could not
    drop out of the slot, and the motor locked after 0.5 mm of slide toward the
    open +N face. docs/forearm_roll.md's "the motor into the pocket from the +N
    face onto the plate" had no path.
    Now the motor and its board slide in from the +N face motor_drop (2.25) low -
    the pilot boss under the plate, the shaft along the new slit - and lift into
    the pilo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
2026-10-14 cad: the roll pulley 8 mm nearer its motor on the stock belt with a tensioner, the motor 5 mm up under its 20T
    Why: the roll frame read too big, with a wide gap between its face and the
    belt. The forearm_roll_pulley sat where the 280-2GT belt put it, 81.97 from
    the motor; the motor and so the frame's face sat low, the 20T's hub 3.5 off
    the face and 7.5 off the motor's face. The belts are stock lengths only and
    each gets a tensioner (cad/AGENTS.md "Belts", the previous commit but one),
    so the roll's centre distance becomes a design value with an idler taking up
    the rest of the 280 belt. Chosen from a to-scale preview: 74 (nearer than ~73
    the idler meets the ring's flange and the belt's far ru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
2026-10-14 cad: the roll frame 6 mm thinner, still symmetric - +/-30 about the roll axis, flush with the forearm's round wall
    The roll frame (forearm_roll_block) was the widest thing at the elbow along the elbow axis: 66 mm, its
    faces 3-4 mm past the round parts that turn about the roll axis (the forearm wall's Ø60, the 90T's
    Ø59.2 flanges, the belt). ROLL_FRAME_R 33 -> 30 brings the underside, the open +N face and the tower
    top in together, so the frame stays symmetric about the roll axis with the bearing boss centred on
    its front face, and now lines up with the forearm wall's radius (wall_od / 2, held by test_stack).
    The underside can only rise: the elbow flange under it stays where j1_link's bore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
2026-10-14 cad: an idler on the elbow belt in j1_link's old slit, the elbow motor 3.97 mm nearer the elbow
    The elbow belt was the one belt with no tension adjustment: its motor sat on round holes at exactly
    the stock 280 belt's centre distance (81.97), the loop 0.04 mm tight. Every belt gets a tensioner
    (cad/AGENTS.md "Belts"), and j1_link's SolidWorks slit - 47 mm from the elbow axis, across both
    strands - was for one. A stock 300 does not fit this span (taking up 20 mm puts the idler 0.5 mm
    off the far strand) and the motor has no room toward the shoulder (its hole 1.8 mm off the drive's
    shell), so the belt stays 280 and the motor moves in:
    - ELBOW_MOTOR_CENTRES 81.97 -> 78.0 [DESIGN] (pad.x 88.03 -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
2026-10-14 cad: LinkShift moves records along its anchor's +Z too
    A LinkShift moved the records beyond a link along the anchor's +X (along_x) and +Y (across_y) only. The wrist roll
    drive puts the gripper's roll axis off the wrist plate - beside the pancake, on the plate's free face - so the gripper
    has to move along the wrist body's +Z as well: LinkShift gains normal_w (the anchor's +Z in W, data like axis_w /
    across_w) and normal_z, default 0, and shift() adds normal_z * normal_w. No shift uses it yet: every placement is
    unchanged.
    tests/test_placements.py checks the +Z column against the anchor's record as it does +X and +Y
    (test_shift_axes_are_their_anchors_x_y_and_z); assemblies/AGENTS.md "Shifted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
2026-10-14 cad: the base_yaw belt a 400 round an idler on the motor mount, the motor 48.93 mm further out
    The base_yaw belt was the last running belt tensioned only by its motor's slots, and every belt gets an idler
    (cad/AGENTS.md "Belts"). The stock 300 left no room for one. At its own centre distance (73.07) the exact loop was
    already 0.23 longer than the belt. The motor could come only ~0.4 mm nearer the axis before its slots met the base's
    posts. The one spot an idler fits, 1.6 - 3.4 off the 120T's flange, lies under the base's cap over the motor's face,
    where no key reaches. The options were previewed before / after (renders at one scale, an overlay, the whole arm), and
    the choice is a stock 400 w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
2026-10-14 cad: the wrist roll drive - the pancake on the wrist-pitch axis, a 2:1 belt to a 40T on a 6806 pair beside it, the gripper bolted to it; the bracket dropped
    The pancake and gripper_clamp_bracket hung 66-90 mm out past the wrist-pitch axis on wrist_link's tower, the gripper
    direct-driven beyond them through the 20T its connector slid onto. The wrist now copies the elbow: the pancake sits ON
    the wrist_pitch axis, centred on it, on the wrist plate's free face (the forearm's boss and the coupler fill the other
    side), and belts 2:1 (WRIST_ROLL_RATIO, its 20T to a printed 40T) to a roll axis R' beside it - WRIST_ROLL_OFFSET
    48.583 across the pitch axis in the wrist's swing plane, WRIST_ROLL_AXIS_H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
2026-10-15 cad: the gripper-roll sweep bounds each rolling part by its box in the wrist_roll frame - 4x faster, same result
    test_the_gripper_rolls_clear_of_the_wrist took 499 s on the CI runner (the suite's slowest test by 3x; the slow lane
    748 -> 1433 s), so the CI job hit its 30-minute timeout while building the arm, every test passed. The world boxes of
    the rolled gripper parts grow at every angle off the world's axes and wrist_link's L-shaped box is large, so pairs 25 to
    70 mm apart went to BRepExtrema (the servo against wrist_link 2.8 s at 46 mm).
    tests/test_sweeps.py: _hulls() - each part's bounding box in a joint's frame, as a solid that turns with it and holds
    it, so its distance to a fixed pa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
2026-10-15 cad: stale comments and docstrings brought in line with the code
    The docs audit on this branch checked every doc against the code; the code comments and docstrings that said the same
    stale things are fixed here, wording only - no value, identifier or import changed (each changed .py's AST with its
    docstrings stripped equals the old one, and arm.urdf parses to the same XML; the one string value is robot/frames.py's
    forearm_roll Joint.notes, which nothing reads).
    What they said that the code no longer does:
    - the cycloidal drive: R 54 in compute_epitrochoid (DEFAULT builds 50, 54 is the port's); "three departures" from the
    port (four: the turning shell); the limiting wall (the pin rings', 1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
2026-10-15 tests: the duplicate-label check covers the wrist roll drive
    test_duplicate_parts_have_unique_labels checked the OCCURRENCES of the arm, the gripper and the cycloidal and forearm
    roll drives, not wrist_roll_drive's, so the roles rule assemblies/AGENTS.md states went unchecked for the newest
    module. Its labels are unique today; the test now holds them so.
2026-10-15 tests: the sweeps 2.6x faster, every check the same
    tests/test_sweeps.py spent most of its time on exact distances (BRepExtrema) between part pairs that could not break
    their limit, and on posing copies of every part:
    - _closest prunes at the assertion's own limit (CLEAR 1.0; the fork's end_plate_gap - 0.01; the rim's RIM_CLEAR -
    0.01), not at a 5 mm box gap. A box gap or a hull distance bounds the parts' distance from below, so a pair with one
    at or over the limit cannot fail and is not measured; a pair that could still fail is measured exactly, as before.
    - Each part's own box (_own_box: the optimal box of its shape before its location, once per part) is carried by its
    pose (_oriente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
2026-10-15 tooling: CI in parallel jobs - lint + fast lane, the slow lane in two halves, the arm build
    The one CI job ran everything in series on one runner: 17-25 min lately (24.5 on cad/wrist-roll-drive; one run there
    was cancelled at the job's 30-minute timeout), 17 of them the slow lane (2 workers, a whole file each, so
    test_sweeps.py's ~12.5 min sat on one) and 6.7 the arm build.
    ci.yml now runs three jobs side by side, each on a runner of its own (a public repo's ubuntu-24.04: 4 vCPUs, 16 GB,
    no Actions minutes), so a run takes as long as its slowest job:
    - checks: both projects' lint, the CLI import, the OCP kernel check, the fast lane (10 min timeout);
    - slow, a matrix of two halves on 4 worke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
2026-10-15 docs: every doc checked against the code - wrong, stale, contradictory and repeated text fixed
    An audit read the 22 docs (the AGENTS.md and README.md files, cad/docs/, software/) against the code, the tools'
    --help and the git history: 302 findings, each re-checked against the code in a second pass (204 real, 89 duplicates,
    9 refuted), fixed, and the fixes reviewed twice more against the code. Every pointer to a heading resolves and every
    table row has its header's cell count. No geometry, mass or placement changed.
    The main corrections:
    - the wrist roll drive's merge left a third drive module out of cad/README.md (the layout, bom --module, the drive
    docs), a dropped wrist_link / tower.bl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
2026-10-15 tooling: CI's slow lane in three parts - the sweeps, tests/'s own files, its subfolders
    The first run of the parallel CI (38675599111) took 8.0 min, set by "the rest" of the slow lane (378 tests, 7.7 min
    of pytest); the arm build took 6.0 and the sweeps 5.6. No file dominates the rest (locally 254 s over 39 files, the
    largest test_mounts.py and test_robot.py at ~43 s each), so it splits by place: tests/'s own files (204 slow tests,
    --ignore=tests/test_sweeps.py --ignore-glob='tests/*/*') and its subfolders' (174, --ignore-glob='tests/test_*.py'),
    each picked by leaving out the other's files - a file named outright runs even when --ignore lists it - so a new test
    file always lands in one part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
2026-10-15 tooling: CI builds the arm through cadgen's daemon
    With the slow lane in three parts (run 38676827555: its slowest part 6.4 min) the arm build set the run time - 6.0
    min on one run, 8.6 on the next, the same work. CI built it with CADGEN_DAEMON=0, a process per part, each importing
    build123d before it builds; the daemon, cadgen's default, keeps spare workers that import while others build. A cold
    arm build into an empty store, 4 jobs, on the Mac: 144.8 s with CADGEN_DAEMON=0, 87.9 s through a cold daemon.
    So the workflow-wide CADGEN_DAEMON=0 goes: the arm job uses the daemon, which the runner discards with the job, and
    the test jobs keep transient builds through tests/conftest.py's own setd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
2026-10-15 Revert "tooling: CI builds the arm through cadgen's daemon"
    This reverts commit 88f2977: the daemon did not make CI's arm build faster. Run 38678189542 (the daemon) built it in
    8.8 min, against 6.0 and 8.6 min on the two runs before it with CADGEN_DAEMON=0 - runner variance, no gain. The Mac's
    145 -> 88 s came from spare workers importing build123d on cores the builds left idle; a 4-vCPU runner has none, and
    its arm build is the part builds' CPU time (run 38675599111: the children took 5 min, the arm's own assembly 26 s).
    So CI keeps transient builds, the path cadgen's executors document for CI, and the workflow-wide CADGEN_DAEMON=0.
2026-10-17 cad: j2_link an L at the wall, 5 mm shorter, a straight web and a Ø60 wrist boss
    The forearm web (j2_link) takes the profile chosen on a preview page, in three rounds:
    - The flange wall stops flush with the web's belt face, so the side profile is an L (the web and the wall on its
    motor side): its 13 mm belt-side stub is gone. The bottom wall screw's hole (Ø3.4 at z 9.5) would break out 0.2 mm
    under that face, so it keeps a Ø9 boss (RollEndParams.screw_boss_dia), its lower edge on the Ø40 recess's line
    (z 5). The gussets stay. Wall z -5..55 -> 8..55 (the boss down to z 5).
    - SHORTENING 40 -> 45: elbow axis to wrist axis 170 -> 165. The wrist-pitch motor keeps the stock 280 belt's c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
2026-10-18 cad: j2_link's wall round again where forearm_roll_pulley seats
    The L cut (the previous commit) stopped the flange wall at the web's belt face (z 8), but forearm_roll_pulley's
    Ø59.19 ring, fastened to the wall's elbow face, reaches z -4.6. So the wall's straight edge ran across the pulley's
    round face 12.6 above its bottom, the Ø40 locating recess broke out through that edge, and the bottom screw's Ø9 boss
    hung below it as a lug. Chosen on a preview page over a 4 mm round lip with the L behind it: the wall is round again
    all the way down - the hull of the Ø60 flange and the web's end section, as before the cut - so it covers the pulley's
    ring all round, the recess is closed and the botto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
2026-10-18 cad: j1_motor_leg bolted to the motor plate's sleeve by 3 radial M4s
    The motor plate's sleeve only slid in j1_motor_leg's ring (Ø70 in Ø70.4, 0.2 a
    side) and nothing else held the plate: the output pins start at z 12, short of
    its inner face at z 9, and the plate turns freely in its 6814. So the motor's
    reaction torque reached the fork through friction alone.
    Now 3 radial M4 x 20 (ForkParams.sleeve_screw_len) go through the leg's ring in
    its middle (drive z -18, coupler x 42: lib/cycloidal/layout.py sleeve_bolt_z)
    at the motor's flats - up and both sides, none down where the leg's post
    stands (ShellParams.sleeve_bolt_deg) - heads on the ring's od (r 45; an M4 head
    rocks 0.14 there, no sea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
2026-10-18 tooling: cadgen 0.7.21 -> 0.7.23; the CAD Viewer redesign, cuts become display.clip
    Upstream released 0.7.22 and 0.7.23 (both 2026-10-18); the venv and the text-to-cad@earthtojake plugin move
    together (docs/toolchain.md Pins). Same requirements as 0.7.21 (build123d 0.11.1, cadquery-ocp-novtk 7.9.3.1.1,
    playwright 1.63.0): uv.lock changes cadgen only. uv 0.13.1 on the Mac again relocks the file as `revision = 5` and
    drops two numpy markers, so cadgen's four lines were changed by hand in the committed revision-3 lock
    (`uv lock --check` passes, `uv sync` takes it unchanged).
    What 0.7.22-0.7.23 change for this repo:
    - CAD Viewer redesign (0.7.22): one tool strip (select, annotate, measure, clip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
2026-10-20 tooling: cadgen 0.7.23 -> 0.7.24; part-coloured clip caps, placed parts read under their own names
    Upstream released 0.7.24 (2026-10-18, earthtojake/text-to-cad#653); the venv and the text-to-cad@earthtojake plugin
    move together (docs/toolchain.md Pins). Same requirements as 0.7.23 (build123d 0.11.1, cadquery-ocp-novtk 7.9.3.1.1,
    What 0.7.24 changes for this repo:
    - A placed part's STEP reads back under its own name. cad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
2026-10-20 docs: the gripper is a placeholder for now
    The SolidWorks 'Gripper Mechanism' (assemblies/gripper.py, the arm's
    gripper#1 module) stands in for the gripper the arm will get. Its row in
    open_issues.md Estimates names what rides on it: its parts' geometry, the
    jaw joints (JAW_TRAVEL_MM, JAW_EFFORT_N, JAW_VELOCITY_M_S), the
    wrist_roll_link / jaw link masses and inertials, TOOL0_ORIGIN, the finger
    behind WRIST_PITCH_LIMITS_DEG's upper side, and gripper_j3_connector's
    plate (its hub on the wrist roll pulley is the wrist's side and stays).
    The Not converted yet section now says its gripper rows wait for the
    replacement, not for a conversion. Docs only: no geometry, mass or lock
    changed.
2026-10-20 docs: the gripper's replacement is not chosen yet
    The placeholder row read as if the arm's own gripper were already planned; the successor is not decided (designed here or bought). Docs only.
2026-10-20 cad: a tensioner on the wrist belt - the motor 1.97 mm nearer the wrist on round holes, the idler under the web
    Every belt gets a tensioner (cad/AGENTS.md "Belts"); the wrist belt was the last on j2_link still tensioned by its
    motor's slots. An idler only ever lengthens the belt's path, so the stock 280 needs its motor nearer the wrist than the
    belt's own centre distance - as previewed and approved:
    - lib/forearm/params.py: WRIST_MOTOR_CENTRES 80.0 [DESIGN] (the 280's own 81.97 less 1.97); DEFAULT's motor_x
    -83.028 -> -85.0 (lib/params.py J2_MOTOR_SLIDE_X -> J2_MOTOR_X, J2_MOTOR_SLIDE_RANGE gone, WRIST_MOTOR_CENTRES
    re-exported) on round holes - MotorHoleParams (the Ø22.3 pilot, 4x M3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
2026-10-20 cad: room for the MKS boards' plugs - the elbow and wrist boards turned, the roll frame slotted
    Every MKS SERVO42D board's plugs stay in as the arm moves, so each needs straight room out from its
    headers at every pose: 10 mm at the two side headers, 5 mm at the motor cable's (measured on the bench).
    lib/motors.py now carries the three headers' outlines from vendor/mks_servo42d.step
    (MKS_SERVO42D_HEADERS) and that room (MKS_PLUG_ROOM); tests/test_sweeps.py
    test_the_mks_boards_keep_their_plug_room sweeps each board against everything that moves relative to it.
    Swept on main (worst pose, -X / +X / motor plug, mm): base yaw 11.2 / 11.0 / >=30 and the drive's board
    >=30 everywhere - clear; the e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
2026-10-20 tooling: cadgen 0.7.24 -> 0.7.26; the viewer's entity Measure, mesh export on Playwright's node
    Upstream released 0.7.25 and 0.7.26 (2026-10-20, earthtojake/text-to-cad#662 and #665); the venv and the
    text-to-cad@earthtojake plugin move together (docs/toolchain.md Pins). Same build123d 0.11.1 and
    cadquery-ocp-novtk 7.9.3.1.1; cadgen now pins playwright 1.64.0 (was 1.63.0), so uv.lock changes cadgen and
    playwright. uv 0.13.4 on the Mac still relocks the file as `revision = 5` and drops the four numpy markers of
    contourpy / scipy, so only the cadgen, playwright and robotic-arm-cad entries were taken from the relock into the
    committed revision-3 lock (`uv lock --check` passes, `uv sync` takes i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
2026-10-20 tests: the plug-room sweep over 100x faster, every check the same
    test_the_mks_boards_keep_their_plug_room spent 99% of its time in build123d's optimal bounding_box(): it re-boxed
    every part of every link at every pose, though most of them do not move between poses - in its forearm_link case the
    35 shoulder and base parts, 432 times each. A vendor motor's spline box costs up to a quarter of a second
    (nema17_48mm: 256 ms, against 0.7 ms for a plain box). On CI it set the run's longest job: on the run of this
    branch's base (39491340942) its forearm_link case alone took 650 s of the sweeps job's 1003 s.
    Now each link is posed once per angles of the joints that turn it, and a part's optimal box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
2026-10-20 tests: the plug-room sweep checks the poses of its groups that hold the base
    The test skips a pose with the arm down in the table the base stands on, and judged that from every part of the
    group's links - the base among them, whose box min Y reads BASE_BOTTOM_Y - 2.8e-14 mm (base_motor_mount's - 1.4e-14;
    the Mac): float noise under its own bottom face. So every pose of a group holding base_link read as down in the
    table, and those groups checked nothing since the test came in (PR #51): the shoulder board's sweep round base_yaw
    (25 poses), the upper arm's against the shoulder and the base (42), the forearm's against them over forearm_roll x
    elbow x shoulder (432).
    Now only the parts a pose t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
2026-10-20 tooling: cadtool compile, and setup compiles the venv's bytecode
    Two costs every CAD process pays on a fresh machine (measured on the Mac; CI pays them in every run):
    - A cold store compiles each committed STEP input on its first read, in a process of its own that loads the CAD
    kernel again: 5.5 s a file (2.2 s with bytecode) for a parse of 0.4 s at most. `./cadtool compile [file.step...]`
    compiles them - every reference/**/*.step and vendor/*.step by default - in ONE process through cadgen.step.compile
    (the API cadgen keeps for tooling and CI; `cadgen step compile` takes one document a process): 62 trees in 4.5 s on
    a cold store, 0.6 s when they are current; a missing document fails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
2026-10-20 tooling: CI syncs with compiled bytecode and compiles the committed STEPs first
    The run took 6-17 min - 16 min 48 s on this branch's base (run 39491340942) - each time as long as its slowest job:
    the sweeps (345-1003 s, now cut by the plug-room fix) or the arm build (306-547 s). Both, and the other slow parts,
    spent most of it in per-process overhead on a cold runner rather than in their own work:
    - every CAD job syncs with --compile-bytecode: with no .pyc in the venv every process compiled build123d, numpy ...
    anew on import - about 106 per arm build (79 part models, 17 STEP compiles, the modules and the root) and every
    pytest worker. Measured on the Mac: kernel import 4.5-7.6 s -> 2.0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
2026-10-21 cad: model the j1_coupler fork's screws and nuts
    The screws and nuts that hold the cycloidal drive in j1_coupler's fork were only
    tools/bom.py EXTRAS rows: on the buy list, absent from the model, the totals and the
    inertials, so the fork showed empty counterbores and slots. They are now purchased
    pattern parts with no reference (lib/reference.py NO_REFERENCE), mounted like the
    base_yaw pulley's (lib/mounts.py FORK_MOUNTS, in shoulder_link, joint shoulder_pitch):
    - fork_hub_screws / fork_hub_nuts: 4x M4 x 25 from the hub leg's counterbores along the
    drive's axis into the nuts captive in the output hub's flange, tips flush with them;
    hosted on j1_coupler#1
    - fork_foot_screws / fork_foot_n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
2026-10-21 cad: model the wrist-pitch motor's 4x M3, heads flush in counterbores under j2_link's web
    The wrist-pitch motor (nema17_40mm#3) stood on j2_link's four plain Ø3.4 holes with nothing holding it. The user asked
    for its screws to be modelled, in counterbores, and picked flush heads with M3 x 12 (over a 2 mm deeper counterbore
    with M3 x 10, whose counterbore would have come 1.55 mm from the wrist idler nut's channel along 2 mm of its height).
    It is the elbow motor's screw and seat: j2_link's web is 11 thick, like the web under the elbow motor.
    - New purchased part wrist_motor_screws (parts/joints/): 4x M3 x 12 SHCS (ISO 4762), lib/fasteners.py shcs(). It is a
    pattern part with no reference (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
2026-10-21 cad: the wrist roll's MKS board on the pancake, wrist_link's pocket open behind it
    The wrist-roll pancake was the only stepper on the arm without its MKS SERVO42D. The board's
    encoder reads a magnet on the motor's rear shaft end, so it can only sit on the pancake's rear
    face - where wrist_link's pocket had its rear wall. That wall goes: a window takes the board
    (chosen over enclosing the board in a deeper pocket, after a preview).
    - The board: a wrist_roll_drive stator row on the pancake's rear face, turned with it
    (motor_spin_deg 90: its motor plug toward the pancake's connector at the open face, the side
    plugs along the belt).
    - The window (lib/wrist/layout.py board_window): the board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
2026-10-21 cad: base_motor_mount becomes the base's other half - full width to a round end, the foot round it, slits round both
    The motor mount looked out of place beside the base: an upright box with V-truss walls and ears, next to a base that
    leans out at 10.8 degrees on a chamfered foot. The new shape was chosen on rendered previews, in three rounds: the
    base's D carried on at full width to a matching round end, the foot all round, the joint bolts inside; then plain
    slits through the walls (not framed windows with grills: they print without bridges), as an even ring.
    The mount (lib/base/body.py build_motor_mount):
    - The walls are the base's leaning planes carried on past the joint face, shell.wall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
2026-10-21 cad: the roll motor's 4x M3 x 8, heads flush in counterbores in a 7 mm plate; the motor 3 mm back, no slide
    The forearm roll motor (nema17_40mm:forearm_roll) hung on four tension slots in the roll frame's 4 mm plate with no
    screws modelled. The user asked for its screws, in counterbores, and said the motor need not slide: the idler on the
    frame's face already tensions the roll belt. A 4 mm plate cannot take a 3 mm counterbore, so the user picked, from four
    options (preview page first), the motor 3 mm back with the plate grown to 7 mm toward it - over 5 mm back (M3 x 10),
    7 mm back (M3 x 12, the elbow / wrist screw, but a 1.5 mm plug-slot wall and the 20T 2 mm off the shaft's tip) and
    pads on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
2026-10-21 cad: the base_yaw motor's 4x M3 x 8, heads flush in counterbores, on a 2 mm pad; the pilot in a round hole
    The base_yaw motor (nema17_48mm#1) hung under base_motor_mount's 5 mm plate on four plain Ø3.4 holes with no screws
    modelled, its pilot in a square 22.4 window. The user asked for its screws, counterbored, and for the pilot to sit in a
    round cutout like the drive motor's. A 5 mm plate leaves 2 mm under a 3 mm counterbore, so the user picked, from three
    options (preview page first), a 2 mm pad under the plate round the motor's face with the motor 2 mm lower - 4 under
    the heads and the roll motor's M3 x 8 - over keeping the 5 mm plate (2 under the heads, M3 x 6) and a 4 mm pad (6 under
    t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
2026-10-22 cad: the elbow pulley 90T -> 108T on a stock 300 belt (5.4:1), its idler 1.9 mm nearer the motor
    Why: more torque at the elbow, which is short of holding the forearm level. A bigger driven pulley is the step that
    needs no new stage. With the elbow motor where it is (ELBOW_MOTOR_CENTRES 78, its board 2.3 mm off the roll frame at
    the elbow's lower limit), 108 teeth is the most the stock belts and the tensioner rules of
    tests/upper_arm/test_elbow_idler.py take: a 110T leaves the 300 only 3.35 mm over its open loop, and 115T or more needs
    the motor nearer the elbow. Chosen from a to-scale preview (scratch build, before / after renders, overlay).
    The pulley: gt2_pulley_108t (parts/joints/), lib/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
2026-10-22 cad: the roll frame's end an octagon about the elbow axis, straight-sided with sharp corners
    forearm_roll_block (the roll drive's frame on the elbow) was a teardrop seen along the elbow axis: an r 45 circle
    round the elbow axis hulled up to the tower. Restyled to read more geometric: three outlines were previewed (an
    octagon, a square end with 45-deg corners, a pointed hexagon), all keeping the rear line; the octagon was chosen,
    with sharp edges (no chamfer: a cover will go over the open +N face later), the round bearing boss kept, and
    j1_link's round end left round.
    - lib/forearm/roll.py profile(): the circle becomes a regular octagon (RollDriveParams.end_sides 8), a flat on each
    axis en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
2026-10-23 cad: the roll frame opens through its bottom and back, its side closed; the roll's 6806 pair 19 mm apart
    The roll frame (forearm_roll_block) was open on its whole side (+N) face - the motor dropped in from there, the board's
    plugs rode down slots off it, the shaft and bearing 1 went into the bay through it - and a cover over it was planned.
    The side face is now closed and the openings moved:
    - The motor's pocket opens down through the octagon's bottom face: the motor and its board slide up into it
    motor_drop back (the pilot boss under the plate), then forward into the pilot hole. The shaft's slit through the
    plate runs from the pilot hole down to the bottom instead of out to the side.
    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
2026-10-23 cad: the wrist's gripper to its outer side - the wrist bends down to -150, the elbow folds to 144
    Asked from the CAD Viewer: the wrist should point down, and the elbow should fold further, its range taking
    precedence over the other joints'. The elbow's upper limit (90) was a leftover of the old forearm wall, which no
    longer reaches the upper arm; the gripper is what set the room after it. Previewed and approved first (scratch build,
    renders, sweeps).
    - lib/wrist/params.py WristRollParams.side (new, -1 [DESIGN]): the wrist roll axis R' - the gripper - sits
    WRIST_ROLL_OFFSET along wrist_link's -Y, the outer side (away from the upper arm when the elbow folds, the forearm
    turned), not +Y. T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
2026-10-23 cad: the forearm roll rotor's clamp modelled - 4x M3 x 45 + 4 M3 nuts on the rotor
    The roll rotor's clamp (RollDriveParams clamp_*: 4x M3 from the pulley's front face
    through both pieces and both 6806 inner rings into nuts in the shaft's flange) had its
    holes, head counterbores and nut pockets in the printed parts but no fasteners: the
    screws and nuts were two tools/bom.py EXTRAS rows. They are parts now, placed in
    forearm_roll_drive on the rotor (forearm_link), so the model, the totals, the buy list
    and the inertials carry them.
    - parts/joints/roll_clamp_screws: 4x M3 x 45 SHCS (ISO 4762), no reference (envelope,
    lib/fasteners.py shcs()), 1529.299 mm^3, MASS_G 12.0 g (ROLL_CLAMP_SCREWS_M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
2026-10-27 tooling: cadgen 0.7.26 -> 0.8.0 - the engine replaces the store, @step(out=...), import build123d
    cadgen / text-to-cad 0.8.0 (2026-10-27) rewrites the runtime with no compatibility layer: a 0.7 project
    stops at its first `from cadgen import build123d`. The repo keeps its shape - every model still writes its
    sibling STEP, so Recipe C's hash gate, the snapshots and CI's arm build stay - and moves every 0.7 name:
    - pyproject.toml / uv.lock: cadgen 0.7.26 -> 0.8.0; Playwright, greenlet and pyee leave the lock (snapshots
    are drawn by OCCT). The kernel pins are unchanged (0.8.0 asks for the same build123d / ocp-novtk ranges).
    - Every model: bare `@step` -> `@step(out="<name>.step")` (0.8 requir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
2026-10-27 tooling: cadgen 0.8.0 -> 0.8.1 - build123d 0.13, OCCT 8.0.1
    text-to-cad 0.8.1 (released 2026-10-27) moves cadgen onto a new kernel:
    build123d 0.11.1 -> 0.13.0 and cadquery-ocp-novtk 7.9.3.1.1 -> 8.0.1.1.0
    (OCCT 8), and replaces cadgen's material API with bd_materials (unused
    here). The plugin pins the same cadgen, so the pin moves with it.
    Pins: build123d==0.13.0, cadquery-ocp-novtk==8.0.1.1.0, cadgen==0.8.1.
    New transitive packages: bd-materials 0.2.5, threejs-materials 1.2.5 (+
    pygltflib, platformdirs, dataclasses-json ...); ocpsvg 0.6.0 -> 0.7.0,
    ocp-gordon 0.2.2 -> 0.3.1, cadquery-ocp-proxy follows the kernel. No
    cadquery-ocp (VTK) in the tree.
    OCCT 8 renames the OCP names this repo re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
2026-10-28 cad: removable back panel on the forearm roll frame - flush, held by magnets
    The roll shaft sat behind a bare Ø51.2 hole in the frame's slanted rear face. The
    back now takes a removable panel: lift it off and the shaft, its clamp nuts and the
    stop post are open to reach; put it back and the back is closed, flush.
    - forearm_roll_block: the rear face stepped BackPanelParams.t (2.5) across its full
    width, from the tower's top down to `bottom` (56 below the roll axis' point, along
    the face); the bay's opening grown down below its bore to `opening_bottom` (R6
    corners, `opening_depth` 12 in - 8.8 of frame left over the motor's pocket); 4
    magnet pockets in the step's floor (3.7 of wall to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
2026-10-28 cad: j2_link's web dropped 13 mm toward its belt side, level with the roll wall's bottom
    The user wanted the forearm's web further toward its belt side, into the face of the roll wall
    that hung below it, so the wrist belt and its pulleys sit further from the roll axis. Chosen
    from a preview of 4 / 8 / 13 mm: 13, the web's underside level with the wall's round bottom.
    The roll wall stays on the roll axis; the web, the wrist boss and everything on them drop
    WEB_DROP (lib/forearm/params.py, derived: LEGACY web z0 - the wall's bottom = 13) along the
    wrist_pitch axis toward the belt side:
    - DEFAULT web z 8..19 -> -5..6; boss seat_z1 / z1 27.5 -> 14.5, lip_z (17, 19) -> (4, 6);
    roll_end.wrist_b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
2026-10-28 cad: j1 fork legs one size, straight-sided, their posts inside the disc's rim
    The fork's two legs each were a round top on a 50 mm post - the hub leg a Ø70.3 disc, the motor leg a Ø90 ring -
    and the user found them looking like lollipops: they wanted the legs of one uniform width. Previewed as scratch
    builds (claude.ai artifact, two rounds): the user picked both legs alike at the motor ring's size (over each leg at
    its own width), then asked that the legs not go over the round base; of the two versions shown for that (45 degree
    feet only, or the posts cut to the rim as well) they chose the posts inside the rim.
    What changes (lib/yaw_coupler/, DEFAULT only - LEGACY and the reference match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
2026-10-29 cad: j1_link slimmed - 18 deep, 76 wide, its elbow end R36
    The upper arm's solid slab was still the old plate's full outline, 23 deep and 90 wide with an R45 elbow end. It is
    slimmed for mass, which the shoulder's cycloidal drive carries: the size picked from a preview of depth, width and
    elbow-end options, the roll frame left as it is.
    - Depth: ElbowParams.relief_y -1 -> -6, the recess floor - the slab's top level with the upper 6806's top, as deep as
    the elbow's bearing stack (23 -> 18); no recess is left (link.py _cut_elbow_stack skips a recess whose floor is the
    top face).
    - Plan: ArmParams width 76 (the plate's 90), end_r 36 (45), bend_r 20. link.py _outline: the slab keeps its wid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
2026-10-29 docs: a stale arm after a finished gen too - its run must name what it rebuilt
    In a fresh worktree (cad/upper-arm-slim) the baseline gen of the arm had returned before lib/upper_arm/ was edited, yet the next gen of the arm read 'nothing ran' (cold, from the shared cache) and kept the old STEP while j1_link alone rebuilt; gen --force cleared it. The gotcha blamed only an edit during a run; it now says to read the arm's run for what it rebuilt and to force it when it says 'nothing ran' after a source edit.
2026-10-29 cad: the elbow pulley 108T -> 90T on a stock 280 belt, a 5:1 gearbox to carry the reduction
    Why: a 5:1 planetary gearbox (StepperOnline EG17-G5) was bought for the elbow motor, so the belt no longer has to
    carry the elbow's whole reduction and its driven pulley can shrink. Chosen from a to-scale preview (scratch builds of
    each size against the repo's idler rules and clearance tests): on a stock belt only 90T and 80T fit - 78T and smaller
    need the motor moved toward the shoulder, where its board meets the cycloidal drive (78T, 6 mm back) or the motor
    runs into j1_link (76T, 7 mm back). 90T keeps the motor where it is and is the wrist's own pulley part.
    The pulley: the elbow's driven pulley i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
2026-10-29 cad: the roll frame's octagonal end R45 -> R42
    The roll frame's octagon about the elbow axis was sized to the upper arm's old R45 round end; since the arm was slimmed
    to an R36 end it stood 9 proud of it all round. It comes in to R42, close to the least the frame allows: the roll
    motor's pocket keeps 5 of wall outside its top corners (36.75 off the elbow axis: 41.75), and the lip (Ø72) 5 inside
    the flats (41). The frame cannot match R36 - its motor's pocket alone reaches past it.
    - RollDriveParams.end_r 45 -> 42. The rear line, tangent to the end_r circle, turns -63.32 -> -65.18 deg; the back
    panel and its magnets, flush on it, follow. The octagon's lower front facet now cuts the front o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
2026-10-29 tooling: cadgen 0.8.1 -> 0.8.2; snapshot --preview retired, STEP finishes for materials
    Upstream released 0.8.2 (2026-10-28, earthtojake/text-to-cad#694, #706,
    #708, #712); the venv and the text-to-cad@earthtojake plugin move together
    (docs/toolchain.md Pins). Same build123d 0.13.0 and cadquery-ocp-novtk
    8.0.1.1.0, and cadgen's own requirements are unchanged, so uv.lock moves
    cadgen alone.
    What the release changes for this repo:
    - `cadgen snapshot --preview` is gone (the flag, a job's `preview` key,
    cad_snapshot's `preview`): a snapshot draws the technical OCCT look only,
    the photographic look is the browser viewer's Preview. `./cadtool
    snapshot ... --preview` now stops with "unrecogn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
2026-10-30 tooling: cadgen 0.8.2 -> 0.8.3; urdf / sdf / dxf snapshot retired, cad_http the page's alone
    Upstream released 0.8.3 (2026-10-30, earthtojake/text-to-cad#714, #716,
    #722, #730); the venv and the text-to-cad@earthtojake plugin move together
    - `cadgen urdf snapshot`, `sdf snapshot` and `dxf snapshot` are gone; plain
    `cadgen snapshot` draws those files. `./cadtool snapshot` was always that
    one, and nothing in the repo named the others. robot/arm.urdf (posed) and
    robot/arm.sdf both still render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
2026-10-30 tooling: cadgen 0.8.3 -> 0.8.4; doctor reads the plugin's pin from claude.mcp.json
    Upstream released 0.8.4 (2026-10-30, earthtojake/text-to-cad#732, #733)
    50 minutes after 0.8.3's merge here. `claude plugin update` takes the newest
    release, so the plugin landed on 0.8.4 ahead of the pin and `./cadtool
    doctor` reported a MISMATCH; this bump brings the pin up to it. Same
    build123d 0.13.0 and cadquery-ocp-novtk 8.0.1.1.0, and cadgen's own
    requirements are unchanged, so uv.lock moves cadgen alone (made with
    `uvx uv@0.13.4 lock`: docs/toolchain.md Gotchas).
    - The skills' SKILL.md no longer carry `cadgen==<ver>`: it moved to each
    skill's references/setup.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
2026-10-30 docs: a stale arm needs no fresh worktree
    Testing 0.8.4's rewritten source tracking turned up a wider case of the
    gotcha in cad/AGENTS.md, which read as needing an edit during a run or a
    fresh worktree. With a warm engine, RIM_CLEAR in lib/yaw_coupler/params.py
    (DEFAULT is computed from it at module level) edited from 0.5 to 0.6: the
    arm read `nothing ran` and j1_coupler.step kept its bytes, while `gen
    parts/base/j1_coupler.py` alone rebuilt the part and named the edit. The
    next arm run still read `nothing ran`. 0.8.3 and 0.8.4 behave the same, so
    this is no regression of the bump, and --force is unaffected, which is why
    the hash gates hold. The rule stands as written: `nothing ran` after a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
2026-11-02 tooling: Python 3.12 -> 3.14, uv-managed on every machine
    cad 0.10 requires Python >=3.14; this lands first and alone, on cadgen 0.8.4, so that anything the interpreter
    changes is told apart from anything the cad switch changes.
    `requires-python` goes from `>=3.11,<3.14` to `>=3.14,<3.15` (build123d and the OCP wheels allow nothing newer) and
    `.python-version` to 3.14. `[tool.uv] python-preference = "only-managed"` is new: uv would otherwise take Fedora's
    /usr/bin/python3.14, and the PC, the Mac and CI now run one interpreter build (CPython 3.14.10 here). The ruff target
    follows `requires-python`: py311 -> py314, no finding.
    uv.lock: only the forks that existed for Python 3.11 go (contourp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
2026-11-03 tooling: cadgen 0.8.4 -> cad 0.10.0, one pinned server per machine
    Upstream's 0.10 (0.9 was skipped, a PyPI name clash) splits text-to-cad into `cad`, the library, `cad-server`, the
    machine's one server with the `cad` command, and `cad-mcp`, the plugin's shim. `from cadgen import ...` still works:
    `cadgen` is an alias of the same modules, so no model file changes. What moved is everything around them, in one
    commit because the tree breaks otherwise:
    - `cad[build123d]==0.10.0` replaces `cadgen==0.8.4` and is the toolchain's ONE pin: `cadtool` reads it, CI restates
    nothing. uv.lock swaps cadgen for cad, nothing else.
    - The venv has no CLI any more. `cg()` runs `$(uv tool dir --bin)/cad`, af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
2026-11-03 docs: cad 0.10, one server per computer, and how to test a bump
    The docs and docstrings of the two commits before this one: nothing here changes behaviour.
    docs/toolchain.md: Pins is the one pin and the three things released at it, the server before the plugin and why, one
    server per computer (workers keyed by script, environment and release; what runs outside the venv; the one memory
    budget and where its caps are read; `stop` and `stop --device`), the telemetry order and the two ways it fails
    silently. New sections: "Testing a bump", the isolated server every bump tests on, and the one-time move of a machine
    off cadgen 0.8, which `cad doctor` makes a closed-sessions job. The hash gate gain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
2026-11-03 cad: two-tone colours by kind of part, the design language's first step
    The arm's parts came from the SolidWorks capture, the CadQuery port and this repo, each with its own look,
    and every link group had its own colour. The design language (docs/design_language.md, new) makes them one
    machine: faceted structure, round where parts turn, chamfered edges, two tones, covered belts. This commit
    is its colours; the shapes, chamfers and covers follow (docs/open_issues.md row).
    - lib/style.py (new leaf): BODY #E6E3DC off-white for the printed structure, ACCENT #F29F5D for the printed
    parts that drive, turn or cover (it draws as the filament's #E2581C, which itself renders a deep red),
    BOUGHT #9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
2026-11-03 cad: faceted upper arm end and chamfered outlines (upper arm, roll frame)
    The design language (docs/design_language.md) carries the roll frame's octagon to every structural end and puts
    one 45 deg chamfer on the outline of every printed part's main faces. This is its first shape step: the upper
    arm and the roll frame beside it at the elbow.
    - lib/style.py: SIDES = 8 (the faceted ends, a flat on each of the part's own axes) and EDGE_CHAMFER = 1.5 mm.
    lib/geom.py: faceted_end() (the polygon, as the roll frame's end was drawn) and chamfer_outline() (both end
    faces' outline of a prism, cut before its holes so they stay sharp).
    - j1_link: the slab's end about the elbow axis is an octagon wit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
2026-11-03 cad: forearm widened to its belt cover, faceted forearm and wrist ends
    The design language (docs/design_language.md) covers the wrist belt; its cover has to clear the wrist's 90T,
    which is wider than the 60 mm web, and the user picked widening the whole forearm to the cover's end (option
    W2 of the preview) over a flared wrist end. With it the forearm's and the wrist's ends go faceted and
    chamfered.
    - lib/style.py: COVER_WALL = 2.5 and COVER_CLEAR = 2.0 mm, a belt cover's wall and its clearance to what it covers.
    - j2_link: WebParams.half_w 30 -> 34.09389 (the 90T's flange_dia / 2 + COVER_CLEAR + COVER_WALL), the boss as
    wide; the web's wrist end and the boss faceted (lib/geom.py faceted_e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
2026-11-03 cad: faceted base, motor mount and fork legs
    The design language's last shape step (docs/design_language.md): the base's round half, the motor mount's end
    and their foot become octagonal, a frustum on an octagonal flange, and the fork's legs get faceted tops, like
    the rest of the arm. The base_yaw turntable - the fork's disc and the base's cap - stays round: it turns.
    - lib/base: ShellParams.sides (DEFAULT lib/style.py SIDES, LEGACY None: the SolidWorks base stays round). body.py
    draws the round half, the mount's end, the foot's flange and chamfer, the plate inside and the cavity under the
    cap as faceted prisms / frustums (_round, _cone lofted between two faceted_end sections, _d_sectio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
2026-11-03 cad: faceted base frustums as tapered extrusions, planes not B-splines
    CI's clean-clone run of the faceted base (run 41585814961) failed its slow lanes: the base read 413222.893 mm3 on
    the x86_64 runner against 413225.114 on the Mac, 2.2 mm3 apart, past the 0.5 locks (test_foot VOLUME, the
    arm's and base_link's totals, base_link's ixy). The faceted frustums - the walls, the foot's chamfer, the mount's
    end - and the cap's chamfer were ruled lofts between two sections, whose side faces the kernel makes B-splines;
    it integrates their volume differently per machine. They are now faceted_end sections extruded with a taper:
    the same frustums, every flat a plane (the base: planes, cylinders, the ca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
2026-11-03 docs: a ruled loft's B-spline faces integrate per machine - draw frustums as tapered extrusions
    The faceted base's first CI run (41585814961) read its volume 2.2 mm3 apart on the x86_64 runner and the Mac:
    its lofted frustums' side faces were B-splines. lib/AGENTS.md Kernel gotchas now says so and names the fix the
    branch took (lib/base/body.py _cone: bd.extrude with a taper, all planes).
2026-11-04 tooling: cad 0.10.0 -> 0.10.3
    Upstream released three patches on 2026-11-03. None changes how a model builds or what a STEP holds:
    - 0.10.1 (earthtojake/text-to-cad#760): on Windows, cad's state, cache and engine folders move out of
    %LOCALAPPDATA% / %TEMP% (which an MSIX app package virtualizes) to ~\.local\state\cad, ~\.cache\cad and
    ~\.local\state\cad-engine, the Linux rule; 0.10.0's Windows folders are adopted once. Linux and macOS paths are
    unchanged (places.py, cad_mcp/engine.py). Windows console tools are read in the OEM code page.
    - 0.10.2 (#762): the viewer moves to three r187 (Preview reflections, the selection ghost).
    - 0.10.3 (#764, #752): `cad export --tolerance MM` and `@s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
2026-11-05 cad: roll frame's tower faceted to the forearm flange's octagon, front edges faceted; 3 x 2 mm panel magnets
    The roll frame (forearm_roll_block) read as one boxy 60 mm wedge whose square tower ignored the forearm's octagonal
    flange bolted right in front of it. Picked from a preview of five reshapes (variant A + B):
    - The tower, seen along the roll axis, is now the forearm flange's octagon (lib/forearm/roll.py tower_section:
    lib/geom.py faceted_end, flats tower_y = RollEndParams.wall_od / 2, over the half-plane under the roll axis), so the
    flange's facets run straight back through the frame. Its two top corners lose 17.6 mm facets; the bay keeps 4.4 mm of
    wall to the diagonal flats, as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
2026-11-05 cad: wrist frame laid out as the forearm roll frame - bottom entry, closed far face, back panel
    wrist_link's roll frame was an open bracket under the plate: the pancake went in through the open far face, and its
    board's window and the shaft's bay opened there too. The user wanted it to read like the forearm roll frame
    (forearm_roll_block) and picked "N+A+C, flat panel" from rendered previews:
    - Seen along the pitch axis the frame is the plate's octagon about it hulled to the tower round R' (lib/wrist/roll.py
    side_profile; seen along R' the tower the octagon about it, tower_section), from the plate's coupler face to a CLOSED
    far face (WristRollParams.side_t 7.5: the wall's inside 22.5 of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
2026-11-05 cad: j1_coupler's disc the base's octagon carried up, the fork's legs growing out of it in facets; the base turned to meet it at zero
    The user found the fork's legs ("wings") did not look good where they met the round disc: below the bolts three
    shapes met - the octagon top's corner stepping in to a post trimmed to the disc's rim, flat strips of that post down
    either side, and the disc's cone carried up the leg's face to a curved point. Previewed as scratch builds (claude.ai
    artifact, three rounds): of four faceted transitions the user picked the one rising from the disc's rim, asked to
    carry it round the whole rim, chose 8 sides on the base's own cone (over 8 inside the rim, 16, 20) with th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
2026-11-06 tooling: cad 0.10.3 -> 0.10.4
    Upstream released 0.10.4 on 2026-11-06 (earthtojake/text-to-cad#774). It changes nothing in how a model builds or
    what a STEP holds:
    - #771: an export given a mesh tolerance (`cad export --tolerance MM`, `@stl(..., tolerance=)` / `@threemf`) also
    sets `ForceFaceDeflection` (`cad/engine/mesh.py`), so a face whose edges carry a looser tolerance is held to the one
    asked for. The viewer's mesh and every default export are unchanged. Nothing here asks cad for a tolerance (the
    printables and the URDF link meshes go through build123d's `export_stl`), so no committed STL moves.
    - The rest: the viewer's npm dependencies, upstream's CI, and the version strings (the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
2026-11-07 tooling: cad 0.10.4 -> 0.11.0
    Upstream released 0.11.0 on 2026-11-07 (earthtojake/text-to-cad#756, #788, #789): a minor release that breaks the
    command line and renames library names. Its kernel is unchanged (build123d 0.13.0, cadquery-ocp-novtk 8.0.1.1.0), so
    uv.lock moves cad alone and no model moves.
    What this repo follows:
    - The `cad` verbs are `cad <document type> <operation> FILE` now (a hard cutover). `./cadtool snapshot` / `export`
    take the type from the file's suffix (`doc_type`; anything else is a document id, `model`'s): `cad step snapshot`,
    `cad urdf snapshot`, `cad step export`. The docs' `./cadtool cad inspect` is `./cadtool cad step inspect`.
    `cad delete` and `cad docto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
2026-11-07 cad: j2_link's flange an octagon through, its lower facets carried onto the web
    Where the forearm web (68.2 wide, its belt cover's end) met the roll flange (the
    60 mm octagon carried on from the roll block's tower), the wall had a rectangular
    foot under the octagon, its elbow-side 5.3 cut back to an r36 arc round the roll
    tensioner's screw head: each lower corner showed the foot's tip, the arc, a long
    slanted side and the web's chamfer ending in it - it did not read as one piece.
    Chosen from four rendered options (the web butting on, facets over 30 or 15 mm,
    the web narrowed onto the flats as well).
    Now the wall is the plain octagon through its whole 8 mm and the web grows out of
    it: the oc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
2026-11-07 cad: the roll frame's elbow flange one Ø40 post - the SolidWorks coupler's lip, boss and journal rings gone
    The user asked what the four rings under forearm_roll_block were. They were the SolidWorks j3_coupler's steps,
    copied onto the frame when it became the elbow's output flange: a Ø72 x 5 lip, a Ø62 x 4 boss, a Ø40 x 1.3 journal
    and the Ø33 x 0.7 shoulder over the Ø30 stub. The recess in j1_link they turned in is gone (its top is flat, level
    with the upper 6806), so the lip hung 6 mm over a flat top and covered nothing - its edge 2.15 mm proud of the frame's
    front face -, the boss only held the elbow 90T's nuts and the journal was a 1.3 mm sliver 0.7 over the bearing.
    Previewed as s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
2026-11-07 cad: the rack & pinion gripper's four parts, measured from PapaBravo's exports (not placed yet)
    The arm's gripper (arm/wrist: the SolidWorks MG996R crank gripper, open_issues' "placeholder") is to be replaced by
    PapaBravo's "Rack & Pinion Robotic Gripper Jaw" (Printables, licensed CC BY 4.0 - attribution required), on the same
    MG996R: chosen 2026-11-07 over the user's own AR gripper (Fusion .f3z + STLs, an SM85CL: 614 g + its servo and
    180 mm past the roll pulley's face, against 120 g and 110 mm). This commit brings its four printed parts in as
    measured conversions (parts/AGENTS.md Part states), modelled but not placed (UNPLACED) - the module, its bracket and
    the swap come next.
    - lib/gripp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
2026-11-07 cad: wrist_link's plate carries the wrist_pitch flange as one Ø40 post - j3_coupler#2 retired like #1
    The wrist had the same SolidWorks coupler the elbow's post replaced (previous commit), still as its own part bolted to
    wrist_link's plate: a Ø78 x 10 disc (4 M4 at r 35 into nuts in the plate), a Ø58/62 x 4 lip ring - a dust lip for the
    Ø80 recess j2_link's wrist boss no longer has, turning 0.5 under its flat face -, the Ø40 journal, the shoulder and the
    stub. Previewed as scratch builds (claude.ai artifact: matched renders, an overlaid section): of four ways to follow the
    elbow's design - A the post on the plate, one piece; B the plate's octagon carried up where the disc was, one piece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
2026-11-07 cad: the rack & pinion gripper replaces the SolidWorks gripper on the wrist roll
    The arm's gripper was a placeholder (open_issues): the SolidWorks 'Gripper Mechanism', an MG996R crank linkage on two
    6 mm rails, as captured - its jaw travel did not fit it (the capture pose open already). The user chose PapaBravo's
    "Rack & Pinion Robotic Gripper Jaw" (Printables, CC BY 4.0; its four parts measured in 21c2aef) on the same MG996R,
    the gripper only (the wrist pitch and the wrist roll stay), its standard jaws opening in the swing plane as before,
    the pinion pressed on the servo's spline as PapaBravo builds it, and a cage (designed here) holding it on the
    connector. This places it: assemblies/gripp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
2026-11-07 cad: grills on both back panels - vertical slots over the shaft's bay
    The forearm roll frame's and the wrist frame's removable back panels were plain plates. They now carry a grill:
    straight slots cut through, running up the panel, one on the roll axis, the turning shaft showing behind them. Picked
    from a rendered preview of four patterns (horizontal slots, vertical slots, 45 deg chevrons, octagon holes) and a
    recessed variant: vertical slots, cut through, on both panels, the field over the bay inside the rim. It is a look,
    not a vent - neither panel covers a motor or a driver board (docs/design_language.md "Back panels are grilled").
    - lib/style.py: GRILL_SLOT 2.0 / GRILL_PITCH 4.0 (new, t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
2026-11-08 cad: wrist_link's plate gone - the flange post cut flush with the roll frame, the wrist 90T's bolts turned 45°
    The 78 mm octagon on the wrist_pitch axis was the SolidWorks wrist body's R39 round end, faceted
    later; the wrist roll frame was built under it and cut back (its front face at z_front, its rear at
    rear_low), so the plate stood 23.5 mm past the frame in front and 20.5 mm behind, carrying nothing
    but the foot of the Ø40 flange post. The user wanted it "as gone as possible" and picked, from
    rendered previews (round 1: a pad, a strap, j2_link's octagon; round 2: a round post carried down,
    the post cut flush, flush with the bolts turned), the flush post with the bolt pattern turned.
    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
2026-11-08 docs: what the design sessions learned, written where the rules live
    Several rules and requirements the user gave in design sessions lived only in Claude's memory on the Fedora PC:
    no other session, machine or reader saw them. They now live in the doc that governs each one; the memories shrink
    to pointers.
    - cad/AGENTS.md Design choices: the preview page comes before a plan is approved (in plan mode too - a plan
    whose first step is "build the preview" is not enough), every changed decision gets its own render, moving things
    get a posable model; change only what was asked (an option from an earlier round is not carried on), and a
    constraint that forces a feature is rendered with its nu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
2026-11-08 docs: GitHub deletes a merged branch itself - only the local cleanup is left
    The repo's "Automatically delete head branches" setting is on (`gh api repos/hbenuid/robotic-arm -q
    .delete_branch_on_merge` -> true), so `gh pr merge` removes the remote branch. After PR #92 a hand-run
    `git push origin --delete` failed with "remote ref does not exist". The root AGENTS.md Git workflow now names the
    setting and lists what is left after a merge: `git fetch --prune`, `./cadtool stop` in the worktree's `cad/`,
    `git worktree remove`, `git branch -d`.
    Docs only. Checks: ./cadtool pytest -m "not slow" -n 4 - 749 passed.
2026-11-08 cad: drop three parts no assembly places - j3_coupler, cycloidal_ring_gear_body, gt2_pulley_20_60t
    None of the three was in the arm, its print list or its buy list:
    - j3_coupler: the SolidWorks elbow / wrist coupler, retired at both places (the forearm roll drive's
    block and wrist_link's flange took over). Gone: the part, lib/coupler/body.py and layout.py,
    tests/coupler/, reference/solidworks/j3_coupler.step and its manifest entry. lib/coupler/params.py
    stays - the roll block, wrist_link's flange, the mounts and the yaw coupler read its numbers - and
    the one cross-part check of the deleted test (the roll block repeats the coupler's stub, journal,
    bolt circle and DEFAULT's shoulder)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
2026-11-08 docs: reference/ and vendor/ READMEs cut to what the manifest and the code do not say
    reference/README.md listed every reference file's product, source export, units, solids and bbox in
    two tables - manifest.json holds each of those per file, lib/reference.py the name maps - and its
    Notes restated SKIPPED_PRODUCTS. Now: a pointer to both, the provenance of the raw exports (sizes
    and sha256 left to manifest.json `monolith` and the lib/reference.py names, where they already are),
    the SolidWorks assembly's nodes (designed module, skipped, the retired j3_coupler records) and the
    placements.json schema, which is written nowhere else. The 20-60T export's bullet went with its part.
    vendor/README.m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
2026-11-08 docs: cycloidal_drive.md loses the port's history and what repeats the code (461 -> 382 lines)
    Cut:
    - §11 Port notes: the CadQuery -> build123d translation table, the magic numbers promoted, the dropped
    fields, the corrections to the drive repo's spec, the export.py / assembly.py layout story, the two
    venvs (tools/AGENTS.md) - the port is done and `git log` keeps it.
    - §9 Shopping list: the 2f1f67d price estimate; what to order is one line at the end of §3 now
    (`tools/bom.py --module cycloidal_drive`).
    - §10 Where things live: a file inventory the code and the Overview already give.
    - §13 Change policy (carried over): Recipe C and the tests' own rules say it.
    - §5.2's paragraph o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
2026-11-08 docs: the Gotchas keep their rules, not the releases they were seen on
    cad/AGENTS.md and docs/toolchain.md carried "verified on cadgen 0.8.0 / 0.8.1 / 0.8.3 / 0.10.0"
    trails, the incidents behind a rule told in full and per-release examples. Each gotcha now states its
    rule and, where it matters, the cases it was seen in:
    - cad/AGENTS.md: the stale-arm gotcha (three incident reports) is one rule - after a source edit the
    arm's run must name what it rebuilt, else force it before the hash gate - with the three cases
    listed; the vendor-file and snapshot-scale gotchas drop their verification trails.
    - docs/toolchain.md: the telemetry, BinTools, uv-lock, cadquery-ocp, bump hash-gate, OCCT 8 na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
2026-11-08 docs: open_issues.md - two stale rows and the empty "Not converted yet" section closed
    Closed (an audit of every row against the code):
    - Not confirmed, "Which joints get an endstop / home sensor": superseded by the Not modelled yet row
    "The joints' home sensors, none placed" (each joint's endstop designed on its own); it still said
    only the forearm roll's was planned.
    - Estimates, "The end effector is off the base_yaw axis": not an estimate and closed by its own text
    ("accepted for now"); the offsets are code (robot/frames.py, lib/placements.py SHIFTS) and what they
    mean for the software is the "kinematics carry an elbow and a wrist offset" row.
    - "Not converted yet": its table was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
2026-11-08 docs: open_issues.md - rows corrected and shortened (44 -> 36 KB)
    Corrected:
    - "A tensioner on every belt" listed all five belts, four of which have their idler now: it is
    "The wrist roll belt has no tensioner", with why the roll's idler kit finds no room on wrist_link
    and what closes it.
    - The roll motor board's side-plugs row had three cells in a two-column table, so its last cell
    never rendered: merged into the second.
    - Three rows named j3_coupler as a live part (the turning shell's fits, the 6806 seats,
    link membership): reworded to what took its place.
    Shortened, each keeping the issue, the constants and tests it lives in and what closes it: the wrist
    pitch range and the elbow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
2026-11-08 cad: the 120T's plain hub gone - the base 6.5 mm shorter, the arm 6.5 lower on the table
    The base_yaw 120T carried the 90T's hub over whole: the journal in the lower 6806, the ring under its inner ring,
    then 6.5 of plain hub (the Ø30 shaft and the Ø35 step) before the web. That plain hub did nothing but hold the belt
    plane down, and with it the motor plate, the motor, its board and the base's bottom face. The ring now stands
    straight on the web (lib/pulley/params.py YAW_HUB_CUT = the 90T's web_y0 - ring top = 6.5; PulleyParams.step may be
    None, the hub then running on up to the web - the 90T's build is the same geometry, inspect diff). The web's top
    comes up to 0.5 under the base's bearing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
2026-11-08 cad: the base's bearing boss ends flush with the lower 6806 - the 120T's web 1.5 under it
    With its plain hub gone the 120T's web turned 0.5 under the bearing boss. The base prints foot down, so that boss
    face hangs under the cap as a supported overhang, which can sag or come out rough by a few tenths: too little room
    for a part turning under it. The boss ran 1 mm past the lower 6806, a seat nothing needs (the lip locates the
    bearing): it now ends flush with the bearing's lower face (lib/base/params.py _BOSS_Y0 = the lip's lower face -
    BEARING_6806_WIDTH), so the web turns 1.5 under the boss and the bearing's outer ring alike (the ring's height).
    The base stays 6.5 lower; the 120T is unchange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
2026-11-08 cad: the elbow motor on its 5:1 planetary gearbox (EG17-G5), the 20T on its Ø8 shaft
    Why: the StepperOnline EG17-G5 (5:1 planetary, NEMA 17) was bought for the elbow motor and was the open issue "bought
    but not modelled" - the model had the belt alone. Chosen from a to-scale preview (scratch builds; the gearbox modelled
    from its datasheet drawing and overlaid on it view by view): the gearbox on j1_link's web where the motor's face was,
    the motor + its board 56 mm further out on +N; the web's centre hole stepped (Ø25.5 x 2.5 for the gearbox's boss, Ø19
    under it round the 20T: 4.3 mm of web to each M4 head pocket, where a straight Ø25.5 left 1.05); a stock GT2 20T with
    an 8 mm bore and set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
2026-11-08 cad: the elbow and wrist flange posts short and one design - the gripper's roll axis in the base_yaw plane
    The two Ø40 posts bridged the spacing the SolidWorks coupler left: the roll frame's underside 11.0 over j1_link's flat
    top, wrist_link's coupler face 14.5 off j2_link's wrist boss, and the gripper's roll axis 9 mm to the side of the
    base_yaw axis at home. The user wanted both posts very short and the same, the end effector lined up with the base
    rotation. Shrinking both gaps by the same amount moves the gripper by the same amount, so equal gaps alone leave it
    4 mm off the base axis. Previewed as scratch builds (claude.ai artifact: matched renders at one scale, overlays, cuts
    through bo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
2026-11-08 cad: the base_yaw home sensor - a KY-003 under the 120T on a bracket under the motor plate, a 6 x 3 magnet in the 120T
    base_yaw had no way to find a known angle: no hard stop, and the MKS SERVO42D's encoder is absolute over one motor turn
    only (60 deg of the joint through the 6:1 belt). The home sensors are designed one joint at a time (docs/open_issues.md):
    this is base_yaw's, the first placed. The site was chosen from three (under the 120T on the motor plate, under it from
    the -X wall, outside under j1_coupler's rim) and the home angle near one end of the travel, not at zero. Two bracket
    heights were previewed (renders at one scale, an overlay, the switch's zone against the travel's ends)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
2026-11-08 cad: the base_yaw home magnet glued onto the 120T, the bracket's pad gone, its M3s into nuts in the plate's top
    The user would rather glue the home magnet on than cut a pocket for it, and wants the bracket's M3s on nuts, not heat-set
    inserts. Glued on as the sensor stood, the Ø6 x 3 stands 3 mm proud of the 120T's face and runs into the KY-003's chip
    (0.25 mm^3 at -170.5 deg, inside the travel); the clash was rendered with three ways out (keep the pocket; glue it on and
    drop the bracket's pad; glue a Ø3 x 2 on, home to -174.4, 0.98 over the chip), and the nut's three seats. The choice,
    previewed before this commit: the Ø6 x 3 glued on, the pad gone - the board 3 mm lower, so every gap sta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
2026-11-08 cad: the fit gauges - test prints of every fit where a bought part meets a printed one
    The docs asked for a fit gauge before the first parts (docs/cycloidal_drive.md §6 and eight open_issues rows: the
    6806 / 6814 / thrust seats, the journals, the nut pockets, the magnet pockets) and none existed. Every fit is tuned for
    PETG on paper; the printer decides whether a seat ends a press, a slide or too tight.
    lib/gauges/ (new): fits.py GAUGES - 31 gauges (198 sizes), one per kind of fit, every size read from the constant the part's builder
    uses (a changed fit moves its gauge; a new fit adds its Use there): the Ø90 / Ø42 / Ø35 / Ø16 seats, the Ø70 / Ø64.8 /
    Ø30 / Ø17 journals, the Ø4 /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
2026-11-08 cad: the printed parts in filaments that can be bought - white structure, orange accent
    The two printed colours were picked by eye (an off-white BODY, an orange ACCENT hand-corrected from a filament hex
    #E2581C no shop here sells). They now come from the filaments the arm can actually be printed in: lib/style.py
    FILAMENTS, 12 entries, each its swatch's hex in the shop's colour picker (screen colours sampled off the swatches, not
    a measured filament; no brand named).
    - lib/style.py: FILAMENTS (new); viewer_hex() (new) - the hex the viewer and `./cadtool snapshot` draw as a filament:
    they draw a STEP colour darker (the swatch's #FD7C18 stored as is draws as ~#FA3302, a red-orange - tried an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
2026-11-09 cad: the gauge plate's 3MF write keeps the process's locale - the full suite failed after it
    build123d's Mesher.write() (lib3mf) leaves the process in the C locale. Since the fit gauges came in (cad/fit-gauges),
    tests/test_gauges.py test_a_plate_3mf writes a plate in-process, and every later read without an encoding in the same
    pytest process went ASCII: tests/test_tooling.py test_no_cadgen_environment_name_is_left failed on the first
    non-ASCII byte of assemblies/_occurrences.py (an em dash) - 1 failed, 1309 passed in a full `./cadtool pytest` on
    main + this branch. Each test passes alone, and CI's lanes split the two, so only a whole local run showed it.
    - tools/export_gauges.py write_plat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
2026-11-09 cad: the new PETG brand's colours - ivory structure, orange accent
    The arm will be printed in another brand of PETG: FILAMENTS becomes its 20 colours (each its swatch's hex in the
    shop's colour picker - screen colours; the shop names only its white, the other names are read off the swatches), and
    the printed parts take two of them, picked on the colour page: ivory for the structure, orange for what drives, turns
    or covers. The previous brand's 12 colours are gone.
    - lib/style.py FILAMENTS: the new brand's 20 (white #EFF0F1, ivory #EEE7D4, orange #FF6A14, ...).
    BODY viewer_hex(white #FFFFFF) = #FFFFFF -> viewer_hex(ivory #EEE7D4) = #F7F4EB.
    ACCENT viewer_hex(orange #FD7C18) = #FEB956 ->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
2026-11-09 cad: the elbow flange its own part - through-bolted to the roll frame on M4 x 35, keyed by an octagonal spigot
    The roll frame (forearm_roll_block) prints front face down so its two 6806 seats come out as vertical circles; that
    laid the elbow flange on its underside - the Ø40 post, the Ø33 shoulder on the upper elbow 6806's inner ring and the
    Ø30 stub in it - on its side: its round faces, the stub's fit among them, printed as stair steps on support. The flange
    is now its own printed part, elbow_flange, printed on its stub's end: every round face of both parts prints as a
    circle. Chosen by the user from two previews (B, through-bolted, over a bolt-on flange on 4 more M3 screws + nuts);
    the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
2026-11-09 cad: the wrist flange its own part - wrist_link keeps nothing round about the pitch axis, M4 x 33 into nuts in its plate
    Each printed part prints its circles well about one axis only (the user's rule). wrist_link prints with its bearing
    seats upright, so its wrist_pitch output flange - the Ø40 post, the Ø33 shoulder on the upper wrist 6806's inner ring
    and the Ø30 stub in it - printed on its side. The flange is now its own printed part, wrist_flange, printed on its
    stub's end. Chosen by the user from two previews (A2, the whole flange, over C - an octagon pad on wrist_link with the
    shoulder and stub separate on stock M4 x 30 and thin nuts, 0.7 past them); round 1's B (the stub alone) was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
2026-11-09 tests: the document-type test loads cadtool's doc_type with eval, so it passes on macOS's bash 3.2
    test_cadtool_names_cads_document_type (added with the cad 0.11.0 bump) loaded the function with
    `bash -c 'source <(sed ...)'`. bash 3.2, the Mac's /bin/bash, sources nothing from a process
    substitution, so `doc_type` was never defined and all 11 cases failed there (exit 127,
    "doc_type: command not found"); they passed on the Fedora PC and in CI, whose bash is 5.
    cadtool's doc_type itself was right on bash 3.2. The test now reads the function into a variable
    and evals it, which works on both.
    Checks, on the Mac: tests/test_tooling.py 35 passed (was 24 passed, 11 failed); the fast lane
    817 passe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
2026-11-09 tooling: cad 0.11.0 -> 0.11.4, imported as cad
    Upstream released 0.11.1 to 0.11.4 on 2026-11-08 and -09 (earthtojake/text-to-cad#799, #800, #791, #810): patch
    releases. The kernel is unchanged (build123d 0.13.0, cadquery-ocp-novtk 8.0.1.1.0), so uv.lock moves cad alone (its
    build123d extra now also names scipy, already locked through build123d) and no model moves.
    - 0.11.1: `import cadgen` warns CadDeprecationWarning once per process - an error under pytest, a line in every
    build a worker runs. Every import moves to `cad` (130 imports in 131 files: `from cad import step`,
    `cad.build123d`, `cad.engine.model`), and the docs, docstrings and comments that name the li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
2026-11-10 cad: the shoulder_pitch home sensor - a KY-003 on a drop-in tray in j1_coupler's pocket, a 6 x 3 magnet glued on a drive shell pillar
    The shoulder had no home sensor (docs/open_issues.md, the home sensors: each joint's designed on its own). The user
    picked this one from six rounds of rendered designs (sensor in or on the motor leg, a magnet pocketed in the shell
    ring; then the user's own idea: the magnet glued on one of the shell's pillars, the sensor on the coupler; then in
    the pocket over the hub; then, of four ways to hold it there, F3, the drop-in tray).
    What it is (lib/yaw_coupler/params.py HomeTrayParams, DEFAULT.home; LEGACY none):
    - A Ø6 x 3 N52 disc glued, south pole out, onto the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
2026-11-11 cad: lib/style.py FILAMENTS keyed by SUNLU PETG 2.0's official colour names
    The arm is printed in SUNLU PETG 2.0. FILAMENTS held its 20 colours under names read off the shop's swatches (only
    White was named there) and called the hexes screen colours sampled off them. SUNLU's PETG 2.0 page has a colour code
    table (sunlu.com/products/351): its 20 hexes are exactly FILAMENTS' - checked colour by colour, in the same order - so
    only the names change. Each key is now the official name in snake_case:
    peach -> beige olive -> olive_green ivory -> bone_white teal -> aqua_blue
    brown -> coffee_brown blue -> klein_blue gold -> vivid_yellow sky_blue -> cyan
    s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
2026-11-11 cad: the elbow_pitch home sensor - a KY-003 on a clip over the upper arm's slab end, a 6 x 2 magnet glued on the elbow 90T's outer face
    The elbow had no home sensor (docs/open_issues.md, the home sensors: each joint's designed on its own). The user picked
    this one over three rounds of rendered designs: round 1 placed the sensor in the slab's top under the roll frame or in its
    underside over the 90T, both in pockets. Round 2, asked for "as minimal as possible", kept the whole module (the rule
    stands), homed at the lower end, took a Ø6 x 2 magnet, and set a module hot-glued in an underside pocket against the
    user's own idea, a bracket facing the 90T's outer face. Round 3 showed three such bra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
2026-11-12 tooling: cad 0.11.8 -> 0.11.9; versions rendered at one scale by a job's settled camera, display globs
    Upstream released 0.11.9 on 2026-11-11 (earthtojake/text-to-cad#823): a patch, no migration guide. The kernel is
    unchanged (build123d 0.13.0, cadquery-ocp-novtk 8.0.1.1.0), so uv.lock moves cad alone and no model moves.
    - A snapshot's --json now reports the camera it settled on (`settledCamera`), and a job given that camera with
    `"output": {"tightFrame": false}` is drawn exactly, with no fit. cad/AGENTS.md Gotchas renders versions at one scale
    that way, in place of marker cubes at fixed corners and a crop; a plain `--camera` JSON is still fitted. Measured: a
    6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
2026-11-13 docs: open issues from a printability check of every printed part
    The printability check (parts/AGENTS.md: cad step dfm --process printing; FDM, PETG,
    a 0.4 mm nozzle assumed, a 256 x 256 x 256 bed, 45 deg) ran on the STEP of every printed
    part, as modelled: 21 OK, 15 FAILED, none not checked. Every failure is a wall under the
    check's 0.8 mm (two beads); every part fits the bed (j1_link turned ~41 deg), is one sound
    watertight solid and traps no cavity.
    New rows under Fit problems:
    - the roll rotors' clamp counterbores: 0.25 mm of wall to the bore in forearm_roll_pulley,
    0.5 in wrist_roll_pulley (clamp_circle_dia's comment counts the walls round the shanks);
    - walls under one bead: wrist_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
2026-11-13 tests: the wrist home sensor's clearances catch BRepExtrema's false zeros, its re-measure shared in tests/helpers.py
    On the Mac (arm64, cad 0.11.9) tests/forearm/test_wrist_home.py::test_the_magnet_on_the_90t_over_the_chip_at_home
    failed on main: at wrist_pitch +10 the wrist 90T against wrist_home_clip#1 read 0.000 mm (assert near_turning >= 2.2),
    with no overlap (0.000 mm3) and 2.406 / 2.397 / 2.405 mm with the 90T moved 0.01 mm three ways - the false zero
    tests/AGENTS.md's Gotchas name, met before at the forearm roll (-140 / -145) and the elbow (+92). The sweeps already
    caught it (tests/test_sweeps.py _distance); the wrist home test's _nearest measured with a bare closest_points.
    test_swe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
2026-11-13 cad: printability fixes - five walls under one nozzle bead brought to two beads (0.8 mm)
    The printability check (cad step dfm, FDM PETG, 0.4 mm nozzle) found five printed parts with a
    wall under 0.5 mm where a hole or pocket runs beside another face; the slicer drops or tears
    such a wall. Each fix was chosen from options previewed before / after at one scale (the user
    picked the recommended one for every part):
    - forearm_roll_pulley: the clamp's head counterbores sat 0.25 mm from the Ø18 cable bore, and
    the circle cannot move out (the journal's 1.2 and the neck's 1.0 walls are the tests'
    minimums). The bore now narrows over the counterbores' 3.25 mm depth to leave them
    RollDriveParam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
2026-11-13 cad: counterbore the fork's sleeve screws, fork legs 8 -> 12
    The 3 radial M4s that bolt j1_motor_leg's ring to the cycloidal motor
    plate's sleeve sat with their heads 4.0 proud on the ring's flats. A
    closed counterbore did not fit the 8.0 ring: an M4 counterbore slotted
    for the screws' +/-0.5 slide along the axis is 8.0 long. Both fork legs
    (ShellParams.yoke_leg, shared) go to 12.0, growing outboard (still 1.0
    off the turning shell), so each screw gets a round counterbore with
    2.0 of ring either side - room for the outline's 1.5 chamfer and 0.5 of
    flat beside it.
    - Sleeve screws: M4 x 20 -> M4 x 16 (ISO 4762), heads flush in round
    8.0 x 4.0 counterbores (ForkParams.sleeve_counterbore_dia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
2026-11-14 tooling: cad 0.11.9 -> 0.11.10
    Upstream released 0.11.10 on 2026-11-13 (earthtojake/text-to-cad#832, with #825 and #819): a patch, no migration
    guide. The kernel is unchanged (build123d 0.13.0, cadquery-ocp-novtk 8.0.1.1.0), so uv.lock moves cad alone and no
    model moves.
    - The server now counts each model build it answers for telemetry, where the caller's environment allows as well as
    the stored choice; a build carries the caller's whole environment, so cadtool's CAD_TELEMETRY=0 and the stored off
    both keep it off. docs/toolchain.md Pins says so in place of "the environment does not reach it".
    - Not used here: an export with --tolerance / --angle that names a STE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
